foxostro/TurtleTTL/Schematics/Misc/Generated/Renders/ExternalClock_Render.png

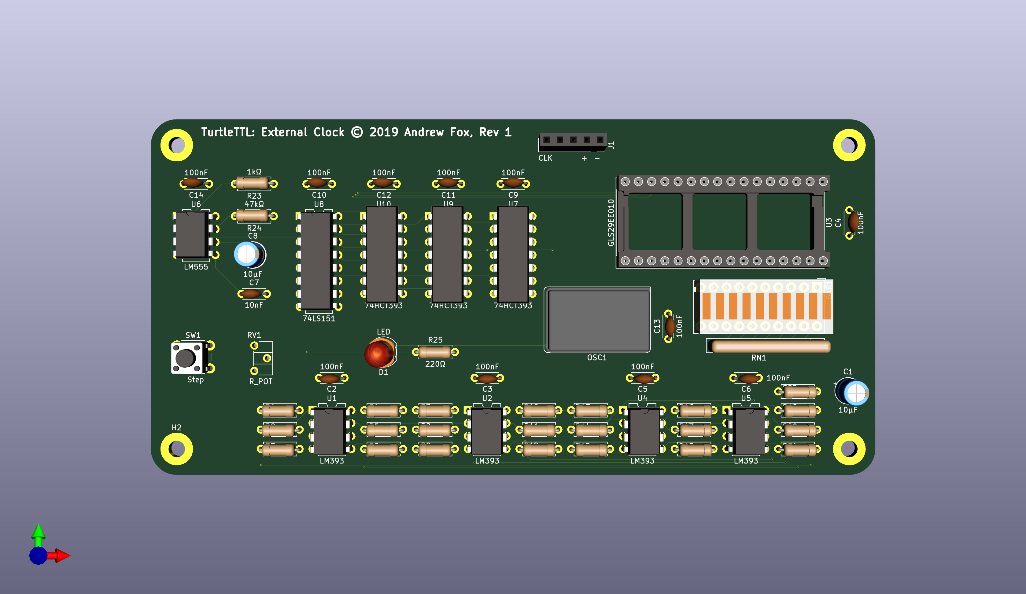
Schematics/Misc/Generated/Renders/ExternalClock_Render.png
