foxostro/TurtleTTL/Schematics/Version2/Generated/Renders/SoundCard_Render.png

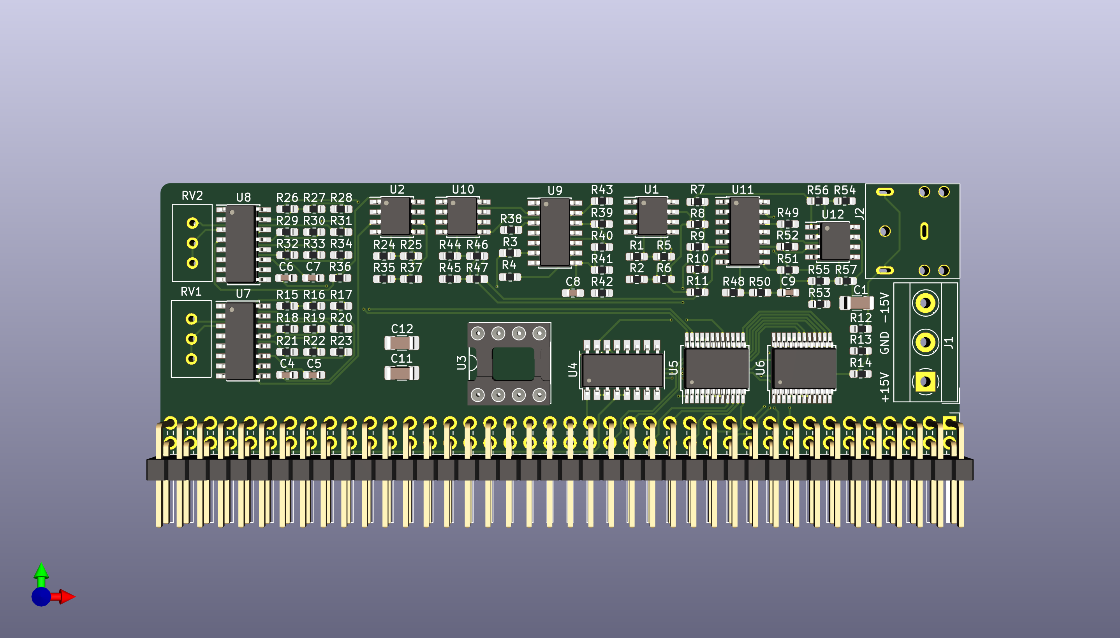
Schematics/Version2/Generated/Renders/SoundCard_Render.png
