foxostro/TurtleTTL/Schematics/Misc/Generated/Renders/LEDRiser8_Render.png

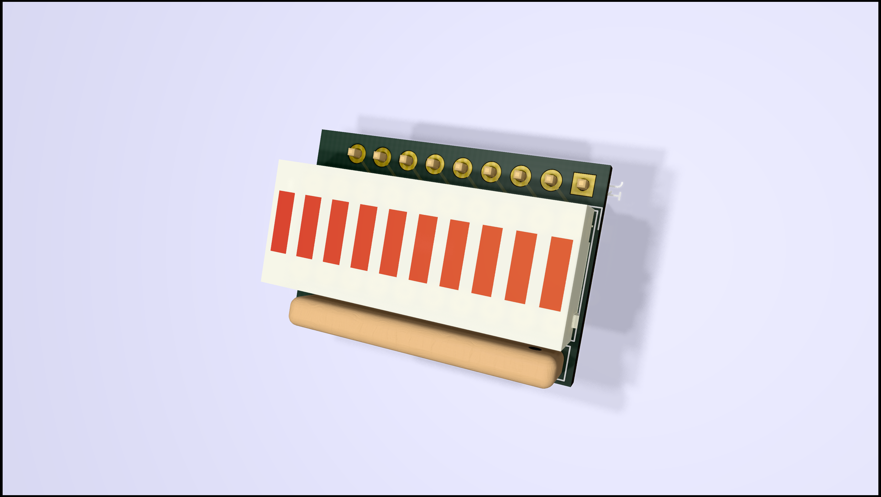
Schematics/Misc/Generated/Renders/LEDRiser8_Render.png
