foxostro/TurtleTTL/Schematics/Misc/Generated/Renders/LEDRiser16_Render.png

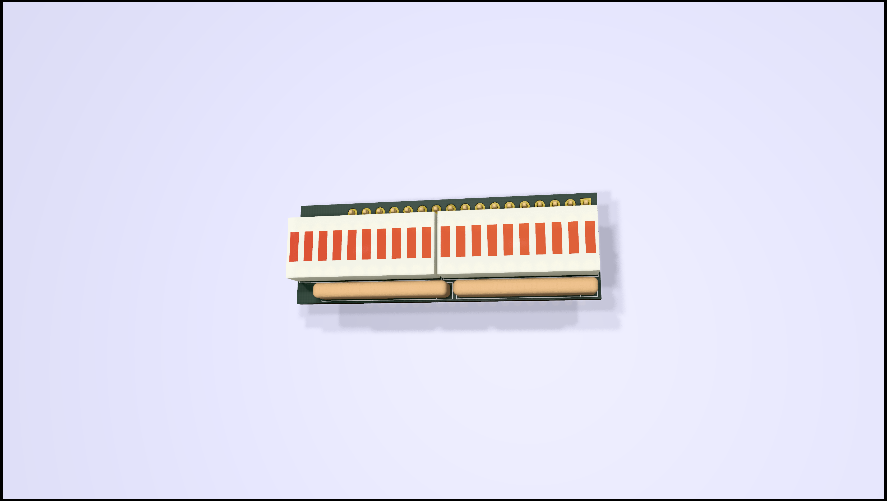
Schematics/Misc/Generated/Renders/LEDRiser16_Render.png
