foxostro/TurtleTTL/Schematics/Misc/KiCAD Design Rules/KiCAD Main Board PCB Design Rules 1.png

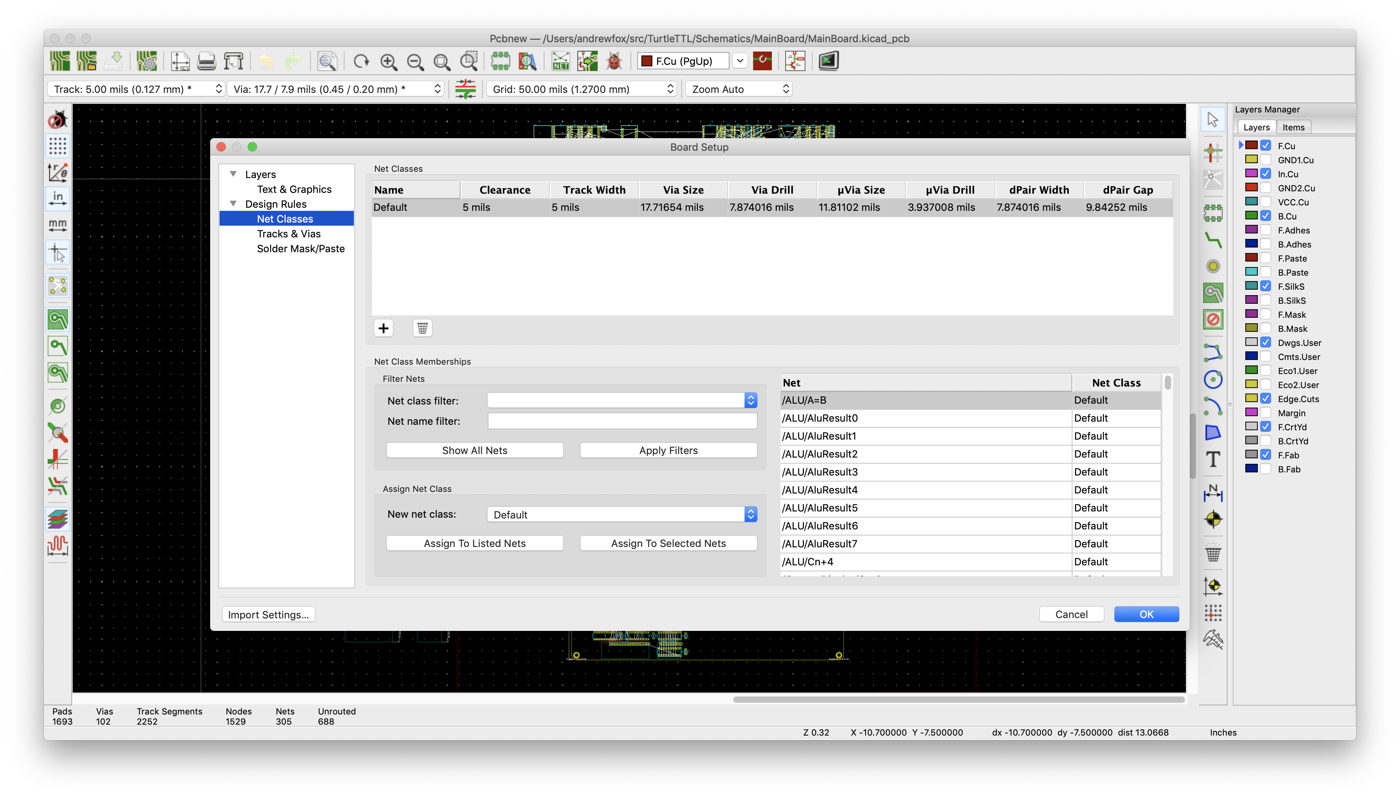
Schematics/Misc/KiCAD Design Rules/KiCAD Main Board PCB Design Rules 1.png
