foxostro/TurtleTTL/Schematics/Version2/Generated/Renders/MainBoard_Render.png

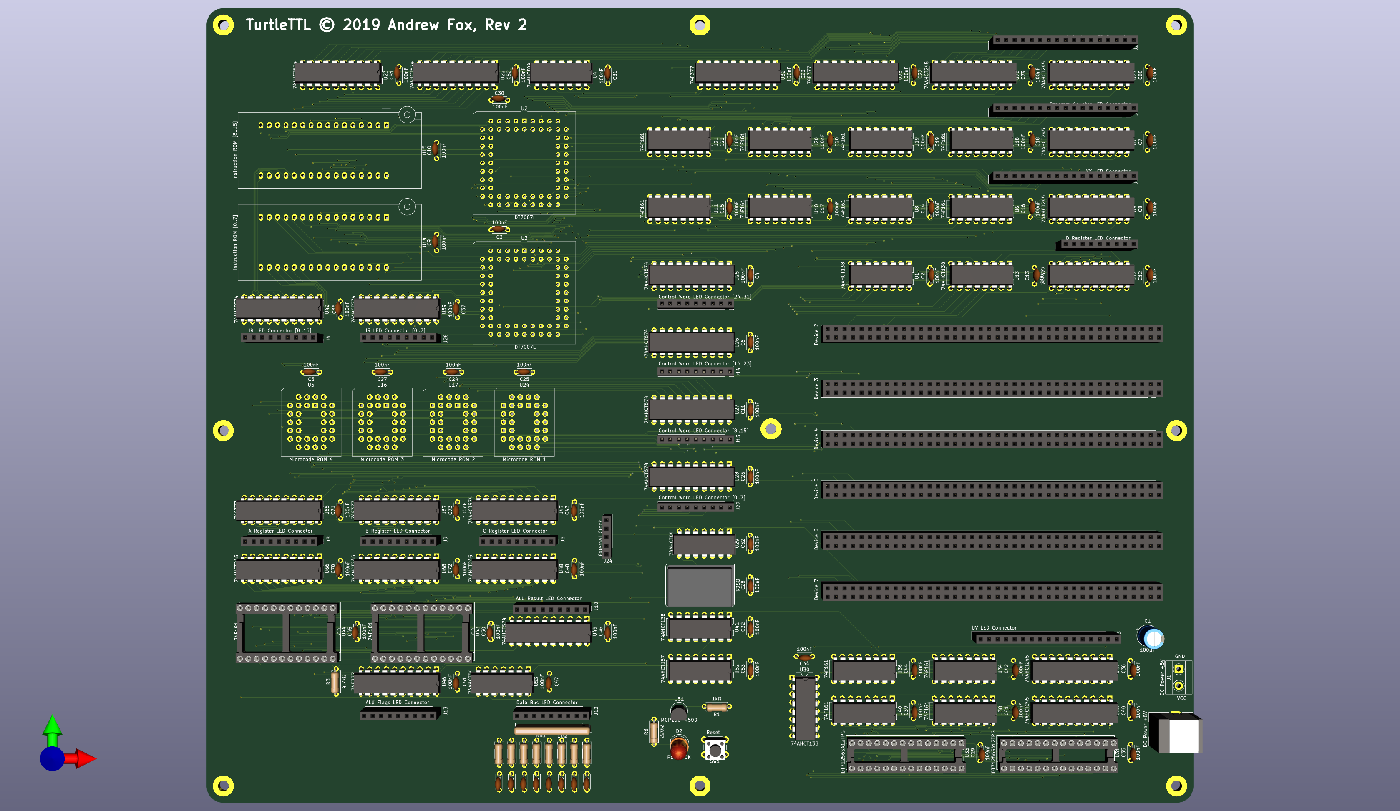
Schematics/Version2/Generated/Renders/MainBoard_Render.png
