foxostro/TurtleTTL/Schematics/Version2/Generated/Renders/SerialCard_Render.png

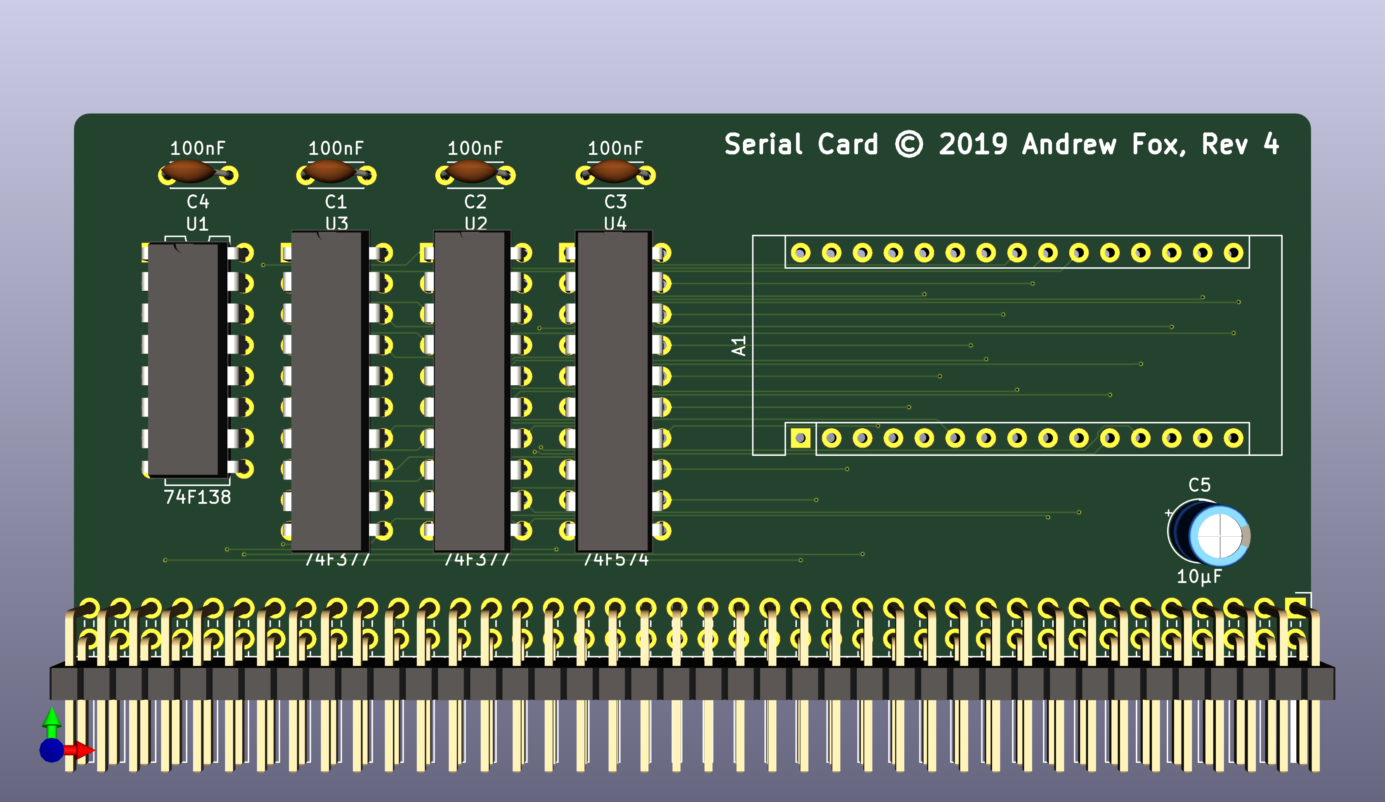
Schematics/Version2/Generated/Renders/SerialCard_Render.png
