foxostro/TurtleTTL/Schematics/Version2/Generated/BOM/ArduinoSerialCard.csv

Reference | Value | Footprint | Datasheet
A1 | Arduino_Nano_v3.x | Module:Arduino_Nano | http://www.mouser.com/pdfdocs/Gravitech_Arduino_Nano3_0.pdf
J1 | Device 2 | Connector_PinHeader_2.54mm:PinHeader_2x20_P2.54mm_Horizontal | ~
