foxostro/TurtleTTL/Schematics/Version2/Generated/PCB PDFs/SoundCard_PCB.pdf

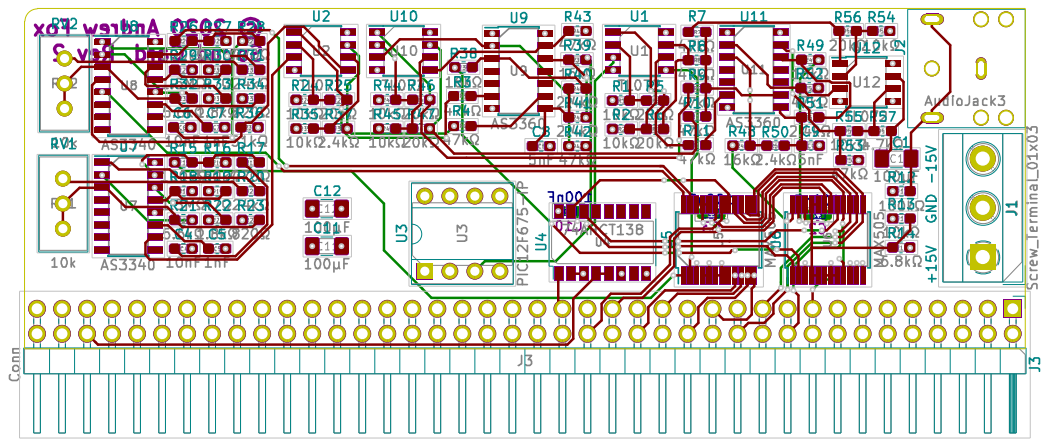
[picture p9: page 1]
