foxostro/TurtleTTL/Schematics/Version2/Generated/PCB PDFs/MainBoard_PCB.pdf

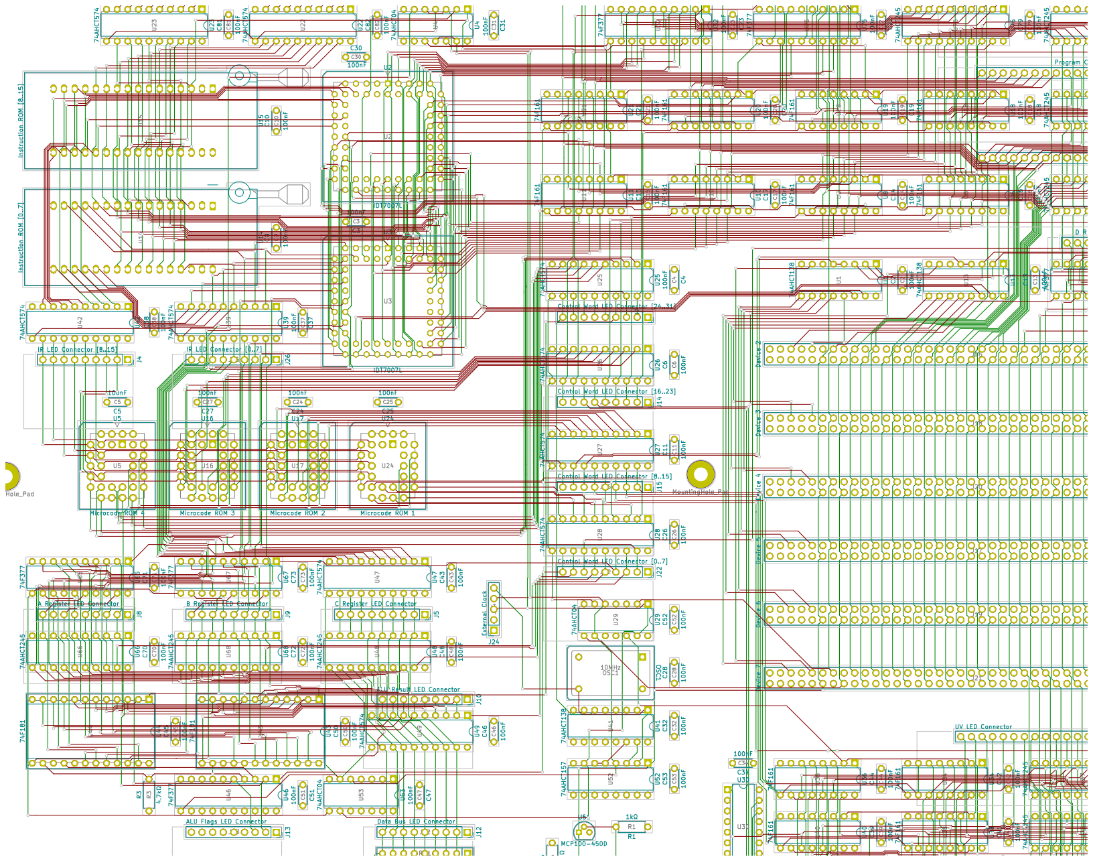
[picture p17: page 1]
