foxostro/TurtleTTL/Schematics/Version2/Generated/PCB PDFs/SerialCard_PCB.pdf

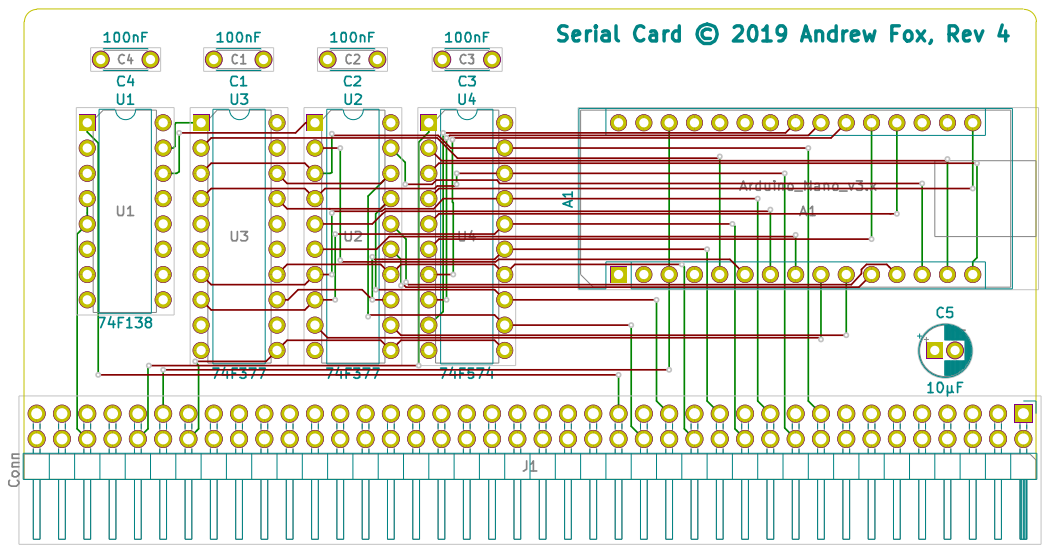
[picture p18: page 1]
