foxostro/TurtleTTL/Schematics/Version2/Generated/Schematic PDFs/MainBoard_Schematics.pdf

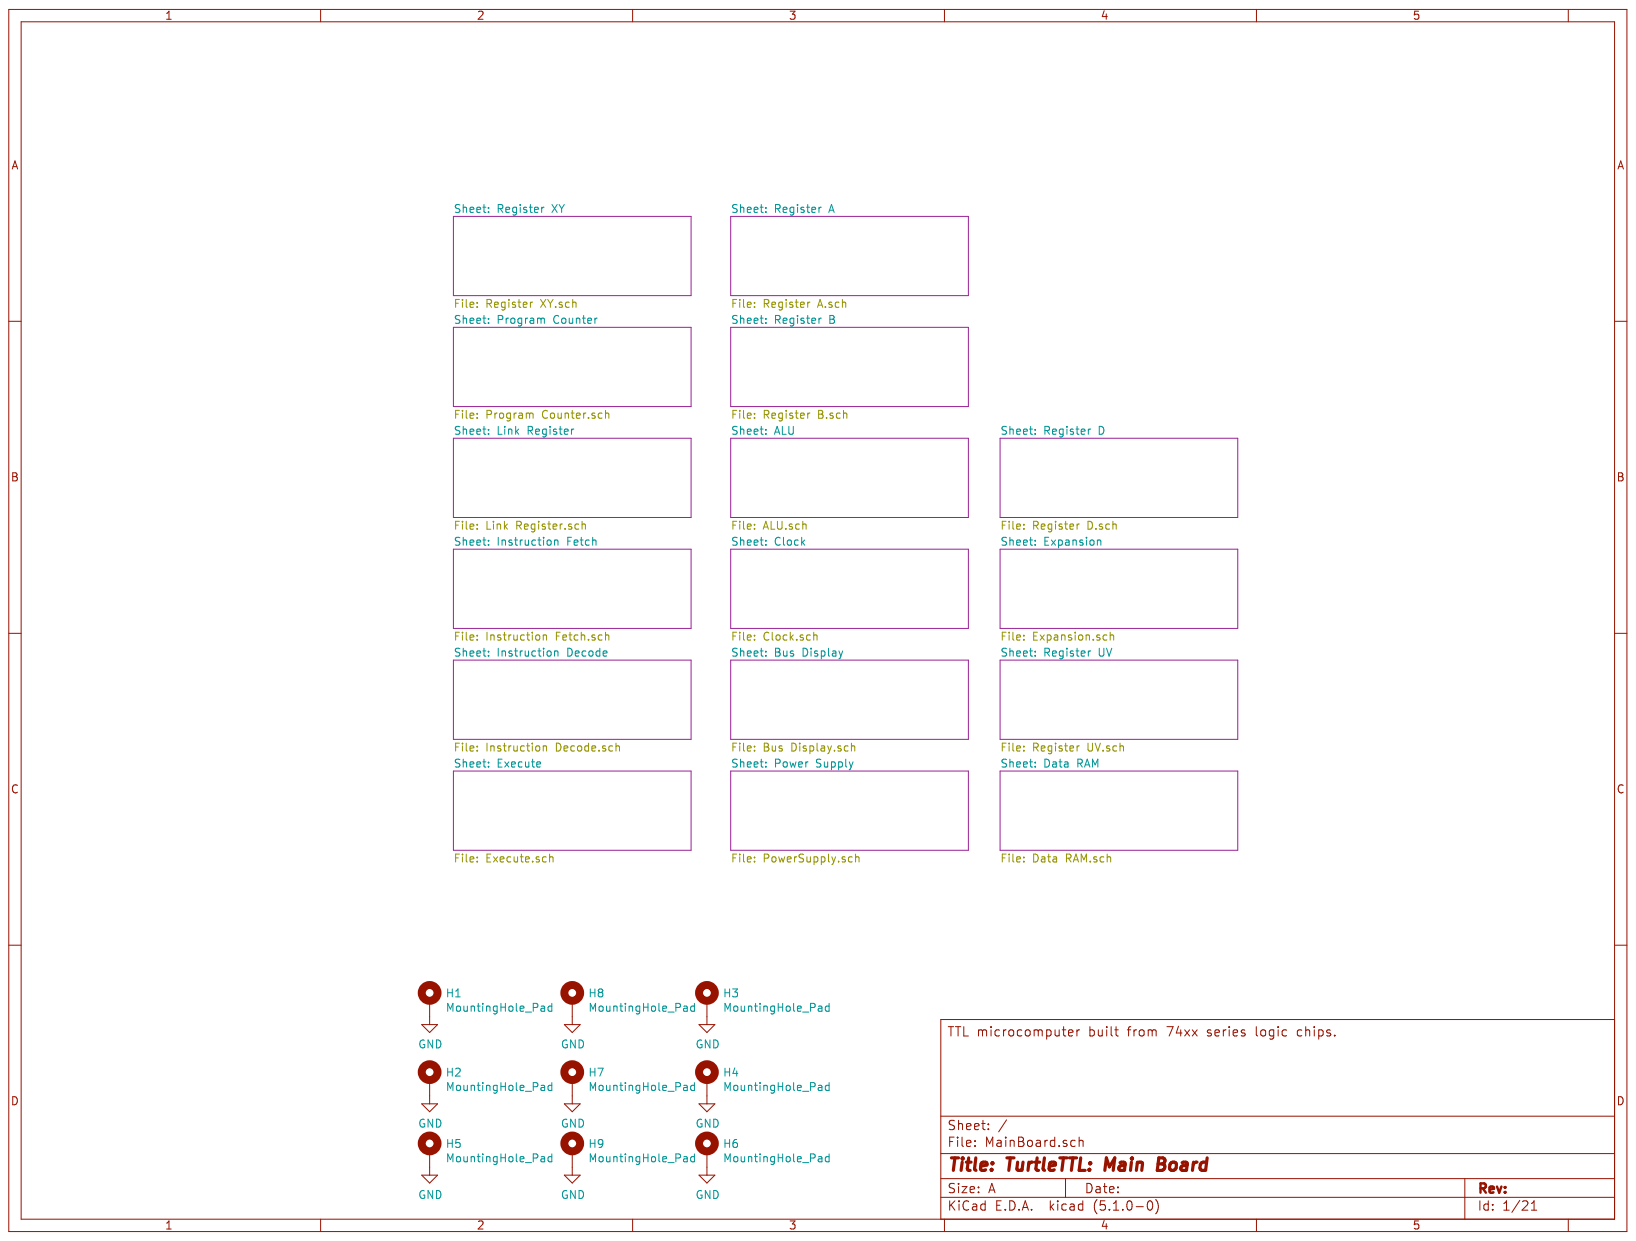
[picture p19: page 1]

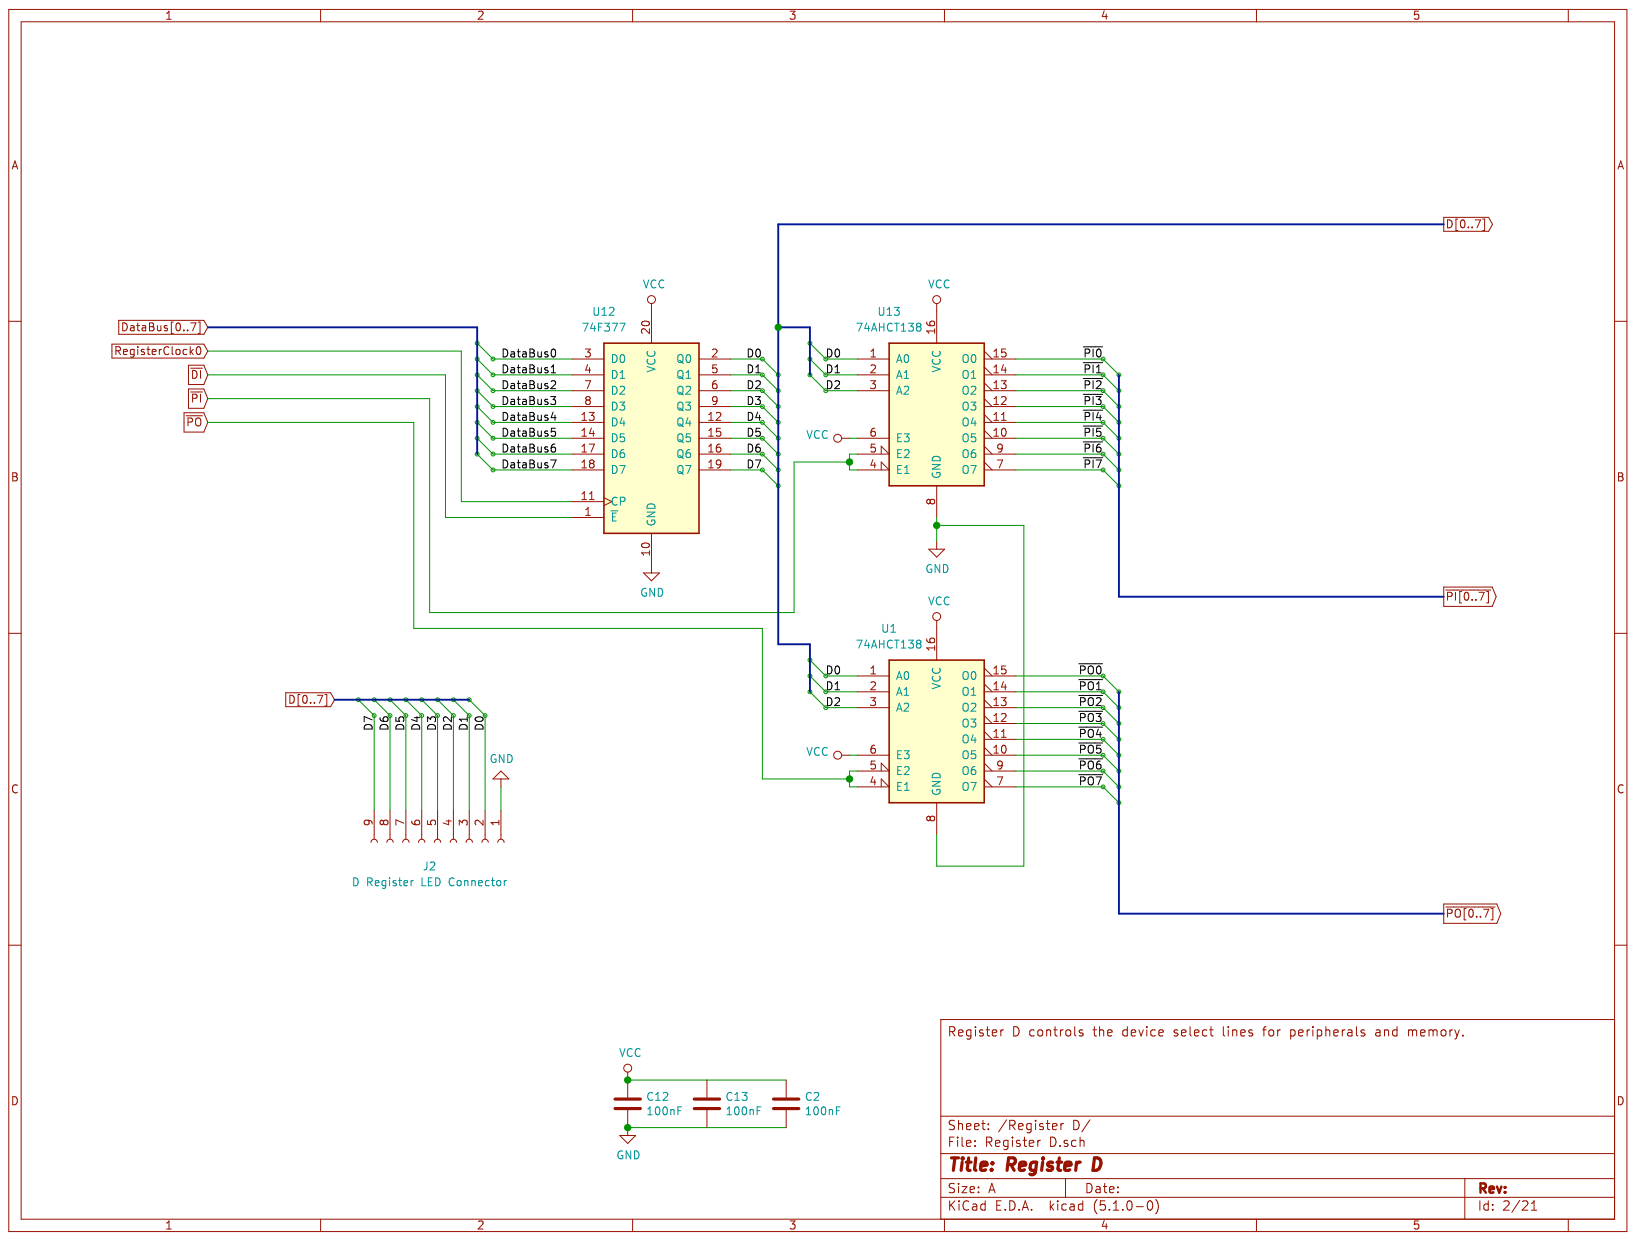
[picture p20: page 2]

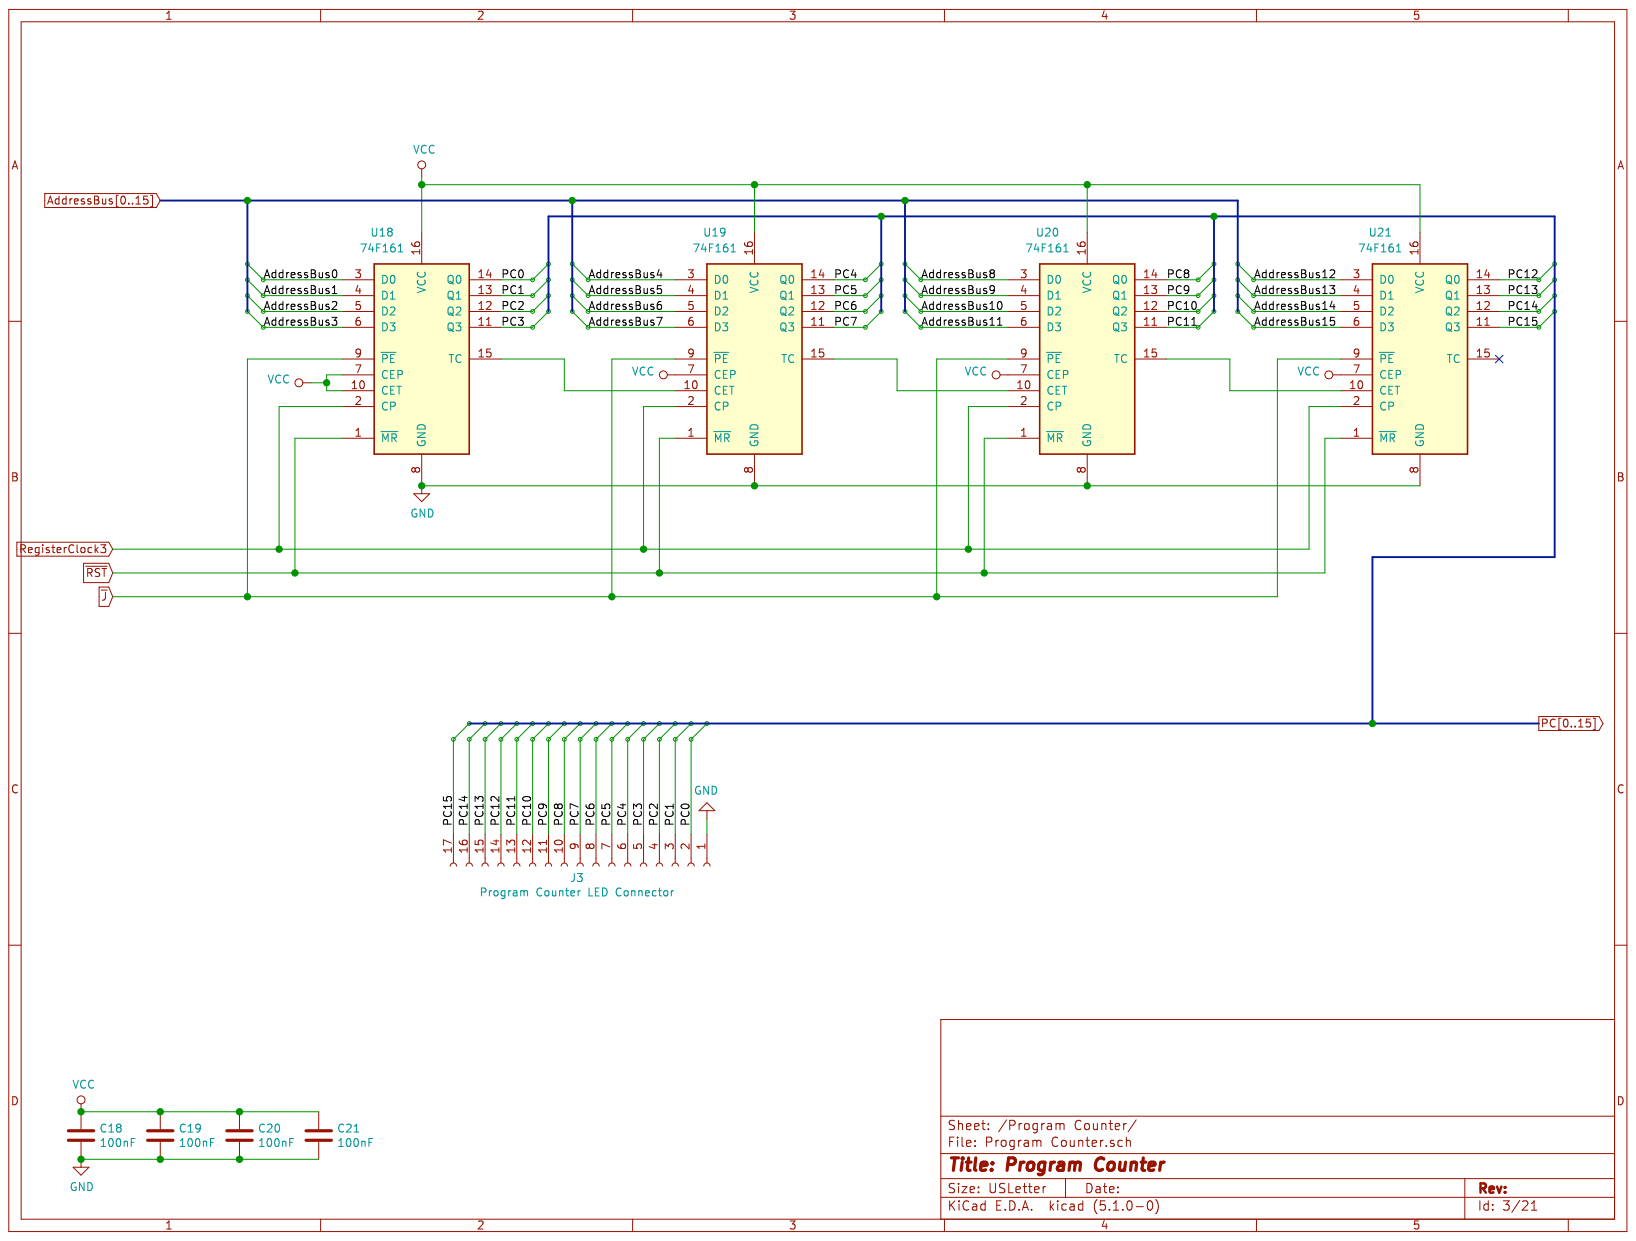
[picture p21: page 3]

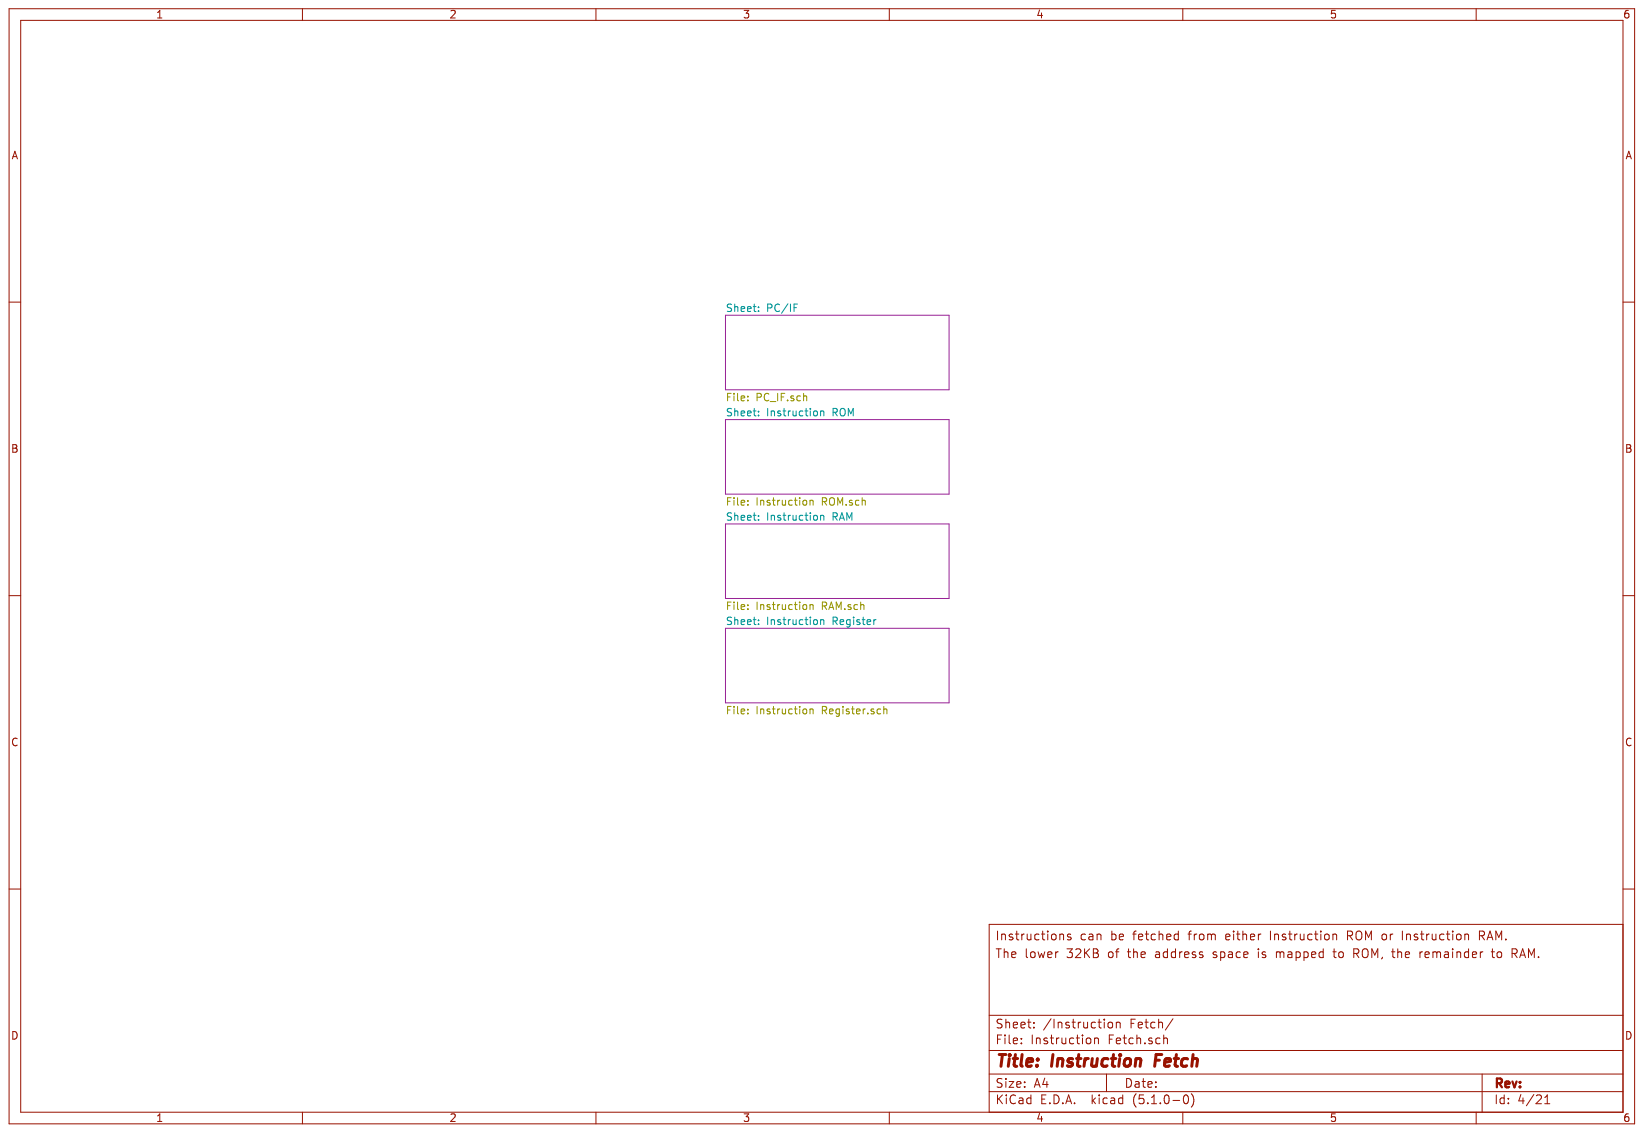
[picture p22: page 4]

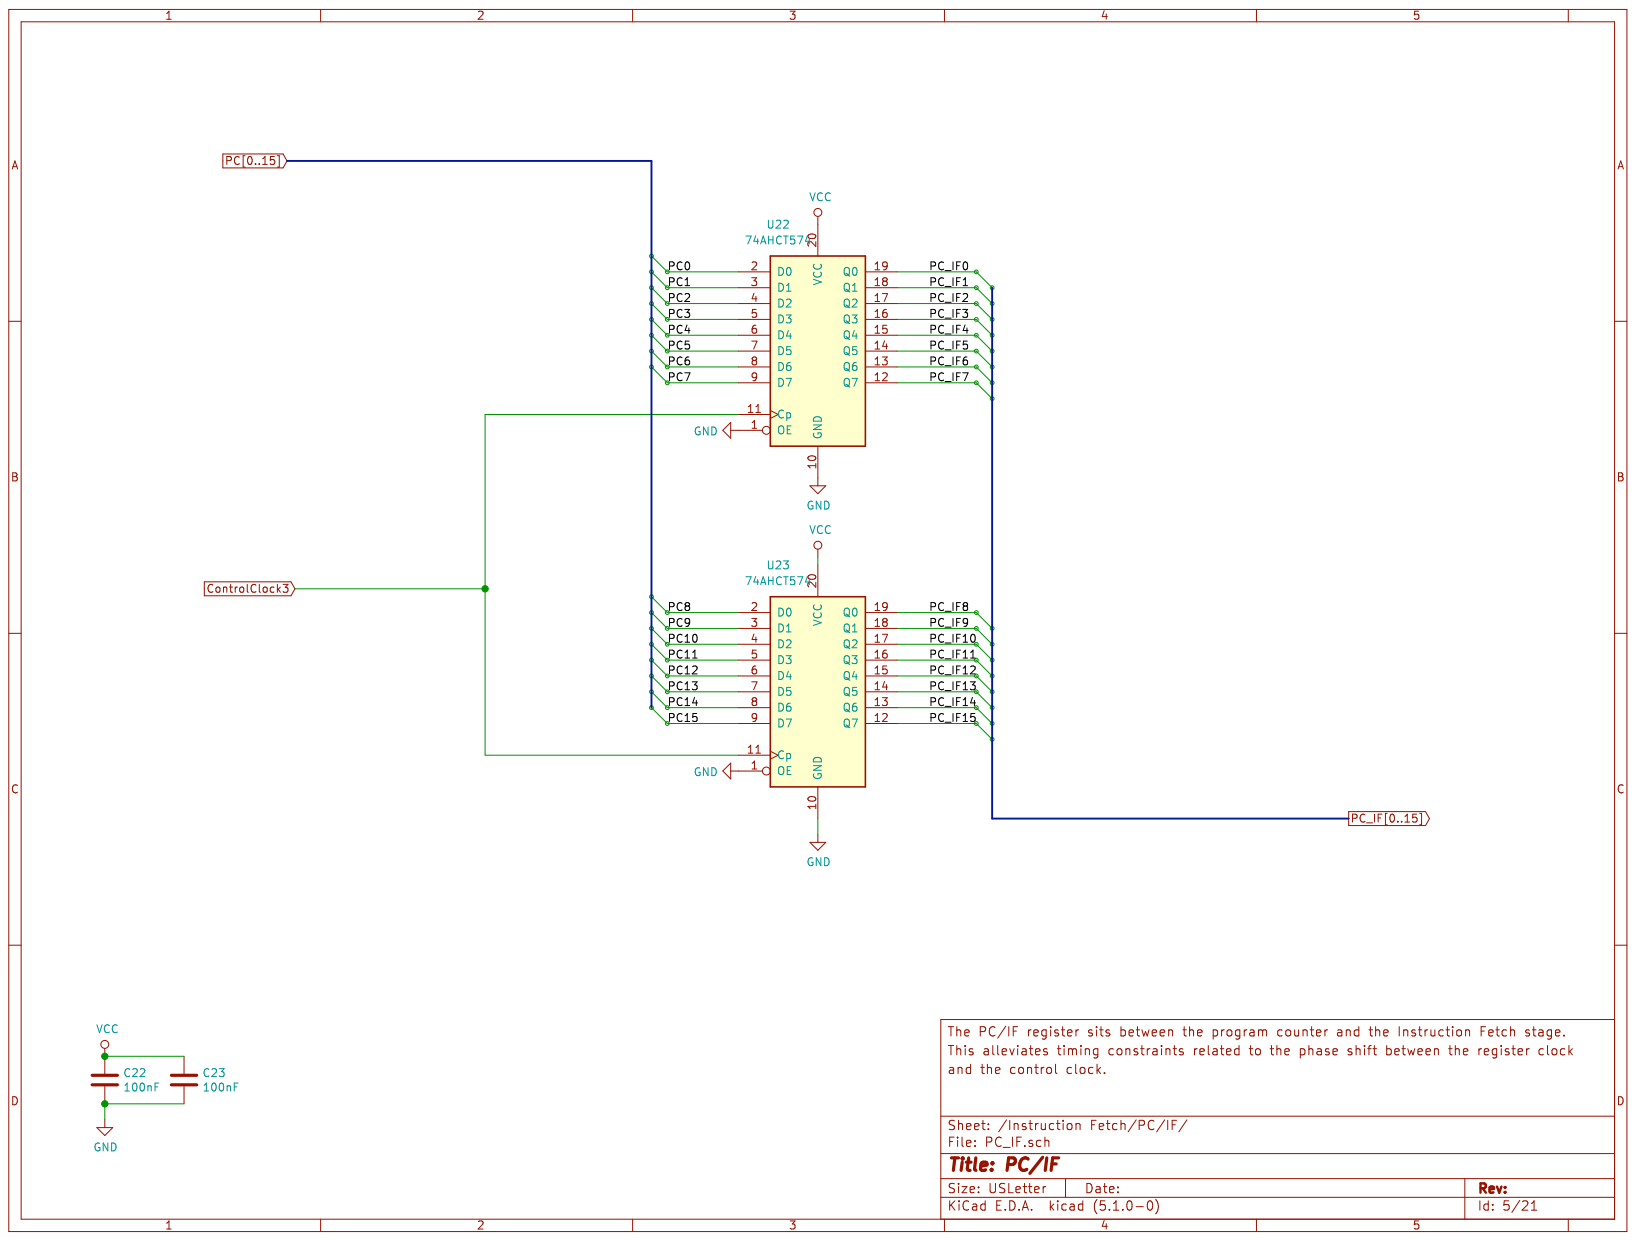
[picture p23: page 5]

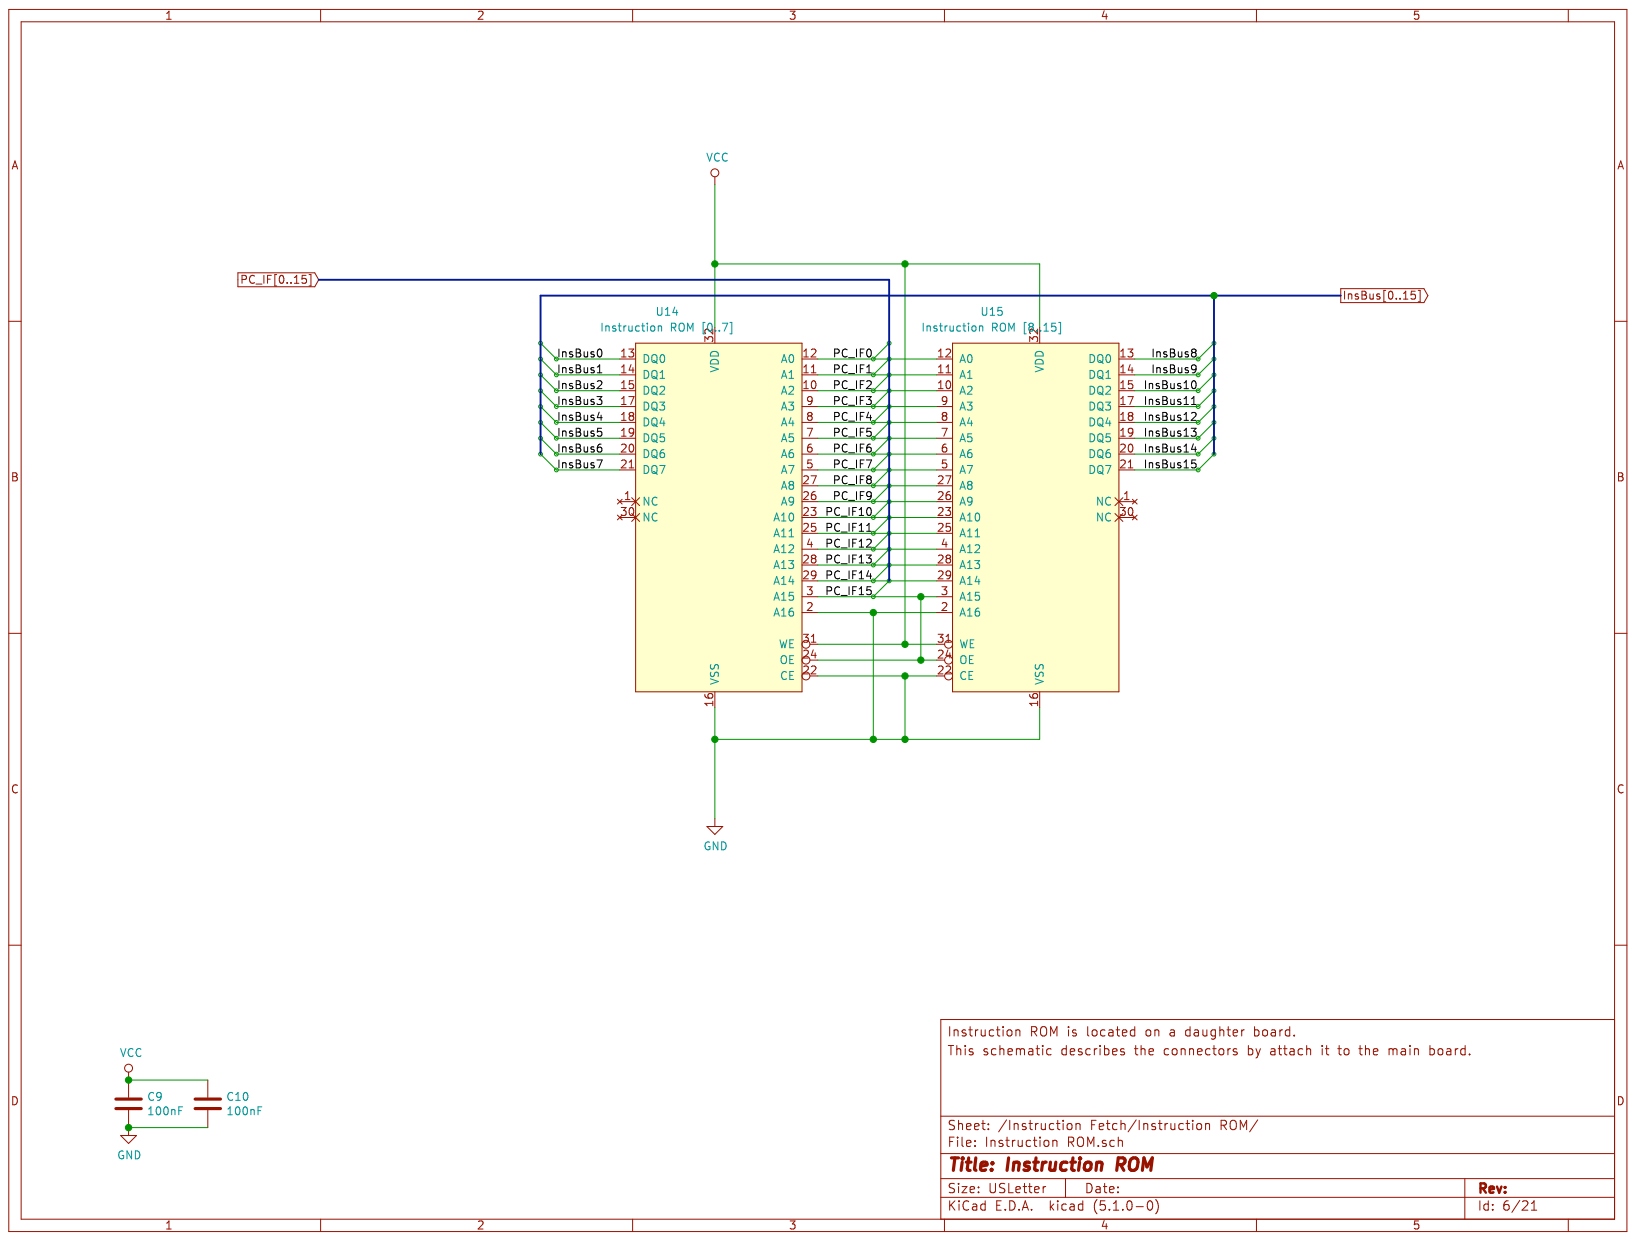
[picture p24: page 6]

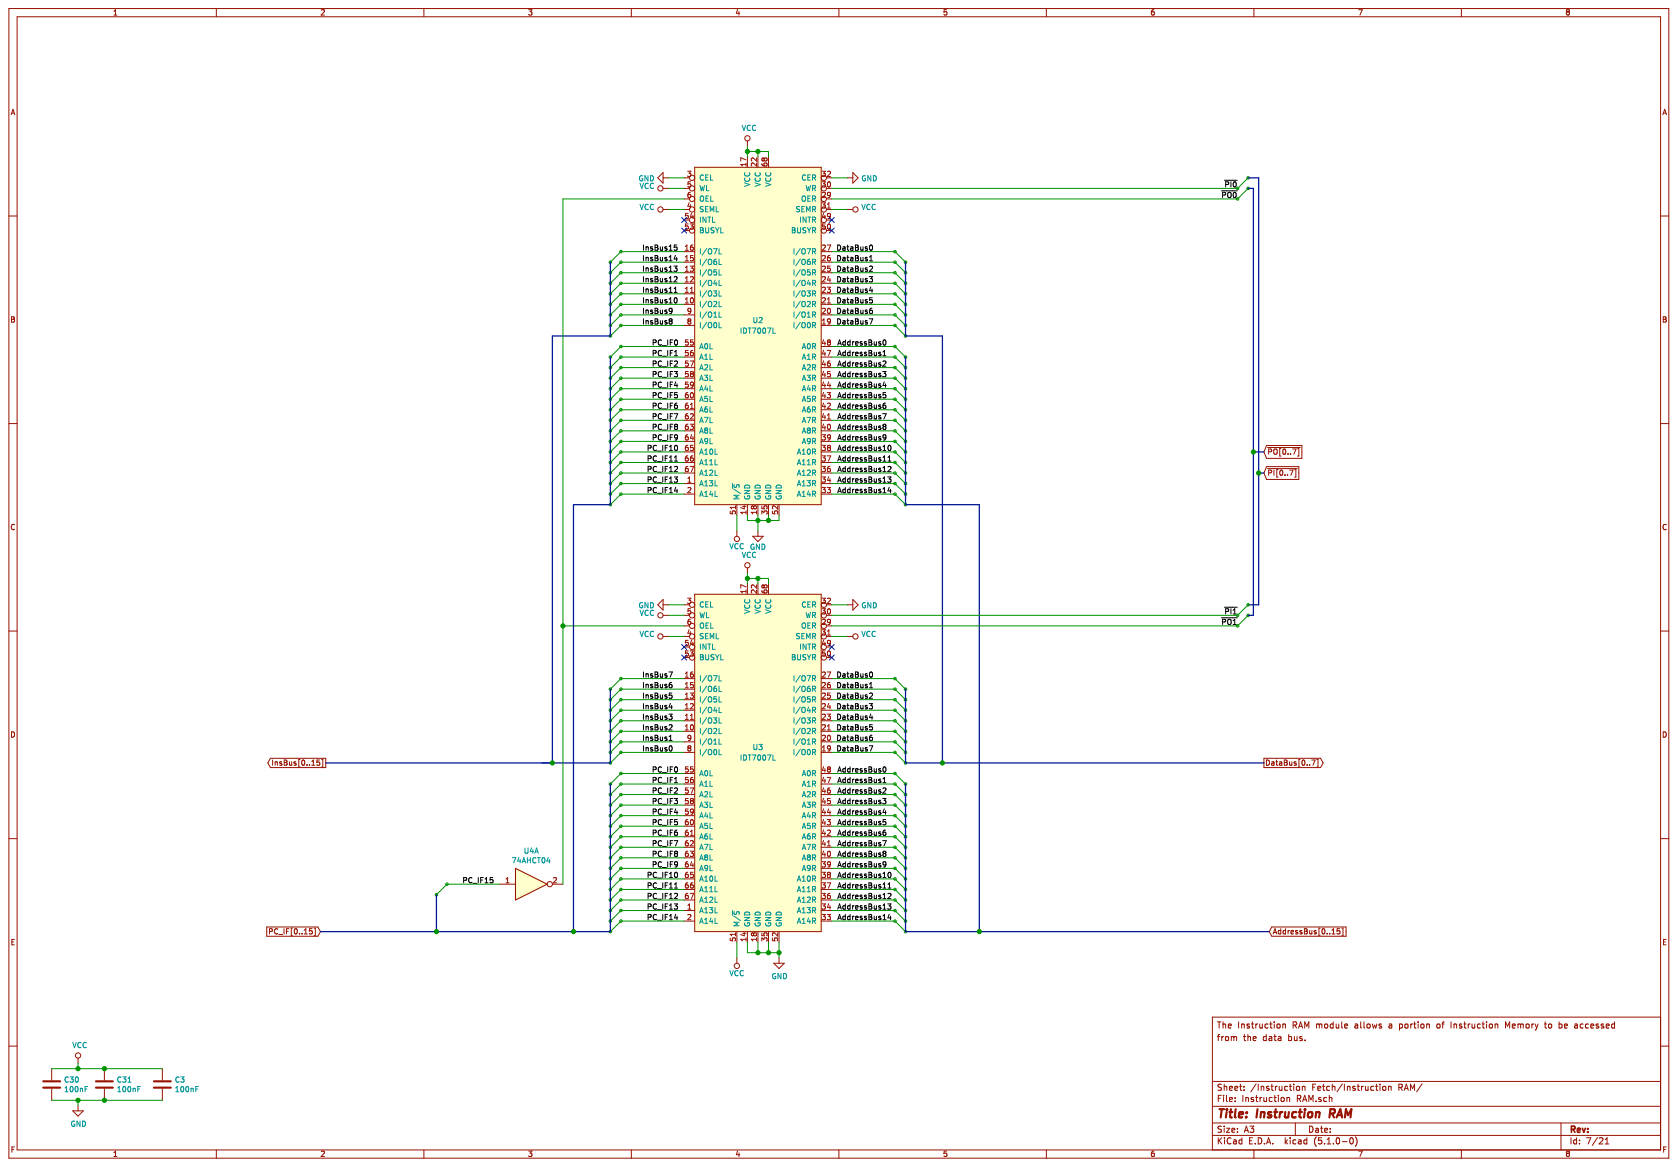
[picture p25: page 7]

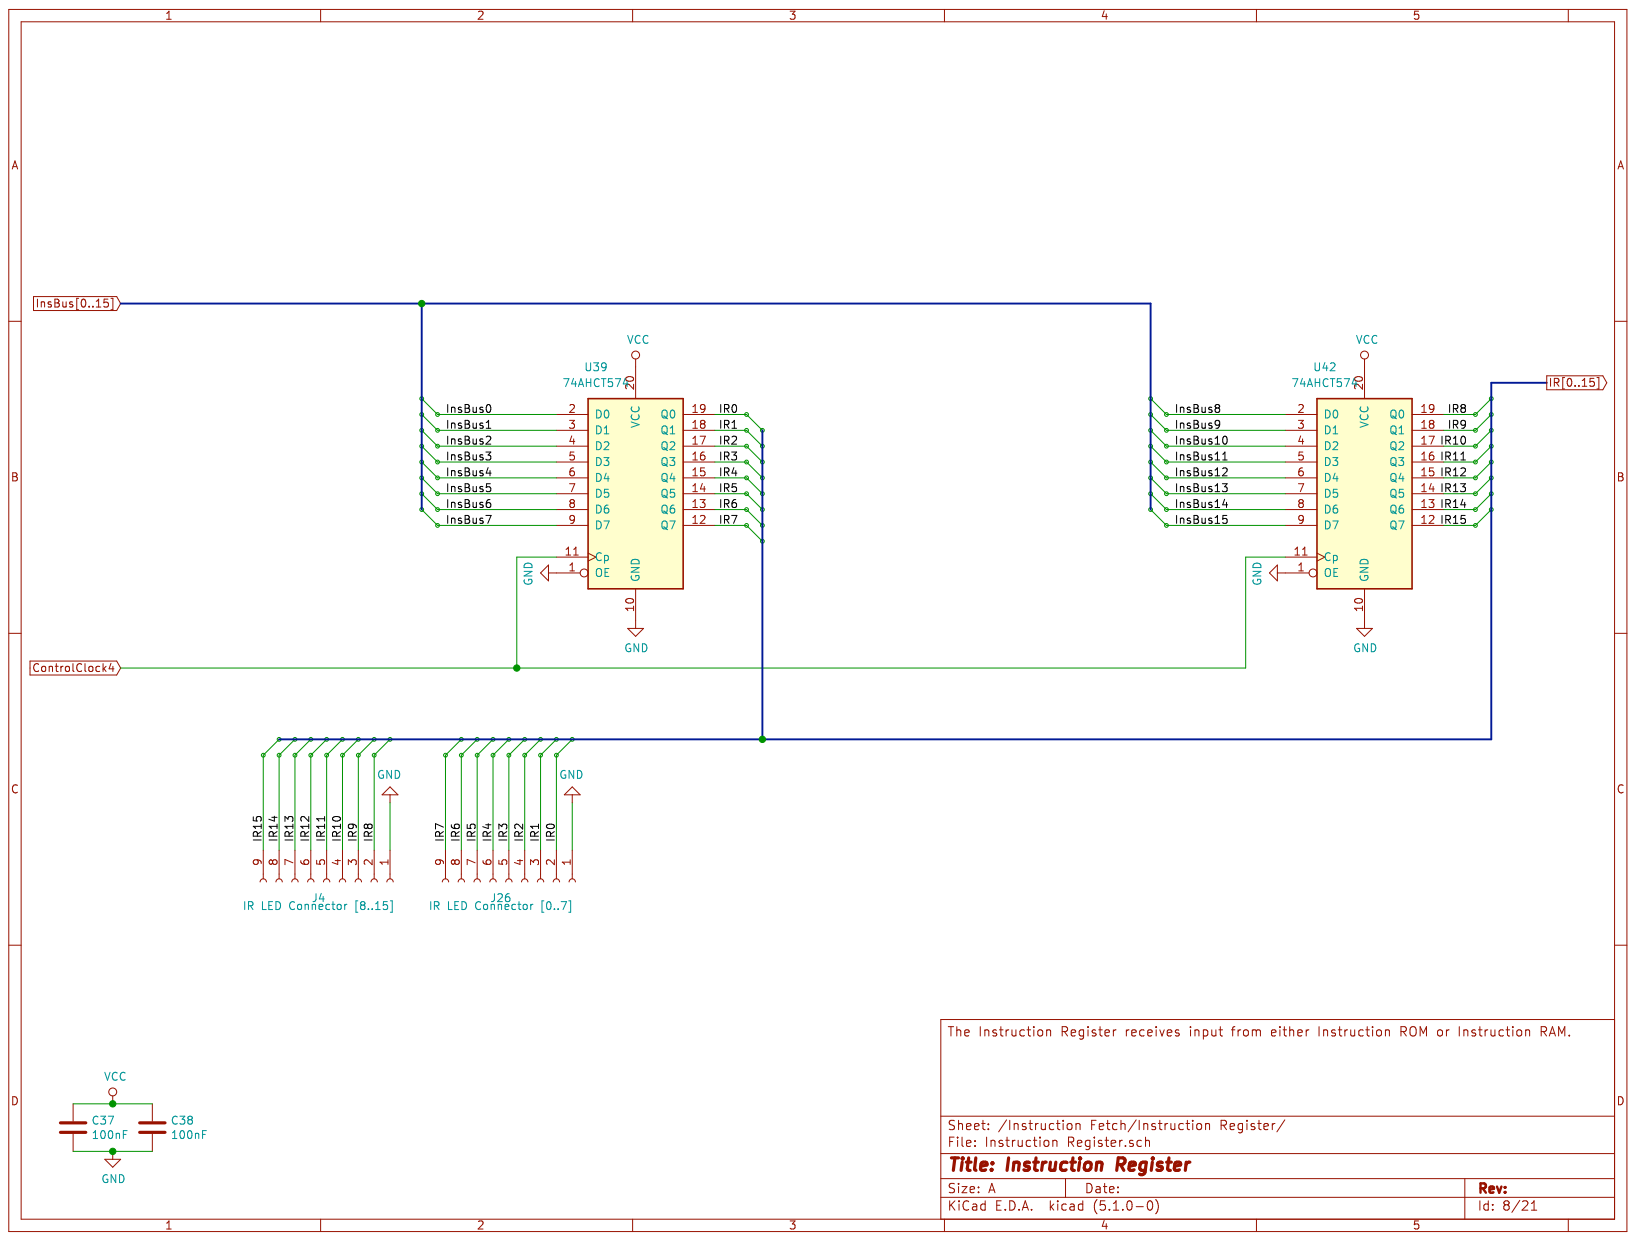
[picture p26: page 8]

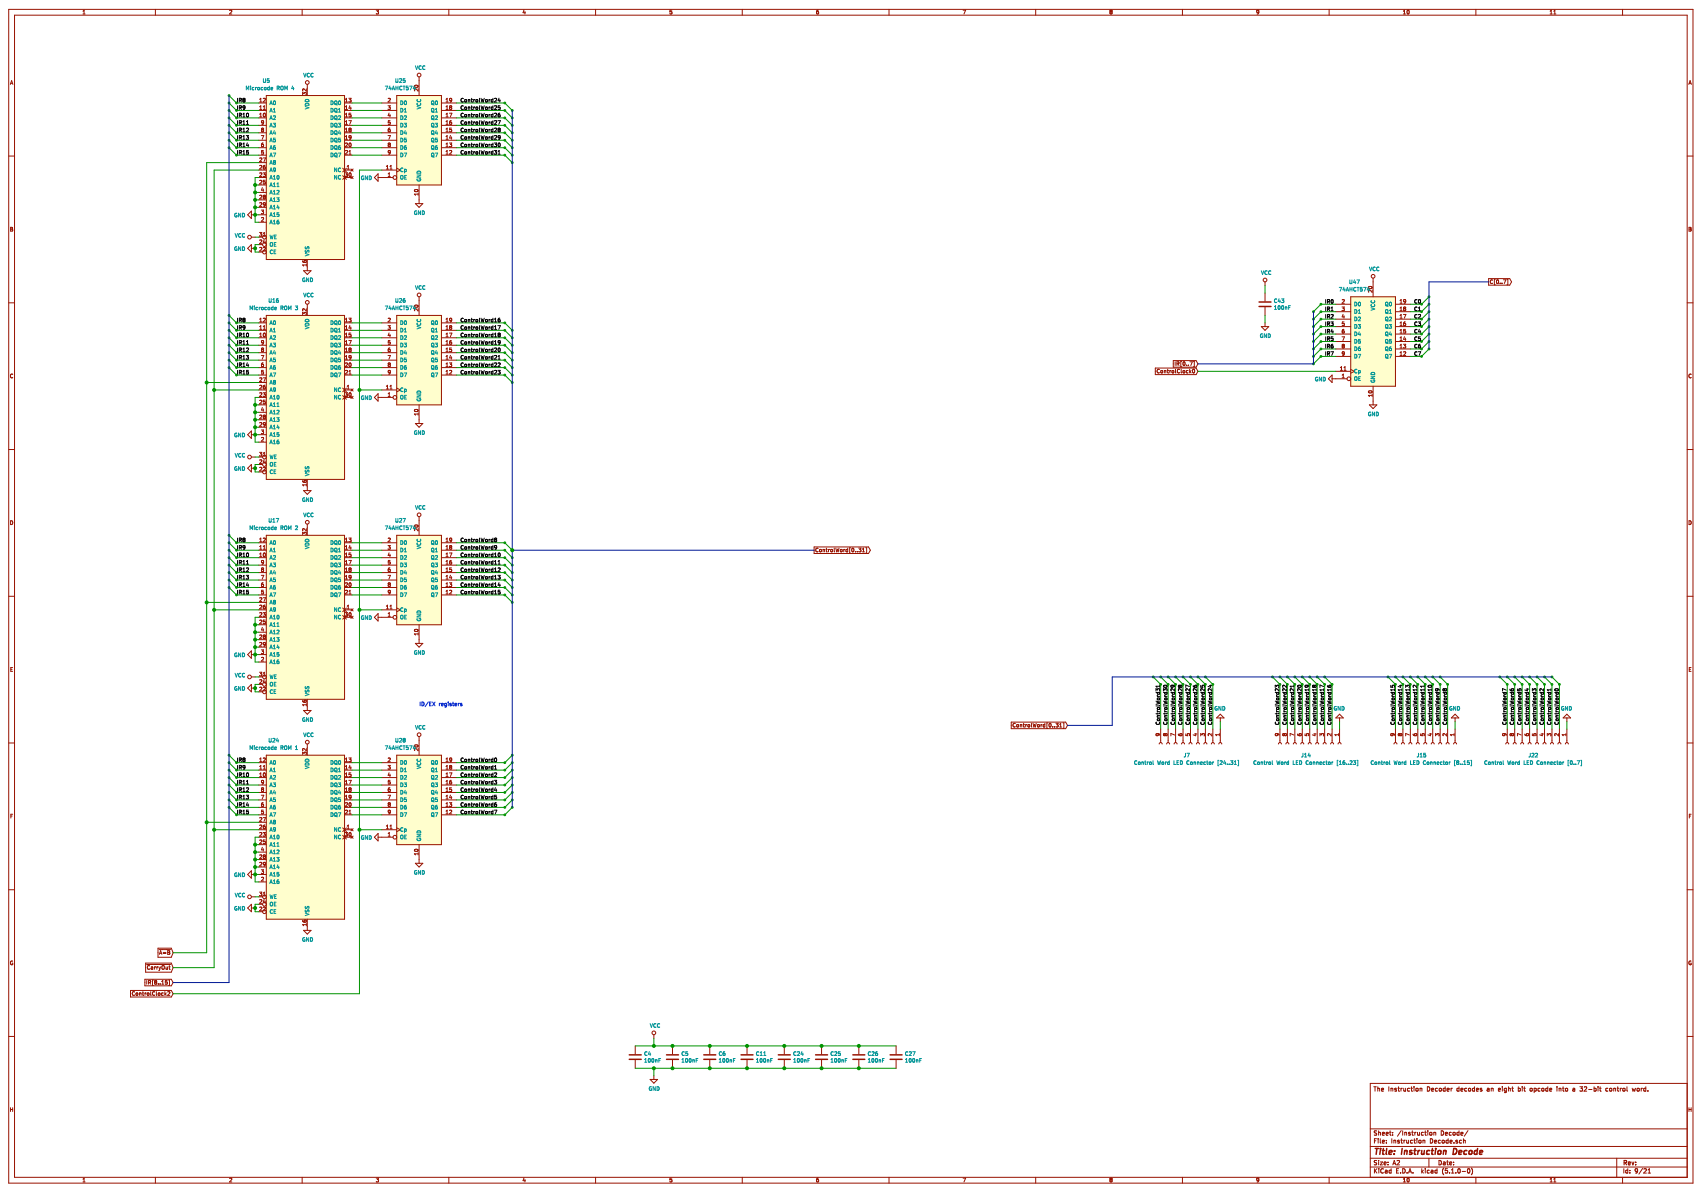
[picture p27: page 9]

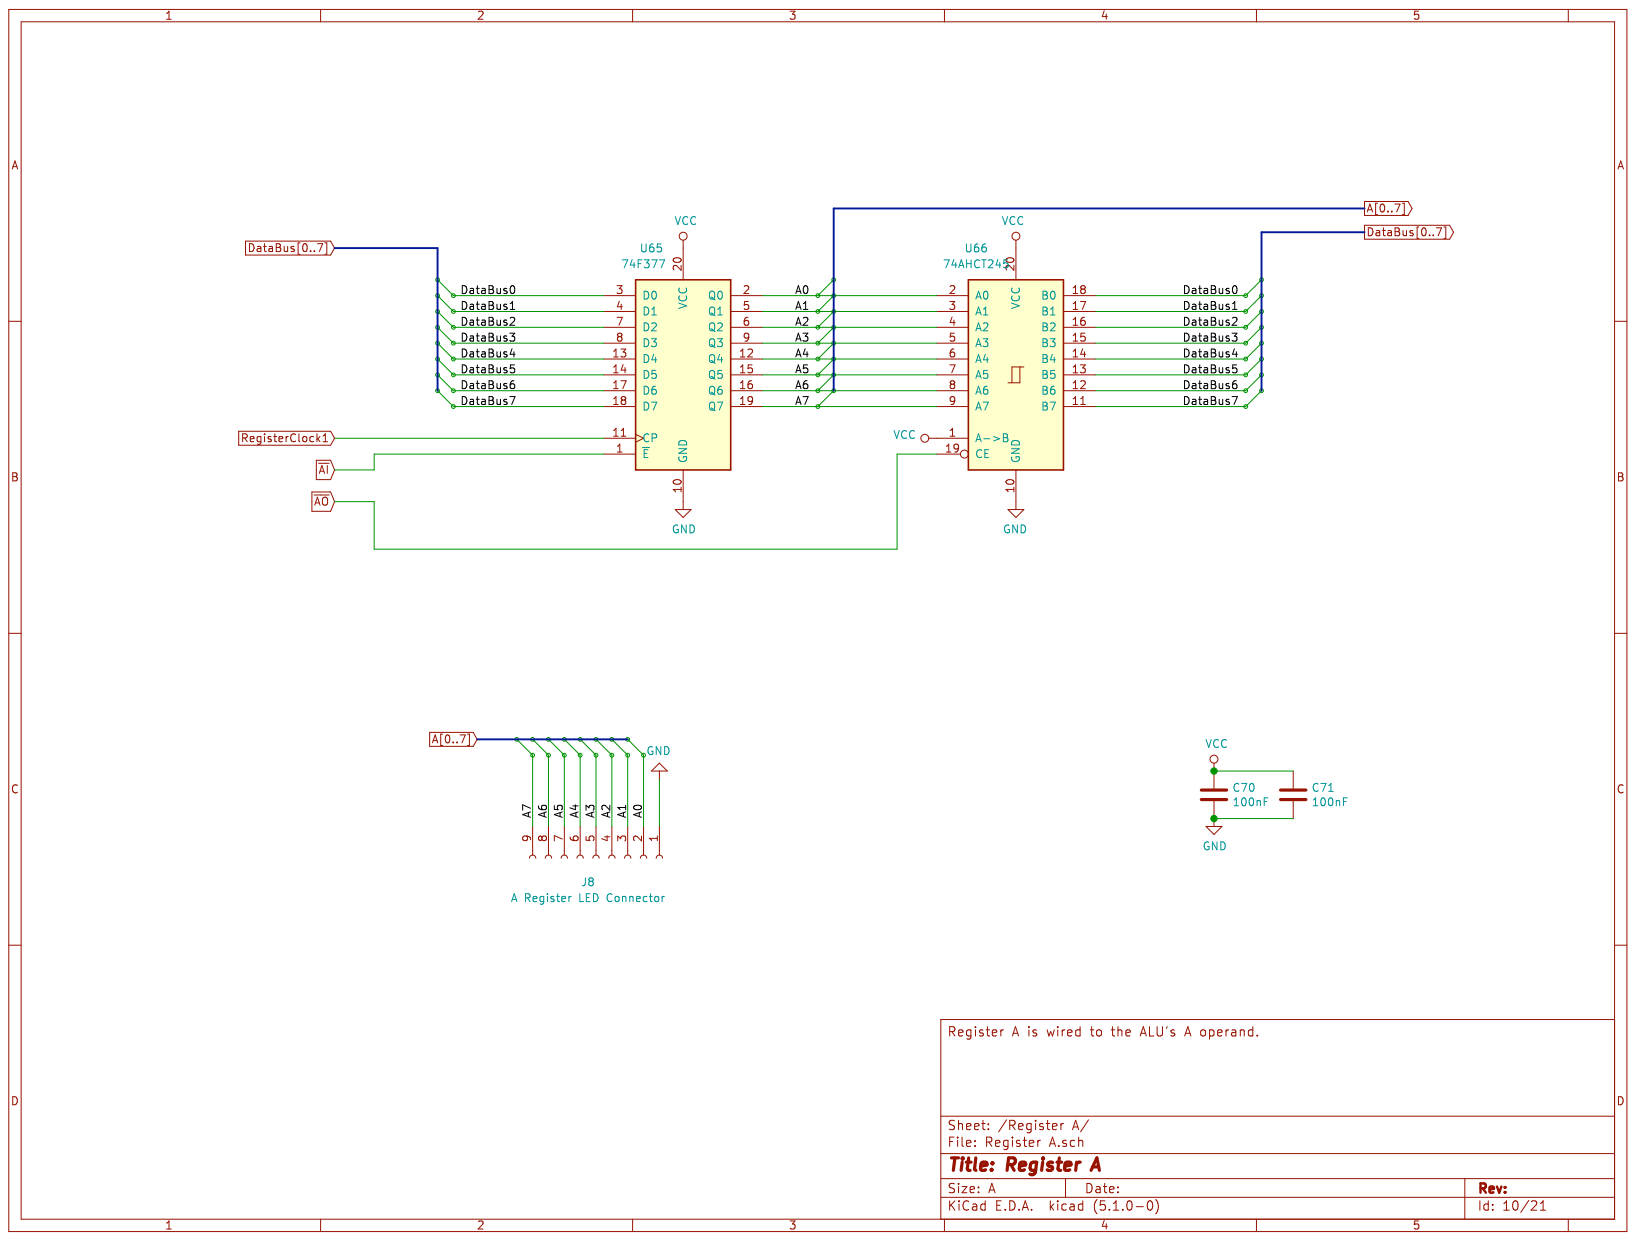
[picture p28: page 10]

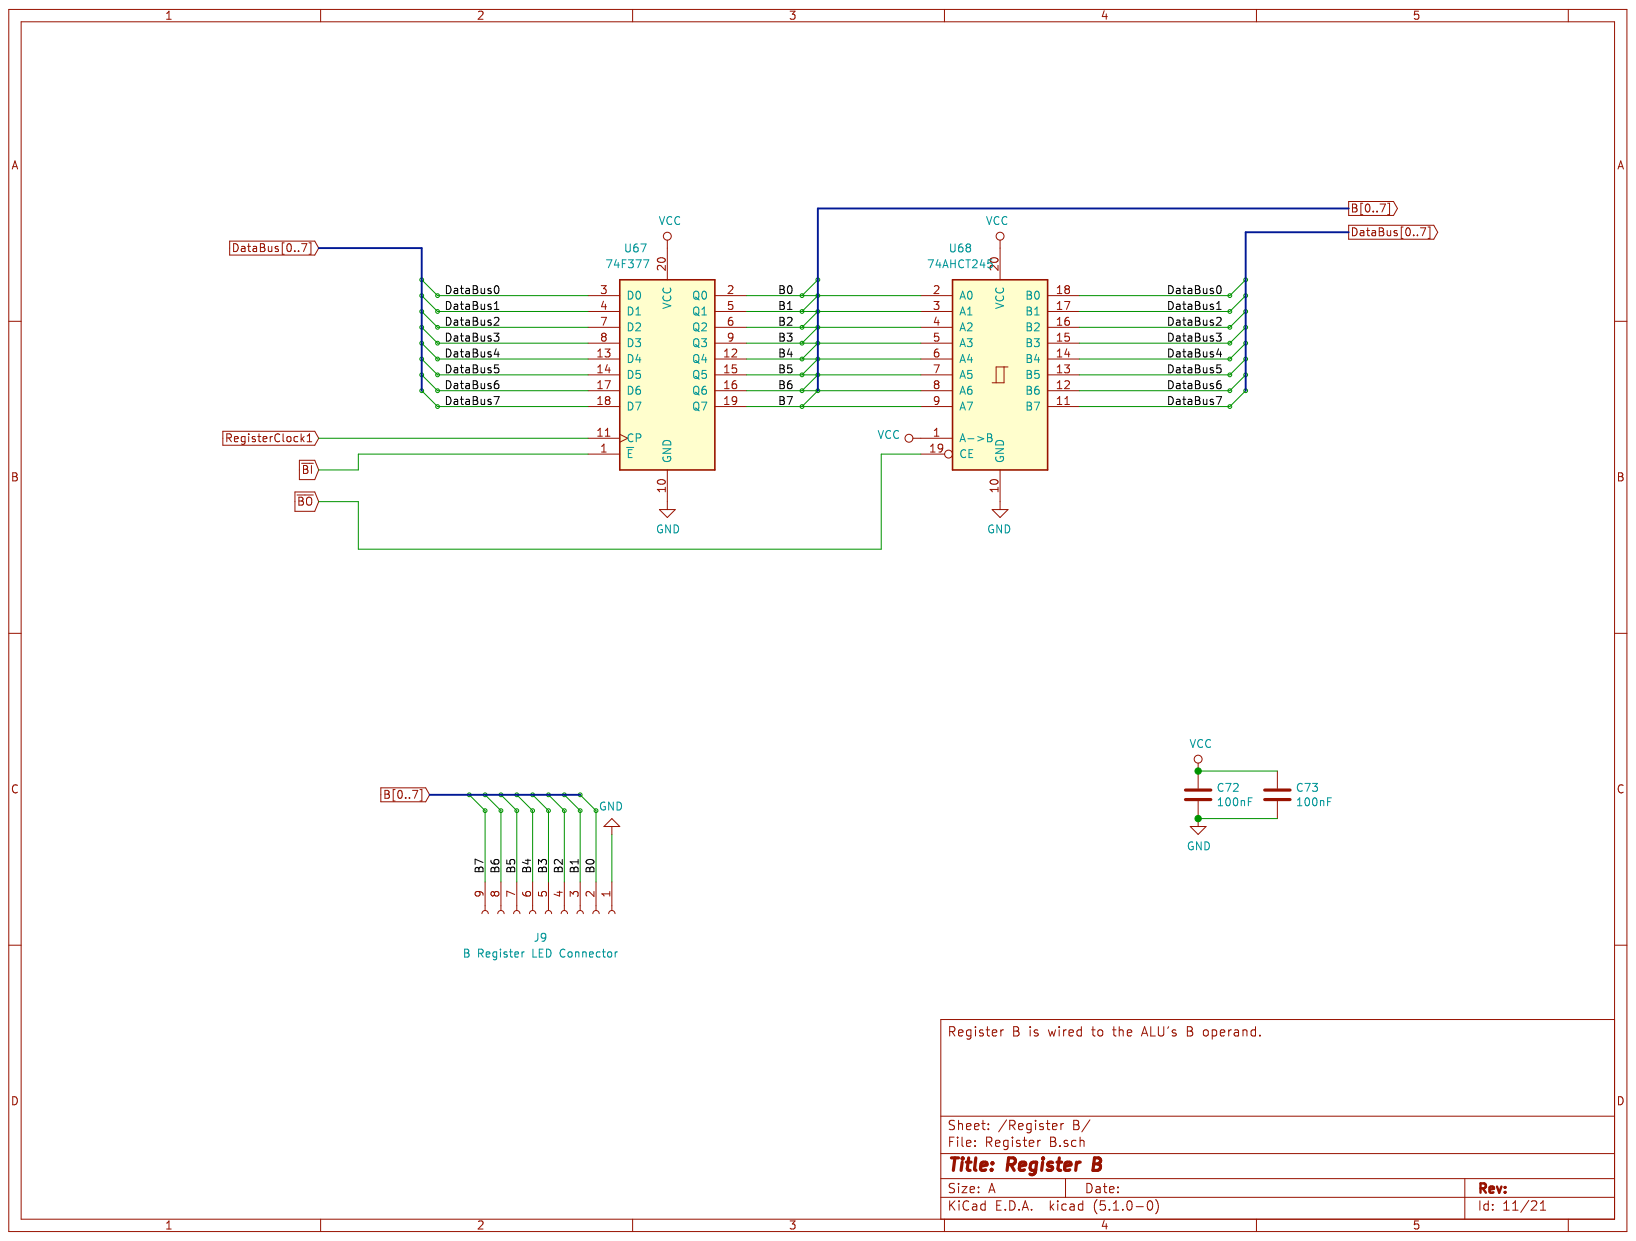
[picture p29: page 11]

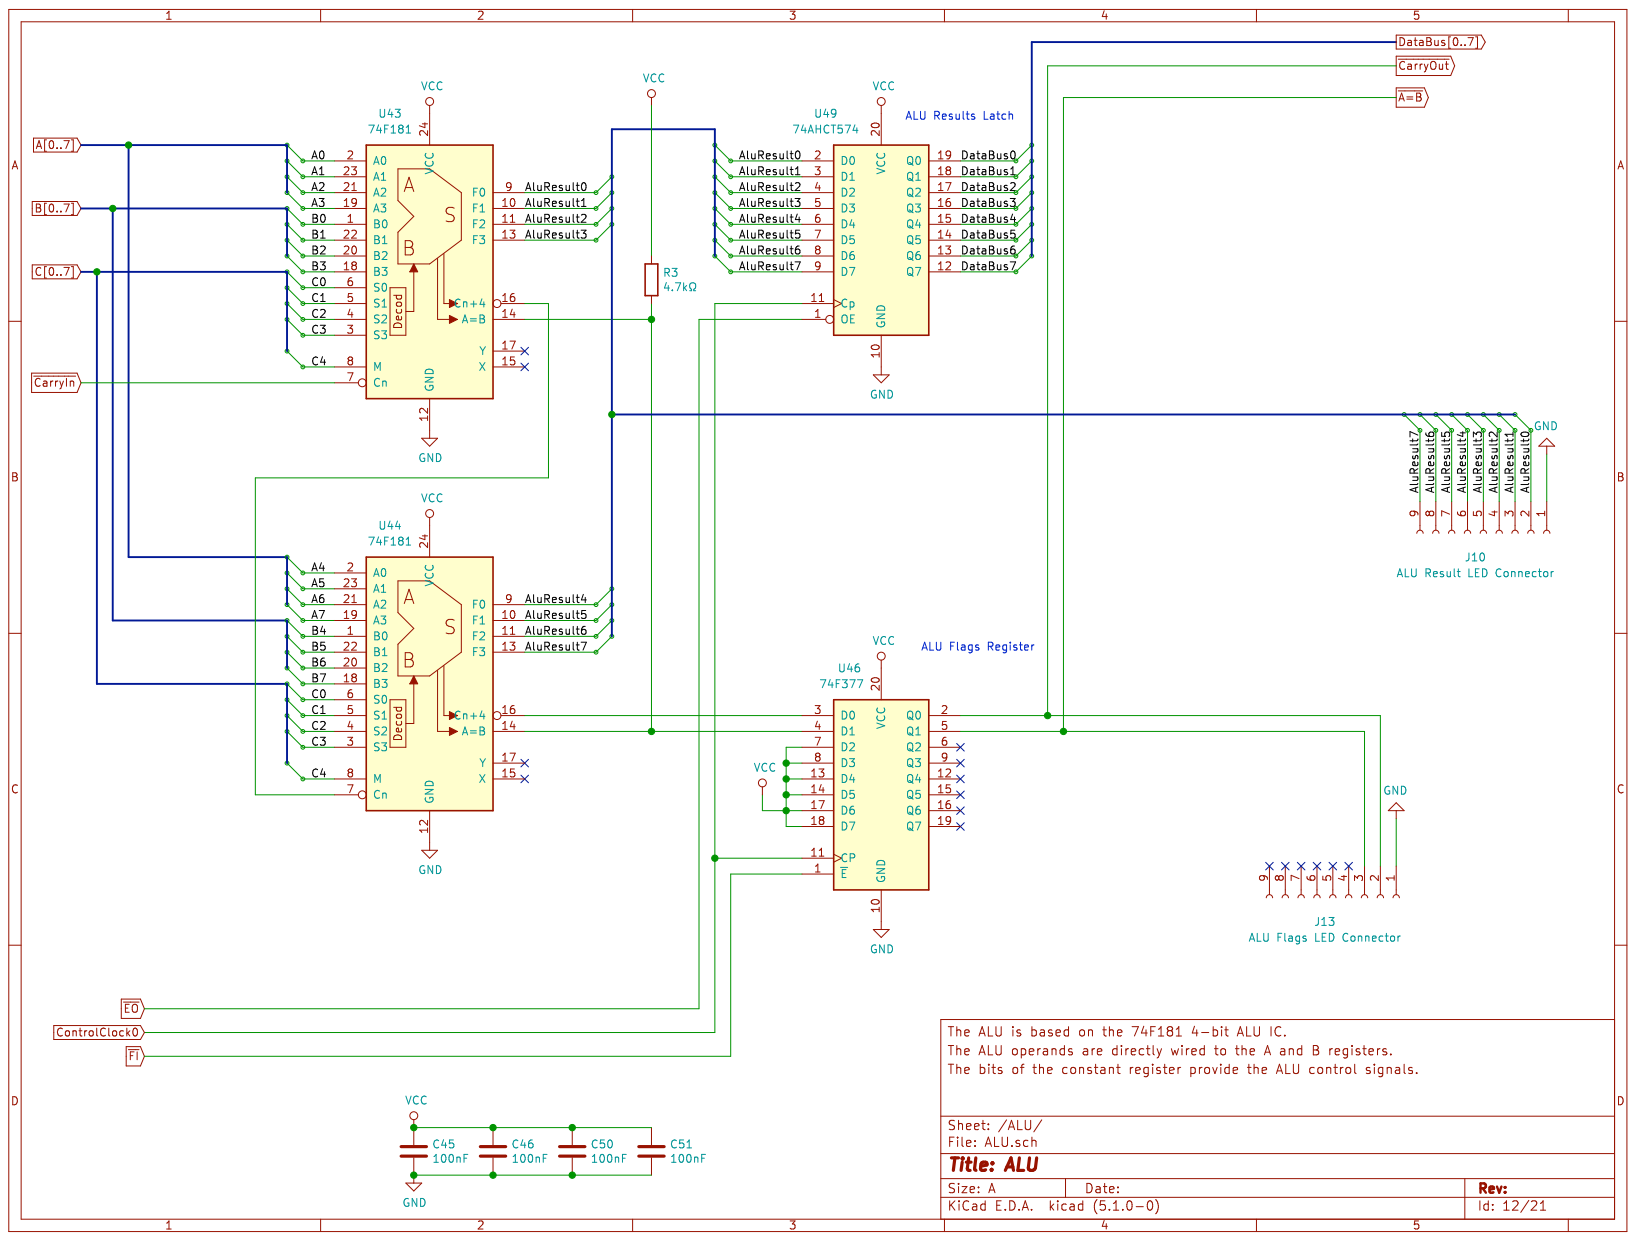
[picture p30: page 12]

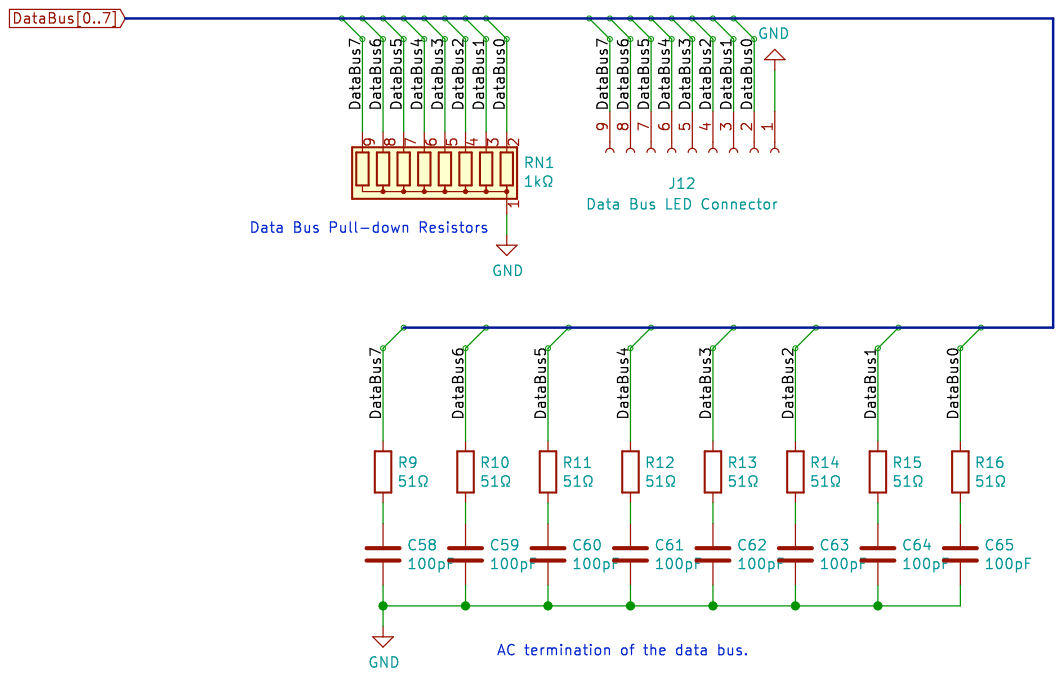
[picture p31: page 13]

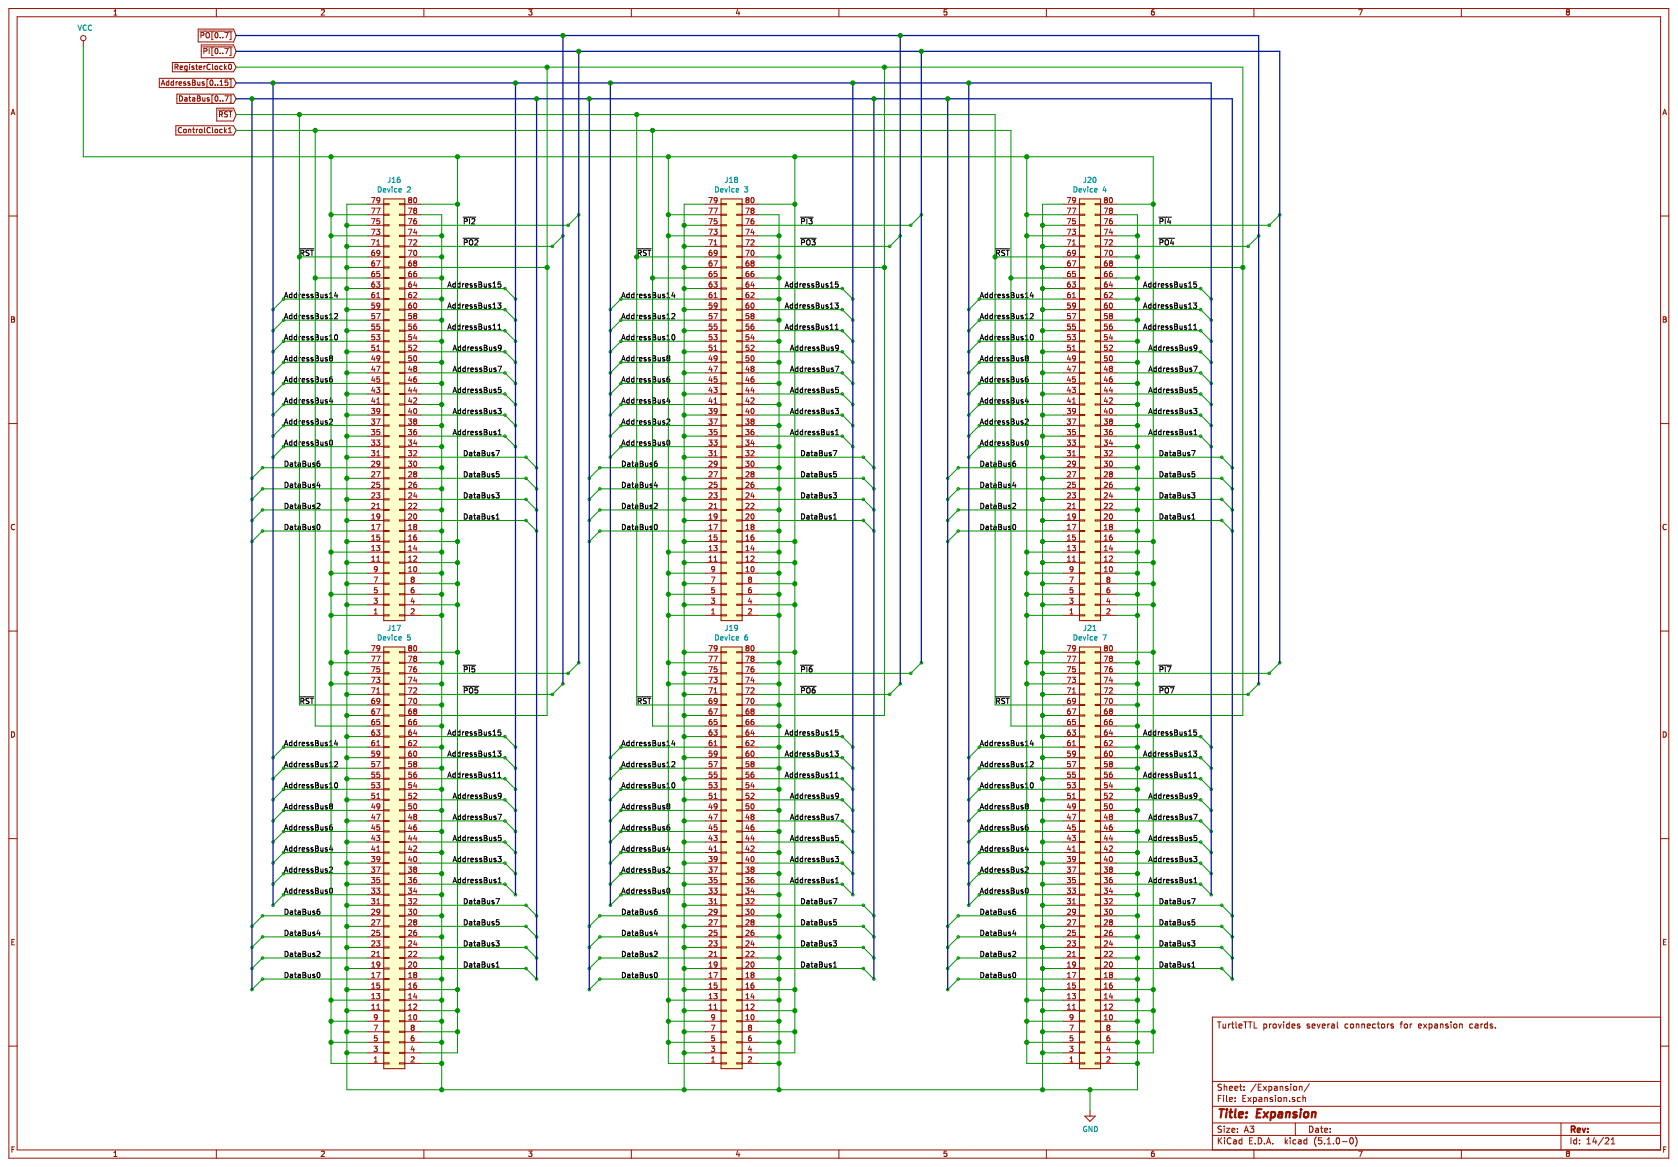
[picture p32: page 14]

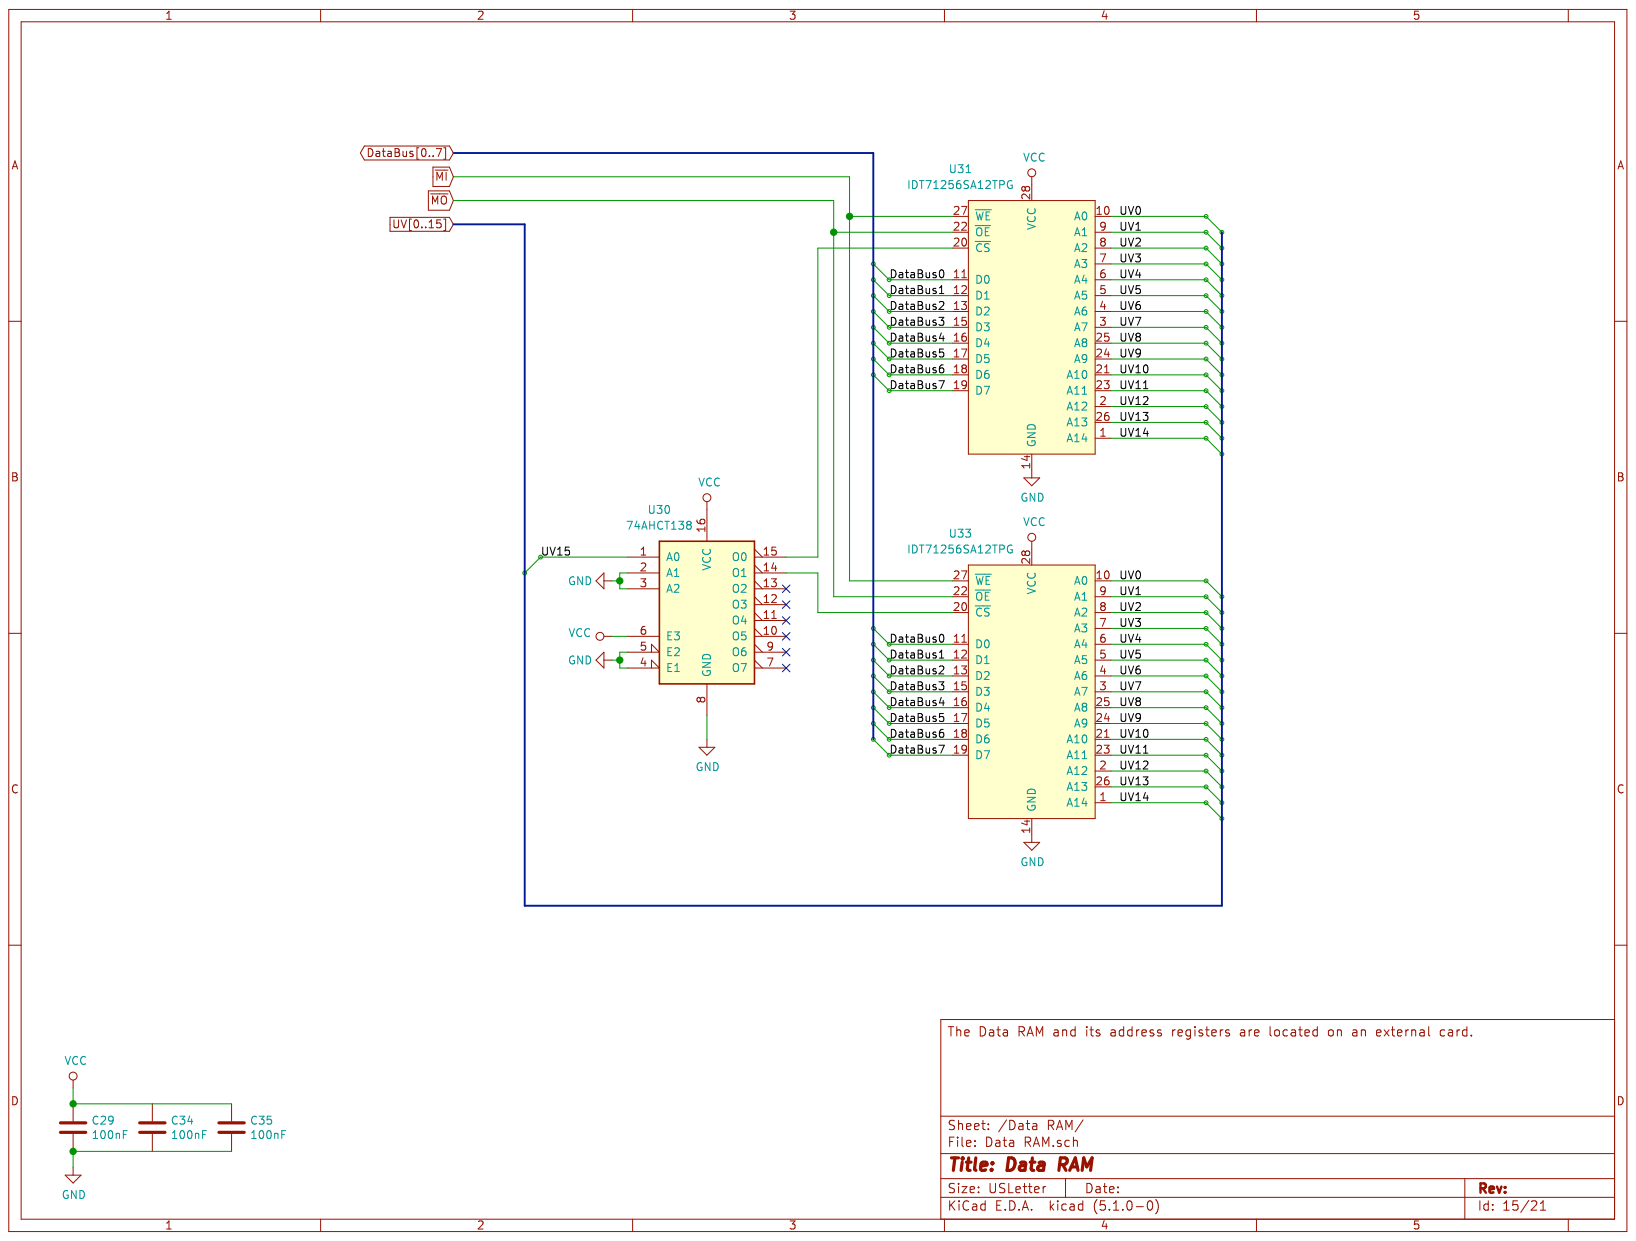
[picture p33: page 15]

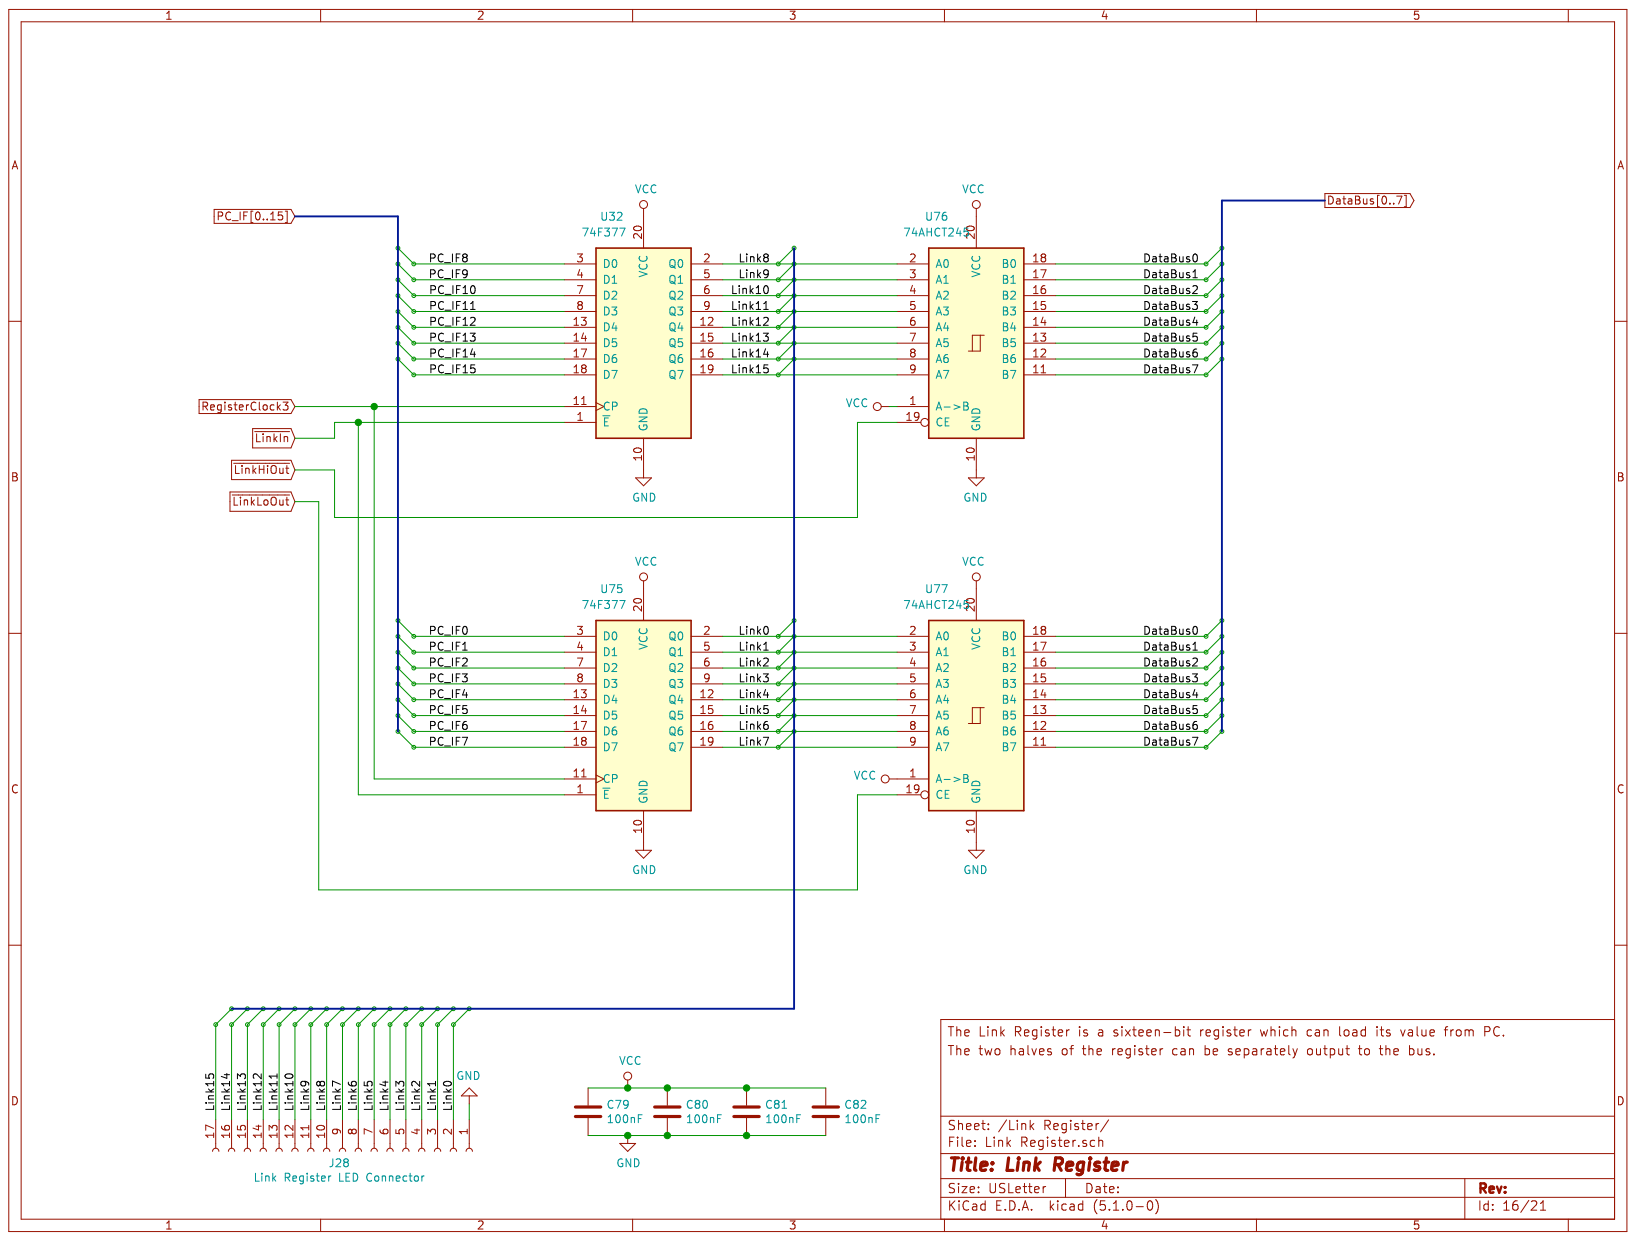
[picture p34: page 16]

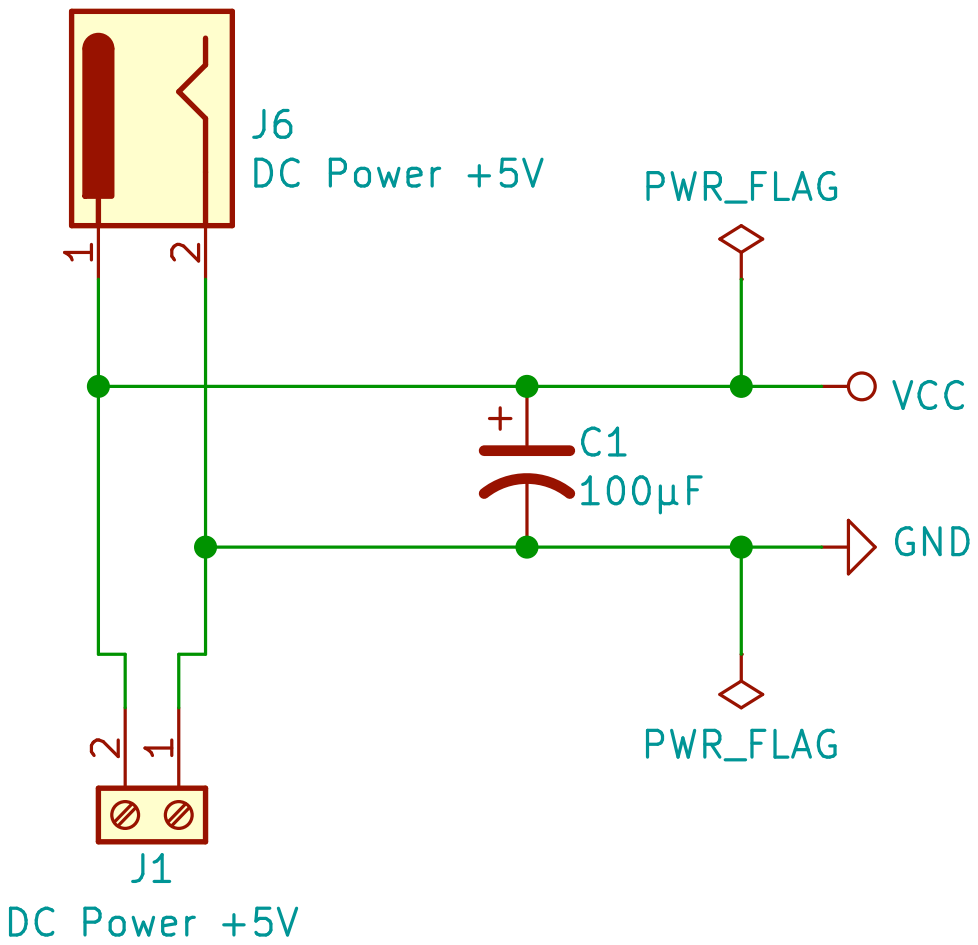
[picture p35: page 17]

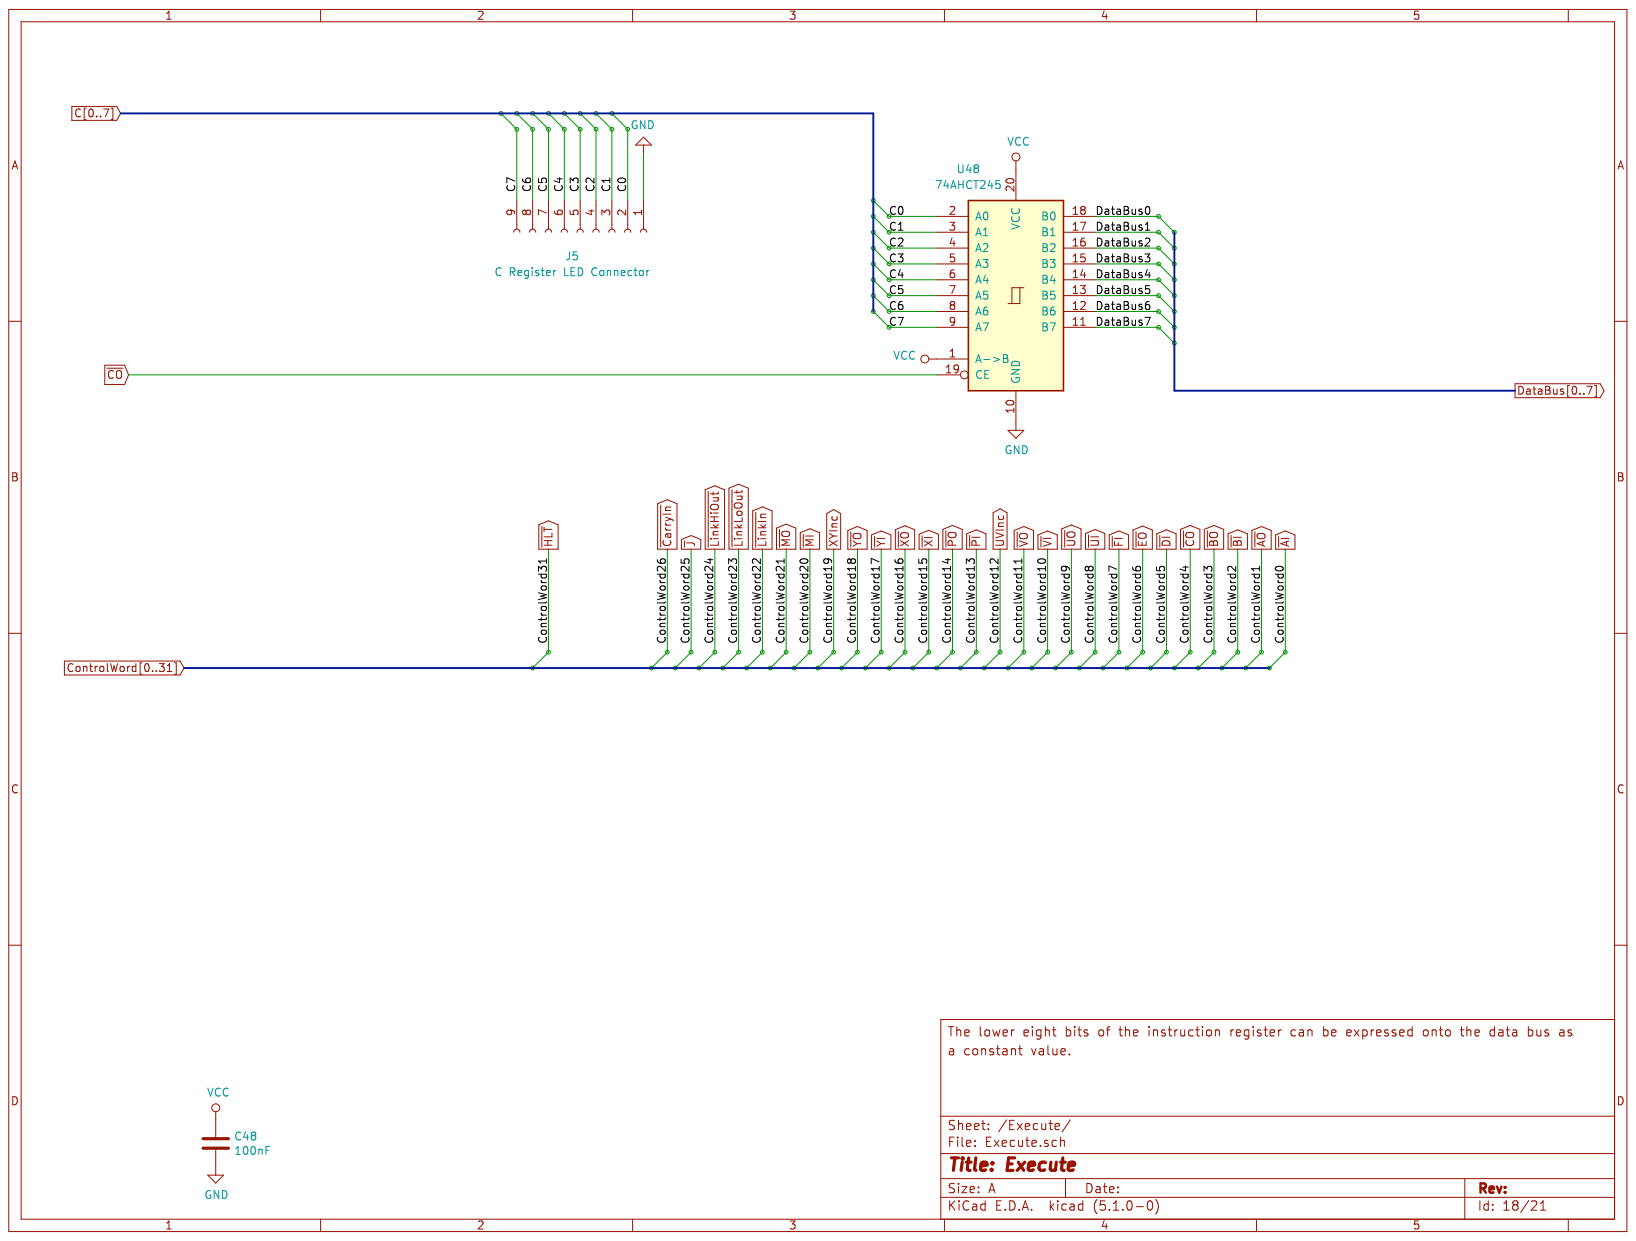
[picture p36: page 18]

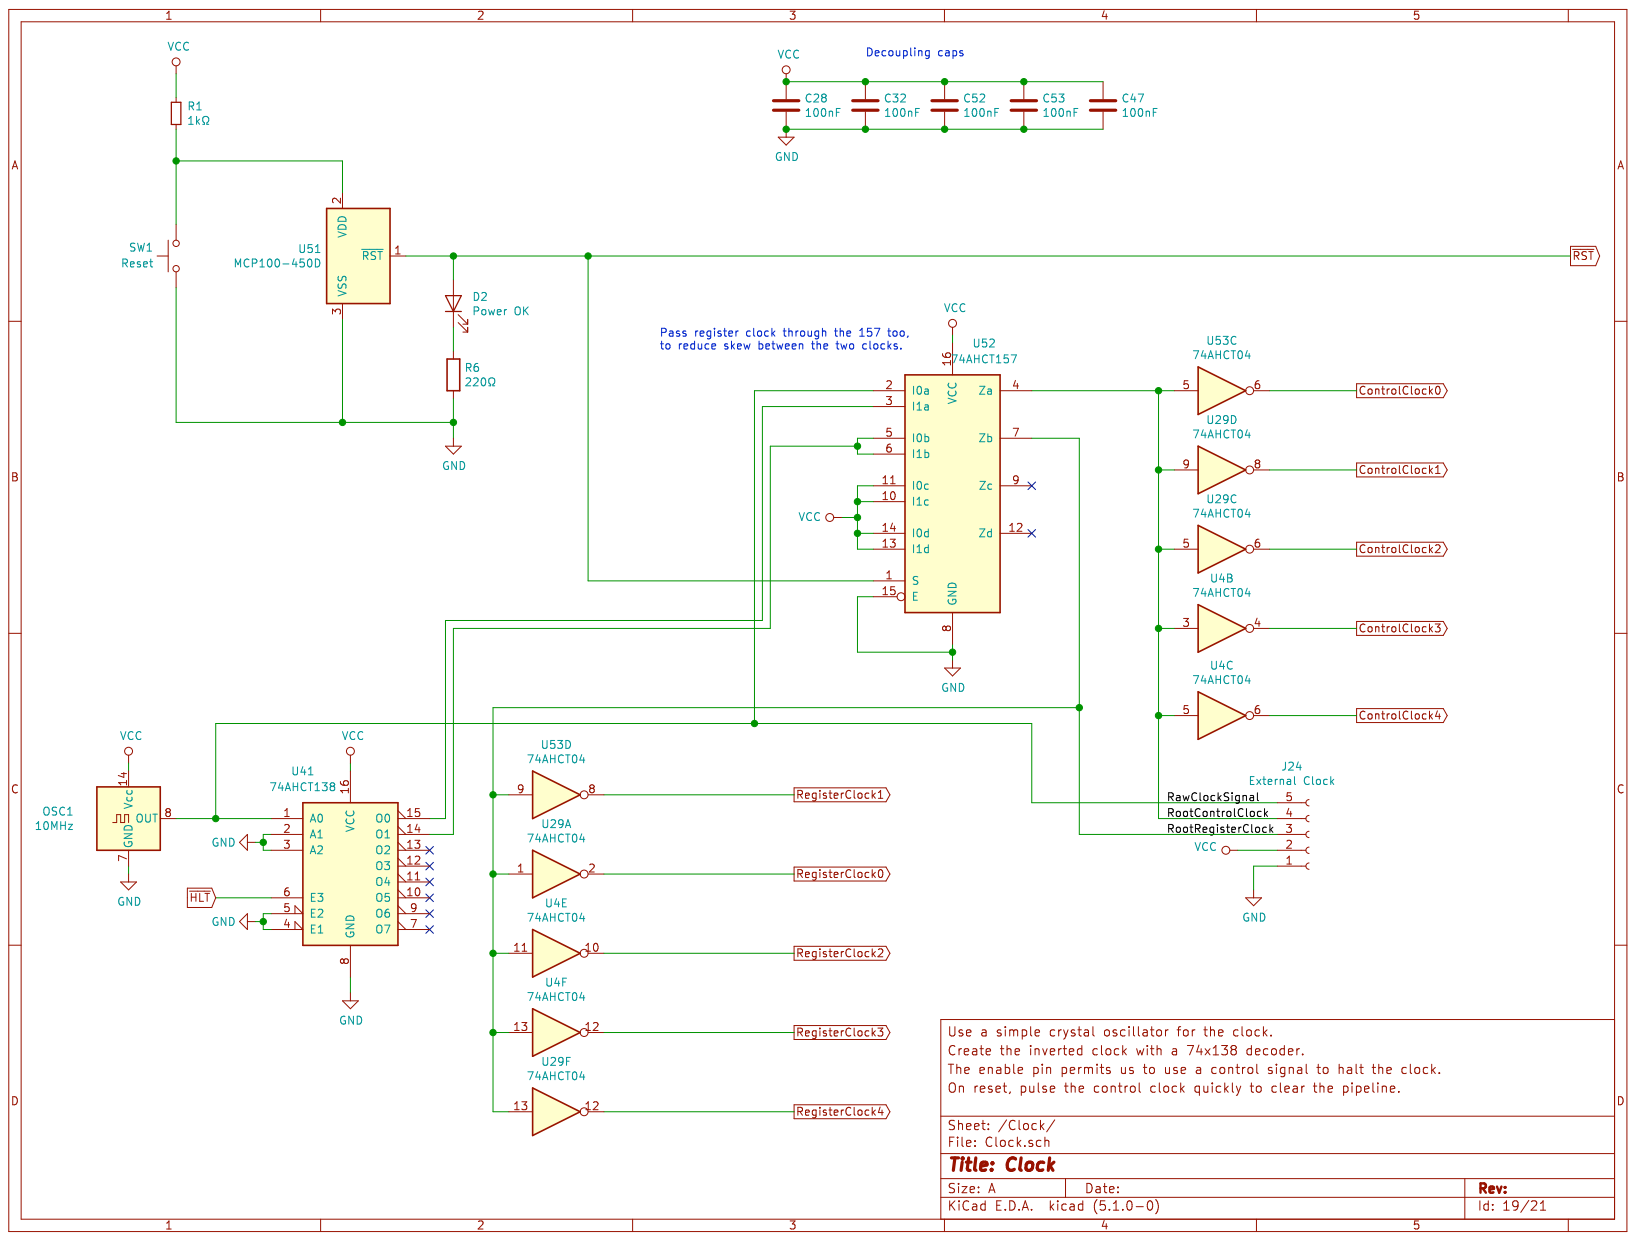
[picture p37: page 19]

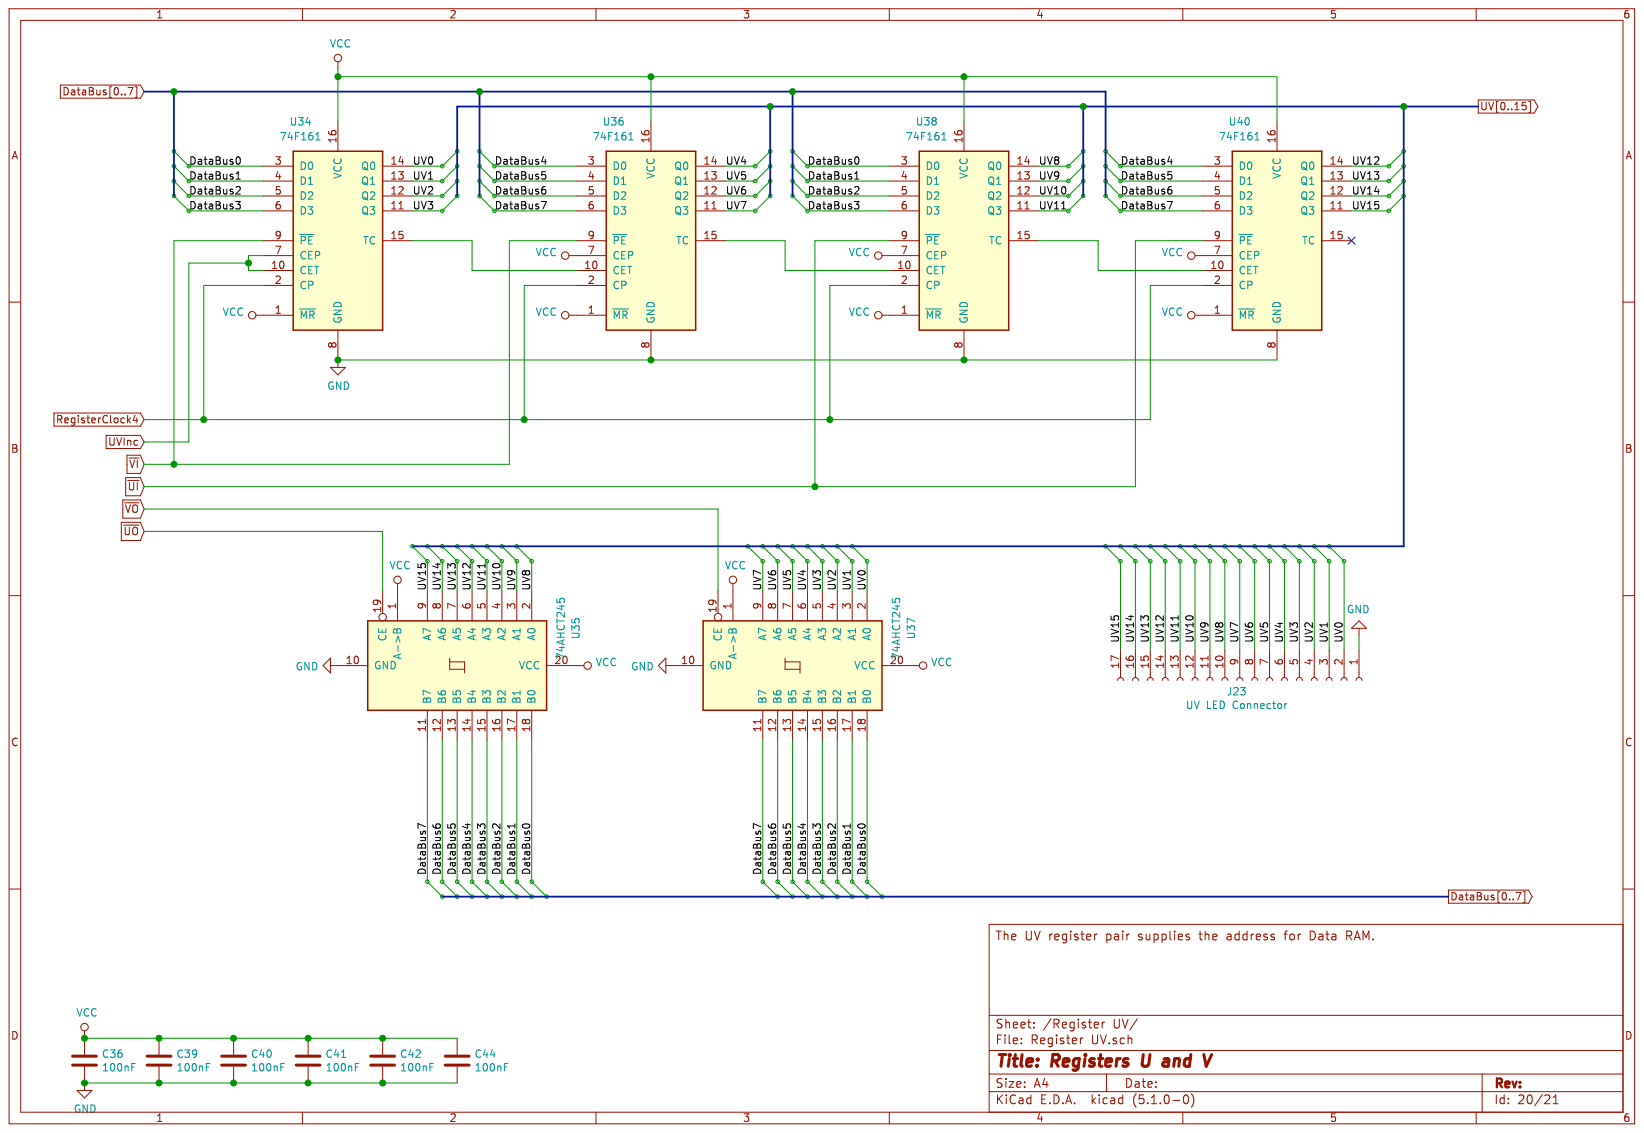
[picture p38: page 20]

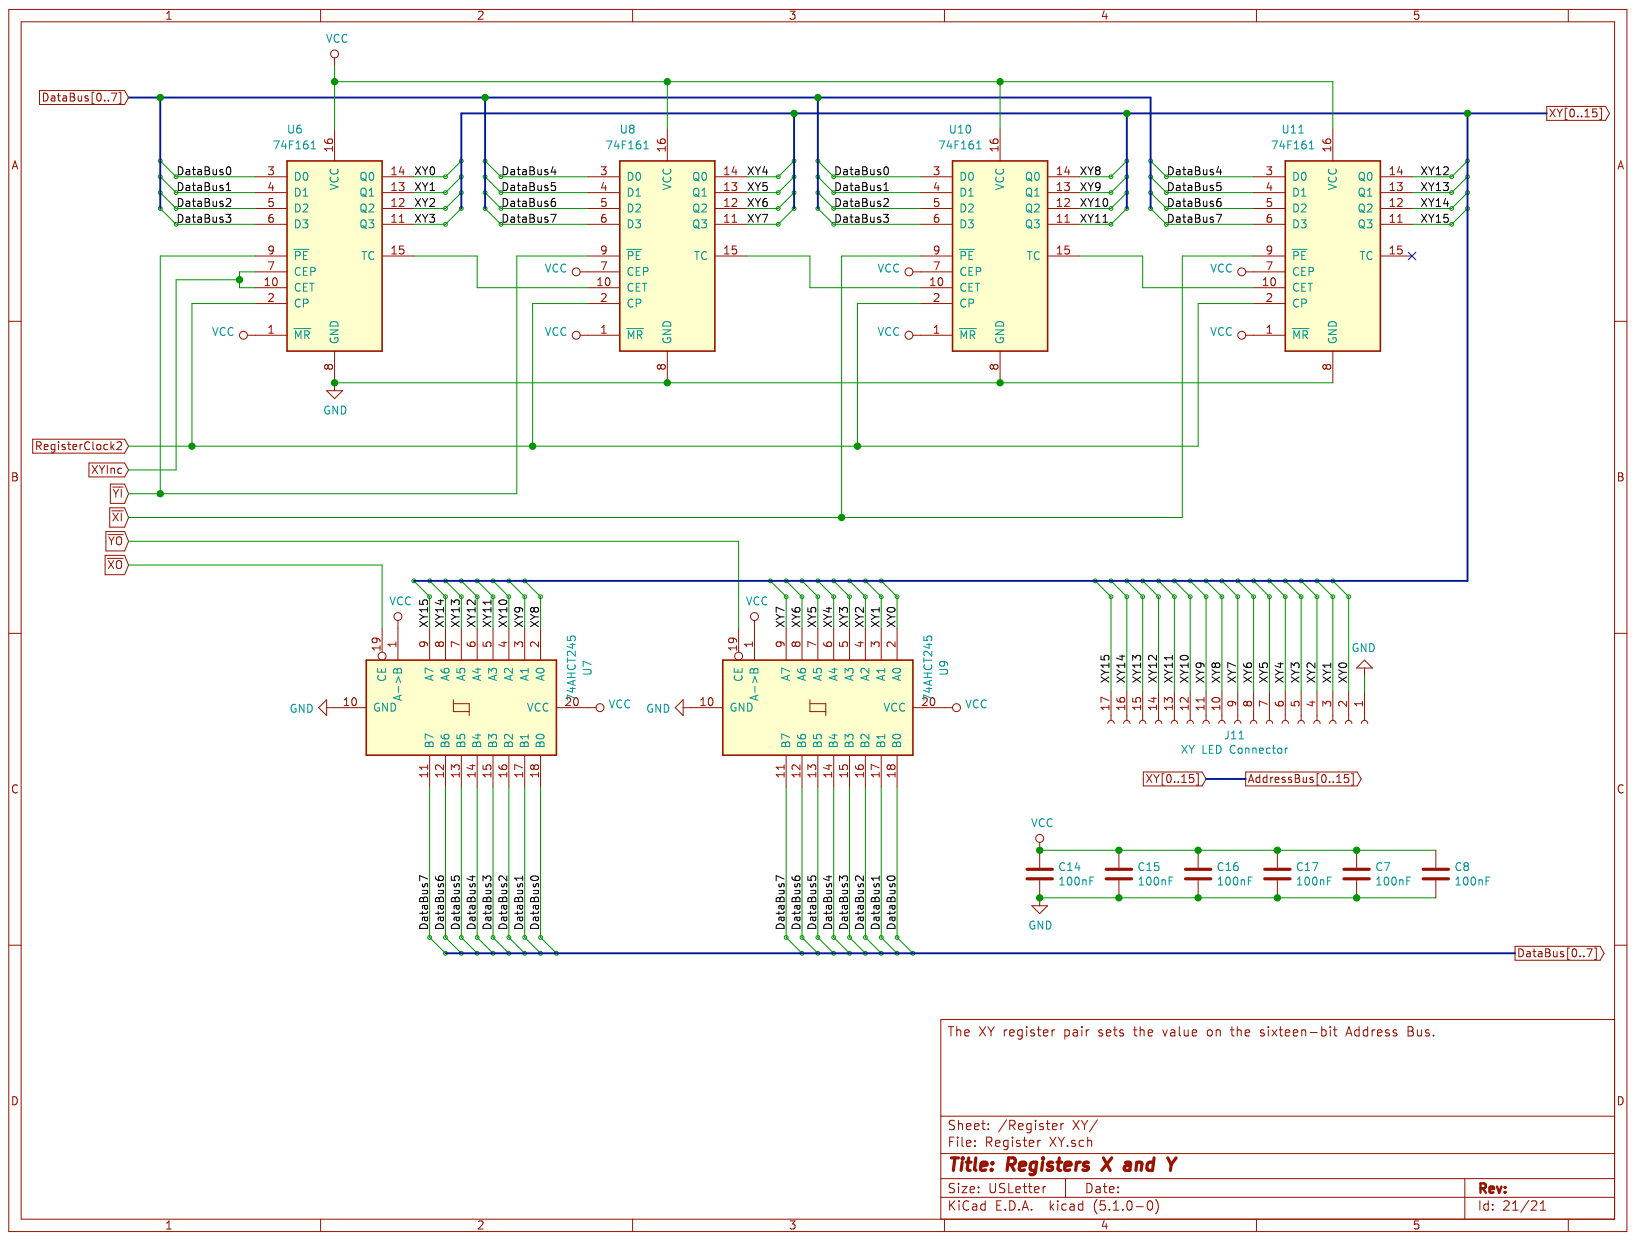
[picture p39: page 21]
