foxostro/TurtleTTL/Schematics/Version2/Generated/Schematic PDFs/SerialCard_Schematics.pdf

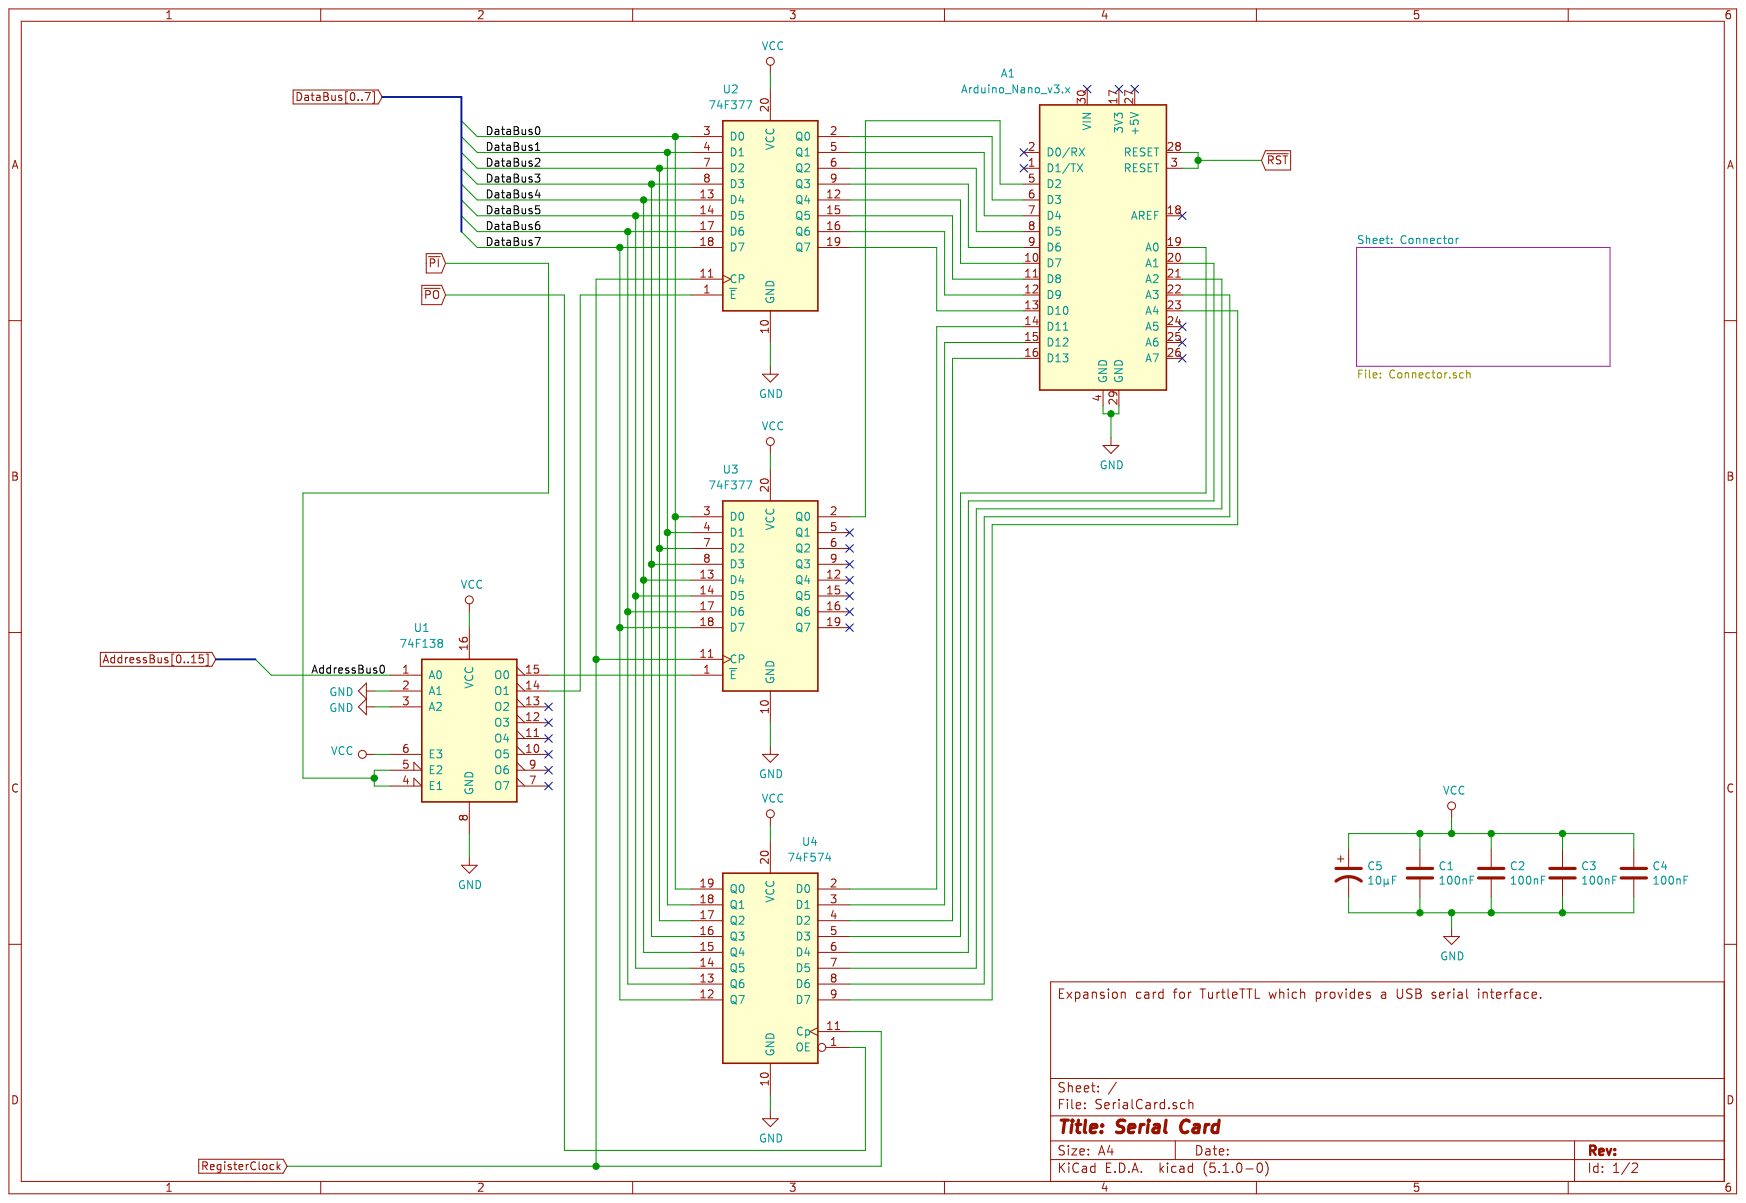
[picture p40: page 1]

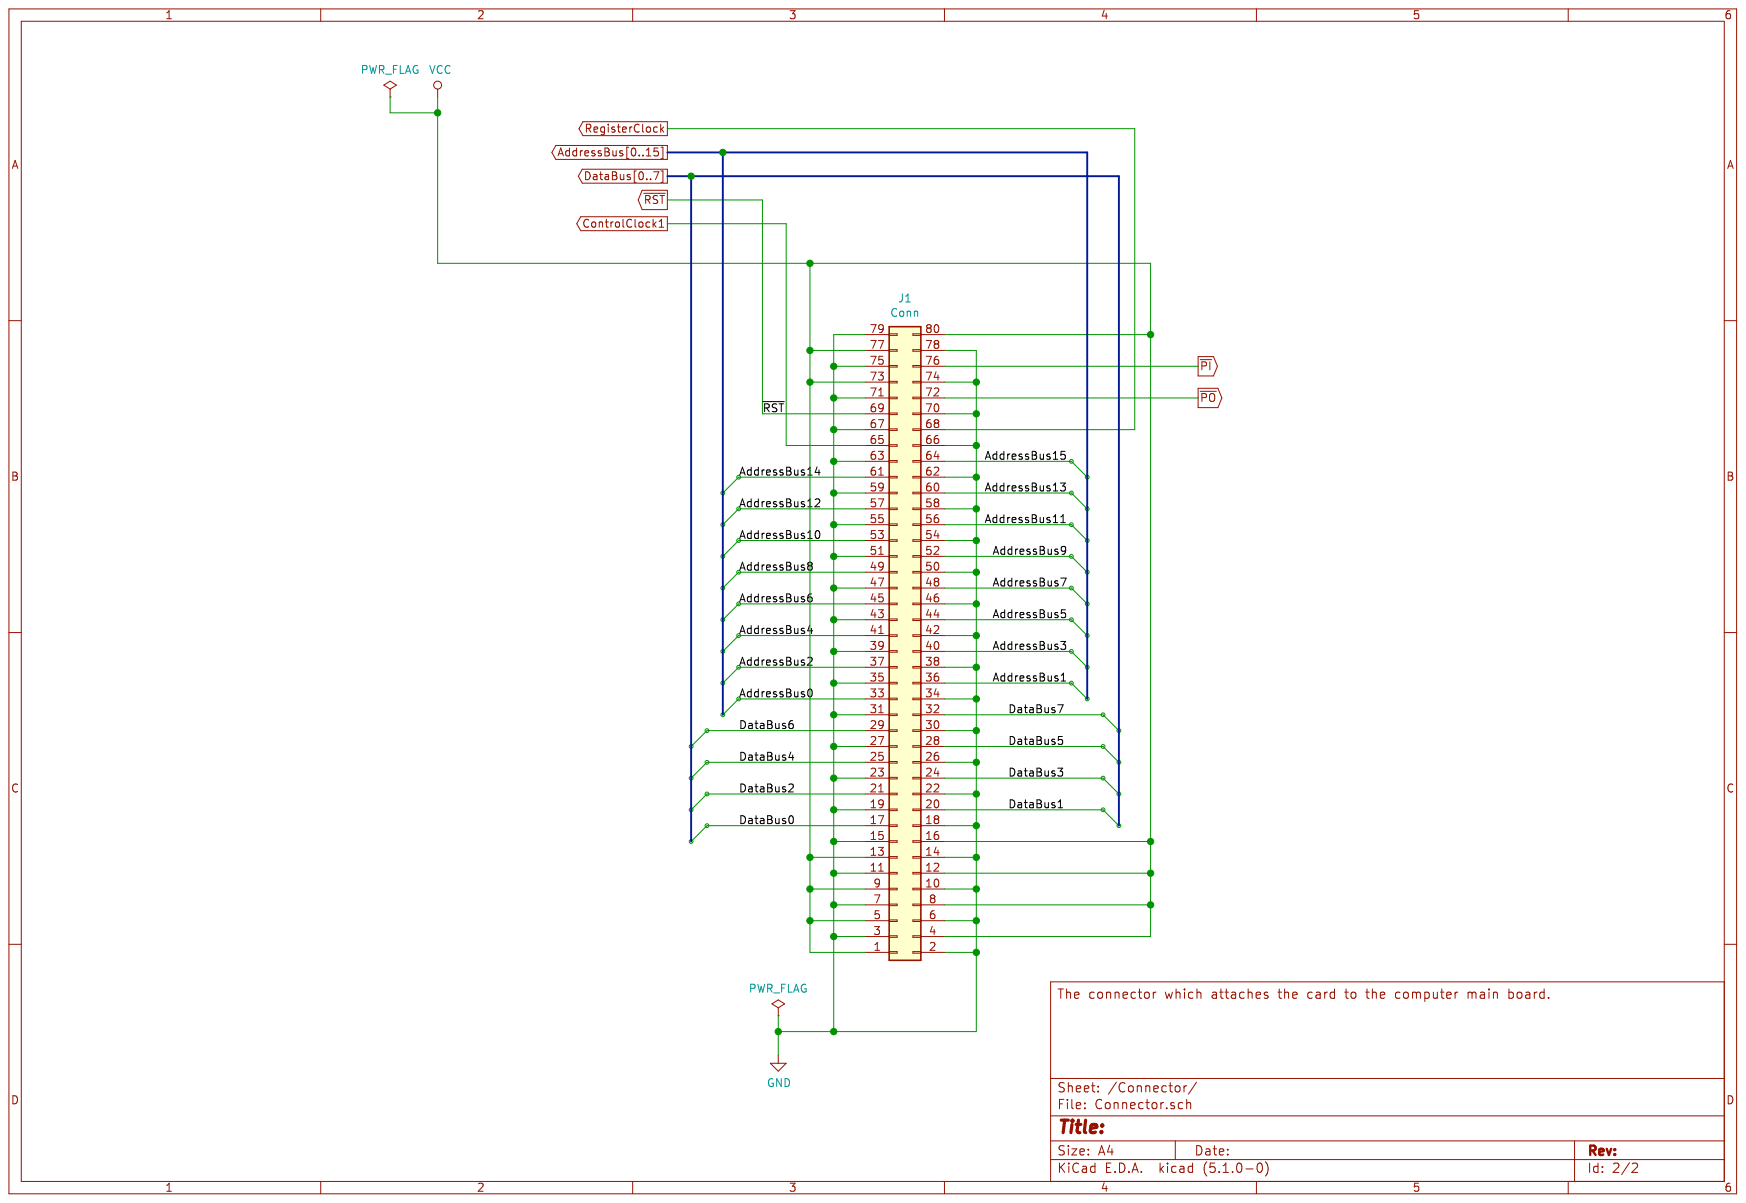
[picture p41: page 2]
