foxostro/TurtleTTL/Schematics/Misc/Generated/PCB PDFs/ExternalClock_PCB.pdf

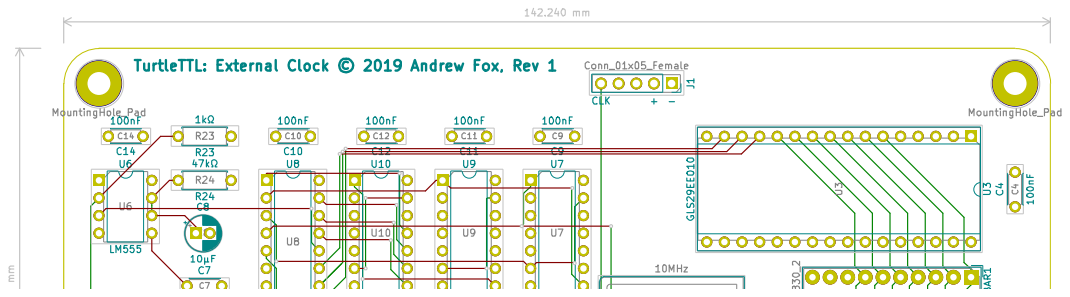
[picture p42: page 1]
