foxostro/TurtleTTL/Schematics/Misc/Generated/Schematic PDFs/ExternalClock_Schematics.pdf

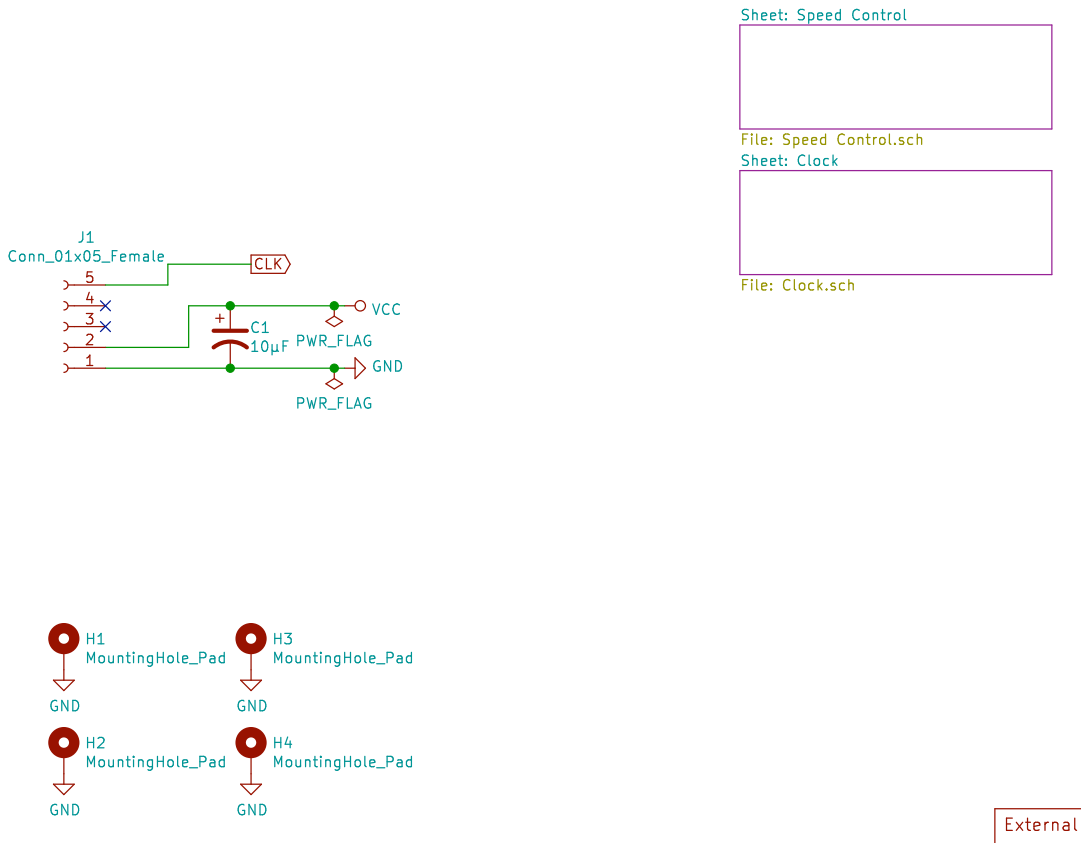
[picture p43: page 1]

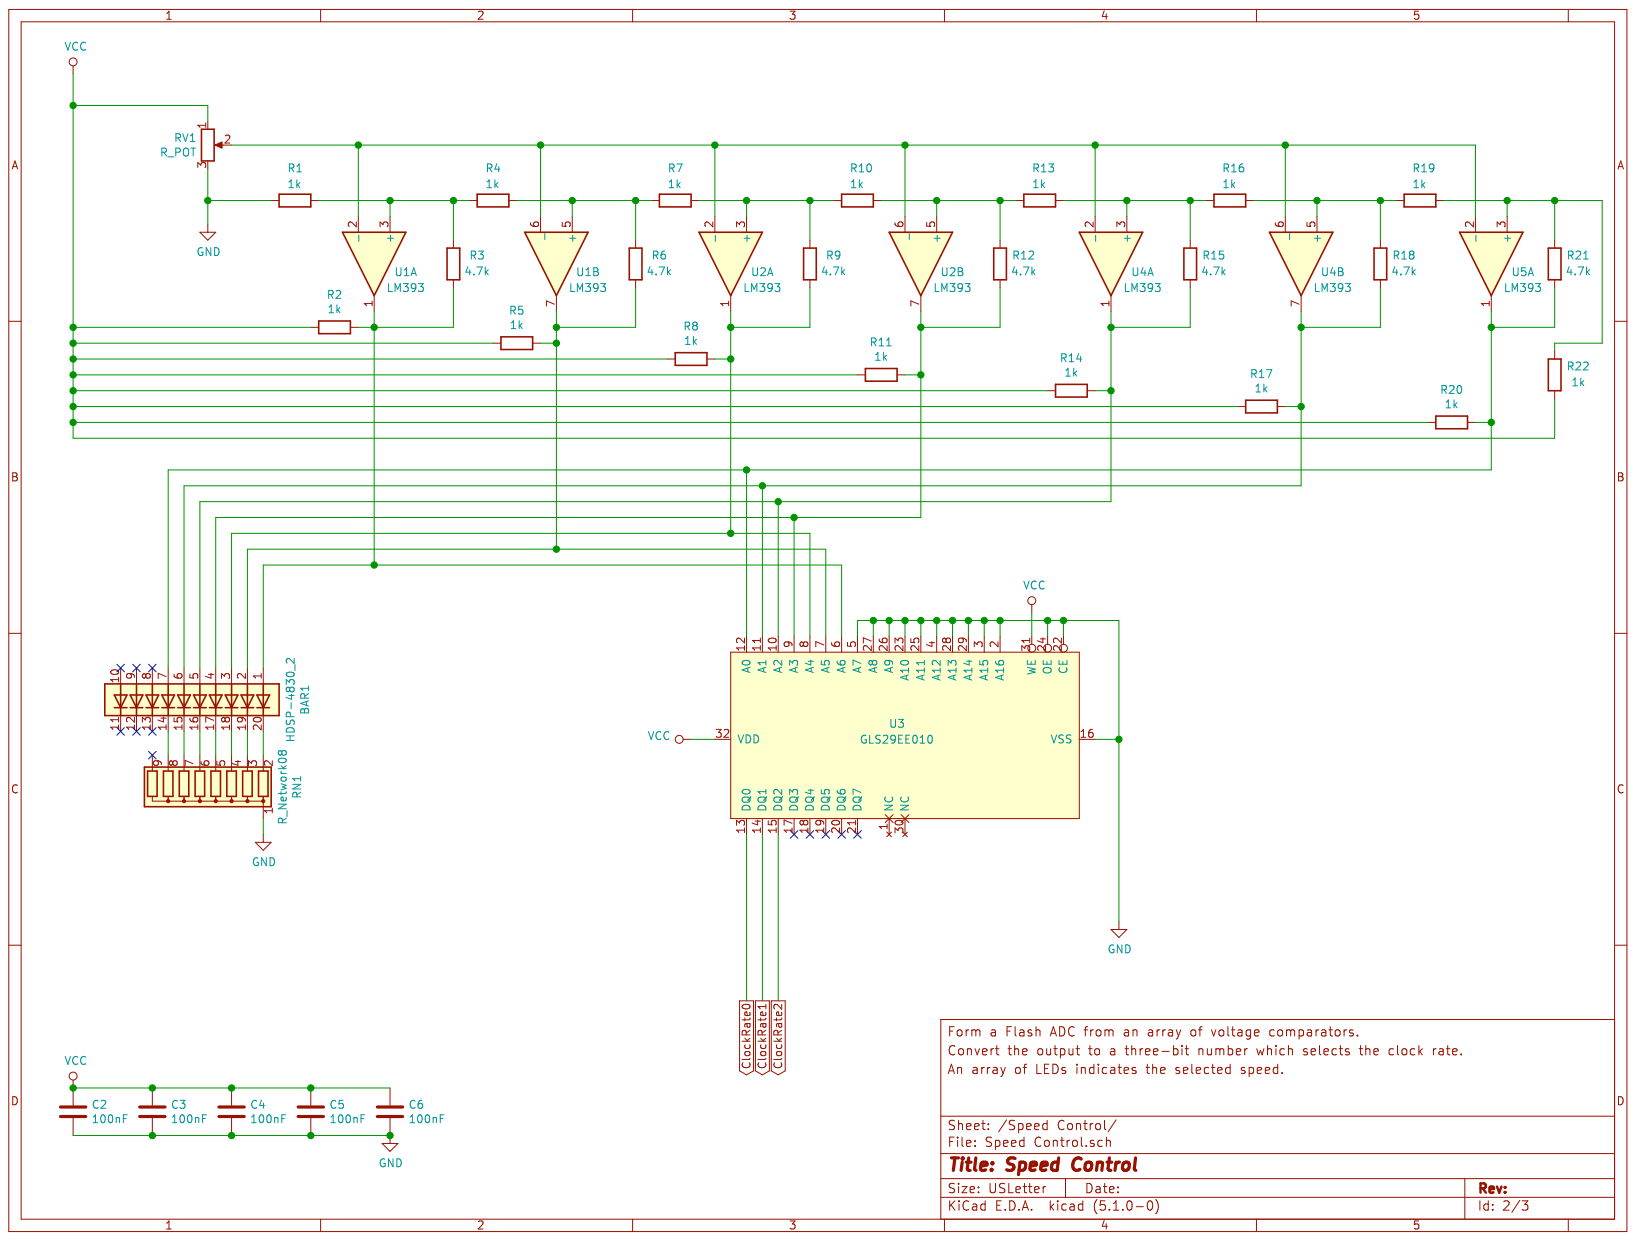
[picture p44: page 2]

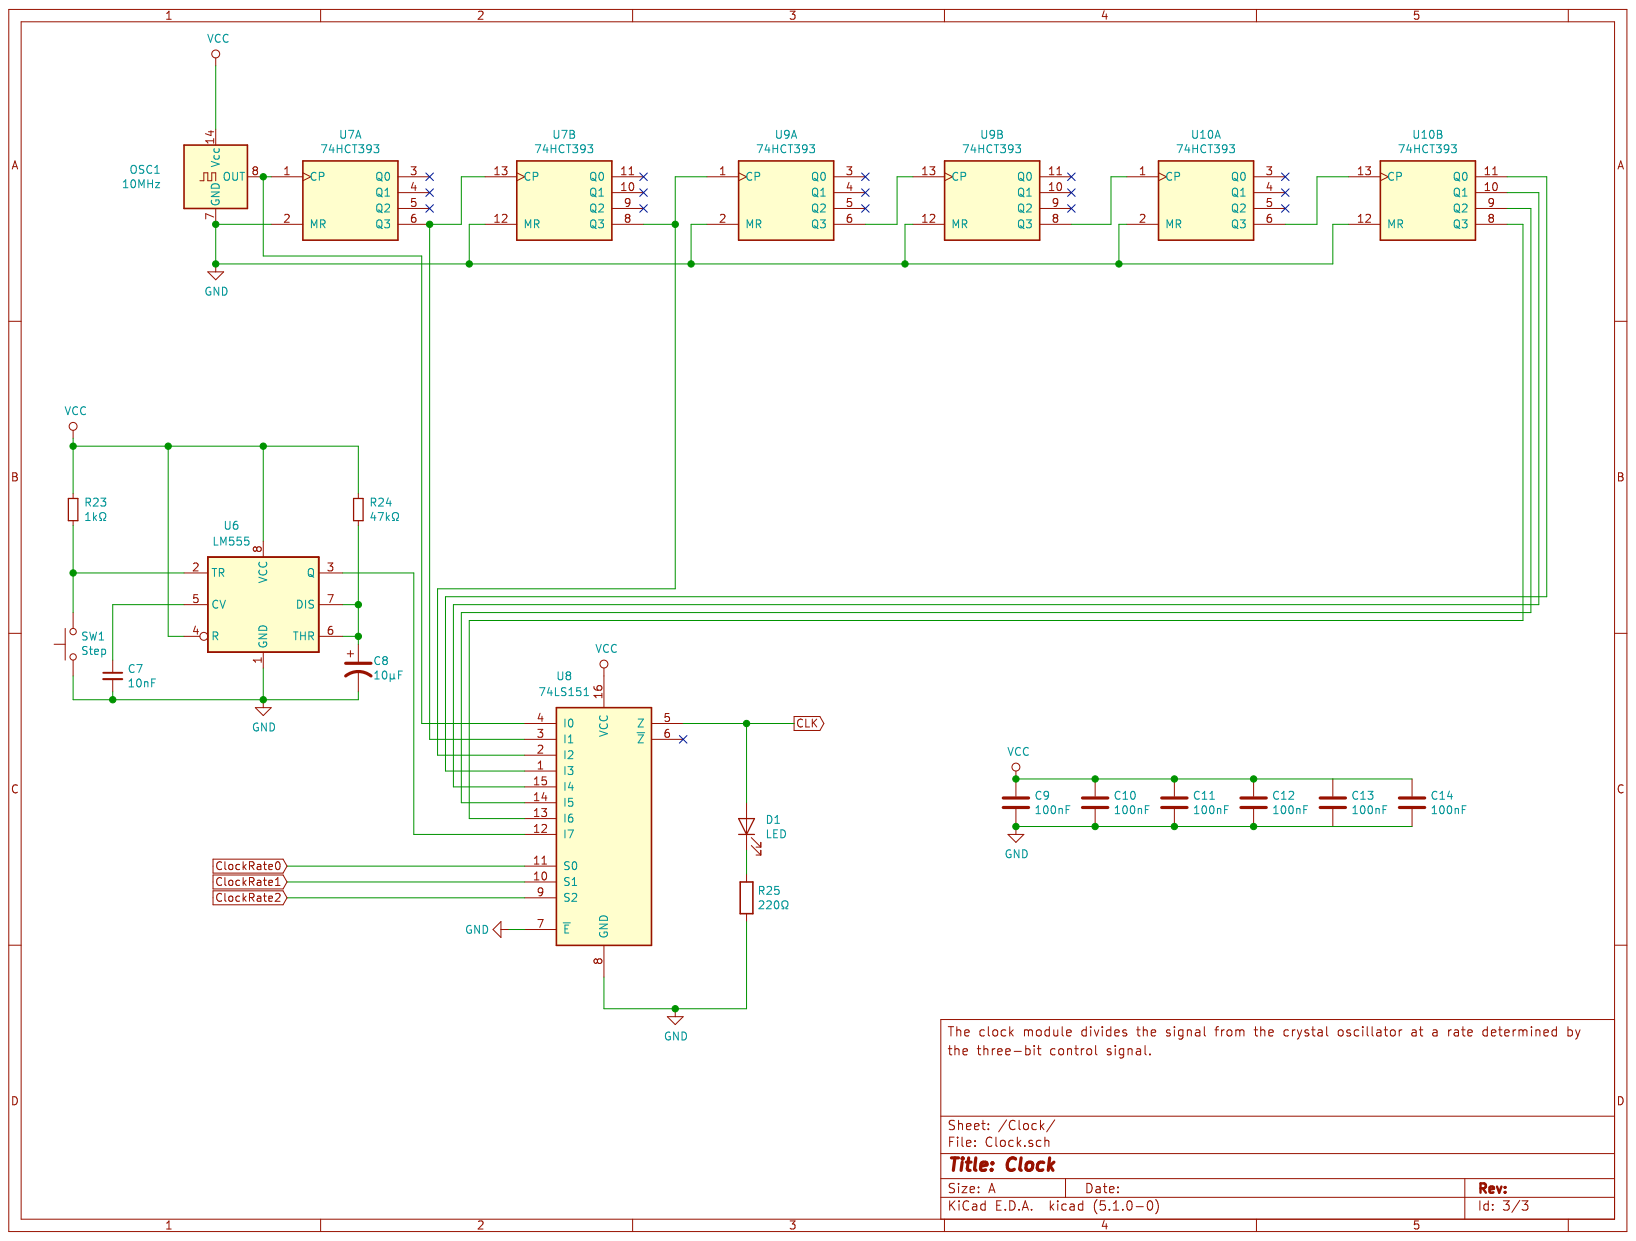
[picture p45: page 3]
