foxostro/TurtleTTL/Schematics/Misc/Generated/PCB PDFs/LEDRiser16_PCB.pdf

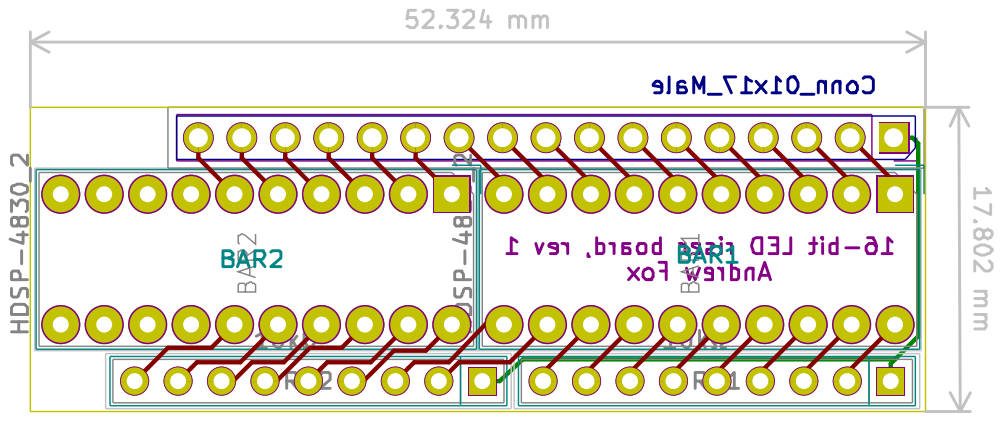
[picture p46: page 1]
