foxostro/TurtleTTL/Schematics/Misc/Generated/PCB PDFs/LEDRiser8_PCB.pdf

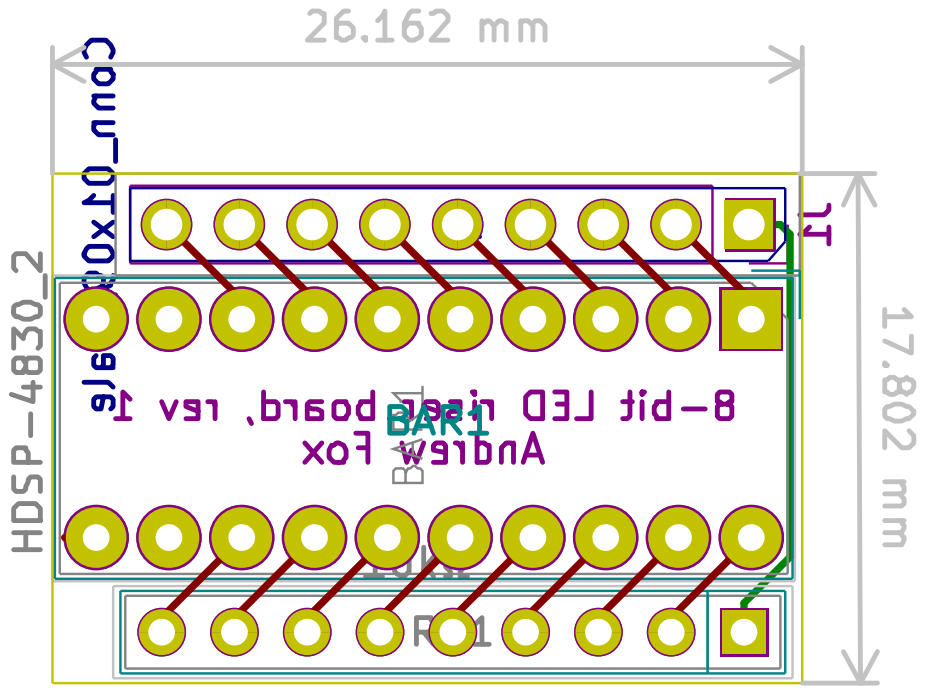
[picture p47: page 1]
