foxostro/TurtleTTL/Schematics/Misc/Generated/Schematic PDFs/LEDRiser16_Schematics.pdf

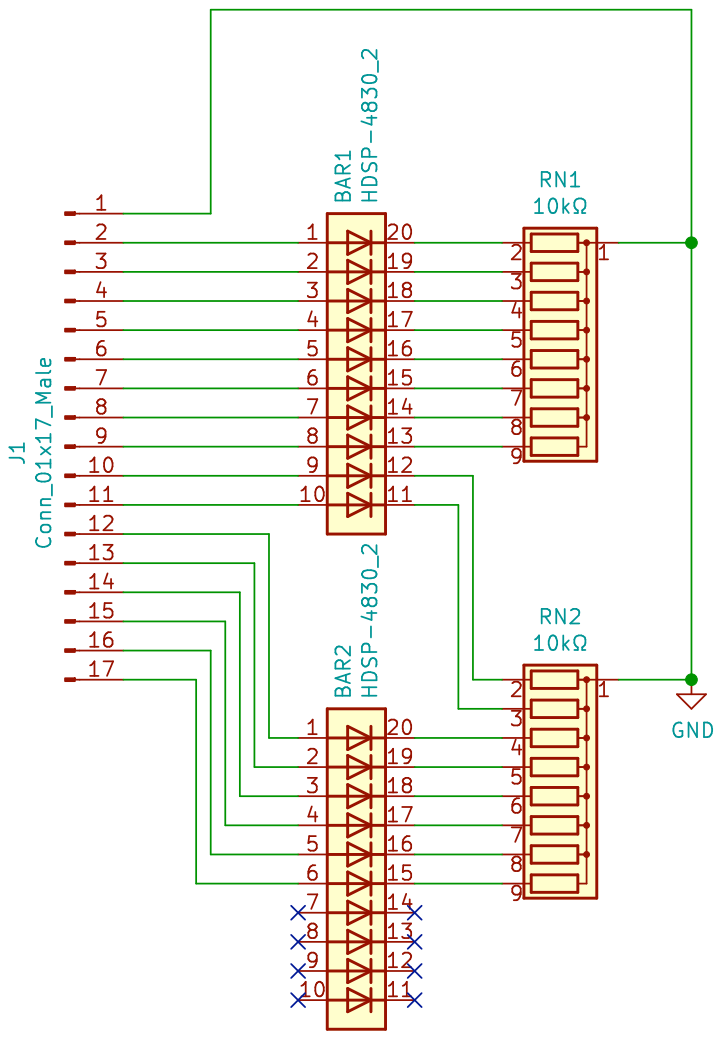
[picture p48: page 1]
