foxostro/TurtleTTL/Schematics/Misc/Generated/Schematic PDFs/LEDRiser8_Schematics.pdf

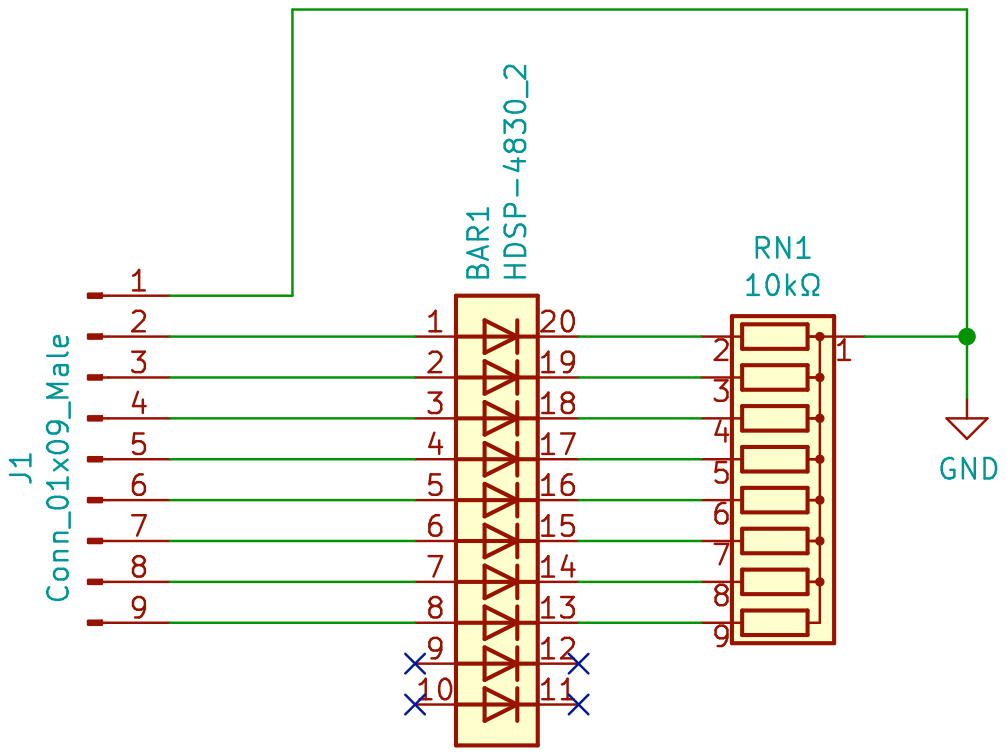
[picture p49: page 1]
