foxostro/TurtleTTL/Schematics/Version1/Generated/PCB PDFs/ArduinoSerialCard_PCB.pdf

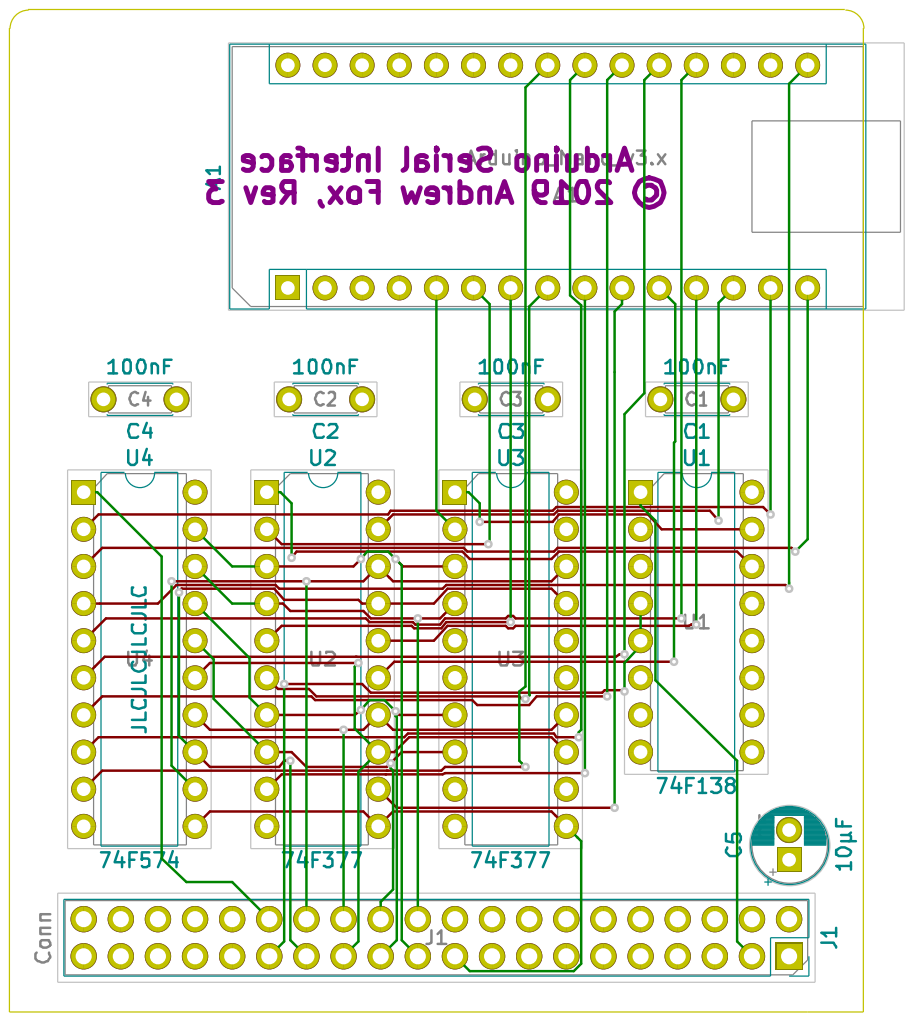
[picture p50: page 1]
