foxostro/TurtleTTL/Schematics/Version1/Generated/Schematic PDFs/ArduinoSerialCard_Schematics.pdf

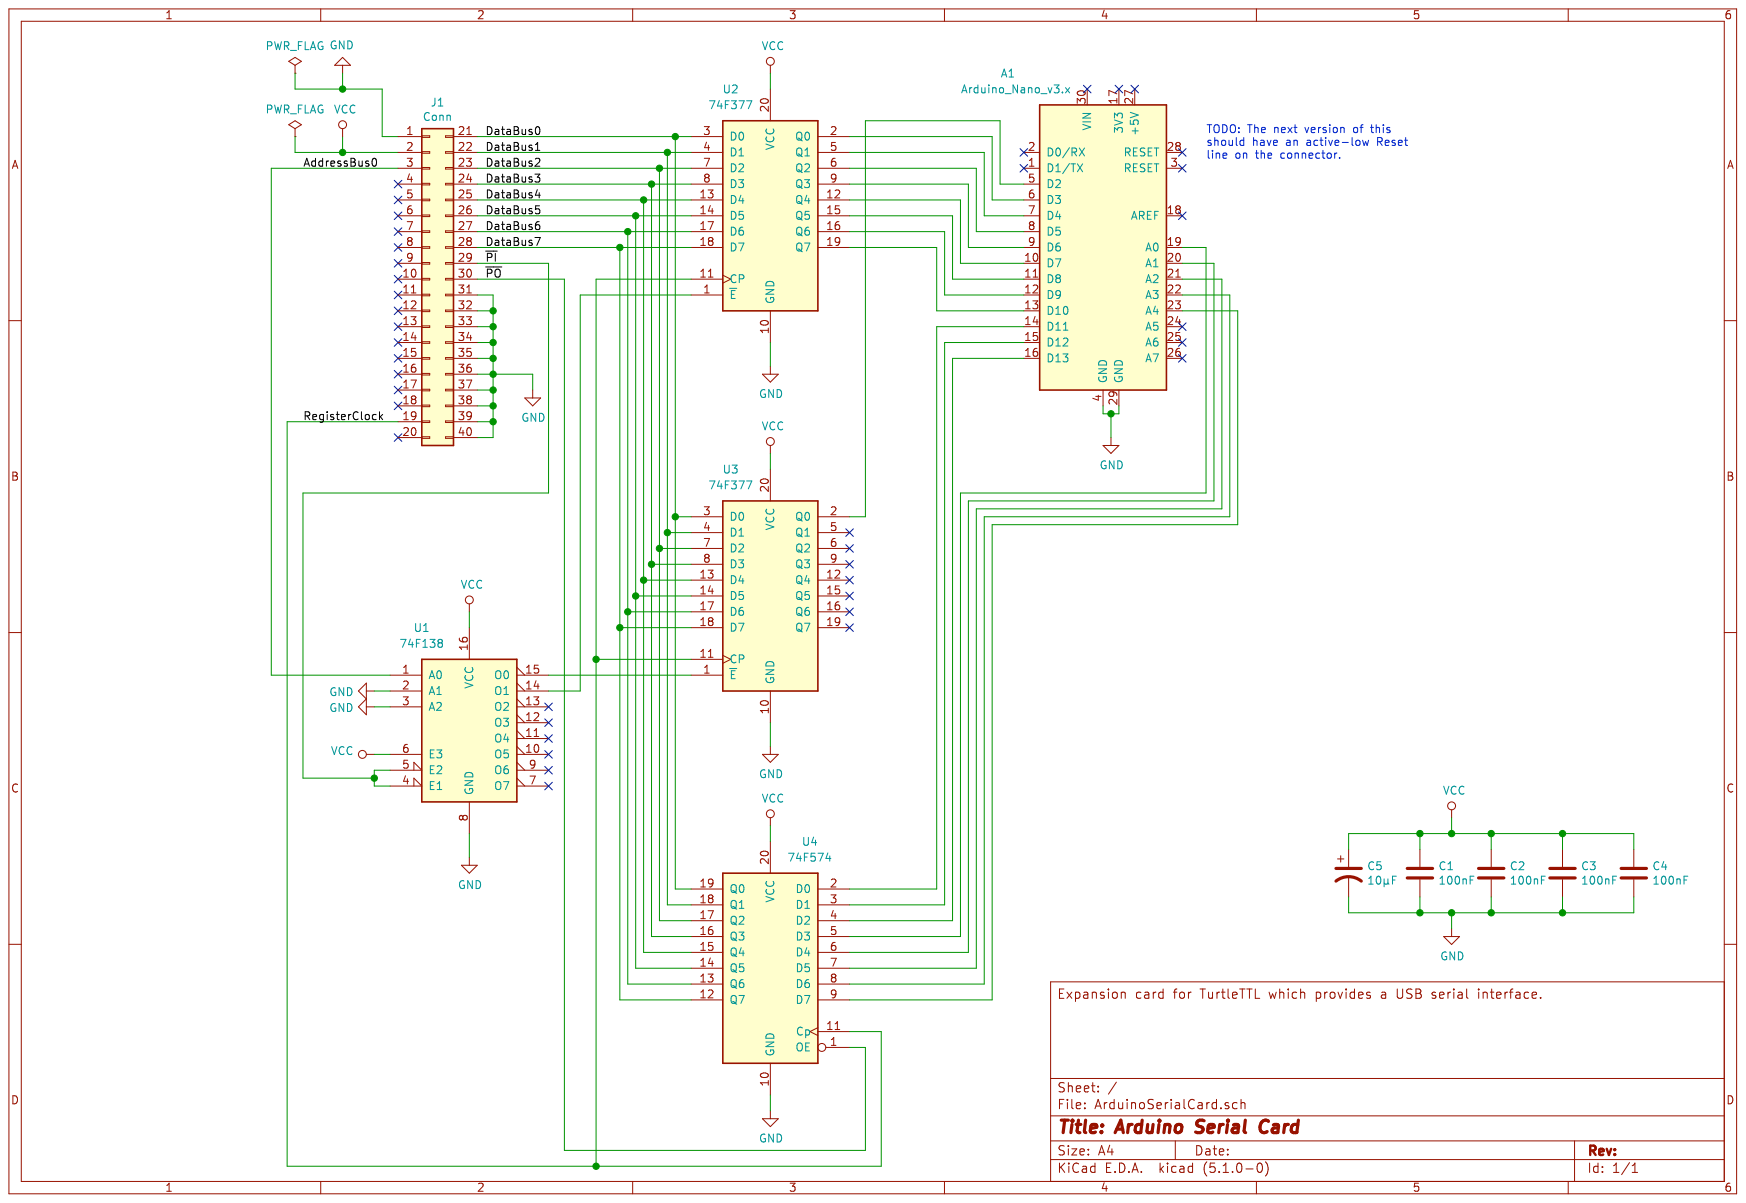
[picture p51: page 1]
