foxostro/TurtleTTL/Schematics/Version1/Generated/PCB PDFs/MainBoard_PCB.pdf

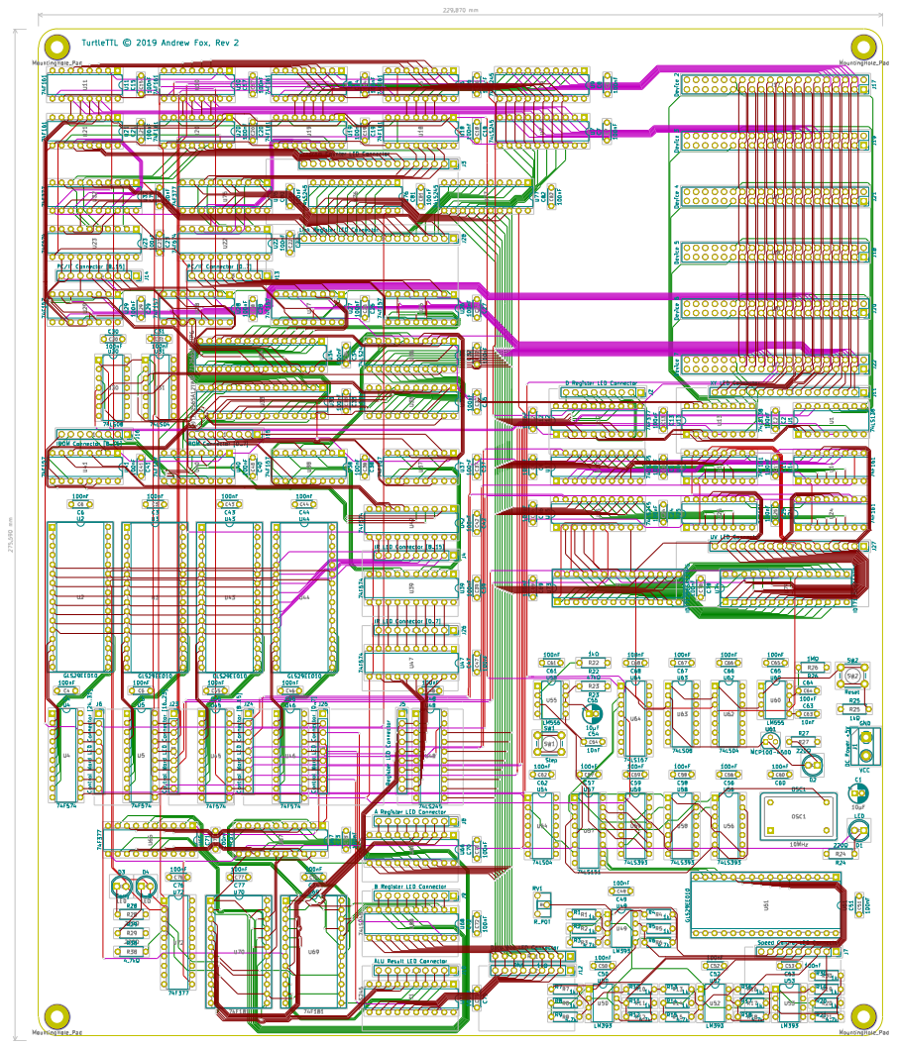
[picture p52: page 1]
