foxostro/TurtleTTL/Schematics/Version1/Generated/Schematic PDFs/MainBoard_Schematics.pdf

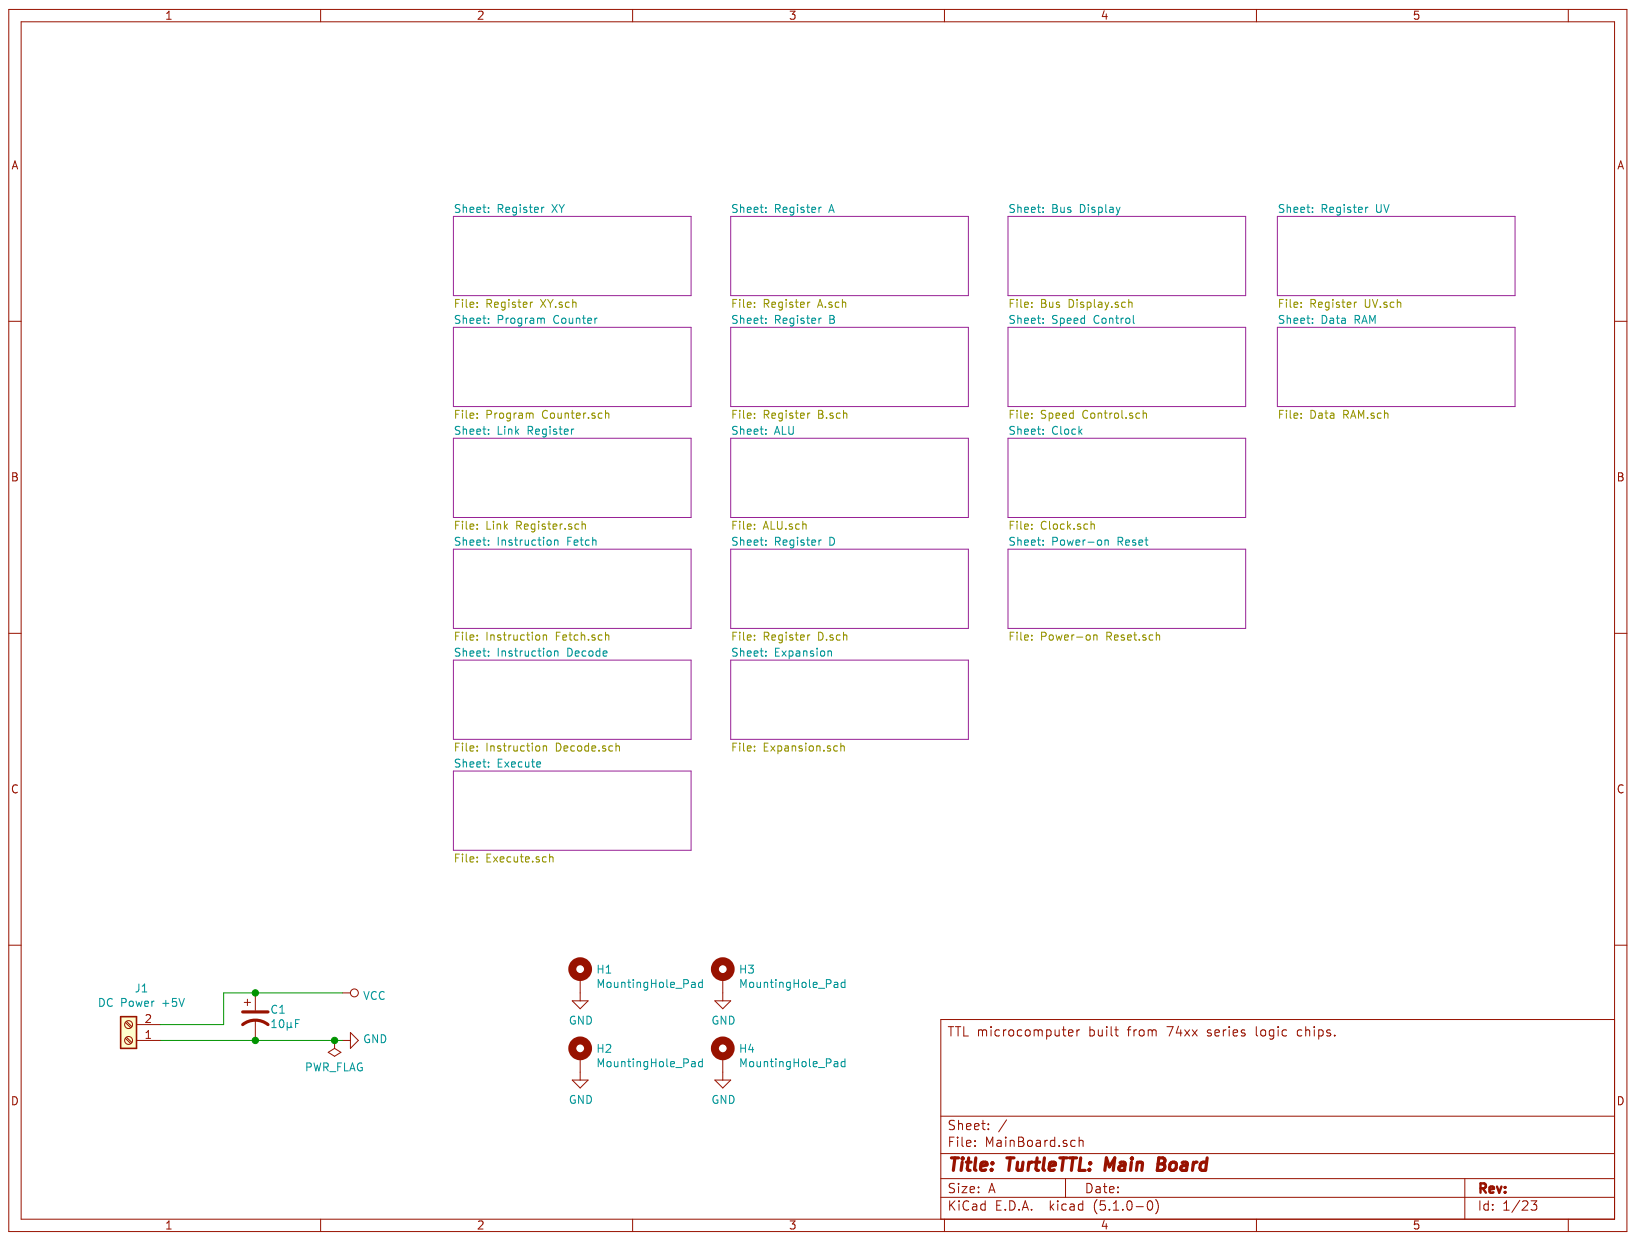
[picture p53: page 1]

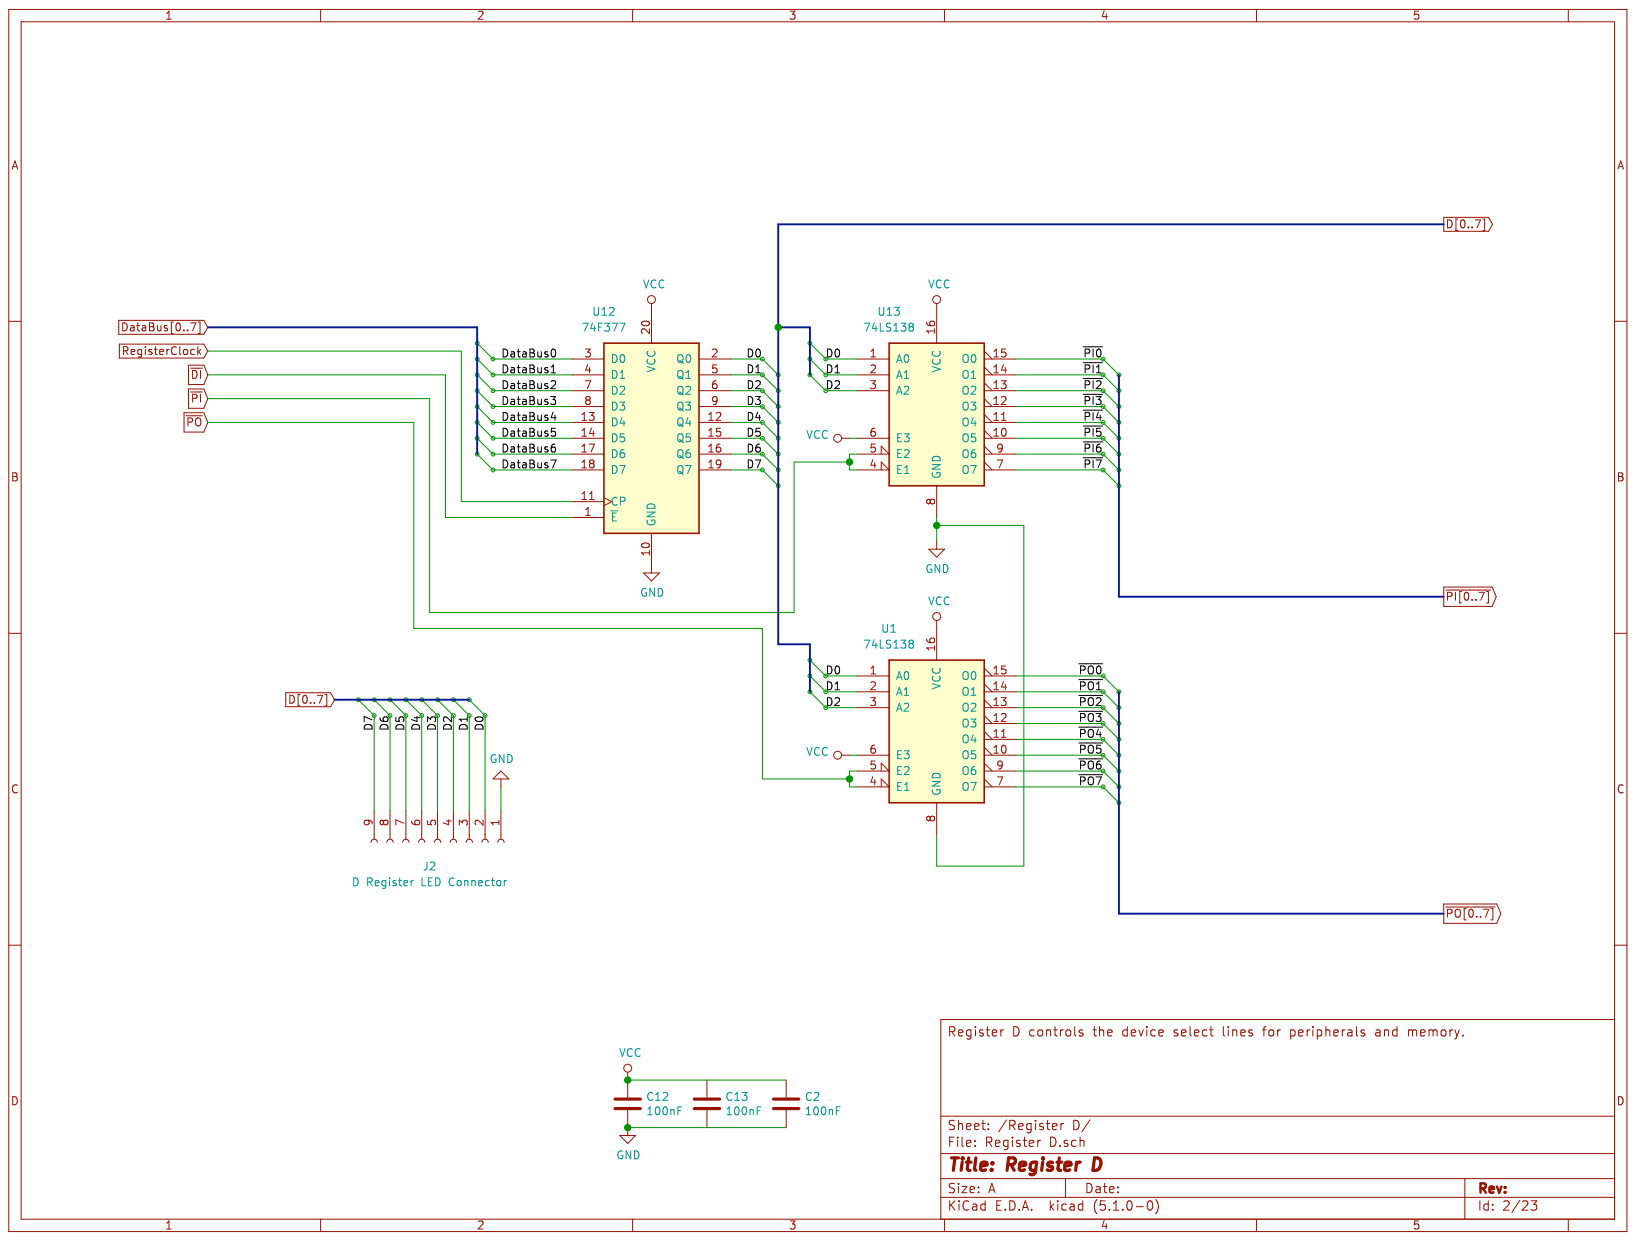
[picture p54: page 2]

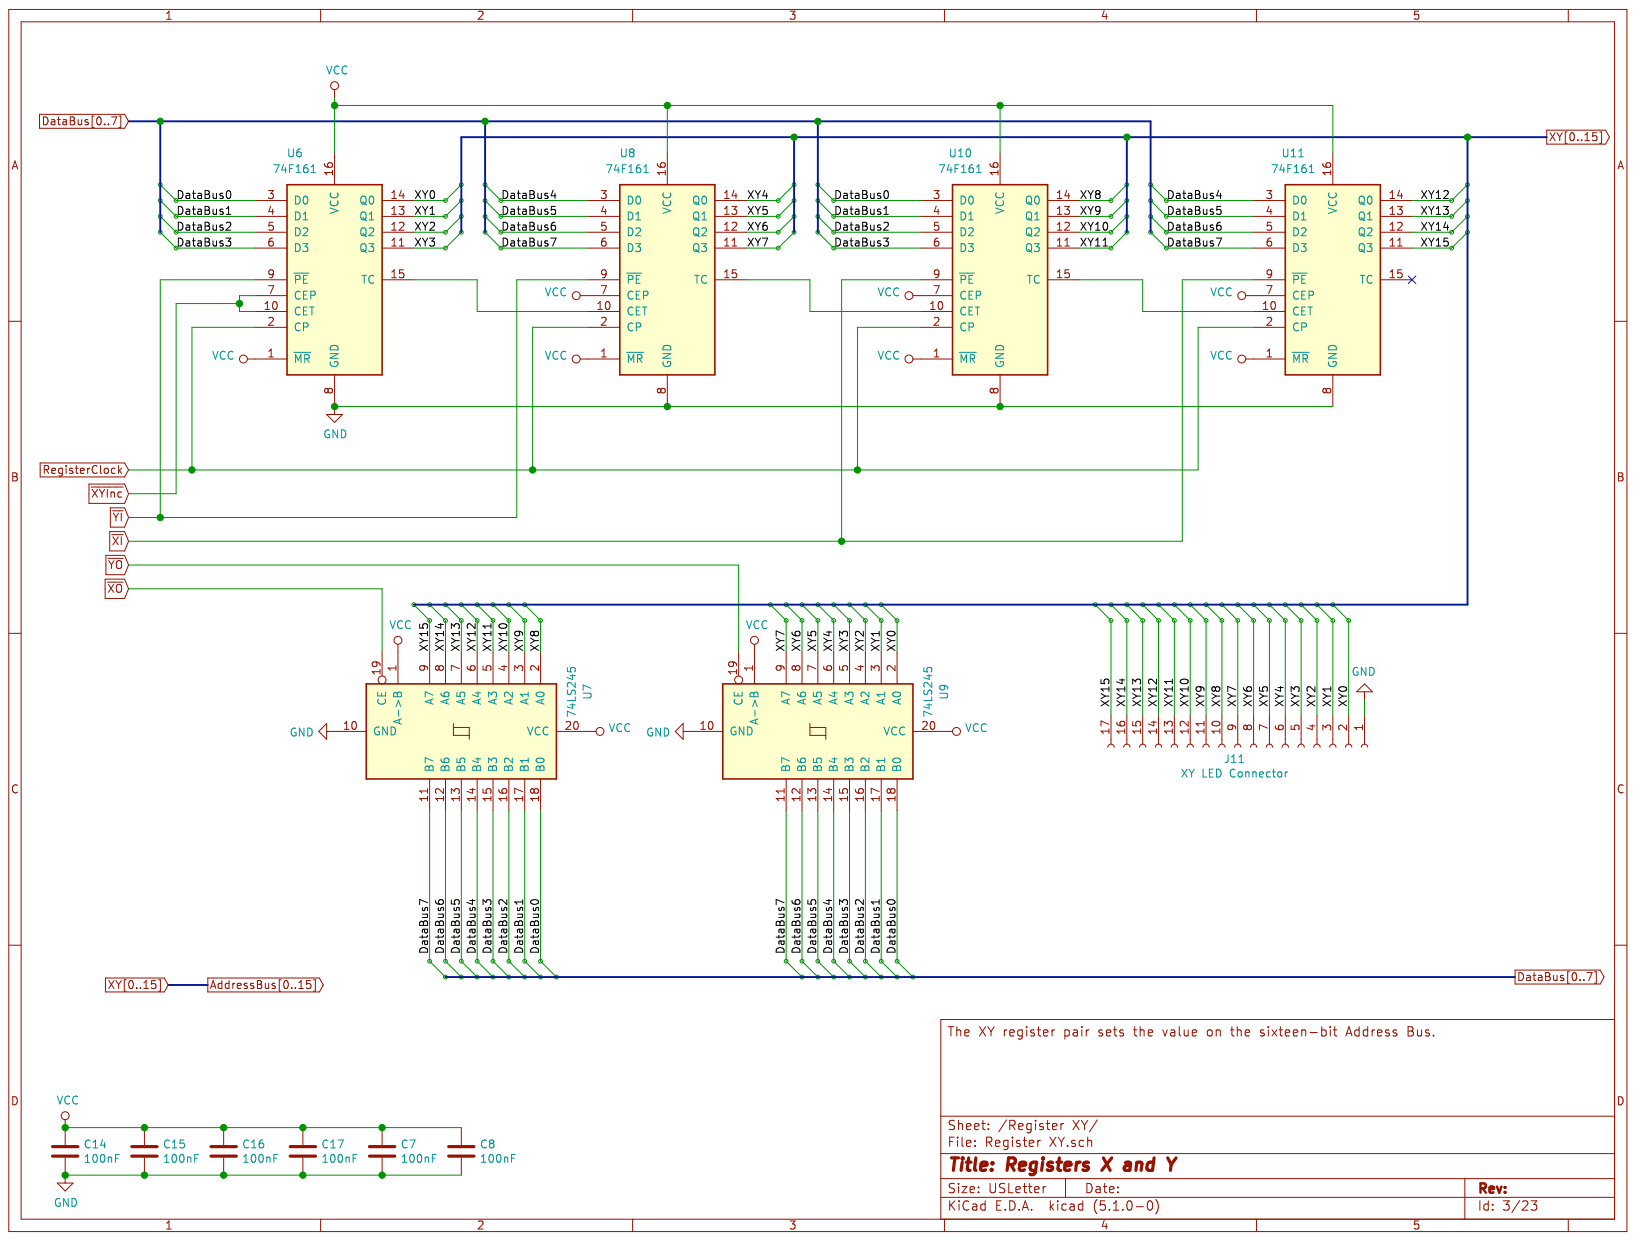
[picture p55: page 3]

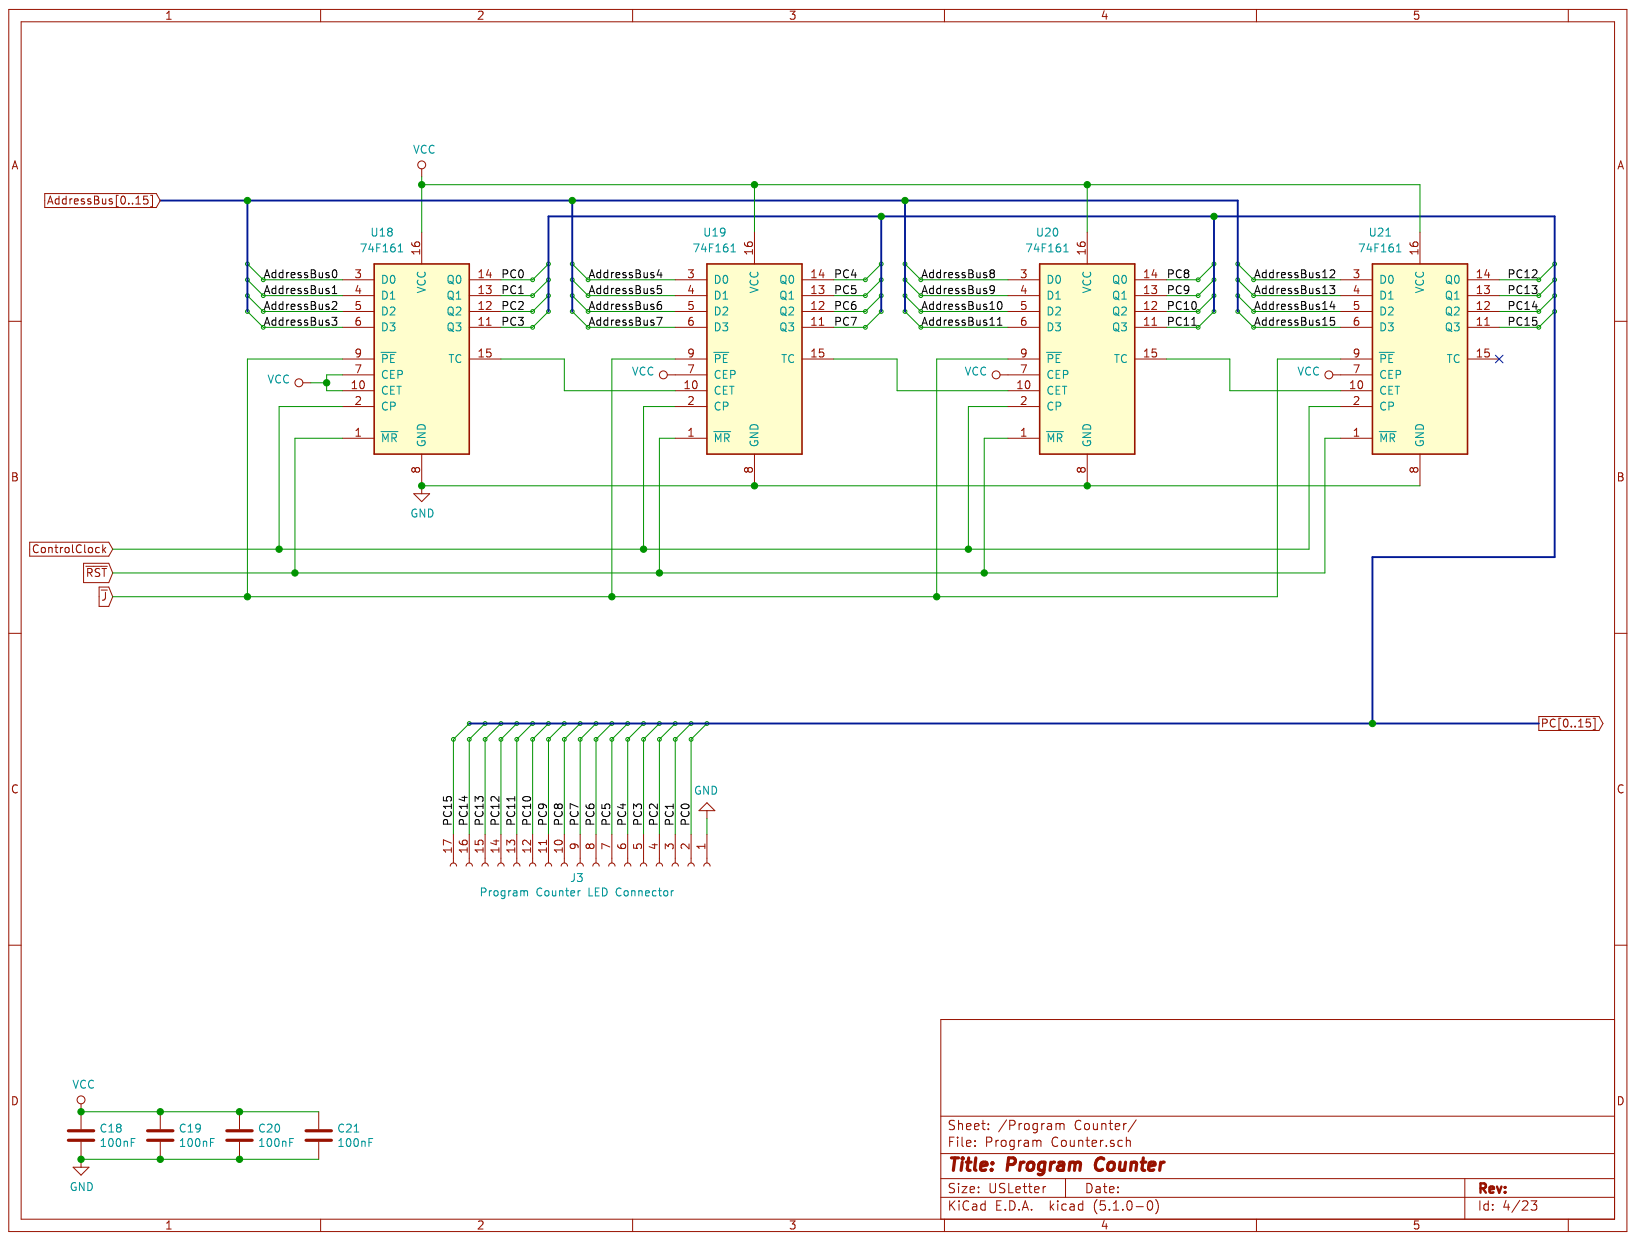
[picture p56: page 4]

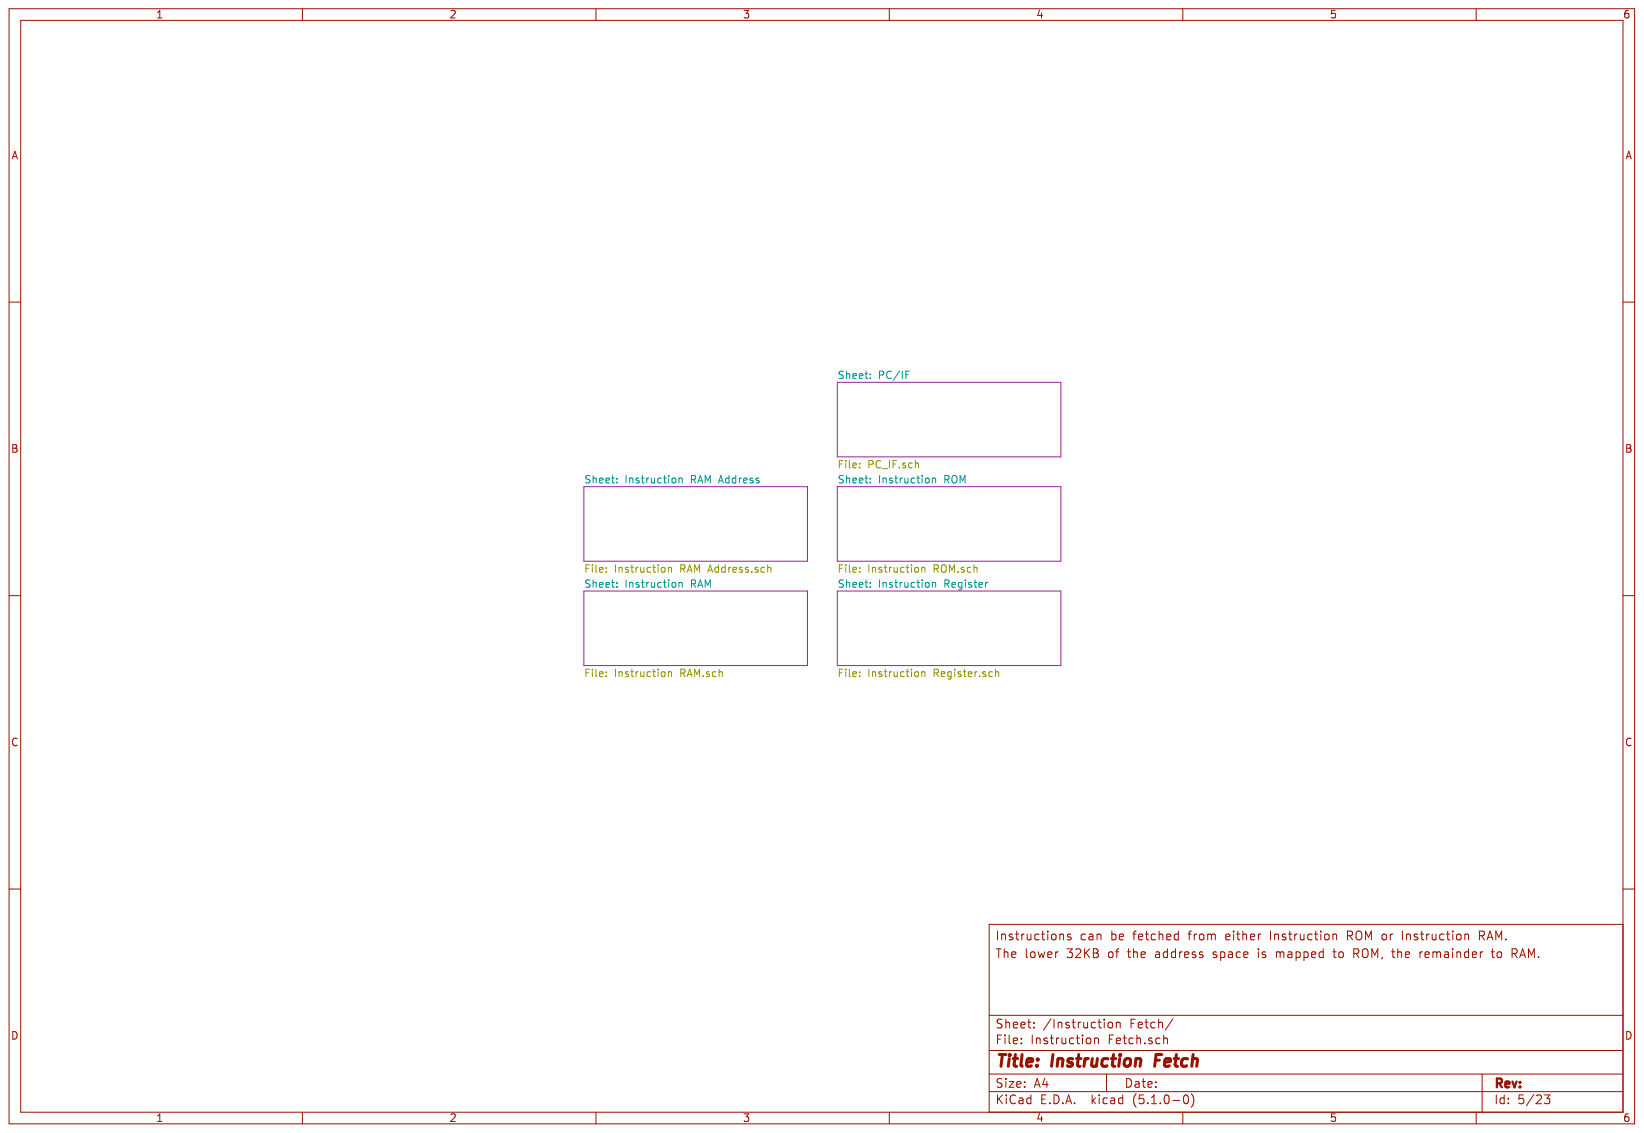
[picture p57: page 5]

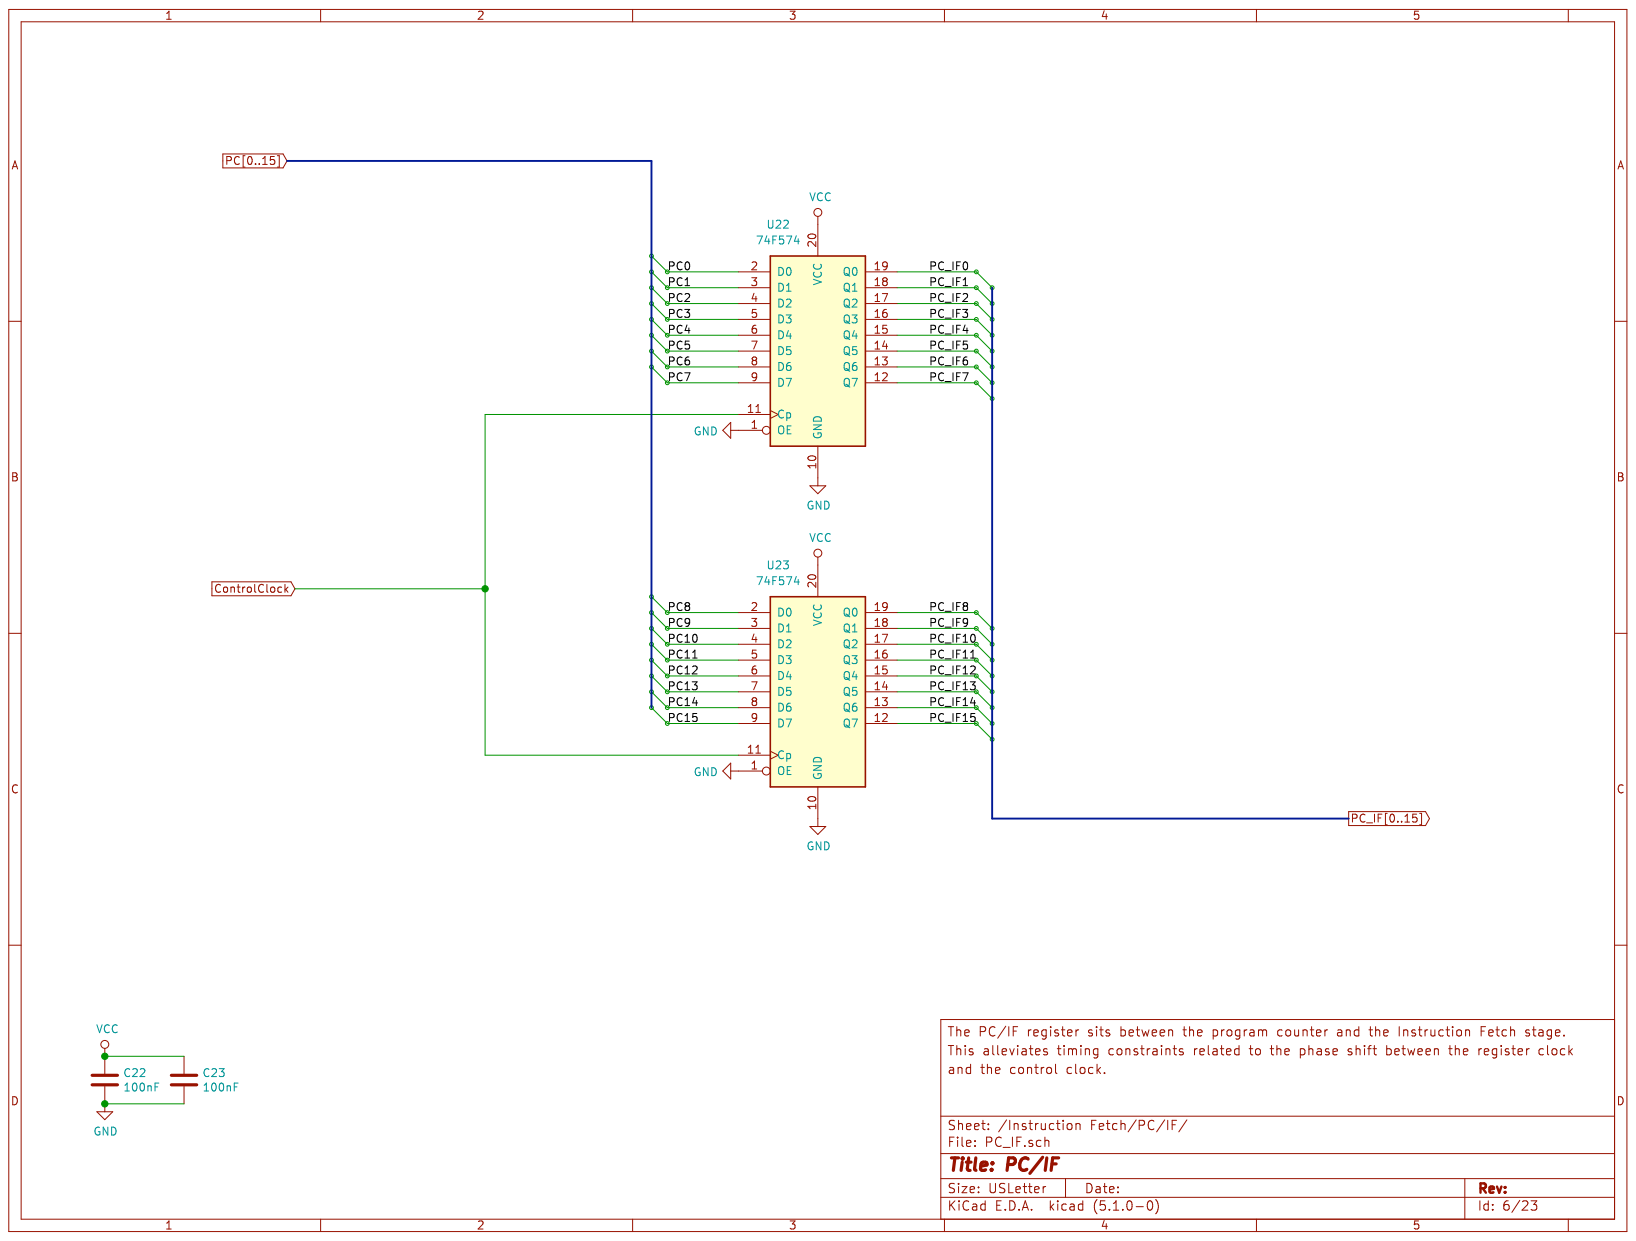
[picture p58: page 6]

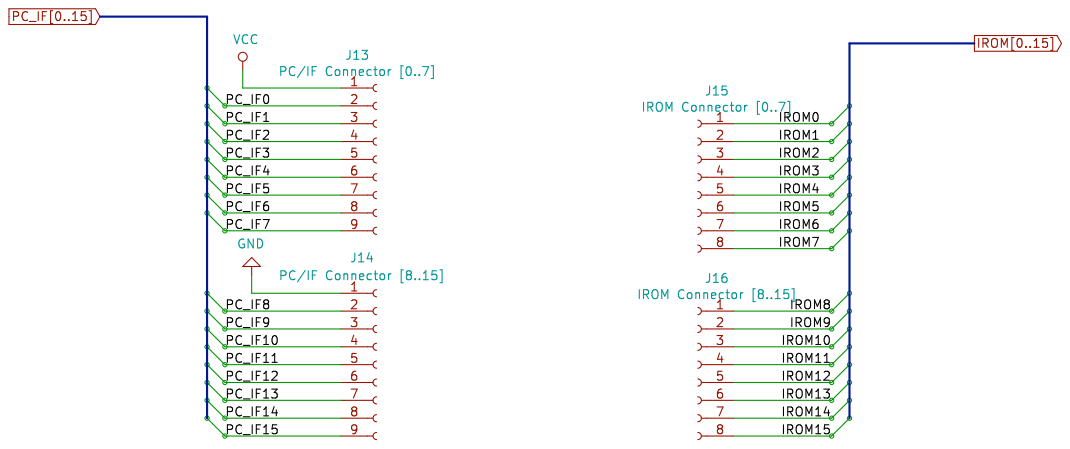
[picture p59: page 7]

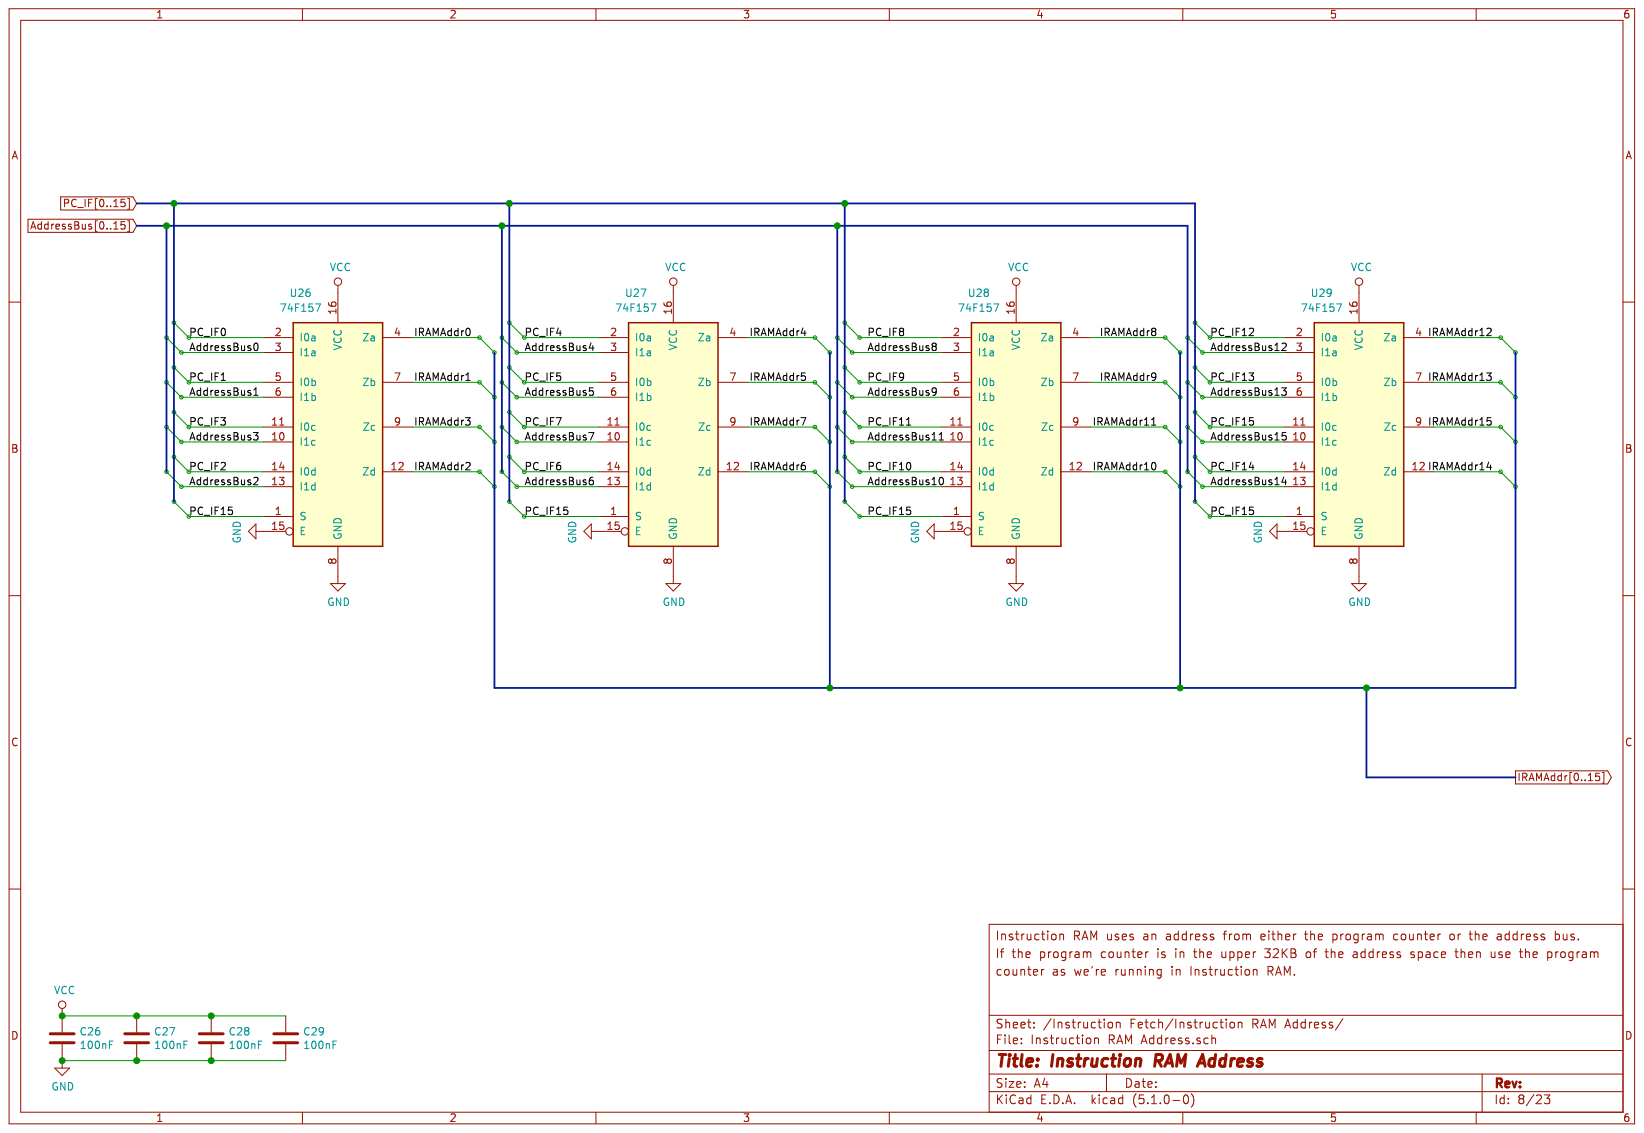
[picture p60: page 8]

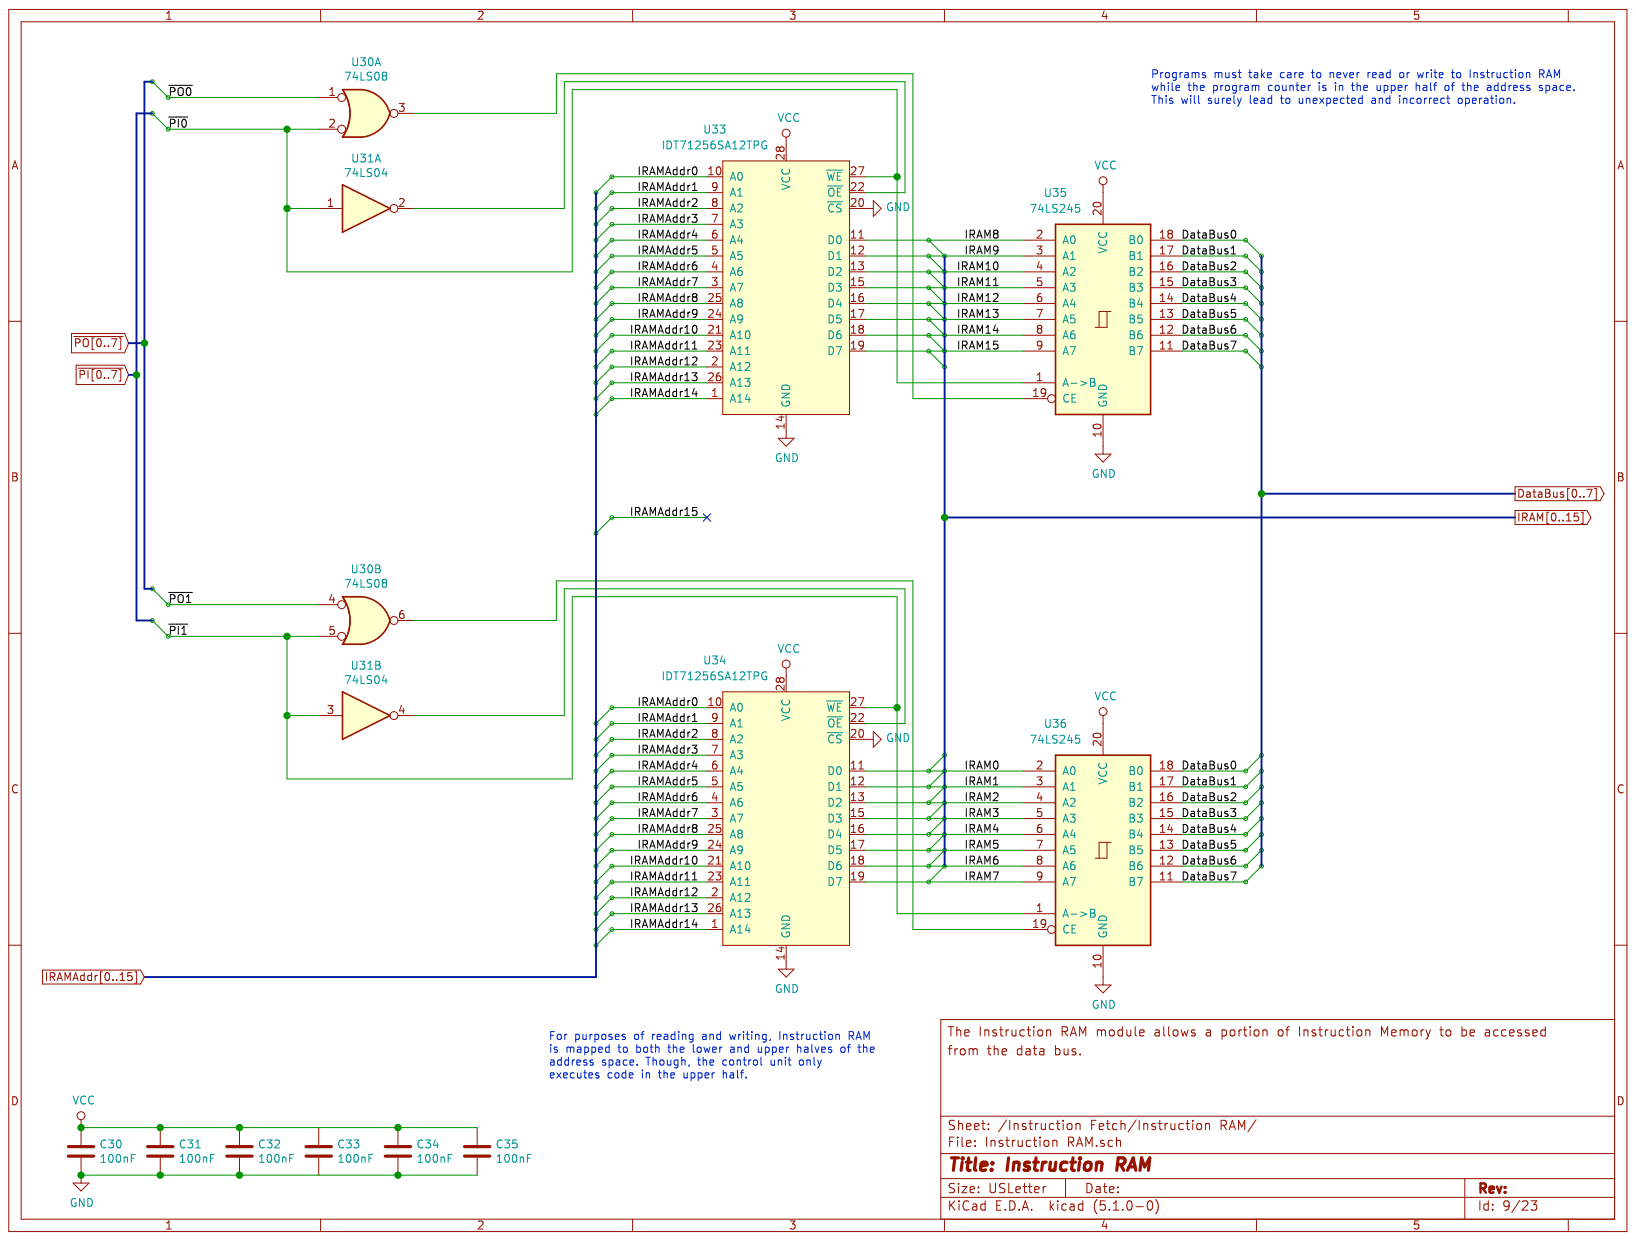
[picture p61: page 9]

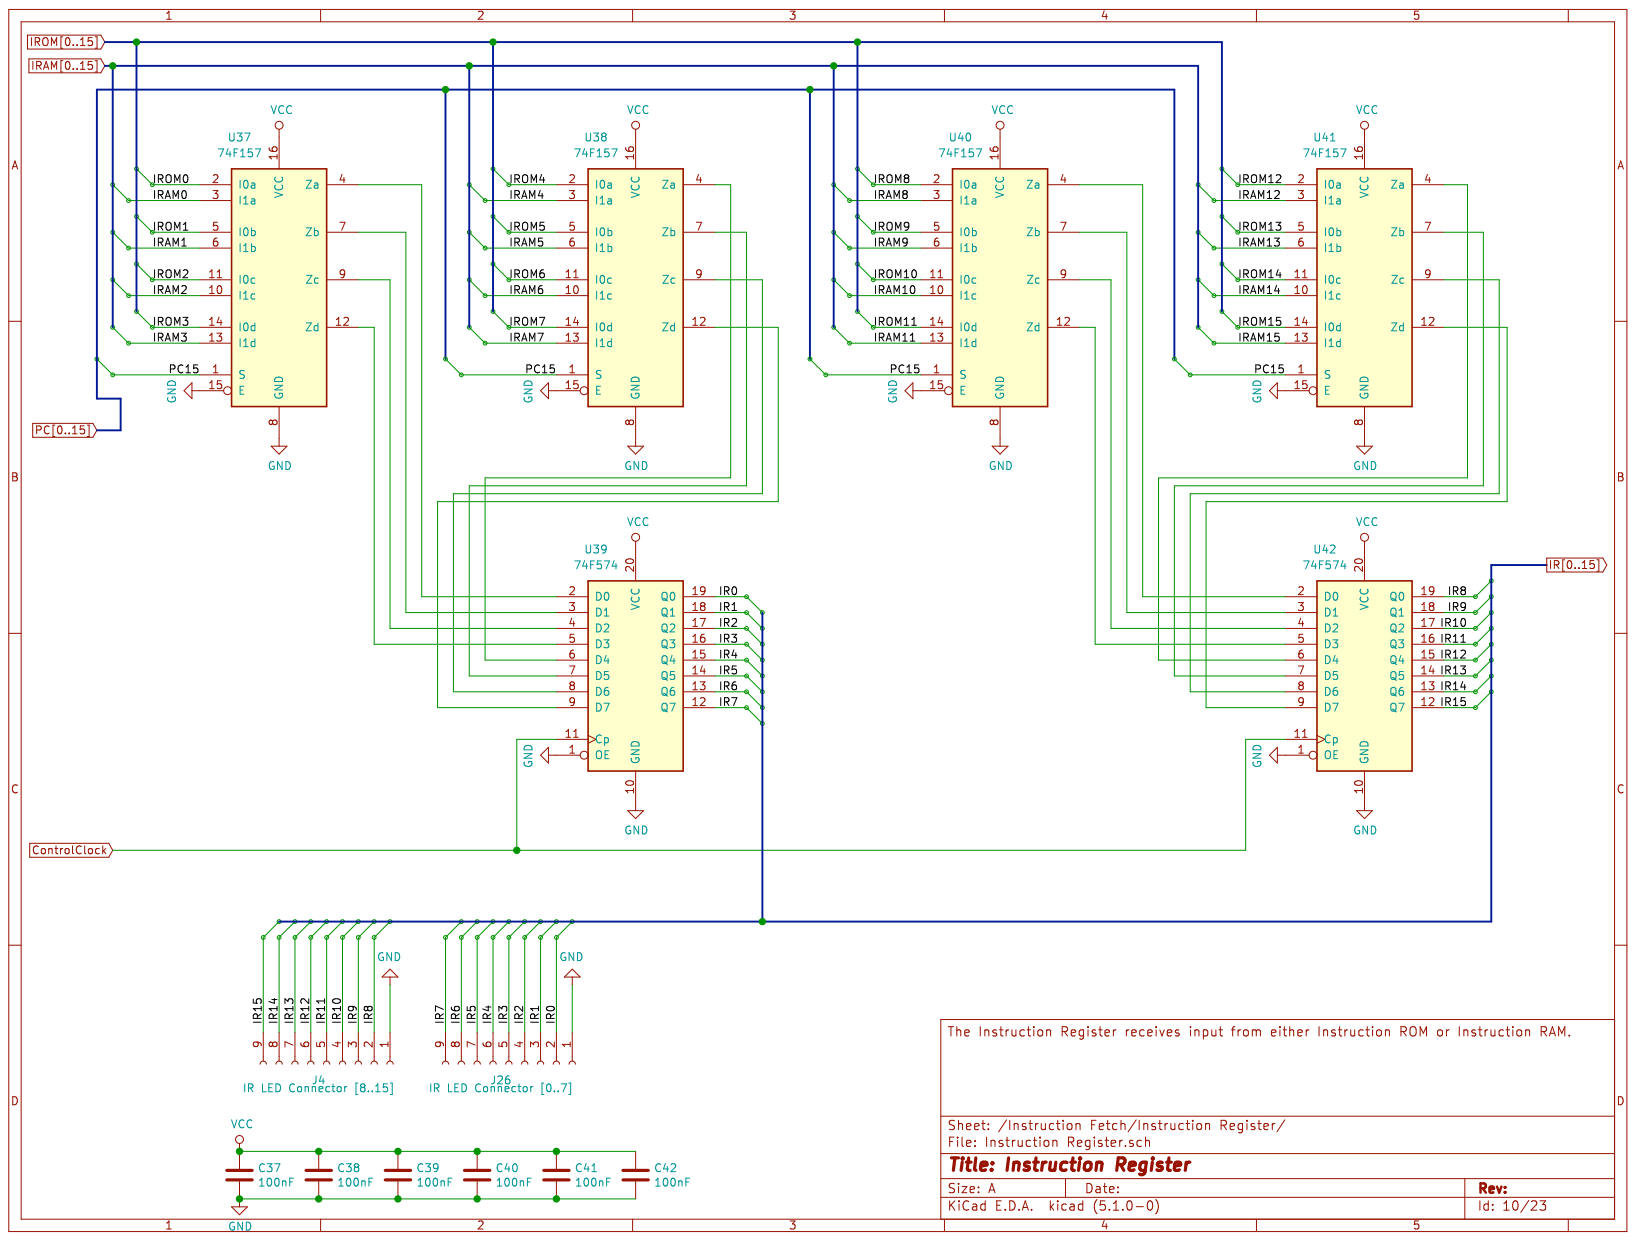
[picture p62: page 10]

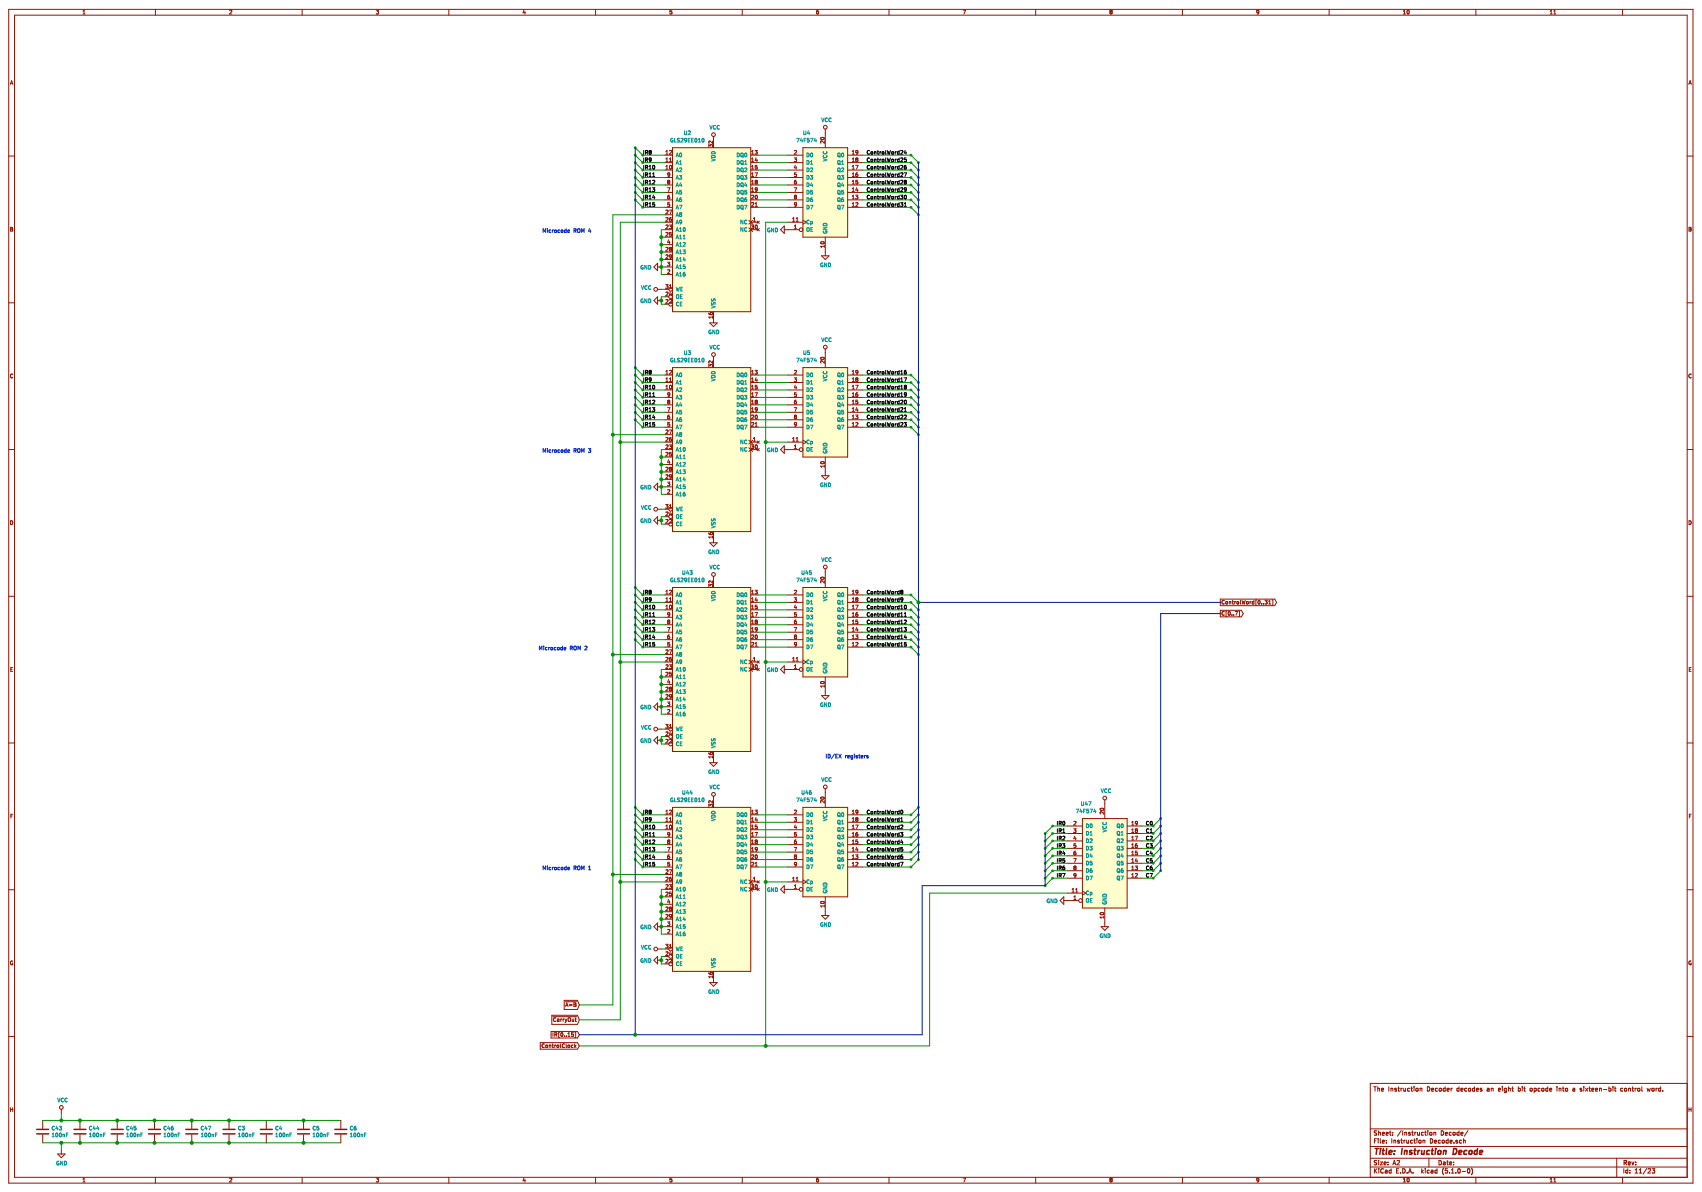
[picture p63: page 11]

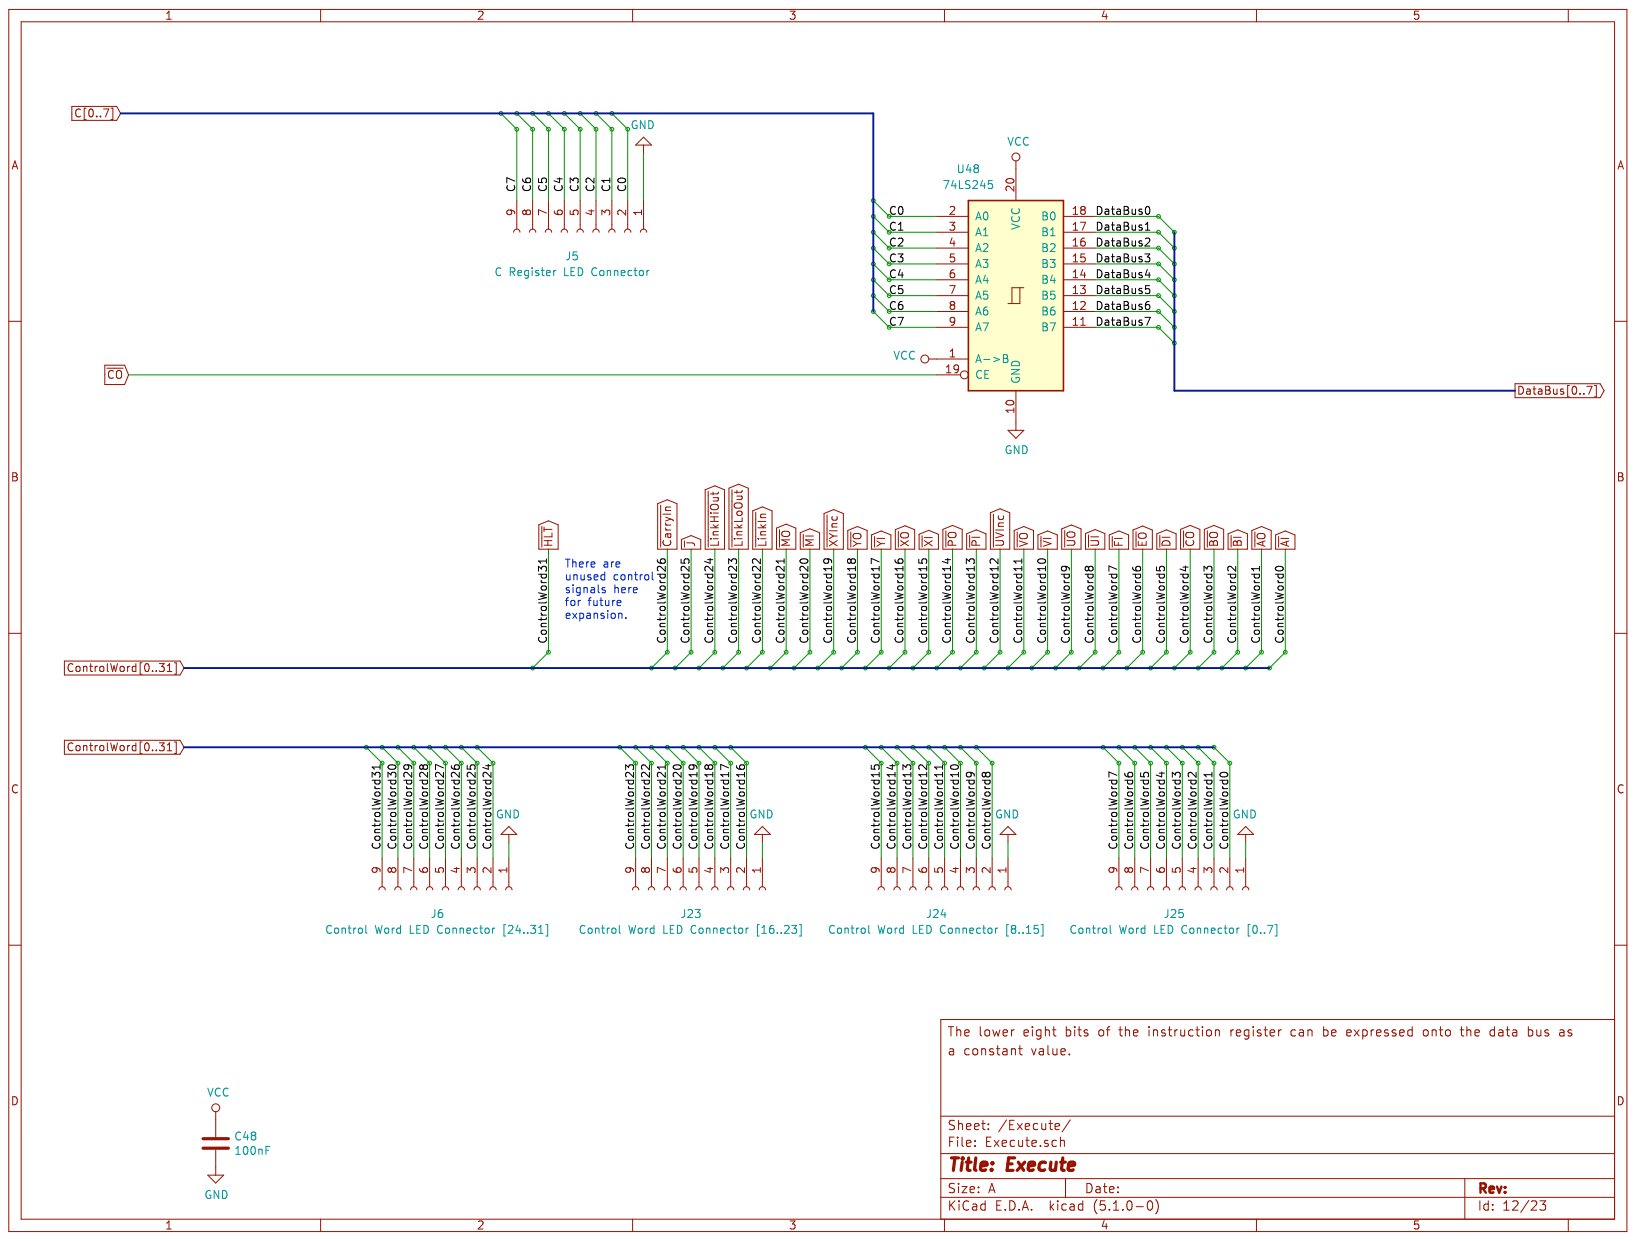
[picture p64: page 12]

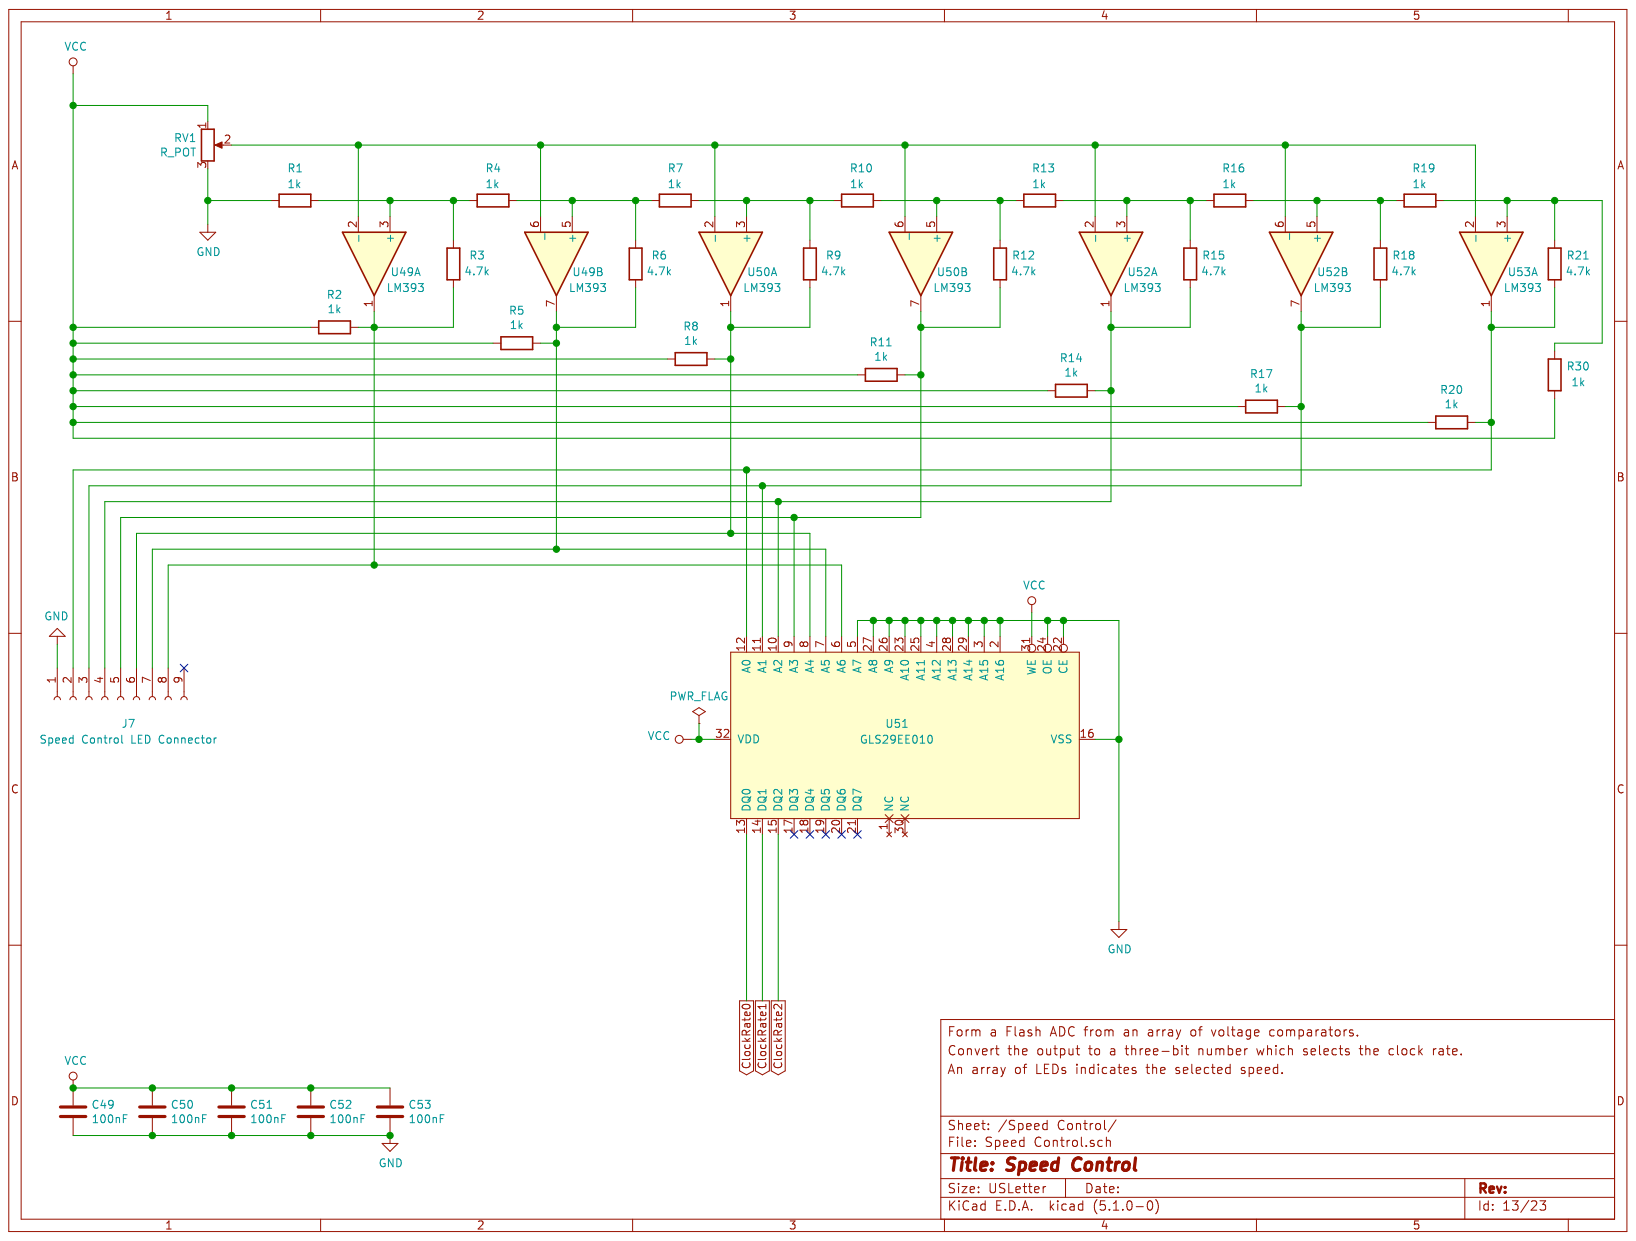
[picture p65: page 13]

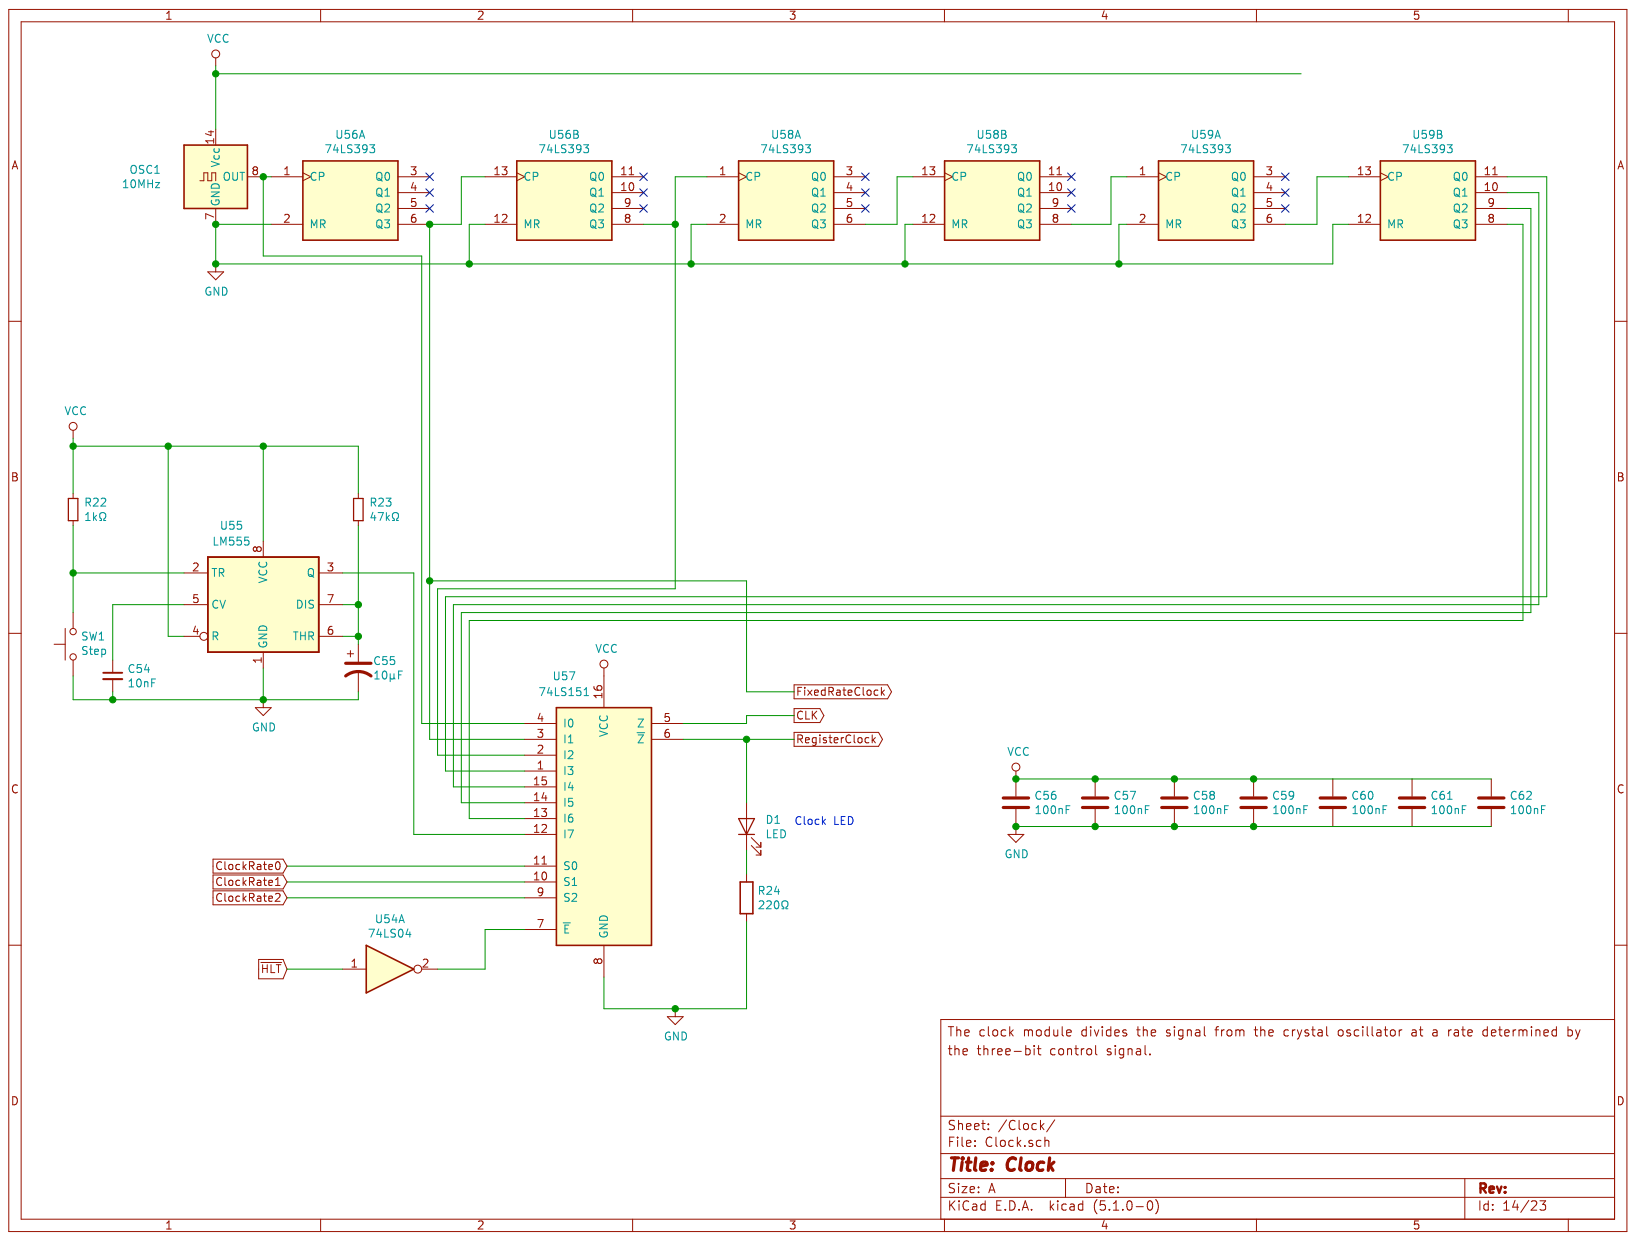
[picture p66: page 14]

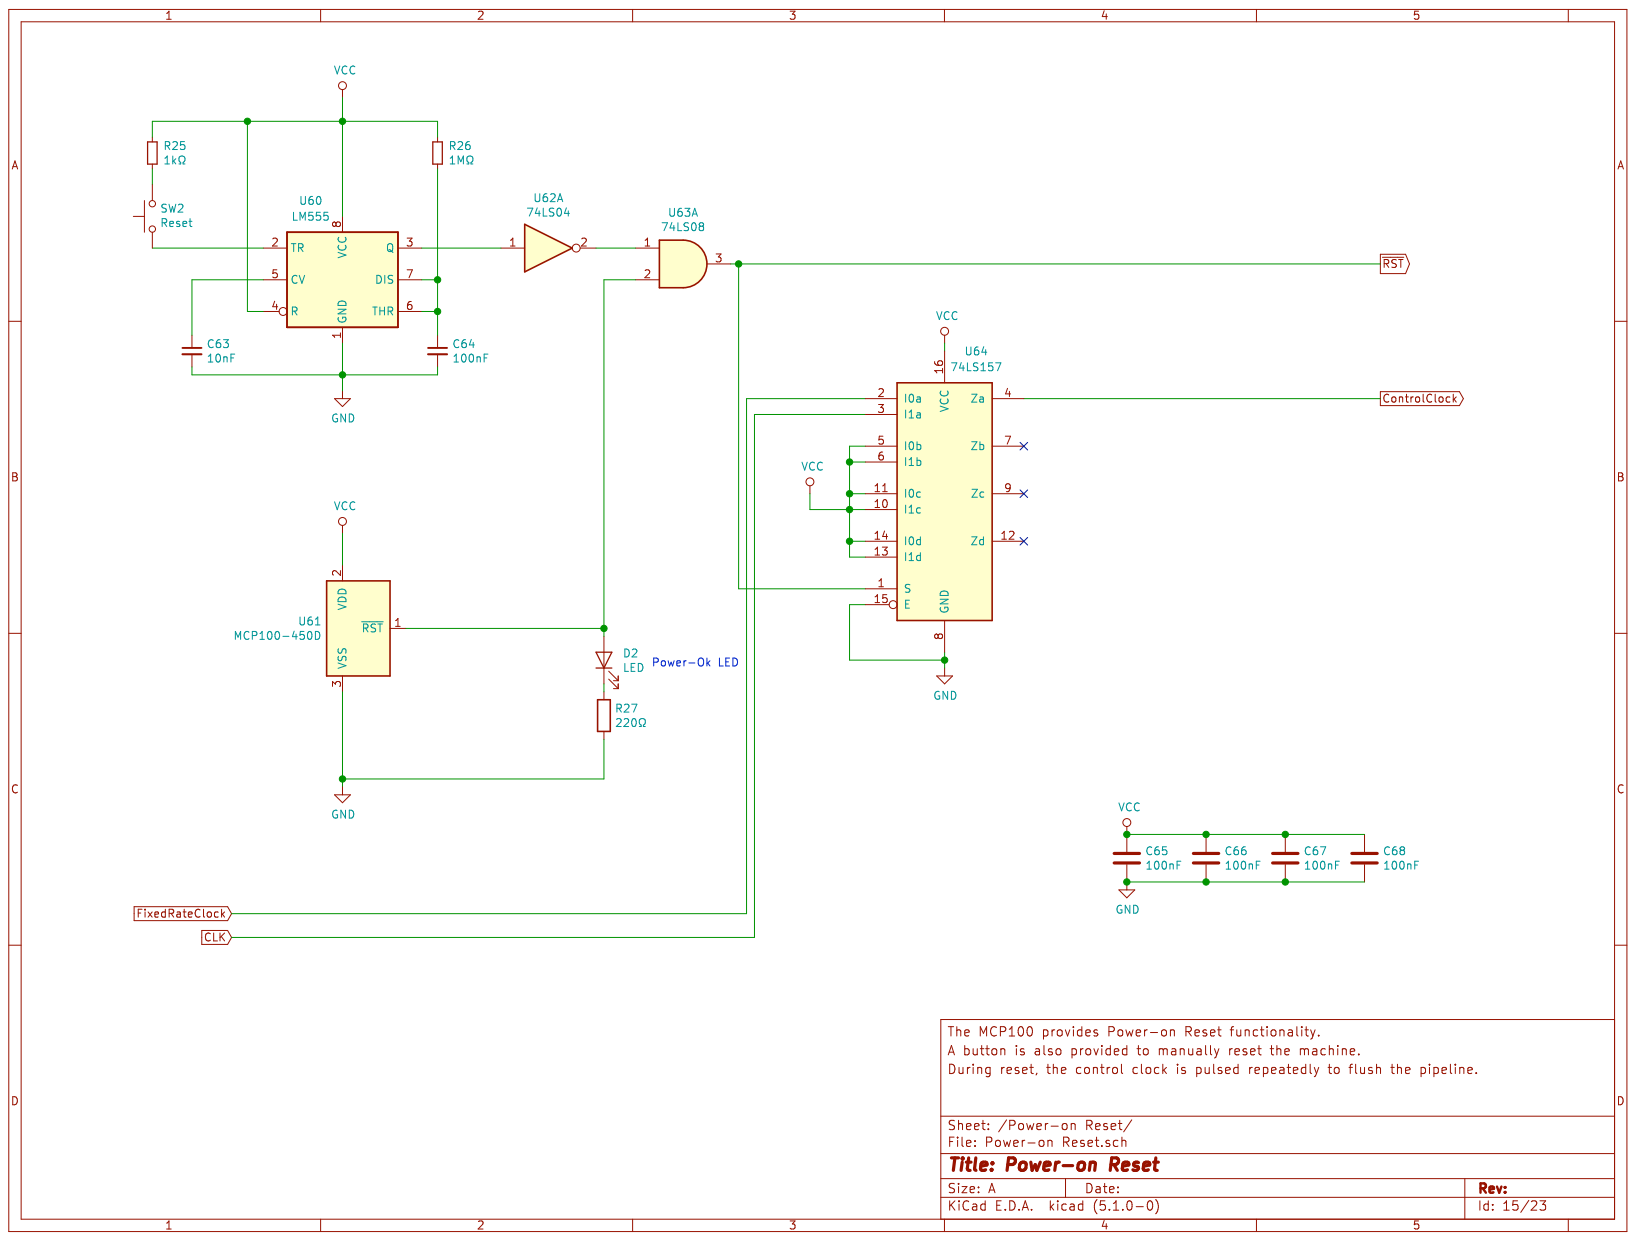
[picture p67: page 15]

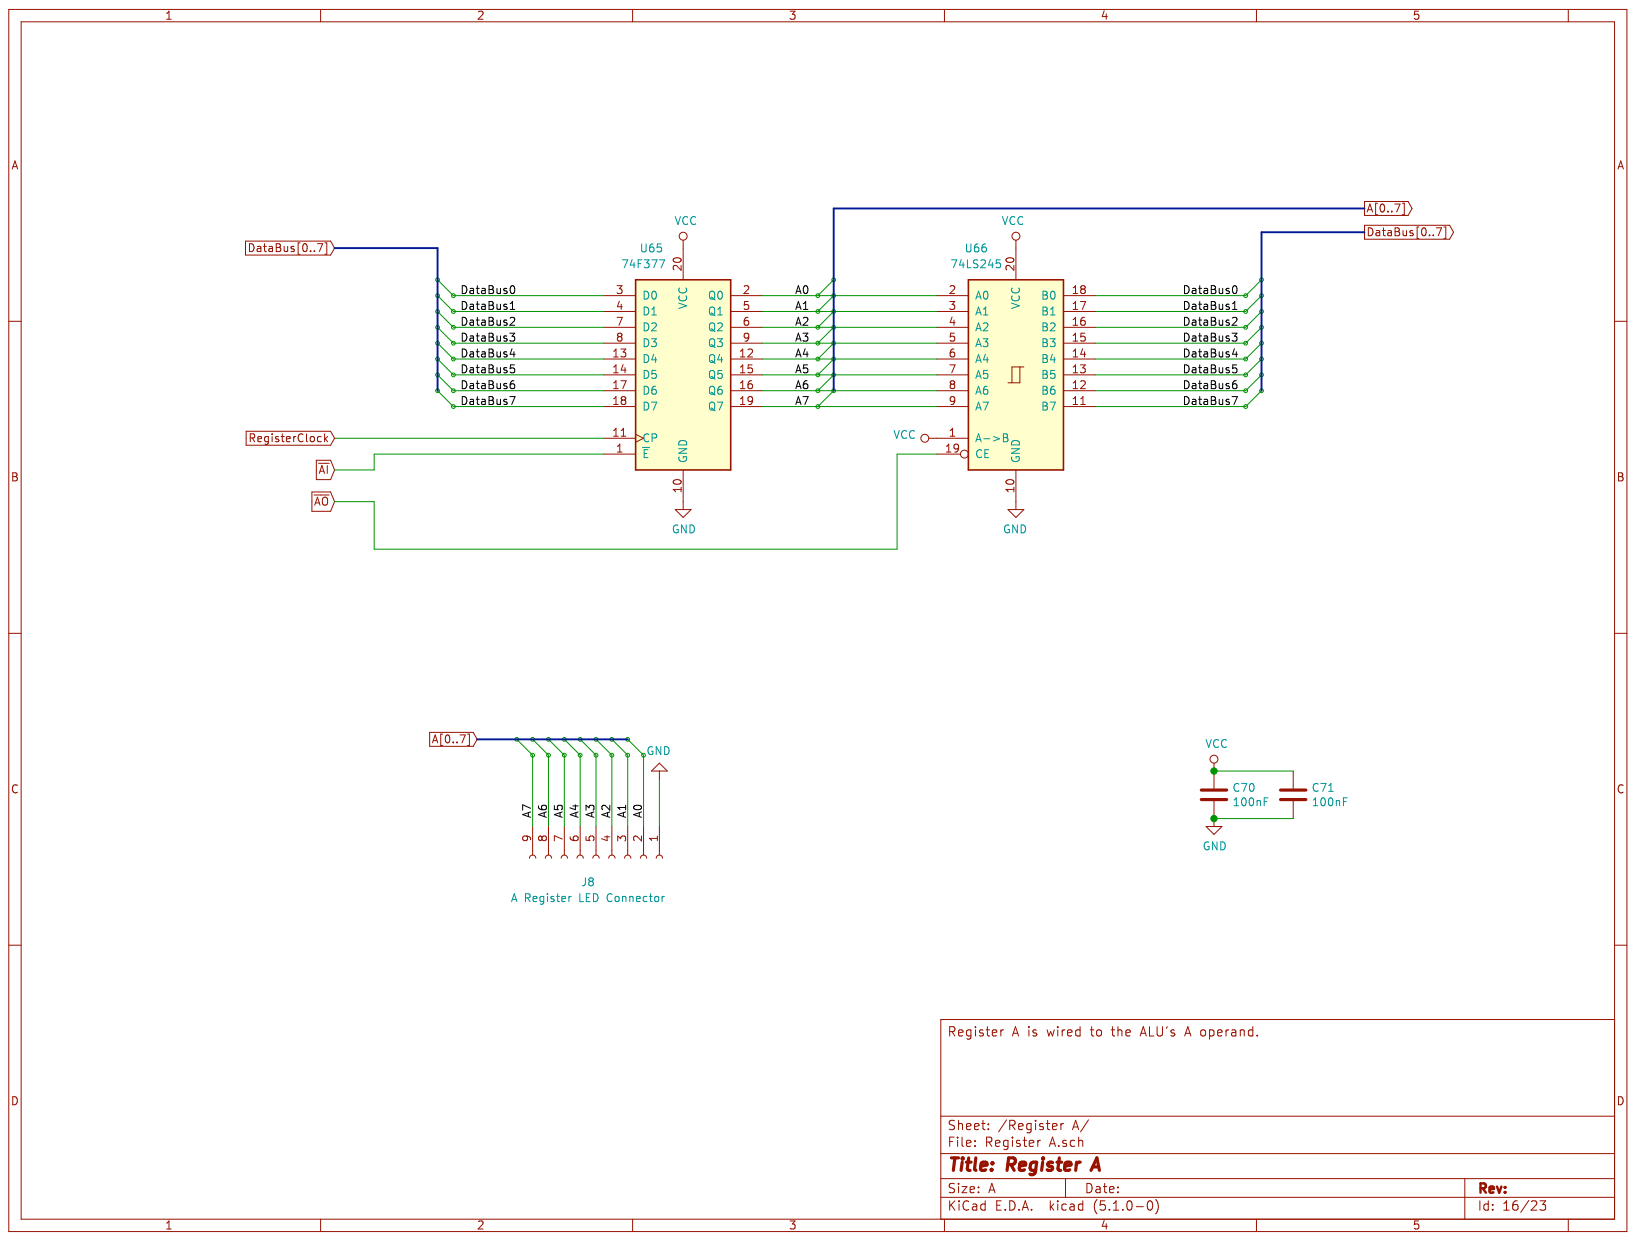
[picture p68: page 16]

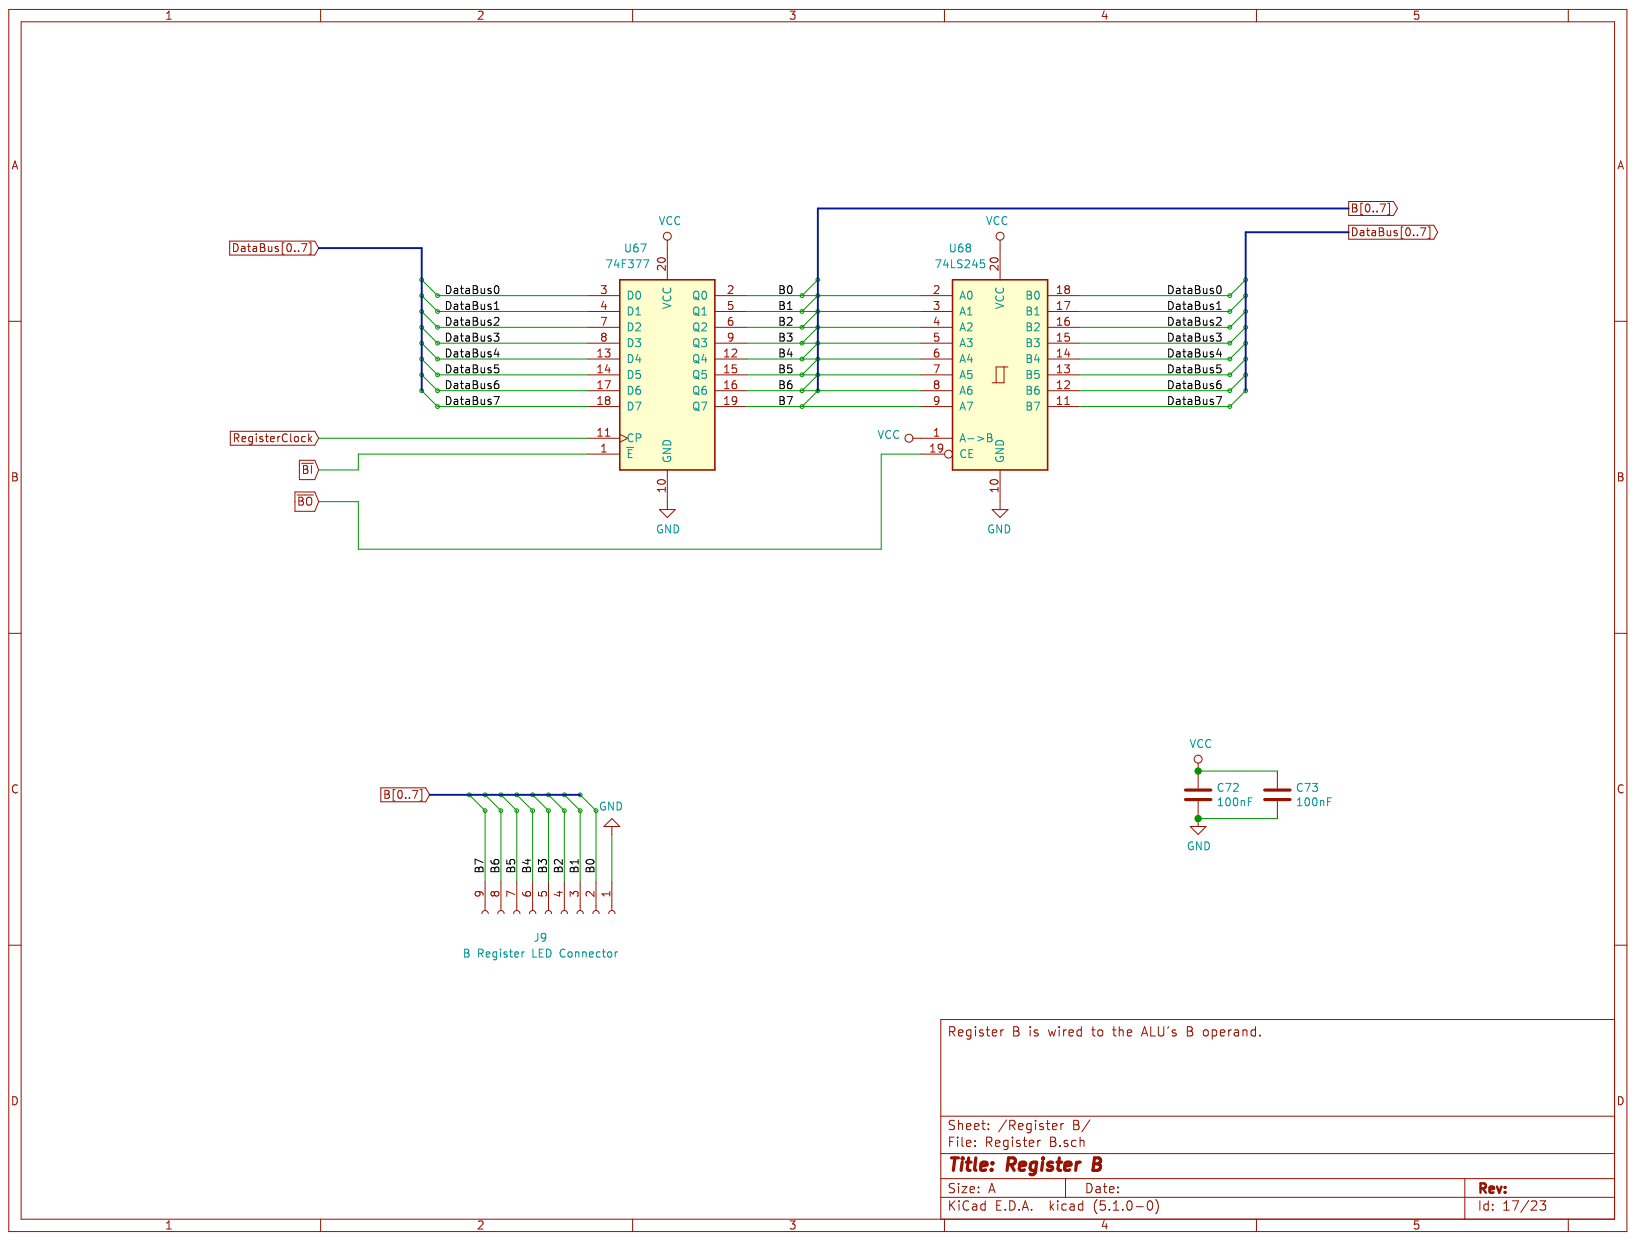
[picture p69: page 17]

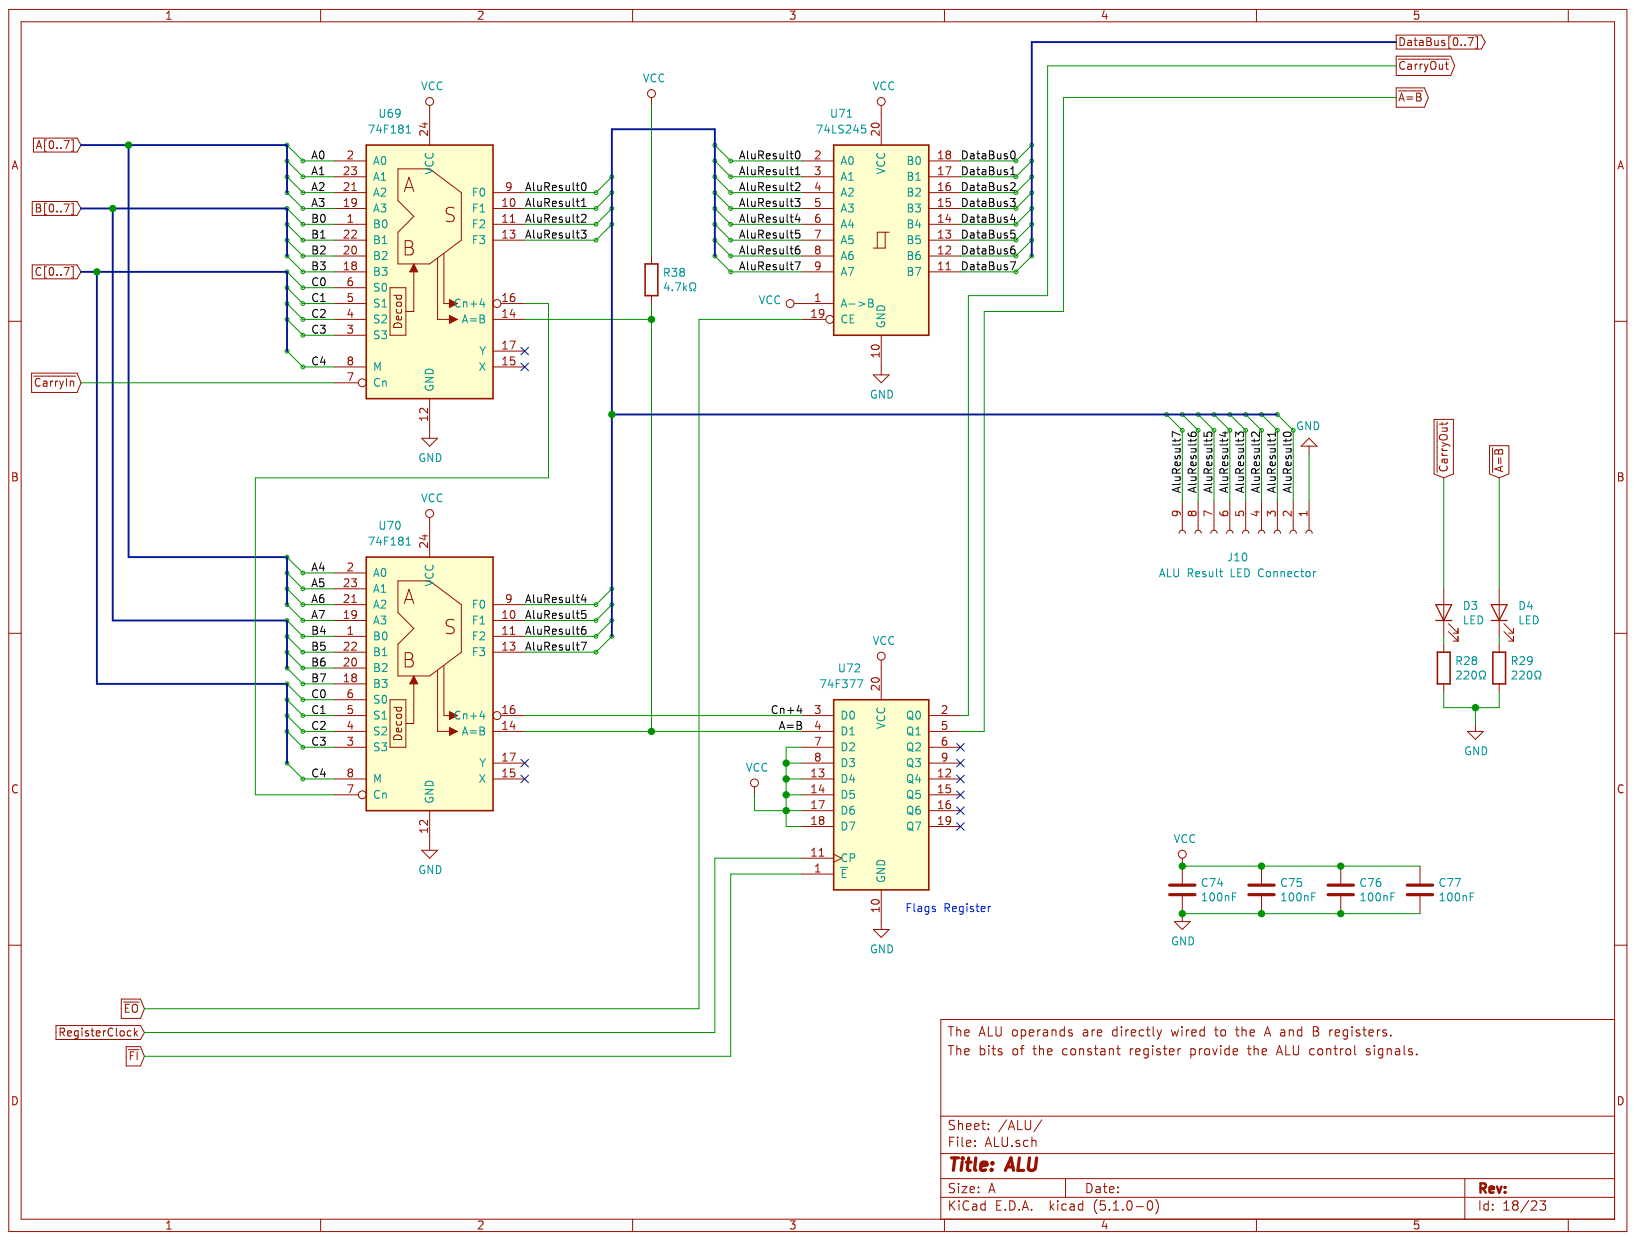
[picture p70: page 18]

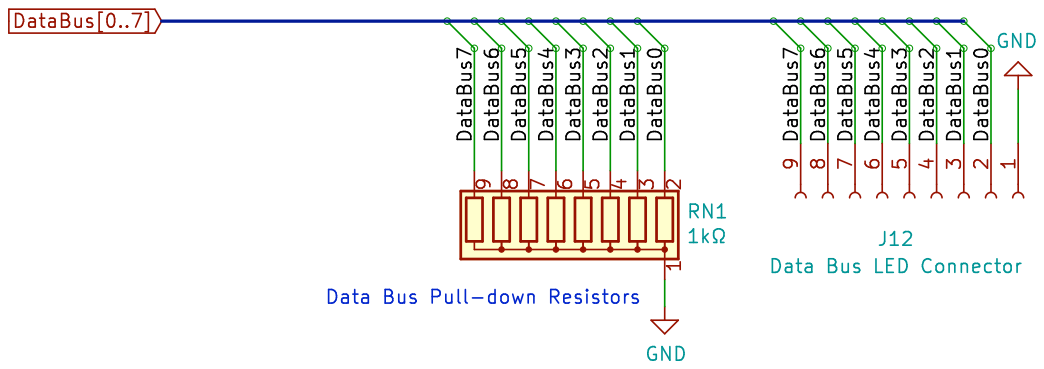
[picture p71: page 19]

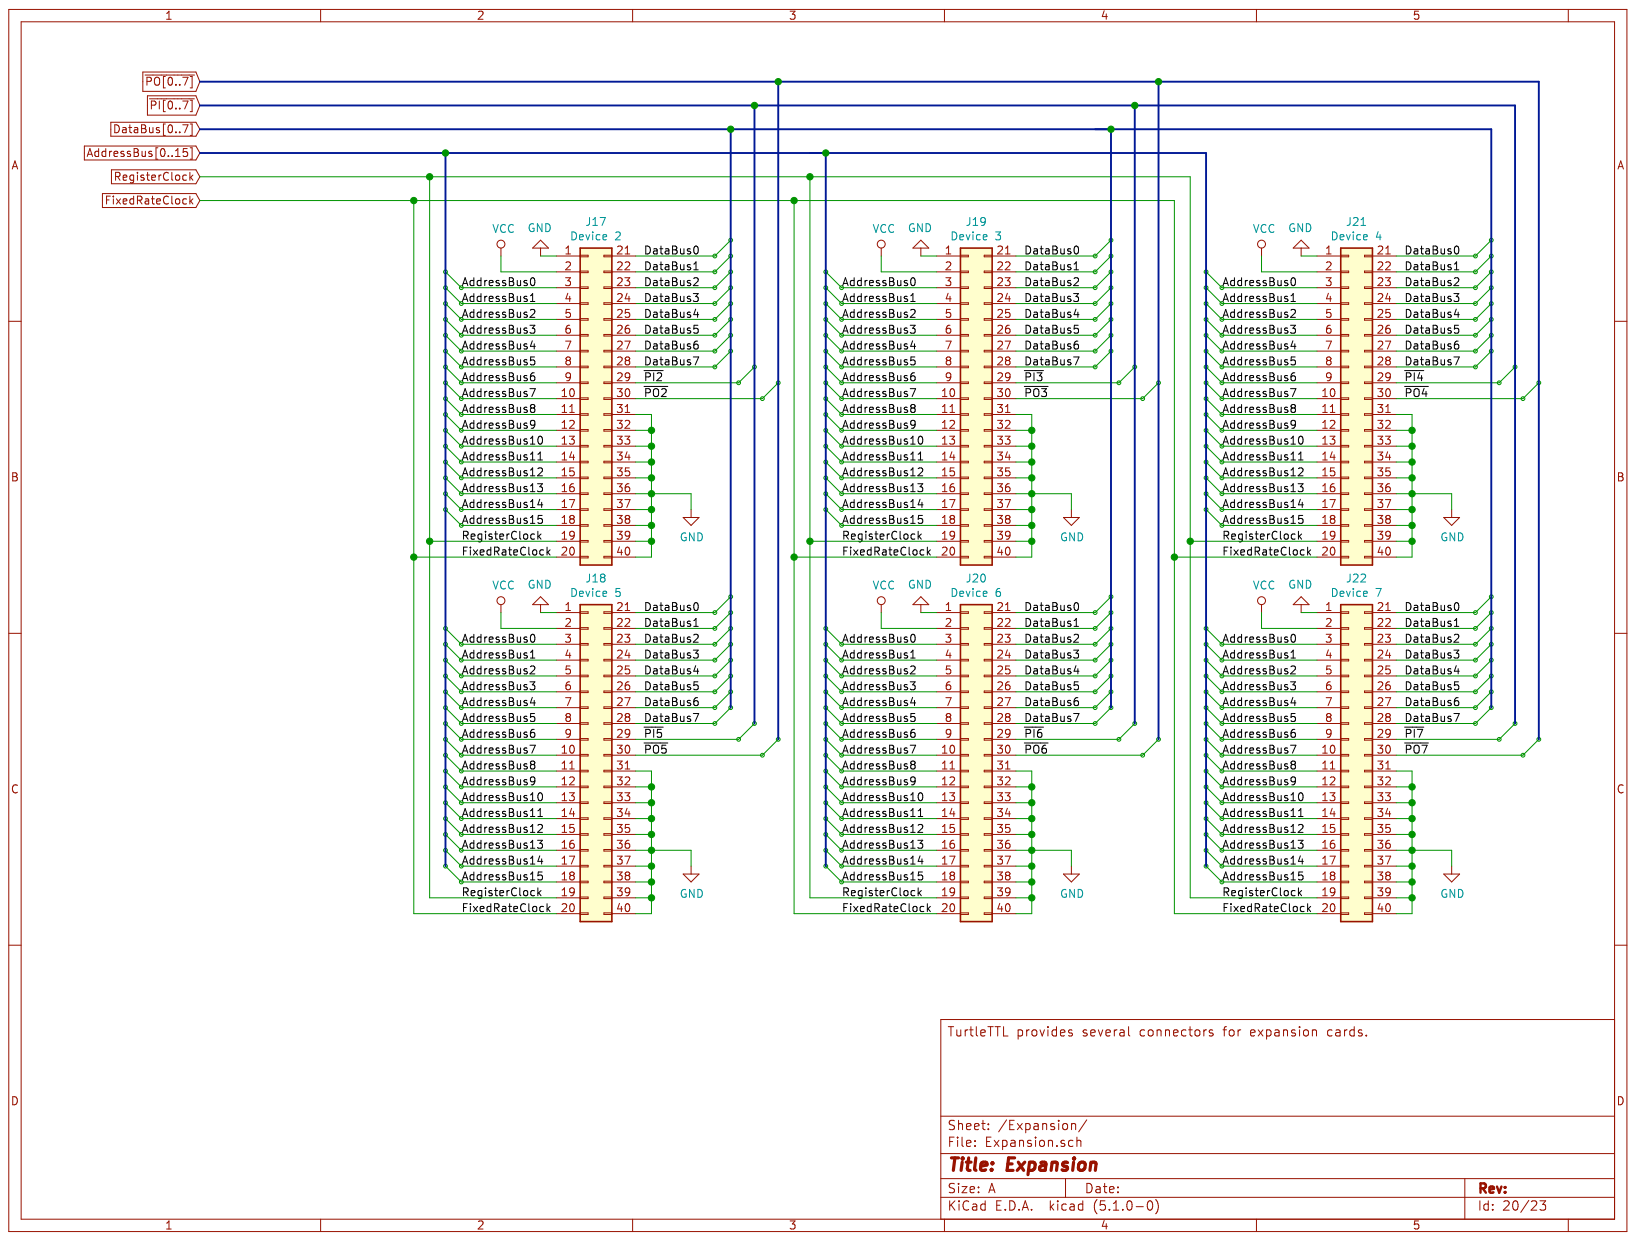
[picture p72: page 20]

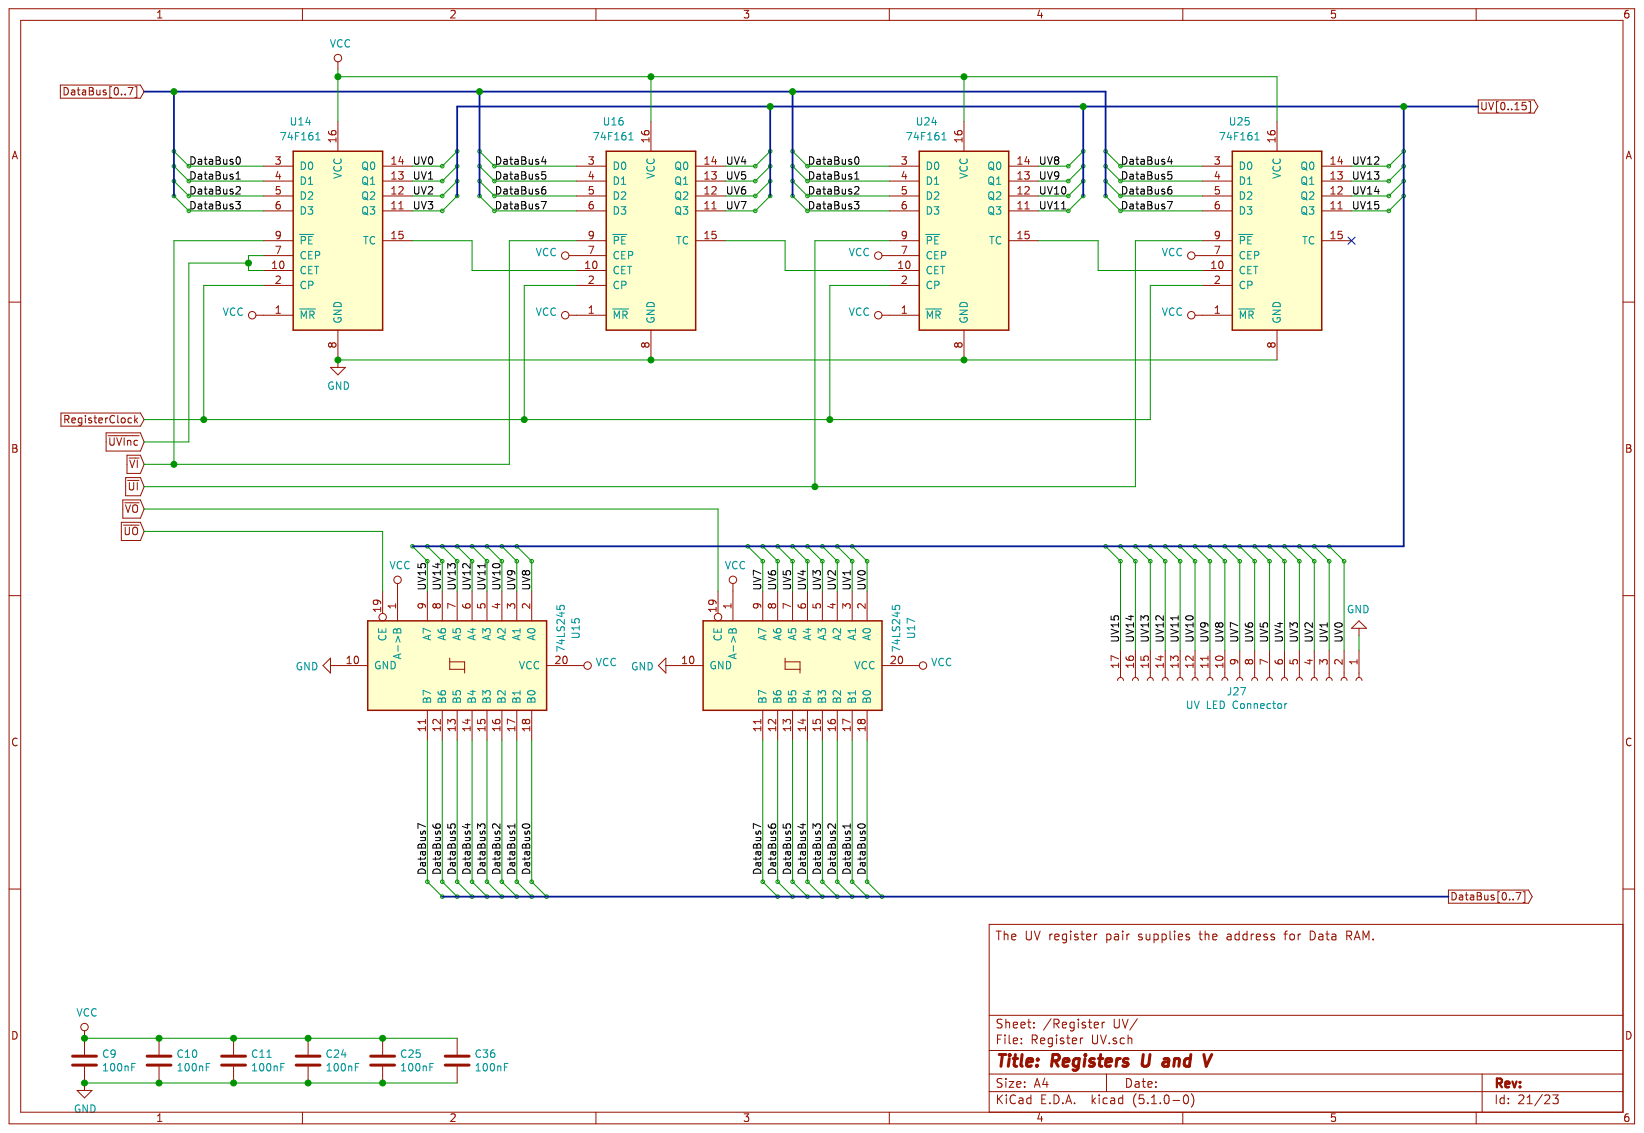
[picture p73: page 21]

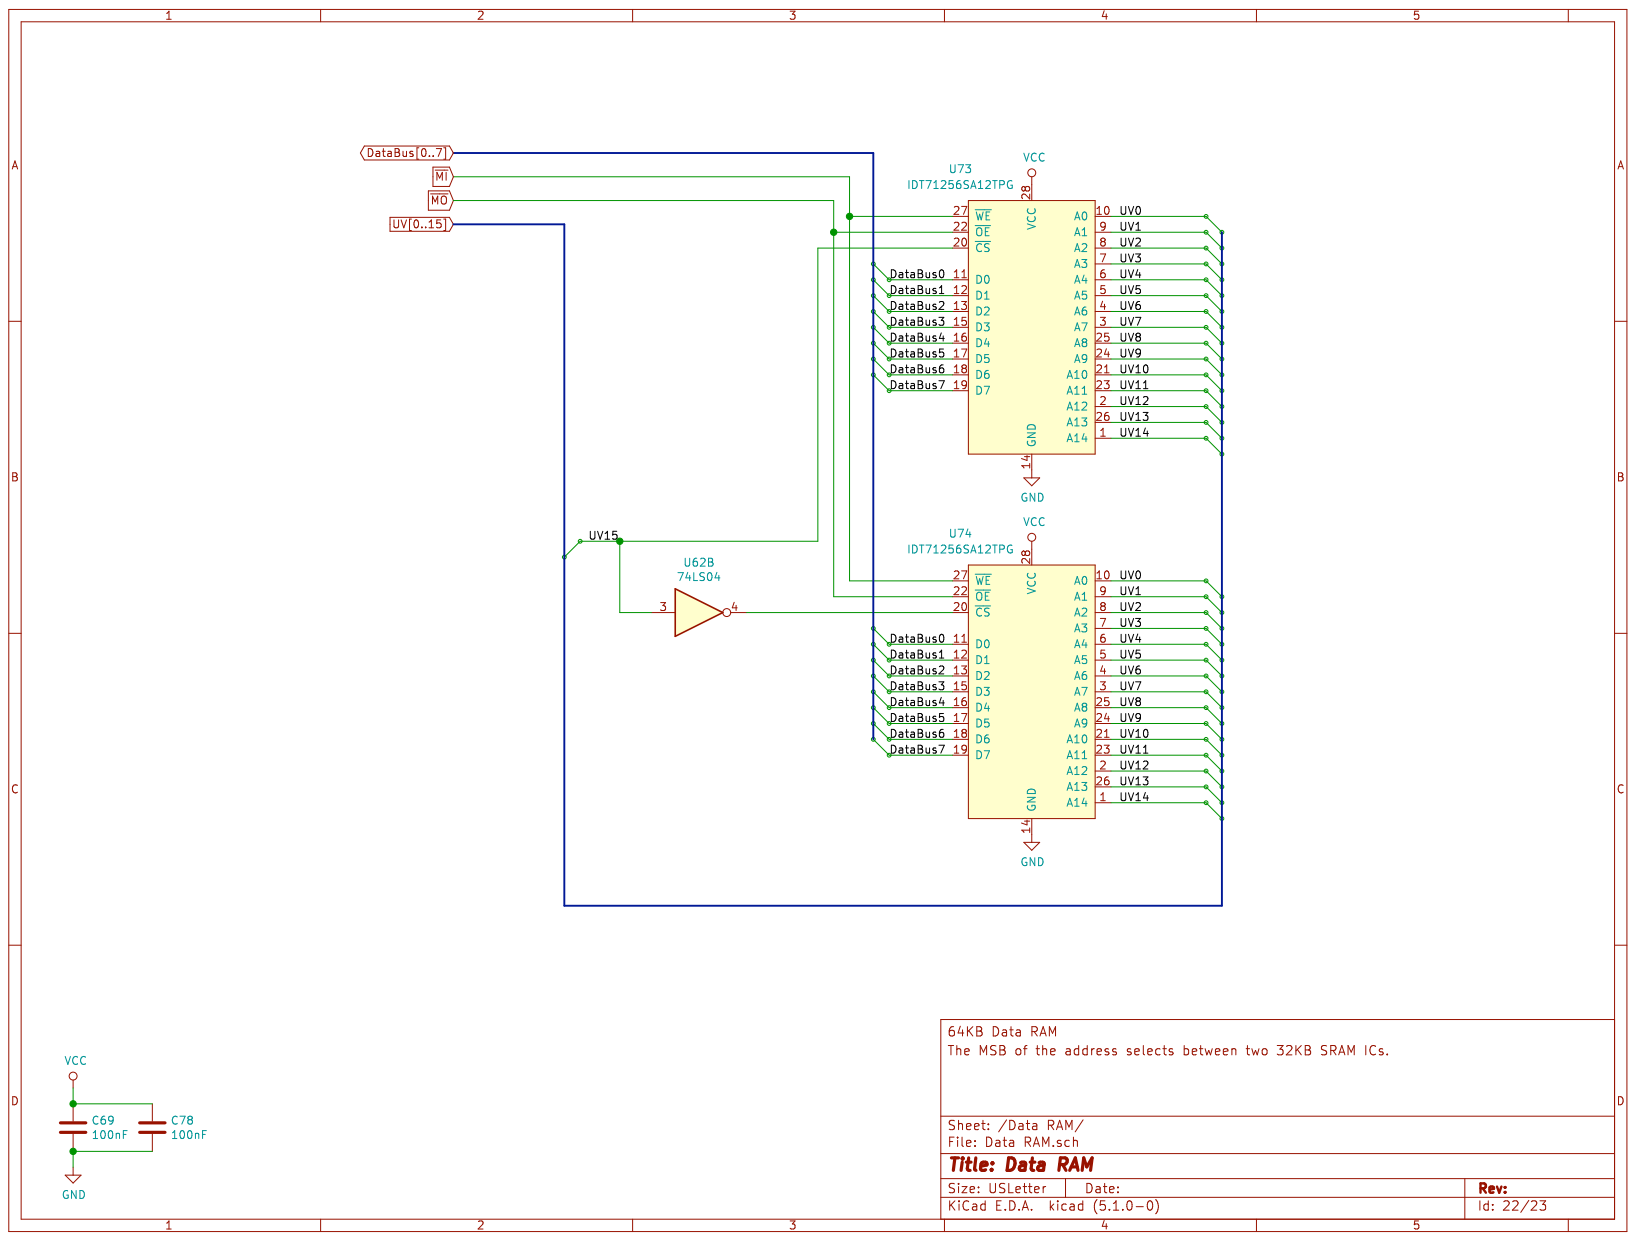
[picture p74: page 22]

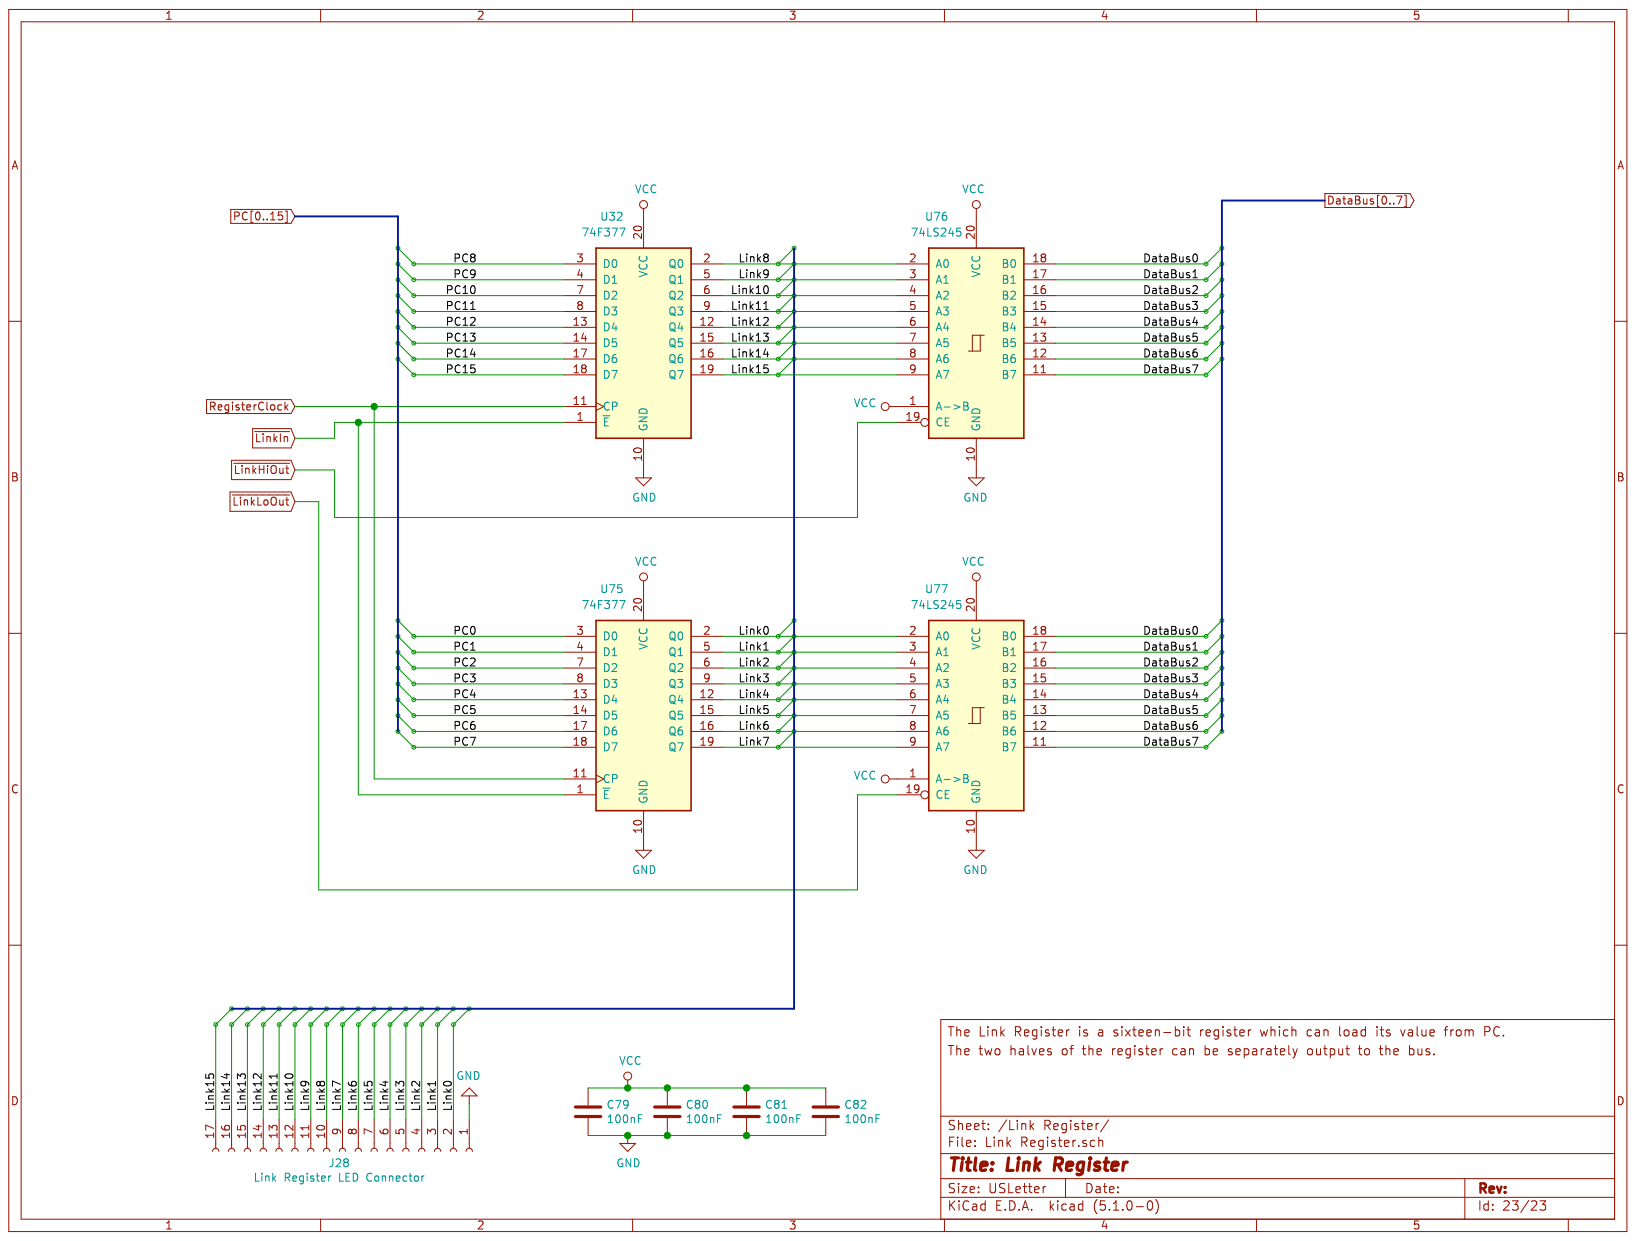
[picture p75: page 23]
