foxostro/TurtleTTL/Schematics/Version1/Generated/PCB PDFs/InstructionROMDaughterBoard_PCB.pdf

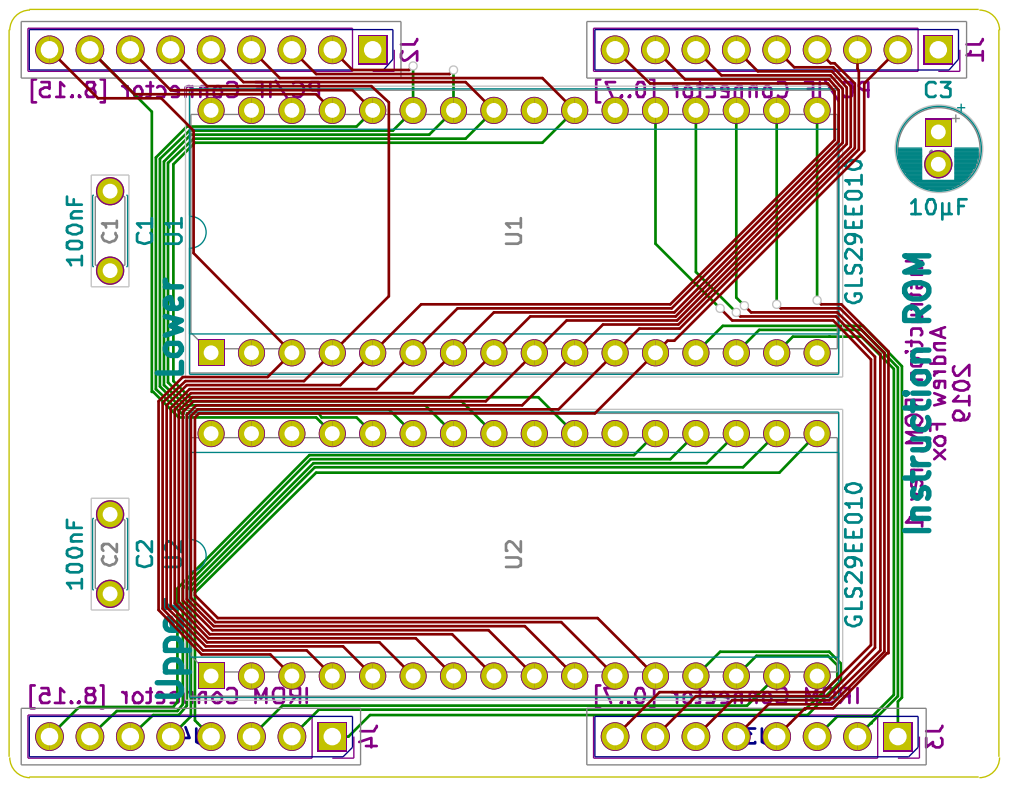
[picture p76: page 1]
