foxostro/TurtleTTL/Schematics/Version1/obsolete/RAMCard/RAMCard.pdf

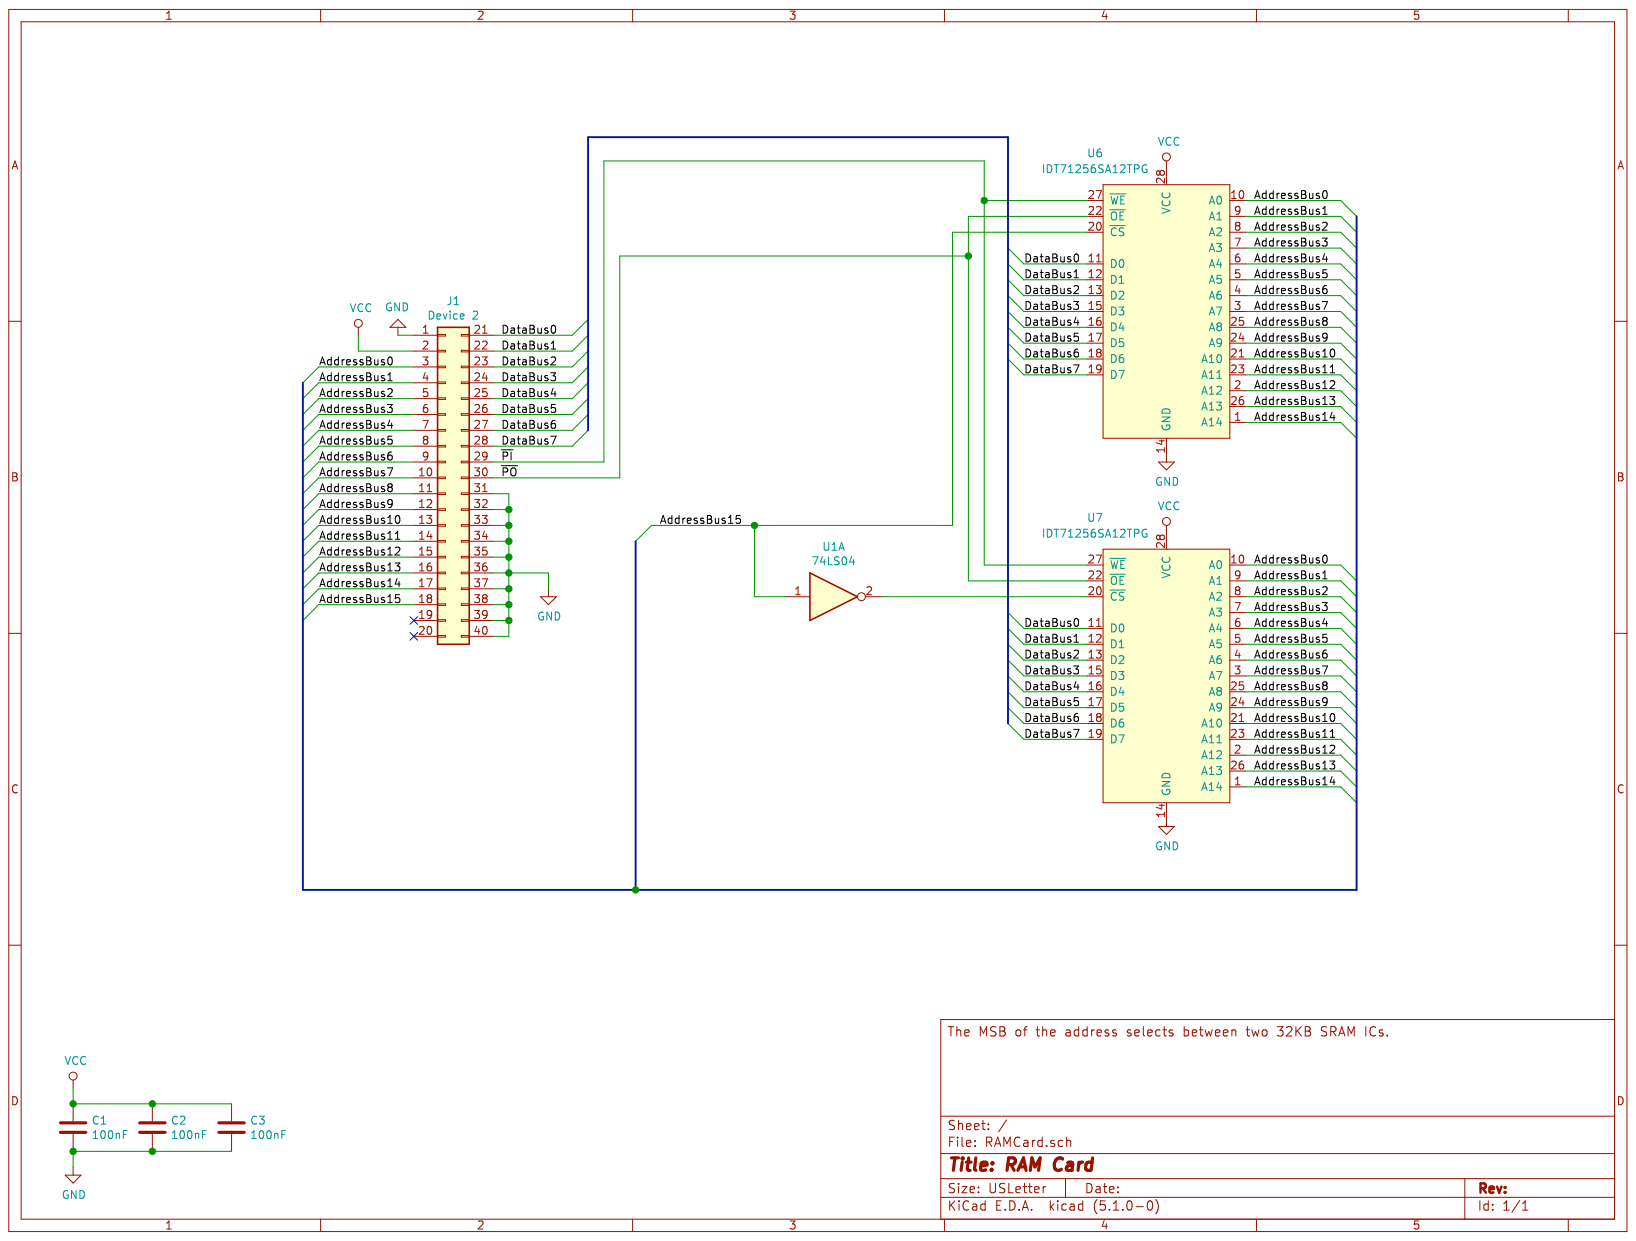
[picture p77: page 1]
