foxostro/TurtleTTL/Schematics/Version1/obsolete/RAMCard/RAMCard_PCB.pdf

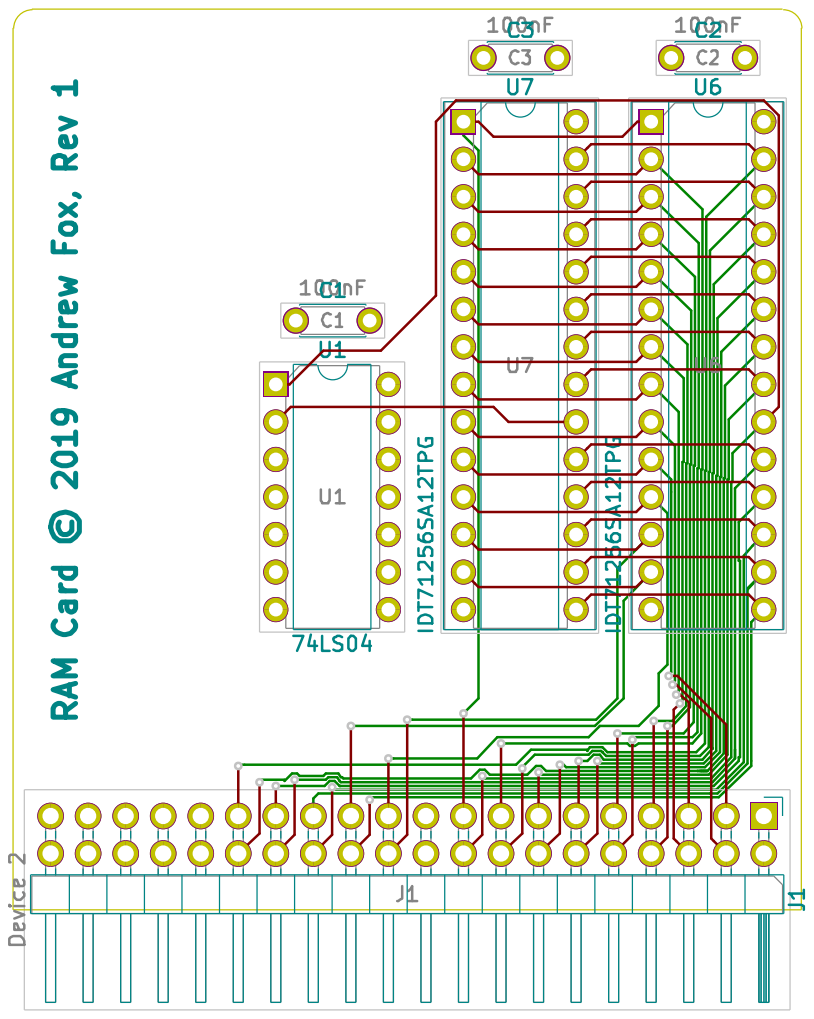
[picture p78: page 1]
