foxostro/TurtleTTL/Schematics/Version1/obsolete/OutputDisplayCard/OutputDisplayCard.pdf

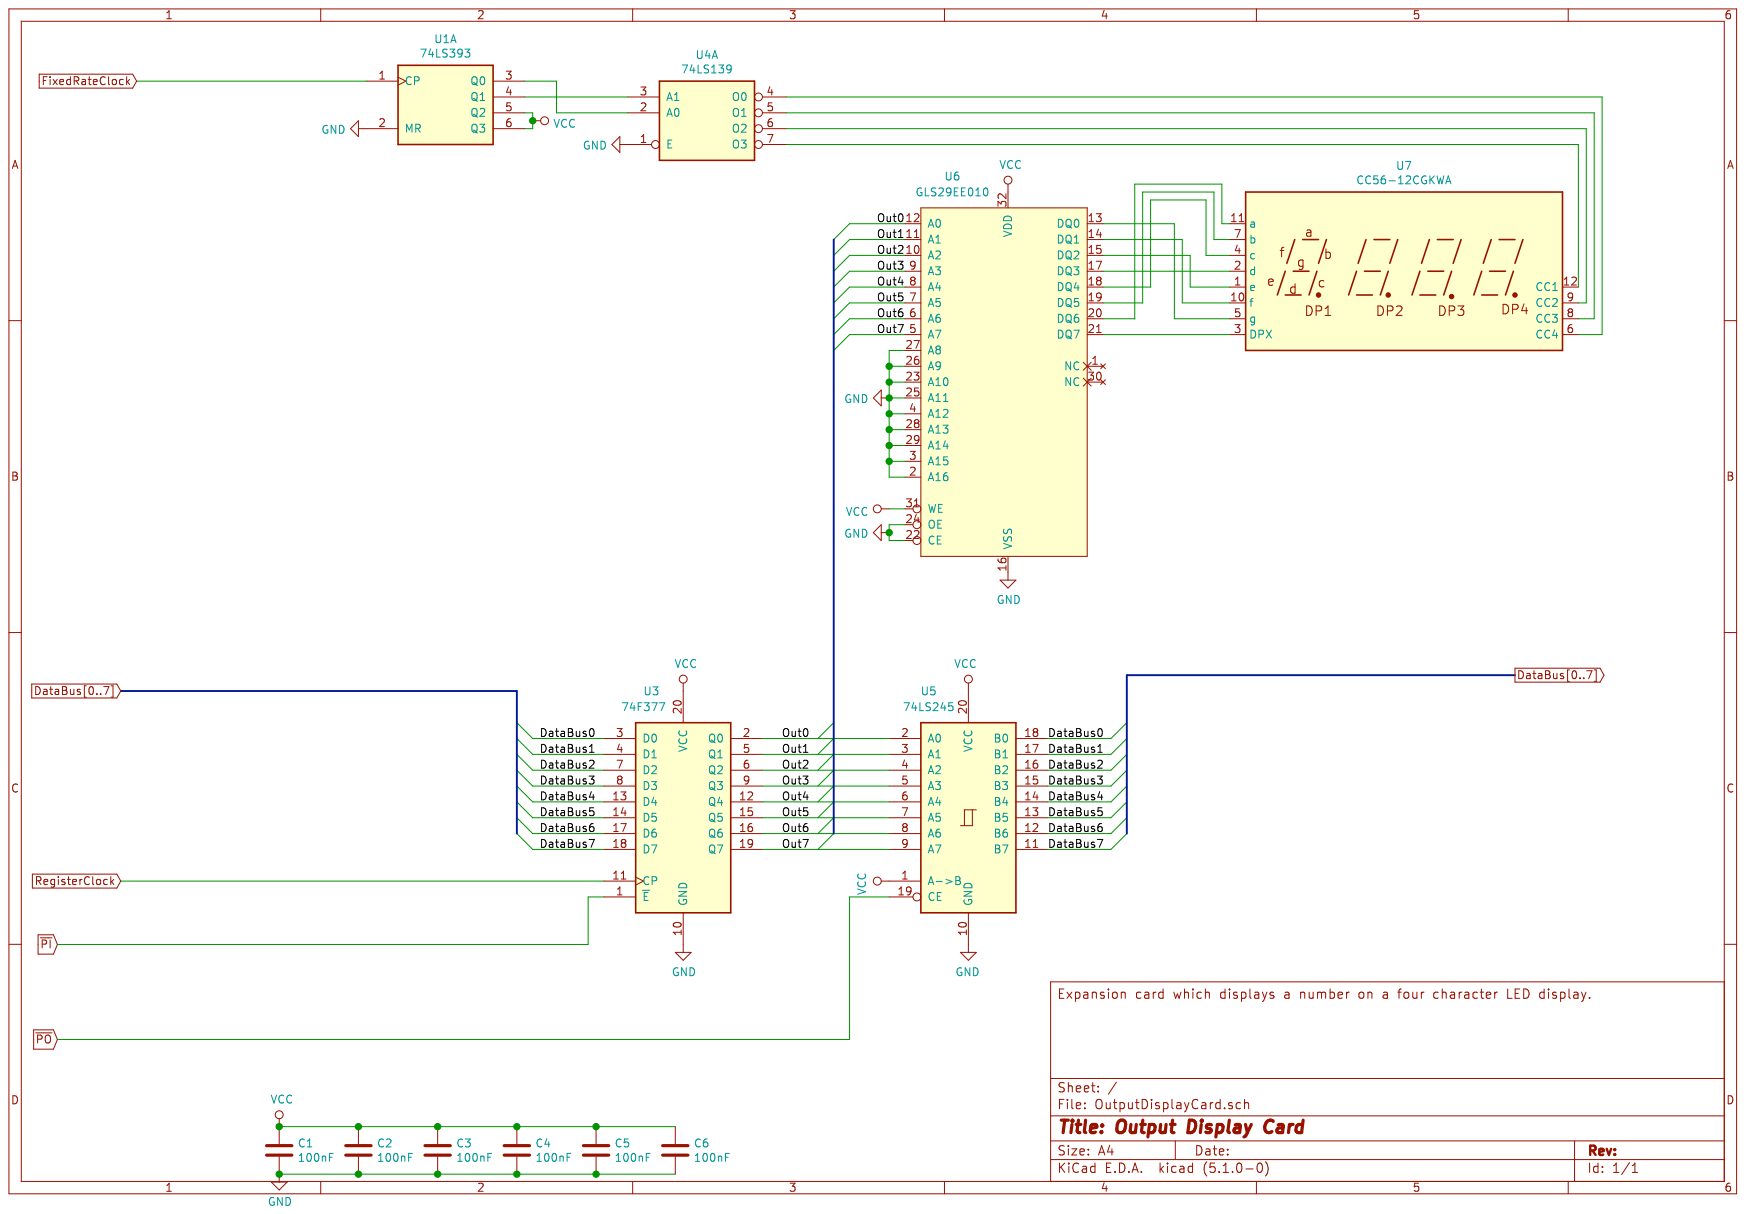
[picture p79: page 1]
