foxostro/TurtleTTL/Schematics/Version1/Generated/Schematic PDFs/InstructionROMDaughterBoard_Schematics.pdf

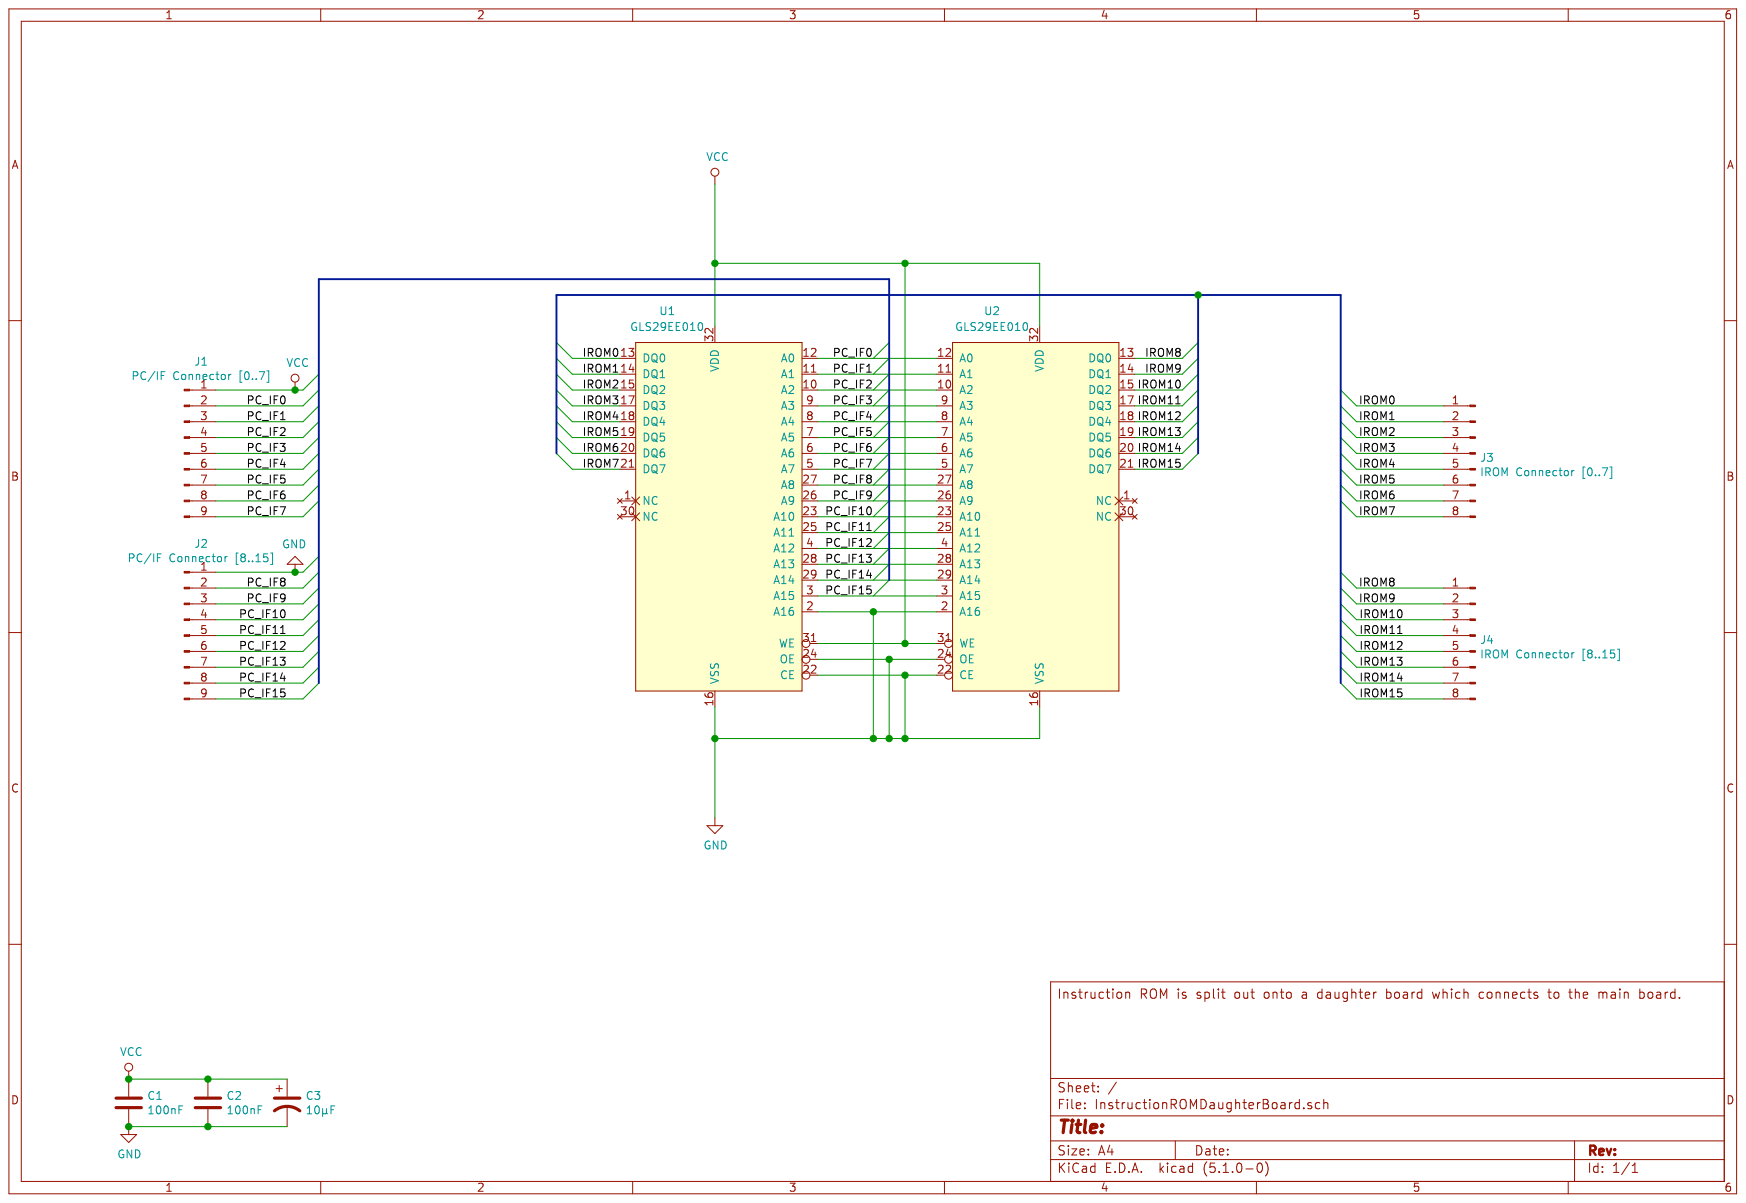
[picture p80: page 1]
