foxostro/TurtleTTL/Schematics/Version2/SoundCard/SoundCard.kicad_pcb

## KiCad design Schematics/Version2/SoundCard/SoundCard.kicad_pcb (2020-09-04)

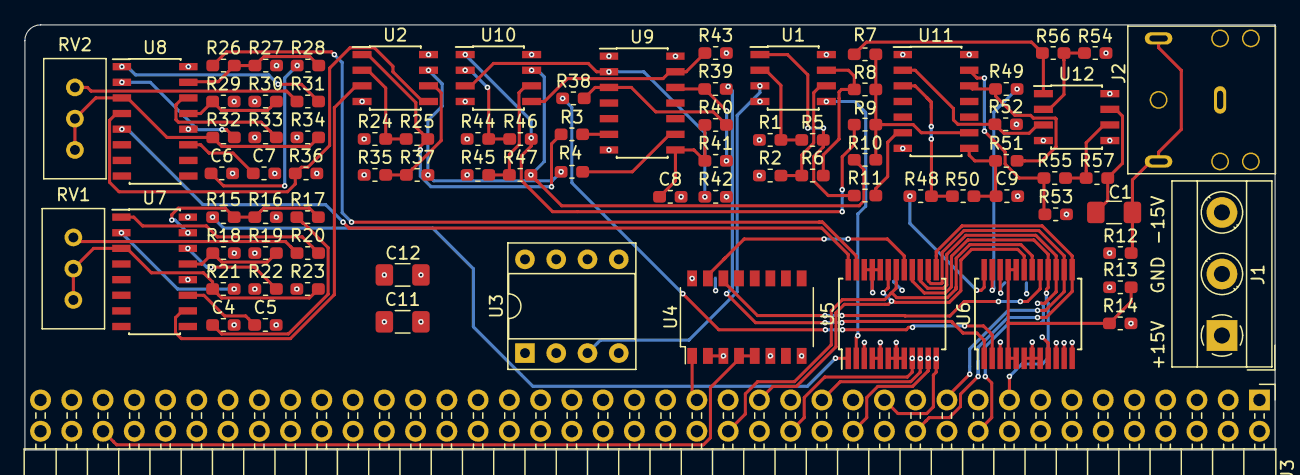
[picture p81: board SoundCard.kicad_pcb from above]

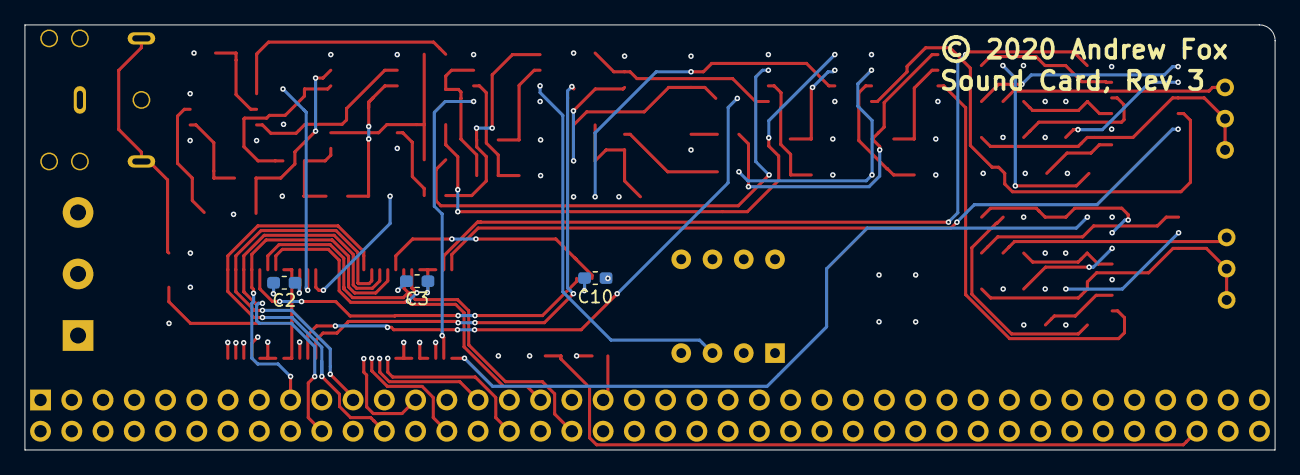
[picture p82: board SoundCard.kicad_pcb from below]

Board: 4 copper layers, 101.6 x 34.5 mm, 86 parts (3 on the bottom side), 79 nets.

Parts:
C1, C11, C12: 100µF; C_1206_3216Metric_Pad1.42x1.75mm_HandSolder
C2, C3, C10: 100nF; C_0603_1608Metric_Pad1.05x0.95mm_HandSolder
C4, C6: 10nF; C_0603_1608Metric_Pad1.05x0.95mm_HandSolder
C5, C7: 1nF; C_0603_1608Metric_Pad1.05x0.95mm_HandSolder
C8, C9: 5nF; C_0603_1608Metric_Pad1.05x0.95mm_HandSolder
J1: Screw_Terminal_01x03; TerminalBlock_MetzConnect_Type055_RT01503HDWU_1x03_P5.00mm_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
J2: AudioJack3; Jack_3.5mm_CUI_SJ1-3523N
J3: Conn; PinHeader_2x40_P2.54mm_Horizontal
R1, R2, R13, R24, R35, R44, R45, R54, R55: 10kΩ; R_0603_1608Metric_Pad1.05x0.95mm_HandSolder
R3, R4, R7, R8, R9, R10, R11, R42, R43, R52, R53: 47kΩ; R_0603_1608Metric_Pad1.05x0.95mm_HandSolder
R5, R6, R25, R46, R47, R56: 20kΩ; R_0603_1608Metric_Pad1.05x0.95mm_HandSolder
R12, R15, R26: 100kΩ; R_0603_1608Metric_Pad1.05x0.95mm_HandSolder
R14: 6.8kΩ; R_0603_1608Metric_Pad1.05x0.95mm_HandSolder
R16, R27: 360kΩ; R_0603_1608Metric_Pad1.05x0.95mm_HandSolder
R17, R28: 470Ω; R_0603_1608Metric_Pad1.05x0.95mm_HandSolder
R18, R29: 1.5MΩ; R_0603_1608Metric_Pad1.05x0.95mm_HandSolder
R19, R30: 47Ω; R_0603_1608Metric_Pad1.05x0.95mm_HandSolder
R20, R31: 24kΩ; R_0603_1608Metric_Pad1.05x0.95mm_HandSolder
R21, R32: 5.6kΩ; R_0603_1608Metric_Pad1.05x0.95mm_HandSolder
R22, R33: 1.8kΩ; R_0603_1608Metric_Pad1.05x0.95mm_HandSolder
R23, R34: 820Ω; R_0603_1608Metric_Pad1.05x0.95mm_HandSolder
R36: 51kΩ; R_0603_1608Metric_Pad1.05x0.95mm_HandSolder
R37, R40, R41, R50, R51: 2.4kΩ; R_0603_1608Metric_Pad1.05x0.95mm_HandSolder
R38, R39, R48, R49: 16kΩ; R_0603_1608Metric_Pad1.05x0.95mm_HandSolder
R57: 4.7kΩ; R_0603_1608Metric_Pad1.05x0.95mm_HandSolder
RV1, RV2: 10k; Potentiometer_Bourns_3386C_Horizontal
U1, U2, U10, U12: TL072; SOIC-8_3.9x4.9mm_P1.27mm
U3: PIC12F675-IP; DIP-8_W7.62mm_Socket
U4: 74AHCT138; SOP-16_4.4x10.4mm_P1.27mm
U5, U6: MAX505; SSOP-24_5.3x8.2mm_P0.65mm
U7, U8: AS3340; SOIC-16_3.9x9.9mm_P1.27mm
U9, U11: AS3360; SOIC-14_3.9x8.7mm_P1.27mm

Connections:
+15V: C11.1, J1.1, R16.2, R18.2, R27.2, R29.2, U1.8, U2.8, U7.16, U8.16, U9.14, U10.8, U11.14, U12.8
-15V: C12.2, J1.3, R23.1, R34.1, U1.4, U2.4, U9.7, U10.4, U11.7, U12.4
/Connector/AddressBus0: J3.33, U5.19, U6.19
/Connector/AddressBus1: J3.36, U5.18, U6.18
/Connector/AddressBus2: J3.37, U4.1
/Connector/DataBus0: J3.17, U5.16, U6.16
/Connector/DataBus1: J3.20, U5.15, U6.15
/Connector/DataBus2: J3.21, U5.14, U6.14
/Connector/DataBus3: J3.24, U5.13, U6.13
/Connector/DataBus4: J3.25, U5.12, U6.12
/Connector/DataBus5: J3.28, U5.11, U6.11
/Connector/DataBus6: J3.29, U5.10, U6.10
/Connector/DataBus7: J3.32, U5.9, U6.9
/Connector/~PI: J3.76, U4.4, U4.5
/DAC/VOUT0: U1.5, U5.2
/VCA2/CV1: R48.2, U6.24
/VCA2/CV2: R49.2, U6.23
/VCA2/VIN1: R11.2, U11.6
/VCA2/VIN2: R7.1, R8.1, R9.1, R10.1, U11.9
/VCA2/VOUT1: R7.2, R56.2, U12.1
/VCA2/VOUT2: C1.1, R57.2, U12.7
/VCA/CV1: R38.2, U6.2
/VCA/CV2: R39.2, U6.1
/VCA/VIN1: R3.1, U9.6
/VCA/VIN2: R4.1, U9.9
/VCA/VOUT1: R9.2, R46.2, U10.1
/VCA/VOUT2: R10.2, R47.2, U10.7
/VCO-Pulse/FrequencyCV: R26.1, U5.23
/VCO-Pulse/PWMCV: U5.24, U8.5
/VCO-Pulse/PulseOut: R4.2, R37.2, U2.7
/VCO-Triangle/CV: R15.1, U5.1
/VCO-Triangle/TriangleOut: R3.2, R25.2, U2.1
GND: C2.2, C3.2, C4.2, C5.2, C6.2, C7.2, C8.2, C9.2, C10.2, C11.2, C12.1, J1.2, J2.S, J3.2, J3.3, J3.6, J3.7, J3.10, J3.11, J3.14, J3.15, J3.18, J3.19, J3.22, J3.23, J3.26, J3.27, J3.30, J3.31, J3.34, J3.35, J3.38, J3.39, J3.42, J3.43, J3.46, J3.47, J3.50, J3.51, J3.54, J3.55, J3.58, J3.59, J3.62, J3.63, J3.66, J3.67, J3.70, J3.71, J3.74, J3.75, J3.78, J3.79, R1.1, R2.1, R12.2, R14.2, R19.1, R22.1, R24.1, R30.1, R33.1, R35.1, R36.2, R42.2, R43.2, R44.1, R45.1, R52.2, R53.2, R54.1, U3.8, U4.2, U4.3, U4.8, U5.3, U5.6, U5.7, U5.8, U6.3, U6.6, U6.7, U6.8, U7.12, U8.12, U9.1, U11.1, U12.5
unnamed: C1.2, J2.R, J2.T, R12.1
unnamed: C4.1, R17.1
unnamed: C5.1, U7.11
unnamed: C6.1, R28.1
unnamed: C7.1, U8.11
unnamed: C8.1, R40.1, R41.1, U9.8
unnamed: C9.1, R50.1, R51.1, U11.8
unnamed: R1.2, R5.1, U1.2
unnamed: R2.2, R6.1, U1.6
unnamed: R6.2, R8.2, U1.7
unnamed: R5.2, R11.1, U1.1
unnamed: R13.2, R14.1, U6.4, U6.5, U6.20, U6.21
unnamed: R15.2, R16.1, R17.2, U7.15
unnamed: R18.1, R19.2, U7.13
unnamed: R20.1, RV1.1
unnamed: R20.2, U7.1
unnamed: R21.1, R23.2, RV1.2, RV1.3, U7.3
unnamed: R21.2, U7.2
unnamed: R22.2, U7.14
unnamed: R24.2, R25.1, U2.2
unnamed: R26.2, R27.1, R28.2, U8.15
unnamed: R29.1, R30.2, U8.13
unnamed: R31.1, RV2.1
unnamed: R31.2, U8.1
unnamed: R32.1, R34.2, RV2.2, RV2.3, U8.3
unnamed: R32.2, U8.2
unnamed: R33.2, U8.14
unnamed: R35.2, R37.1, U2.6
unnamed: R36.1, U2.5, U8.4
unnamed: R38.1, R40.2, U9.3
unnamed: R39.1, R41.2, U9.12
unnamed: R42.1, U9.2, U10.3
unnamed: R43.1, U9.13, U10.5
unnamed: R44.2, R46.1, U10.2
unnamed: R45.2, R47.1, U10.6
unnamed: R48.1, R50.2, U11.3
unnamed: R49.1, R51.2, U11.12
unnamed: R52.1, U11.2, U12.3
unnamed: R53.1, R55.1, U11.13
unnamed: R54.2, R56.1, U12.2
unnamed: R55.2, R57.1, U12.6
unnamed: U1.3, U3.3
unnamed: U2.3, U7.10
unnamed: U4.14, U6.17
unnamed: U4.15, U5.17
VCC: C2.1, C3.1, C10.1, J3.1, J3.4, J3.5, J3.8, J3.9, J3.12, J3.13, J3.16, J3.73, J3.77, J3.80, R13.1, U3.1, U4.6, U4.16, U5.4, U5.5, U5.20, U5.21, U5.22, U6.22
