foxostro/TurtleTTL/Schematics/Version2/SerialCard/SerialCard.kicad_pcb

## KiCad design Schematics/Version2/SerialCard/SerialCard.kicad_pcb (2019-12-31)

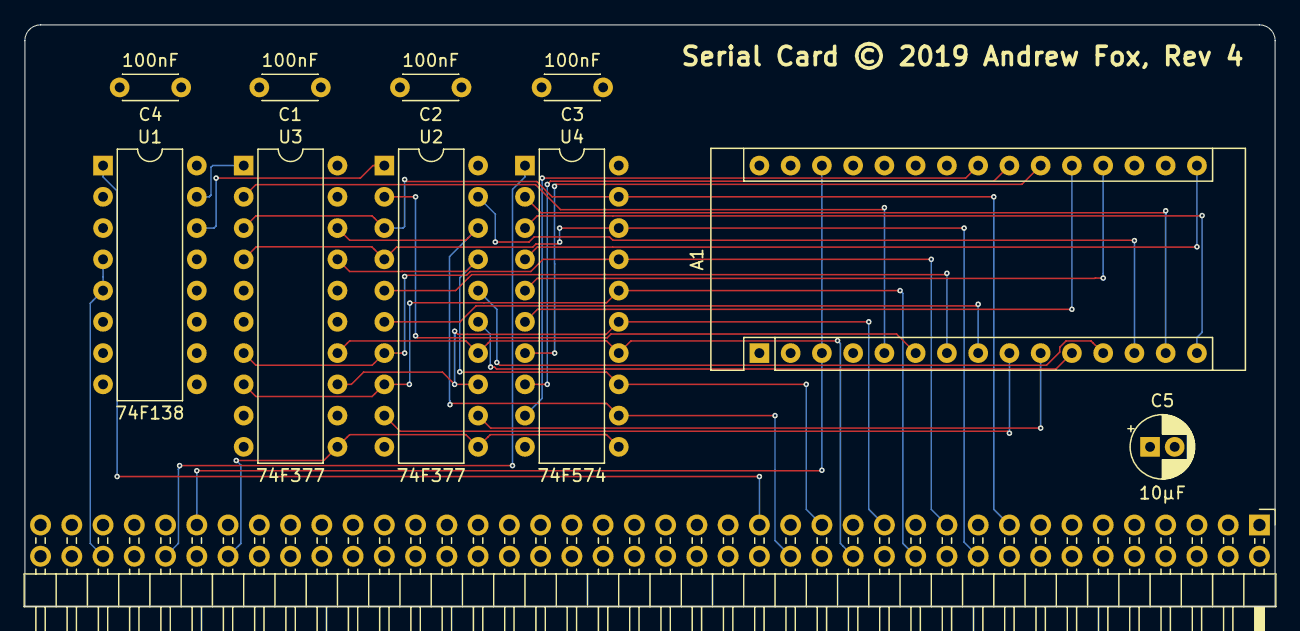
[picture p83: board SerialCard.kicad_pcb from above]

Board: 4 copper layers, 101.6 x 47.2 mm, 11 parts (0 on the bottom side), 34 nets.

Parts:
A1: Arduino_Nano_v3.x; Arduino_Nano
C1, C2, C3, C4: 100nF; C_Disc_D4.3mm_W1.9mm_P5.00mm
C5: 10µF; CP_Radial_D5.0mm_P2.00mm
J1: Conn; PinHeader_2x40_P2.54mm_Horizontal
U1: 74F138; DIP-16_W7.62mm
U2, U3: 74F377; DIP-20_W7.62mm
U4: 74F574; DIP-20_W7.62mm

Connections:
AddressBus0: J1.33, U1.1
DataBus0: J1.17, U2.3, U3.3, U4.19
DataBus1: J1.20, U2.4, U3.4, U4.18
DataBus2: J1.21, U2.7, U3.7, U4.17
DataBus3: J1.24, U2.8, U3.8, U4.16
DataBus4: J1.25, U2.13, U3.13, U4.15
DataBus5: J1.28, U2.14, U3.14, U4.14
DataBus6: J1.29, U2.17, U3.17, U4.13
DataBus7: J1.32, U2.18, U3.18, U4.12
GND: A1.4, A1.29, C1.2, C2.2, C3.2, C4.2, C5.2, J1.2, J1.3, J1.6, J1.7, J1.10, J1.11, J1.14, J1.15, J1.18, J1.19, J1.22, J1.23, J1.26, J1.27, J1.30, J1.31, J1.34, J1.35, J1.38, J1.39, J1.42, J1.43, J1.46, J1.47, J1.50, J1.51, J1.54, J1.55, J1.58, J1.59, J1.62, J1.63, J1.66, J1.67, J1.70, J1.71, J1.74, J1.75, J1.78, J1.79, U1.2, U1.3, U1.8, U2.10, U3.10, U4.10
unnamed: A1.5, U3.2
unnamed: A1.6, U2.2
unnamed: A1.7, U2.5
unnamed: A1.8, U2.6
unnamed: A1.9, U2.9
unnamed: A1.10, U2.12
unnamed: A1.11, U2.15
unnamed: A1.12, U2.16
unnamed: A1.13, U2.19
unnamed: A1.14, U4.2
unnamed: A1.15, U4.3
unnamed: A1.16, U4.4
unnamed: A1.19, U4.5
unnamed: A1.20, U4.6
unnamed: A1.21, U4.7
unnamed: A1.22, U4.8
unnamed: A1.23, U4.9
unnamed: U1.14, U2.1
unnamed: U1.15, U3.1
RegisterClock: J1.68, U2.11, U3.11, U4.11
VCC: C1.1, C2.1, C3.1, C4.1, C5.1, J1.1, J1.4, J1.5, J1.8, J1.9, J1.12, J1.13, J1.16, J1.73, J1.77, J1.80, U1.6, U1.16, U2.20, U3.20, U4.20
~PI: J1.76, U1.4, U1.5
~PO: J1.72, U4.1
~RST: A1.3, A1.28, J1.69
