foxostro/TurtleTTL/Schematics/Misc/ExternalClock/ExternalClock.kicad_pcb

## KiCad design Schematics/Misc/ExternalClock/ExternalClock.kicad_pcb (2019-12-24)

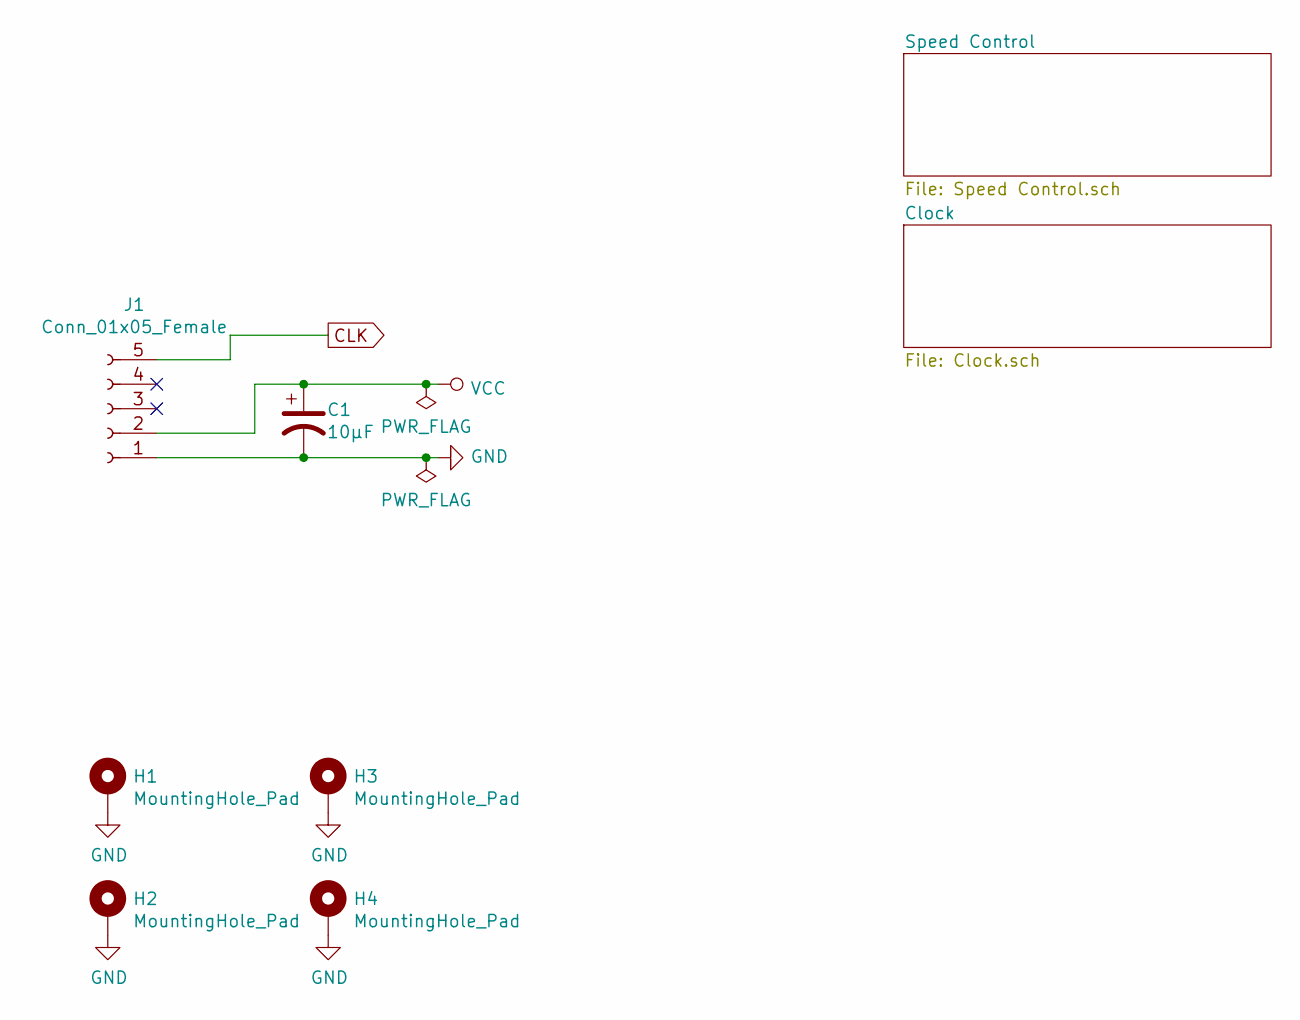
[picture p84: schematic ExternalClock.sch, TurtleTTL: External Clock]

Parts:
C1: 10µF; CP_Radial_D5.0mm_P2.00mm
H1, H2, H3, H4: MountingHole_Pad; MountingHole_3.2mm_M3_Pad
J1: Conn_01x05_Female; PinSocket_1x05_P2.54mm_Vertical

Connections:
CLK: J1.5; also elsewhere on the board
GND: C1.2, H1.1, H2.1, H3.1, H4.1, J1.1; also elsewhere on the board
VCC: C1.1, J1.2; also elsewhere on the board

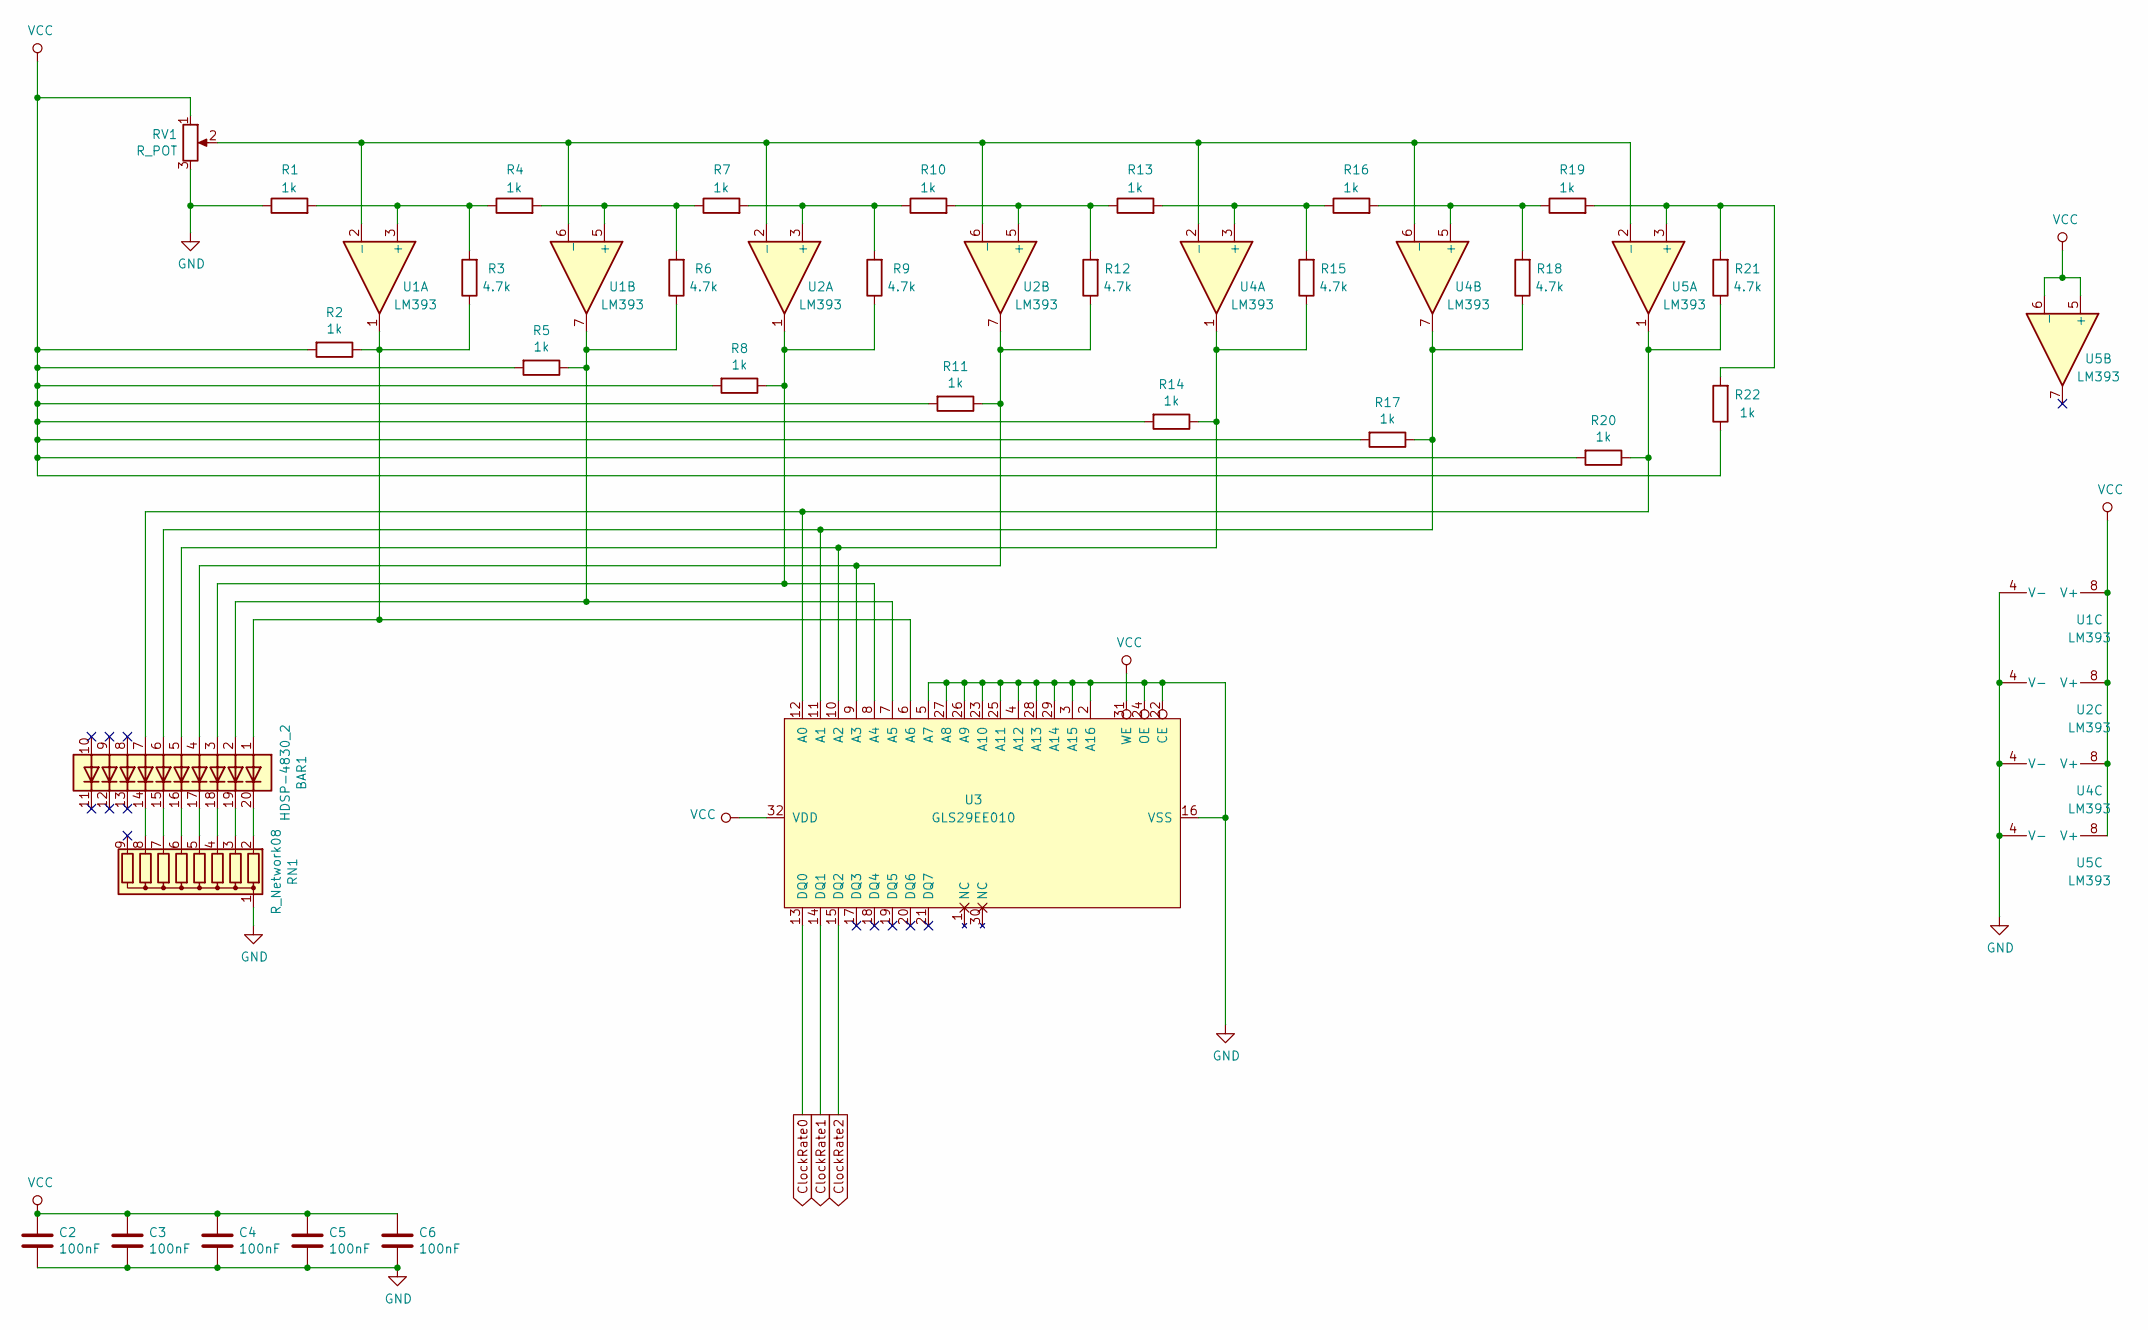
[picture p85: schematic Speed Control.sch]

Parts:
BAR1: HDSP-4830_2; HDSP-4830
C2, C3, C4, C5, C6: 100nF; C_Disc_D4.3mm_W1.9mm_P5.00mm
R1, R2, R4, R5, R7, R8, R10, R11, R13, R14, R16, R17, R19, R20, R22: 1k; R_Axial_DIN0207_L6.3mm_D2.5mm_P7.62mm_Horizontal
R3, R6, R9, R12, R15, R18, R21: 4.7k; R_Axial_DIN0207_L6.3mm_D2.5mm_P7.62mm_Horizontal
RN1: R_Network08; R_Array_SIP9
RV1: R_POT; Potentiometer_ACP_CA6-H2,5_Horizontal
U1, U2, U4, U5: LM393; DIP-8_W7.62mm
U3: GLS29EE010; DIP-32_W15.24mm_Socket

Connections:
ClockRate0: U3.13 (DQ0); also elsewhere on the board
ClockRate1: U3.14 (DQ1); also elsewhere on the board
ClockRate2: U3.15 (DQ2); also elsewhere on the board
GND: C2.2, C3.2, C4.2, C5.2, C6.2, R1.1, RN1.1 (common), RV1.3, U1.4 (V-), U2.4 (V-), U3.2 (A16), U3.3 (A15), U3.4 (A12), U3.5 (A7), U3.16 (VSS), U3.22 (CE), U3.23 (A10), U3.24 (OE), U3.25 (A11), U3.26 (A9), U3.27 (A8), U3.28 (A13), U3.29 (A14), U4.4 (V-), U5.4 (V-); also elsewhere on the board
unnamed: BAR1.1 (A), R2.1, R3.1, U1.1, U3.6 (A6)
unnamed: BAR1.2 (A), R5.1, R6.1, U1.7, U3.7 (A5)
unnamed: BAR1.3 (A), R8.1, R9.1, U2.1, U3.8 (A4)
unnamed: BAR1.4 (A), R11.1, R12.1, U2.7, U3.9 (A3)
unnamed: BAR1.5 (A), R14.1, R15.1, U3.10 (A2), U4.1
unnamed: BAR1.6 (A), R17.1, R18.1, U3.11 (A1), U4.7
unnamed: BAR1.7 (A), R20.1, R21.1, U3.12 (A0), U5.1
unnamed: BAR1.14 (K), RN1.8 (R7)
unnamed: BAR1.15 (K), RN1.7 (R6)
unnamed: BAR1.16 (K), RN1.6 (R5)
unnamed: BAR1.17 (K), RN1.5 (R4)
unnamed: BAR1.18 (K), RN1.4 (R3)
unnamed: BAR1.19 (K), RN1.3 (R2)
unnamed: BAR1.20 (K), RN1.2 (R1)
unnamed: R1.2, R3.2, R4.1, U1.3 (+)
unnamed: R4.2, R6.2, R7.1, U1.5 (+)
unnamed: R7.2, R9.2, R10.1, U2.3 (+)
unnamed: R10.2, R12.2, R13.1, U2.5 (+)
unnamed: R13.2, R15.2, R16.1, U4.3 (+)
unnamed: R16.2, R18.2, R19.1, U4.5 (+)
unnamed: R19.2, R21.2, R22.2, U5.3 (+)
unnamed: RV1.2, U1.2 (-), U1.6 (_), U2.2 (-), U2.6 (_), U4.2 (-), U4.6 (_), U5.2 (-)
VCC: C2.1, C3.1, C4.1, C5.1, C6.1, R2.2, R5.2, R8.2, R11.2, R14.2, R17.2, R20.2, R22.1, RV1.1, U1.8 (V+), U2.8 (V+), U3.31 (WE), U3.32 (VDD), U4.8 (V+), U5.5 (+), U5.6 (_), U5.8 (V+); also elsewhere on the board

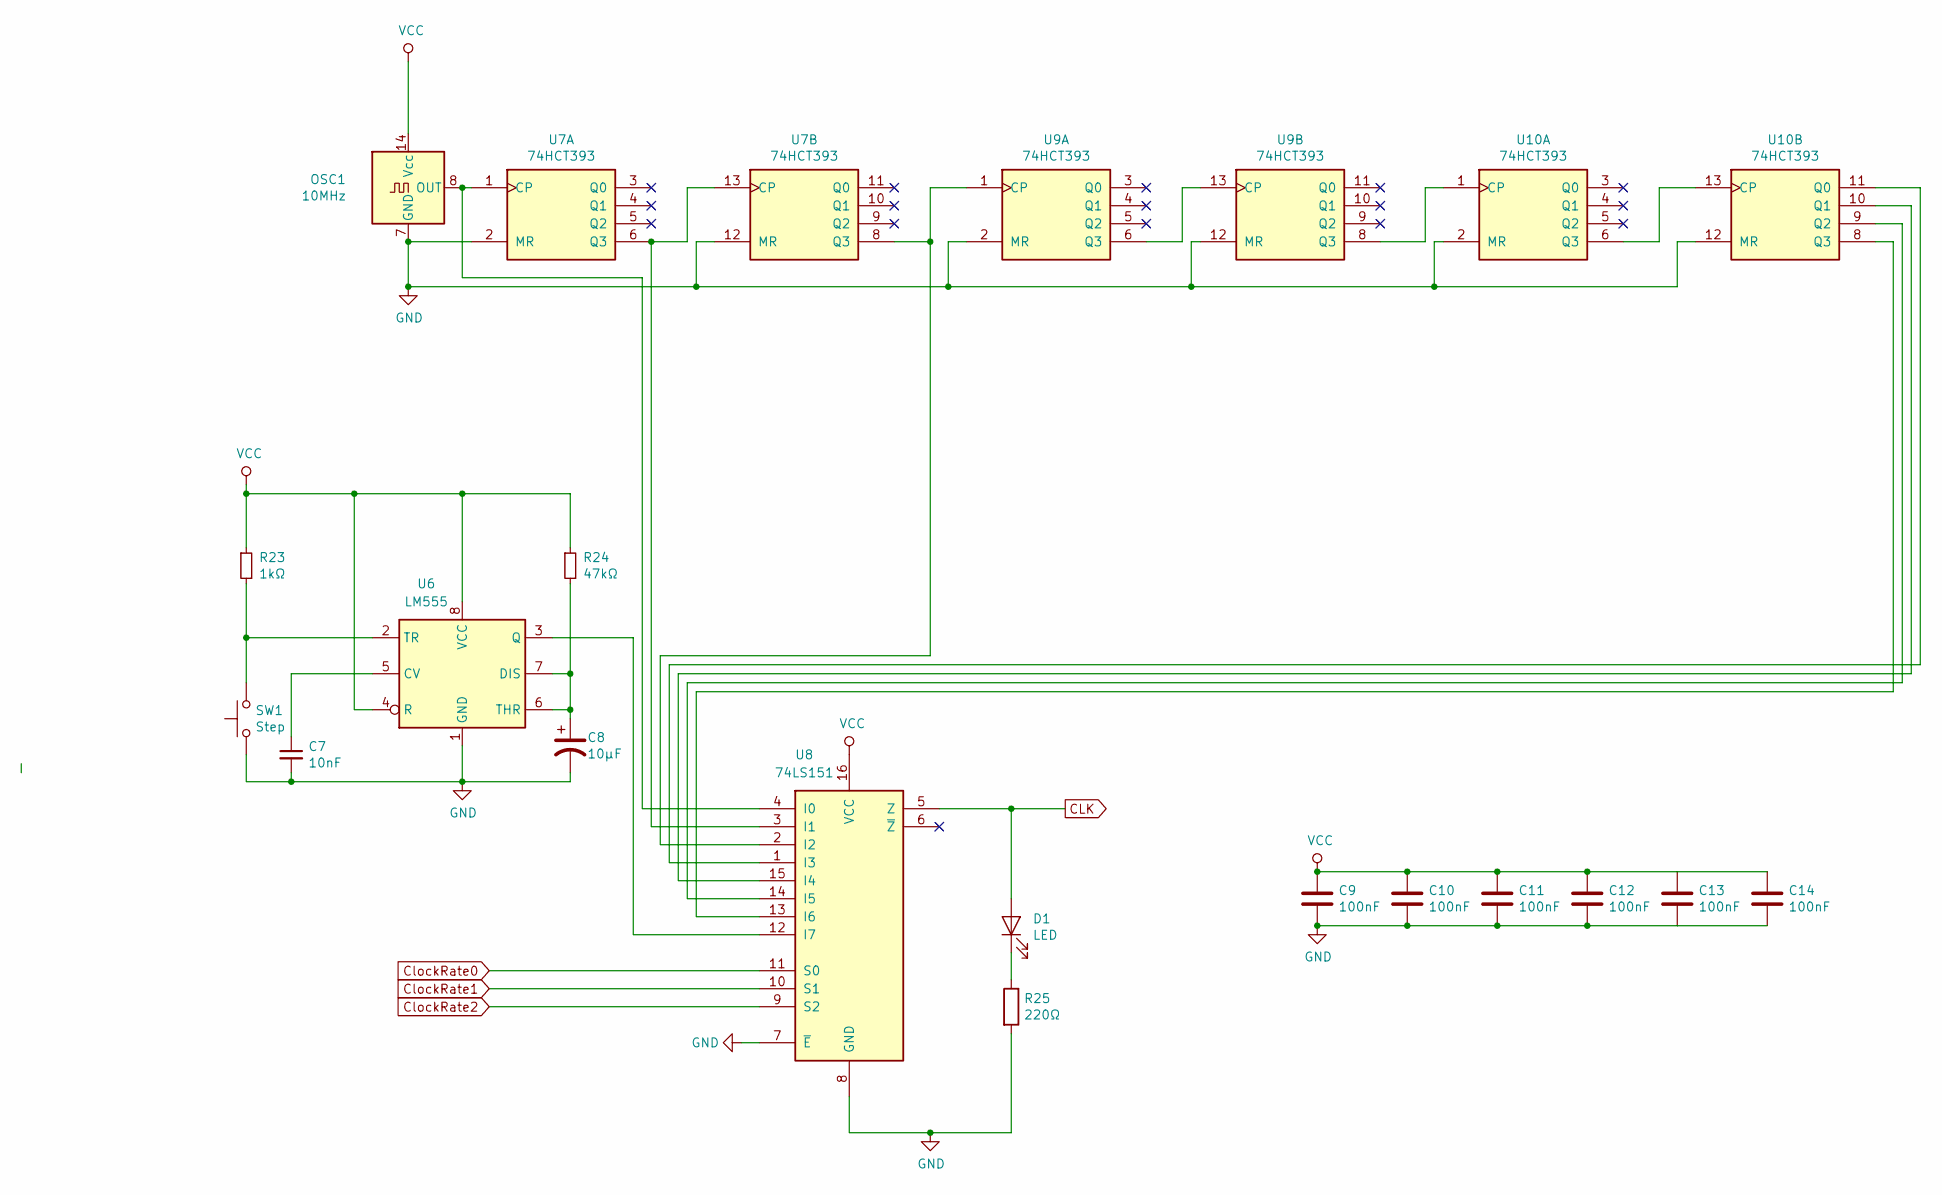
[picture p86: schematic Clock.sch]

Parts:
C7: 10nF; C_Disc_D4.3mm_W1.9mm_P5.00mm
C8: 10µF; CP_Radial_D5.0mm_P2.00mm
C9, C10, C11, C12, C13, C14: 100nF; C_Disc_D4.3mm_W1.9mm_P5.00mm
D1: LED; LED_D5.0mm
OSC1: 10MHz; Oscillator_DIP-14
R23: 1kΩ; R_Axial_DIN0207_L6.3mm_D2.5mm_P7.62mm_Horizontal
R24: 47kΩ; R_Axial_DIN0207_L6.3mm_D2.5mm_P7.62mm_Horizontal
R25: 220Ω; R_Axial_DIN0207_L6.3mm_D2.5mm_P7.62mm_Horizontal
SW1: Step; SW_PUSH_6mm_H5mm
U6: LM555; DIP-8_W7.62mm
U7, U9, U10: 74HCT393; DIP-14_W7.62mm
U8: 74LS151; DIP-16_W7.62mm

Connections:
CLK: D1.2 (A), U8.5 (Z); also elsewhere on the board
ClockRate0: U8.11 (S0); also elsewhere on the board
ClockRate1: U8.10 (S1); also elsewhere on the board
ClockRate2: U8.9 (S2); also elsewhere on the board
GND: C7.2, C8.2, C9.2, C10.2, C11.2, C12.2, C13.2, C14.2, OSC1.7 (GND), R25.2, SW1.1, U6.1 (GND), U7.2 (MR), U7.12 (MR), U8.7 (~E), U8.8 (GND), U9.2 (MR), U9.12 (MR), U10.2 (MR), U10.12 (MR); also elsewhere on the board
unnamed: C7.1, U6.5 (CV)
unnamed: C8.1, R24.2, U6.6 (THR), U6.7 (DIS)
unnamed: D1.1 (K), R25.1
unnamed: OSC1.8 (OUT), U7.1 (CP), U8.4 (I0)
unnamed: R23.2, SW1.2, U6.2 (TR)
unnamed: U6.3 (Q), U8.12 (I7)
unnamed: U7.8 (Q3), U8.2 (I2), U9.1 (CP)
unnamed: U7.6 (Q3), U7.13 (CP), U8.3 (I1)
unnamed: U9.6 (Q3), U9.13 (CP)
unnamed: U9.8 (Q3), U10.1 (CP)
unnamed: U8.13 (I6), U10.8 (Q3)
unnamed: U8.14 (I5), U10.9 (Q2)
unnamed: U8.15 (I4), U10.10 (Q1)
unnamed: U8.1 (I3), U10.11 (Q0)
unnamed: U10.6 (Q3), U10.13 (CP)
VCC: C9.1, C10.1, C11.1, C12.1, C13.1, C14.1, OSC1.14 (Vcc), R23.1, R24.1, U6.4 (R), U6.8 (VCC), U8.16 (VCC); also elsewhere on the board

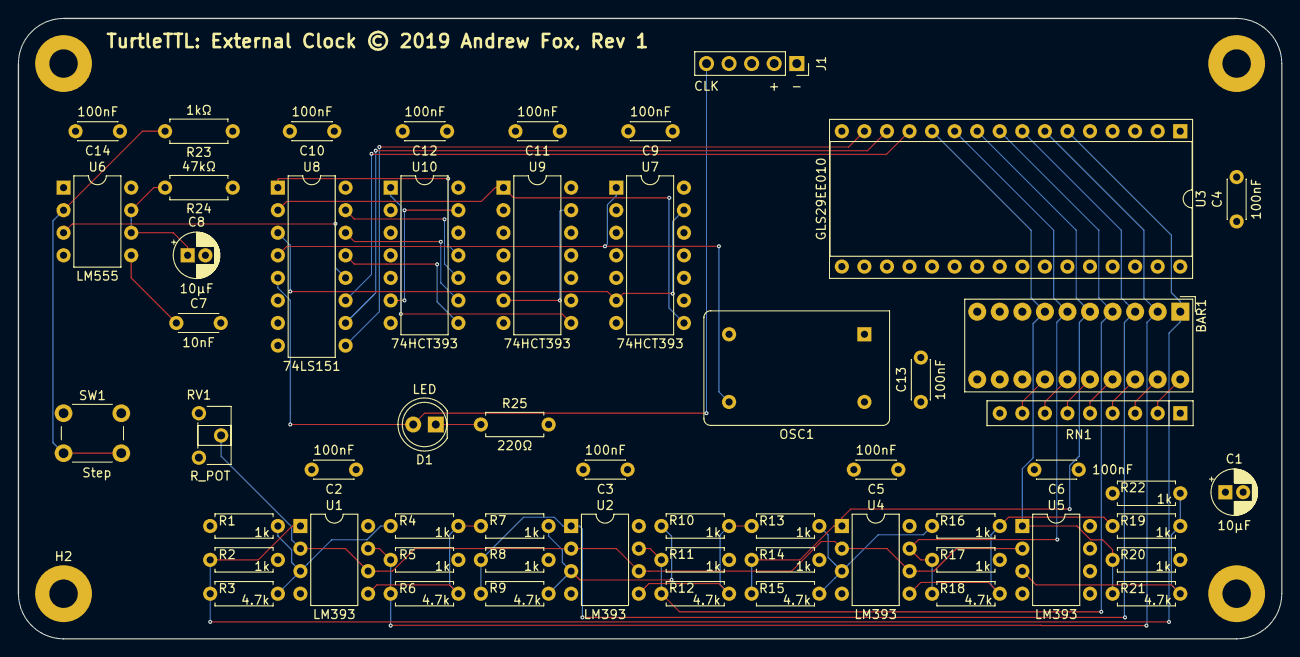
[picture p87: board ExternalClock.kicad_pcb from above]

Board: 4 copper layers, 142.2 x 69.9 mm, 60 parts (0 on the bottom side), 43 nets.
