foxostro/TurtleTTL/Schematics/Version1/InstructionROMDaughterBoard/InstructionROMDaughterBoard.kicad_pcb

## KiCad design Schematics/Version1/InstructionROMDaughterBoard/InstructionROMDaughterBoard.kicad_pcb (2019-10-13, an earlier design)

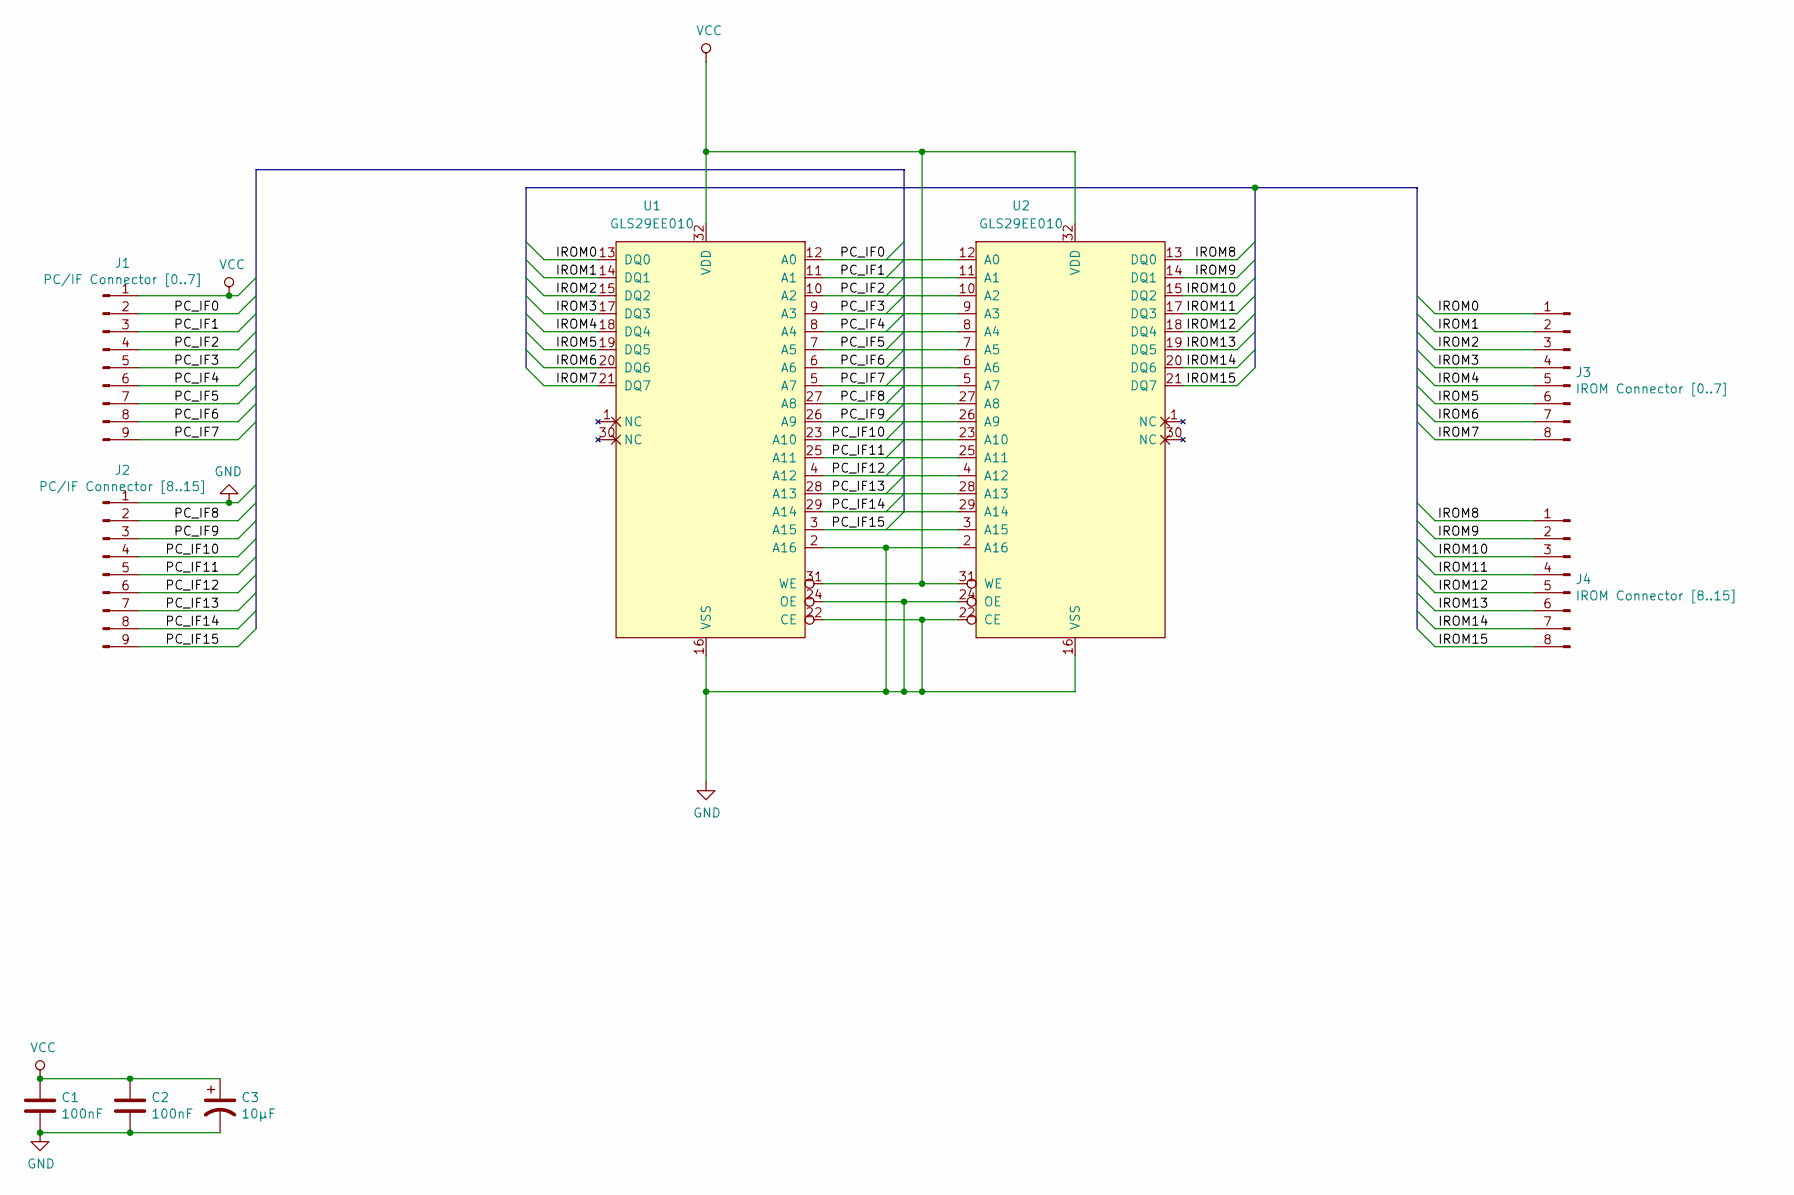
[picture p88: schematic InstructionROMDaughterBoard.sch]

Parts:
C1, C2: 100nF; C_Disc_D4.3mm_W1.9mm_P5.00mm
C3: 10µF; CP_Radial_D5.0mm_P2.00mm
J1: PC/IF Connector [0..7]; PinHeader_1x09_P2.54mm_Vertical
J2: PC/IF Connector [8..15]; PinHeader_1x09_P2.54mm_Vertical
J3: IROM Connector [0..7]; PinHeader_1x08_P2.54mm_Vertical
J4: IROM Connector [8..15]; PinHeader_1x08_P2.54mm_Vertical
U1, U2: GLS29EE010; DIP-32_W15.24mm_Socket

Connections:
/IROM0: J3.1, U1.13 (DQ0)
/IROM1: J3.2, U1.14 (DQ1)
/IROM2: J3.3, U1.15 (DQ2)
/IROM3: J3.4, U1.17 (DQ3)
/IROM4: J3.5, U1.18 (DQ4)
/IROM5: J3.6, U1.19 (DQ5)
/IROM6: J3.7, U1.20 (DQ6)
/IROM7: J3.8, U1.21 (DQ7)
/IROM8: J4.1, U2.13 (DQ0)
/IROM9: J4.2, U2.14 (DQ1)
/IROM10: J4.3, U2.15 (DQ2)
/IROM11: J4.4, U2.17 (DQ3)
/IROM12: J4.5, U2.18 (DQ4)
/IROM13: J4.6, U2.19 (DQ5)
/IROM14: J4.7, U2.20 (DQ6)
/IROM15: J4.8, U2.21 (DQ7)
/PC_IF0: J1.2, U1.12 (A0), U2.12 (A0)
/PC_IF1: J1.3, U1.11 (A1), U2.11 (A1)
/PC_IF2: J1.4, U1.10 (A2), U2.10 (A2)
/PC_IF3: J1.5, U1.9 (A3), U2.9 (A3)
/PC_IF4: J1.6, U1.8 (A4), U2.8 (A4)
/PC_IF5: J1.7, U1.7 (A5), U2.7 (A5)
/PC_IF6: J1.8, U1.6 (A6), U2.6 (A6)
/PC_IF7: J1.9, U1.5 (A7), U2.5 (A7)
/PC_IF8: J2.2, U1.27 (A8), U2.27 (A8)
/PC_IF9: J2.3, U1.26 (A9), U2.26 (A9)
/PC_IF10: J2.4, U1.23 (A10), U2.23 (A10)
/PC_IF11: J2.5, U1.25 (A11), U2.25 (A11)
/PC_IF12: J2.6, U1.4 (A12), U2.4 (A12)
/PC_IF13: J2.7, U1.28 (A13), U2.28 (A13)
/PC_IF14: J2.8, U1.29 (A14), U2.29 (A14)
/PC_IF15: J2.9, U1.3 (A15), U2.3 (A15)
GND: C1.2, C2.2, C3.2, J2.1, U1.2 (A16), U1.16 (VSS), U1.22 (CE), U1.24 (OE), U2.2 (A16), U2.16 (VSS), U2.22 (CE), U2.24 (OE)
VCC: C1.1, C2.1, C3.1, J1.1, U1.31 (WE), U1.32 (VDD), U2.31 (WE), U2.32 (VDD)

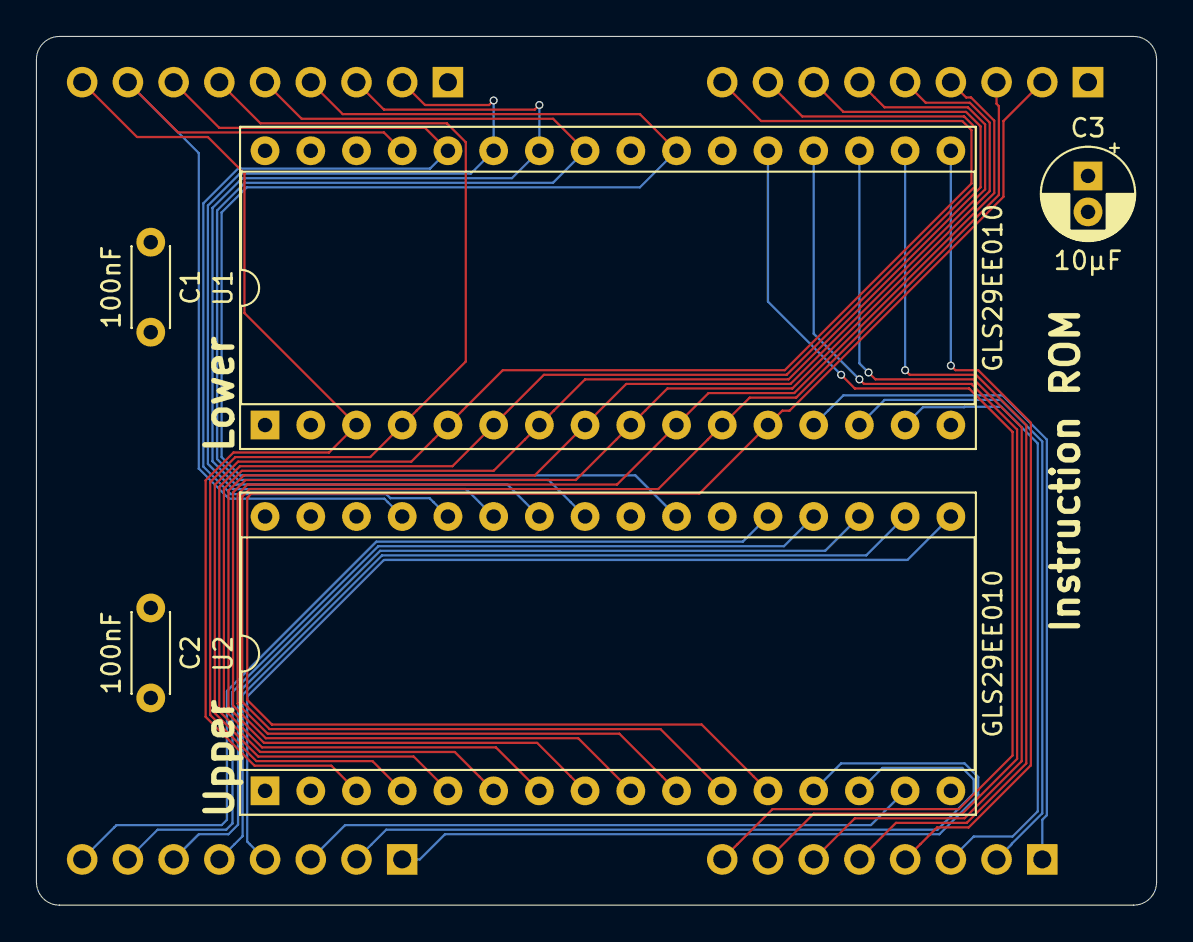
[picture p89: board InstructionROMDaughterBoard.kicad_pcb from above]

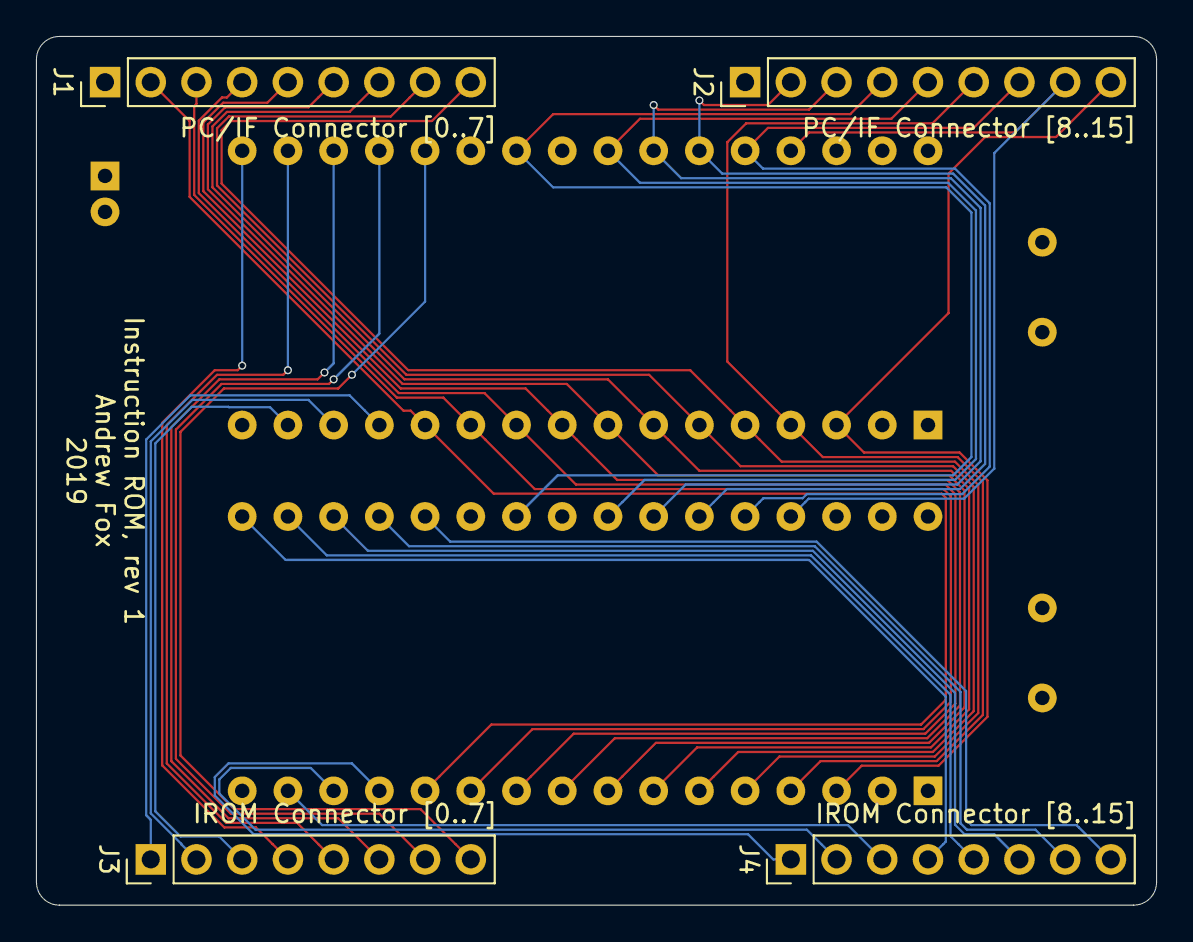
[picture p90: board InstructionROMDaughterBoard.kicad_pcb from below]

Board: 4 copper layers, 62.2 x 48.3 mm, 9 parts (4 on the bottom side), 34 nets.
