foxostro/TurtleTTL/Schematics/Version1/experimental/SharedMemoryArduinoSerialCard/ArduinoSerialCard.kicad_pcb

## KiCad design Schematics/Version1/experimental/SharedMemoryArduinoSerialCard/ArduinoSerialCard.kicad_pcb (2019-11-12, an earlier design)

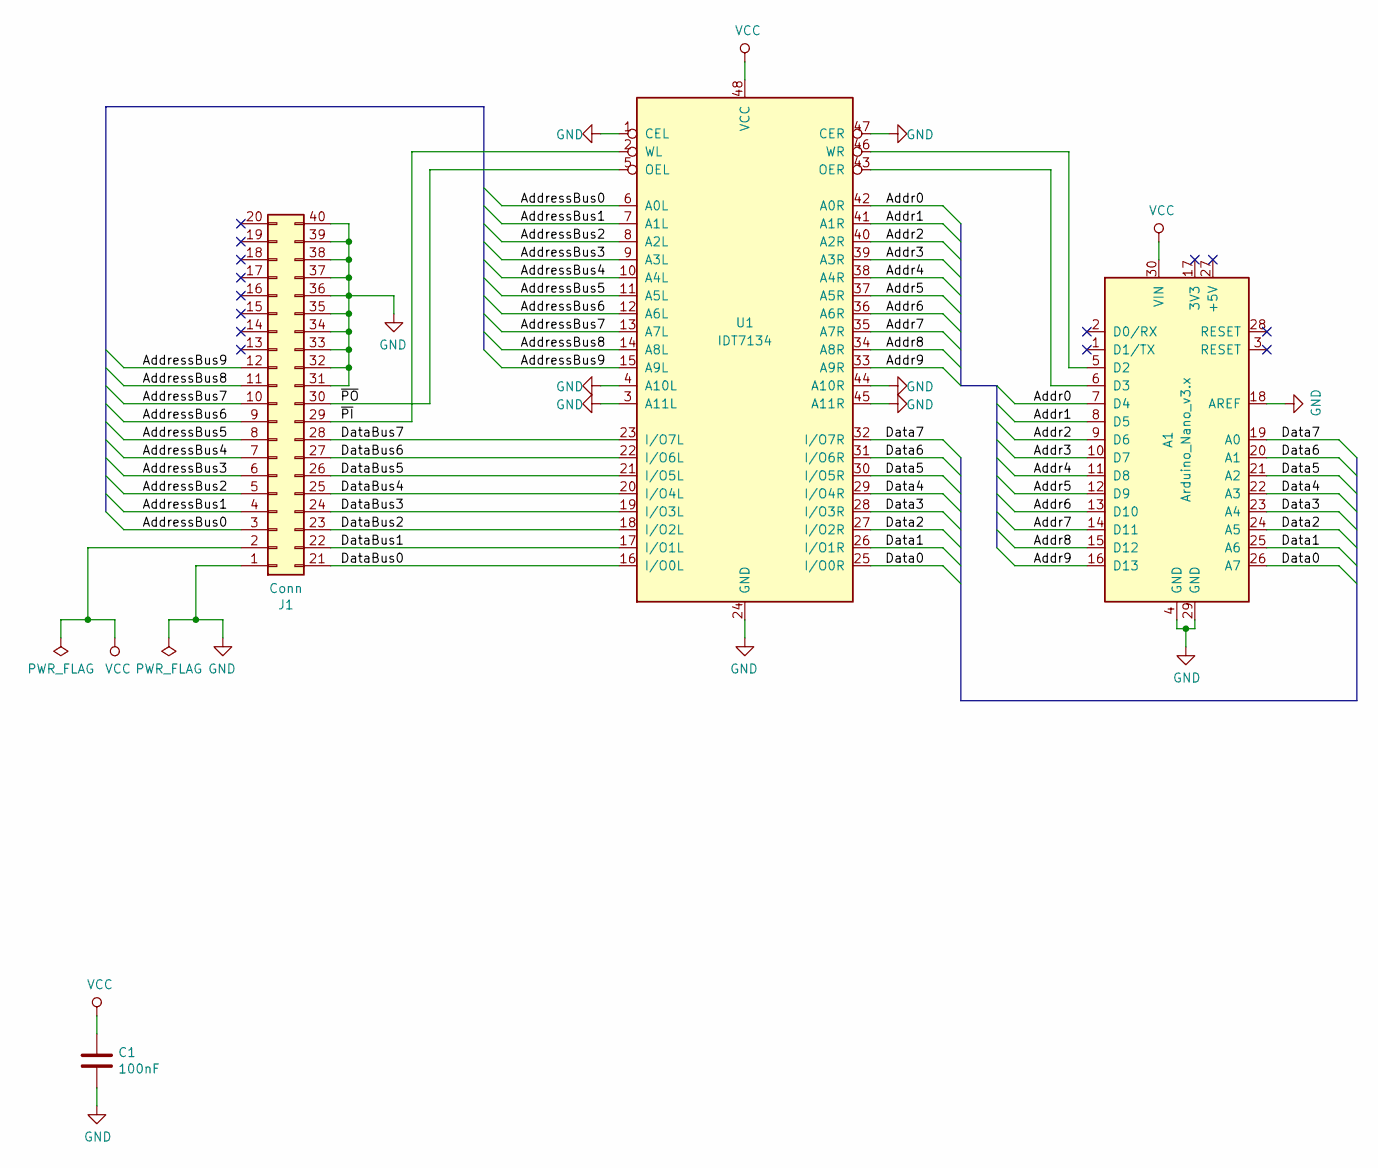
[picture p91: schematic ArduinoSerialCard.sch, Arduino Serial Card]

Parts:
A1: Arduino_Nano_v3.x; Arduino_Nano
C1: 100nF; C_Disc_D4.3mm_W1.9mm_P5.00mm
J1: Conn; PinSocket_2x20_P2.54mm_Vertical
U1: IDT7134; DIP-48_W15.24mm

Connections:
/Addr0: A1.7 (D4), U1.42 (A0R)
/Addr1: A1.8 (D5), U1.41 (A1R)
/Addr2: A1.9 (D6), U1.40 (A2R)
/Addr3: A1.10 (D7), U1.39 (A3R)
/Addr4: A1.11 (D8), U1.38 (A4R)
/Addr5: A1.12 (D9), U1.37 (A5R)
/Addr6: A1.13 (D10), U1.36 (A6R)
/Addr7: A1.14 (D11), U1.35 (A7R)
/Addr8: A1.15 (D12), U1.34 (A8R)
/Addr9: A1.16 (D13), U1.33 (A9R)
/AddressBus0: J1.3, U1.6 (A0L)
/AddressBus1: J1.4, U1.7 (A1L)
/AddressBus2: J1.5, U1.8 (A2L)
/AddressBus3: J1.6, U1.9 (A3L)
/AddressBus4: J1.7, U1.10 (A4L)
/AddressBus5: J1.8, U1.11 (A5L)
/AddressBus6: J1.9, U1.12 (A6L)
/AddressBus7: J1.10, U1.13 (A7L)
/AddressBus8: J1.11, U1.14 (A8L)
/AddressBus9: J1.12, U1.15 (A9L)
/Data0: A1.26 (A7), U1.25 (I/O0R)
/Data1: A1.25 (A6), U1.26 (I/O1R)
/Data2: A1.24 (A5), U1.27 (I/O2R)
/Data3: A1.23 (A4), U1.28 (I/O3R)
/Data4: A1.22 (A3), U1.29 (I/O4R)
/Data5: A1.21 (A2), U1.30 (I/O5R)
/Data6: A1.20 (A1), U1.31 (I/O6R)
/Data7: A1.19 (A0), U1.32 (I/O7R)
/DataBus0: J1.21, U1.16 (I/O0L)
/DataBus1: J1.22, U1.17 (I/O1L)
/DataBus2: J1.23, U1.18 (I/O2L)
/DataBus3: J1.24, U1.19 (I/O3L)
/DataBus4: J1.25, U1.20 (I/O4L)
/DataBus5: J1.26, U1.21 (I/O5L)
/DataBus6: J1.27, U1.22 (I/O6L)
/DataBus7: J1.28, U1.23 (I/O7L)
/~PI: J1.29, U1.2 (WL)
/~PO: J1.30, U1.5 (OEL)
GND: A1.4 (GND), A1.18 (AREF), A1.29 (GND), C1.2, J1.1, J1.31, J1.32, J1.33, J1.34, J1.35, J1.36, J1.37, J1.38, J1.39, J1.40, U1.1 (CEL), U1.3 (A11L), U1.4 (A10L), U1.24 (GND), U1.44 (A10R), U1.45 (A11R), U1.47 (CER)
unnamed: A1.5 (D2), U1.46 (WR)
unnamed: A1.6 (D3), U1.43 (OER)
VCC: A1.30 (VIN), C1.1, J1.2, U1.48 (VCC)

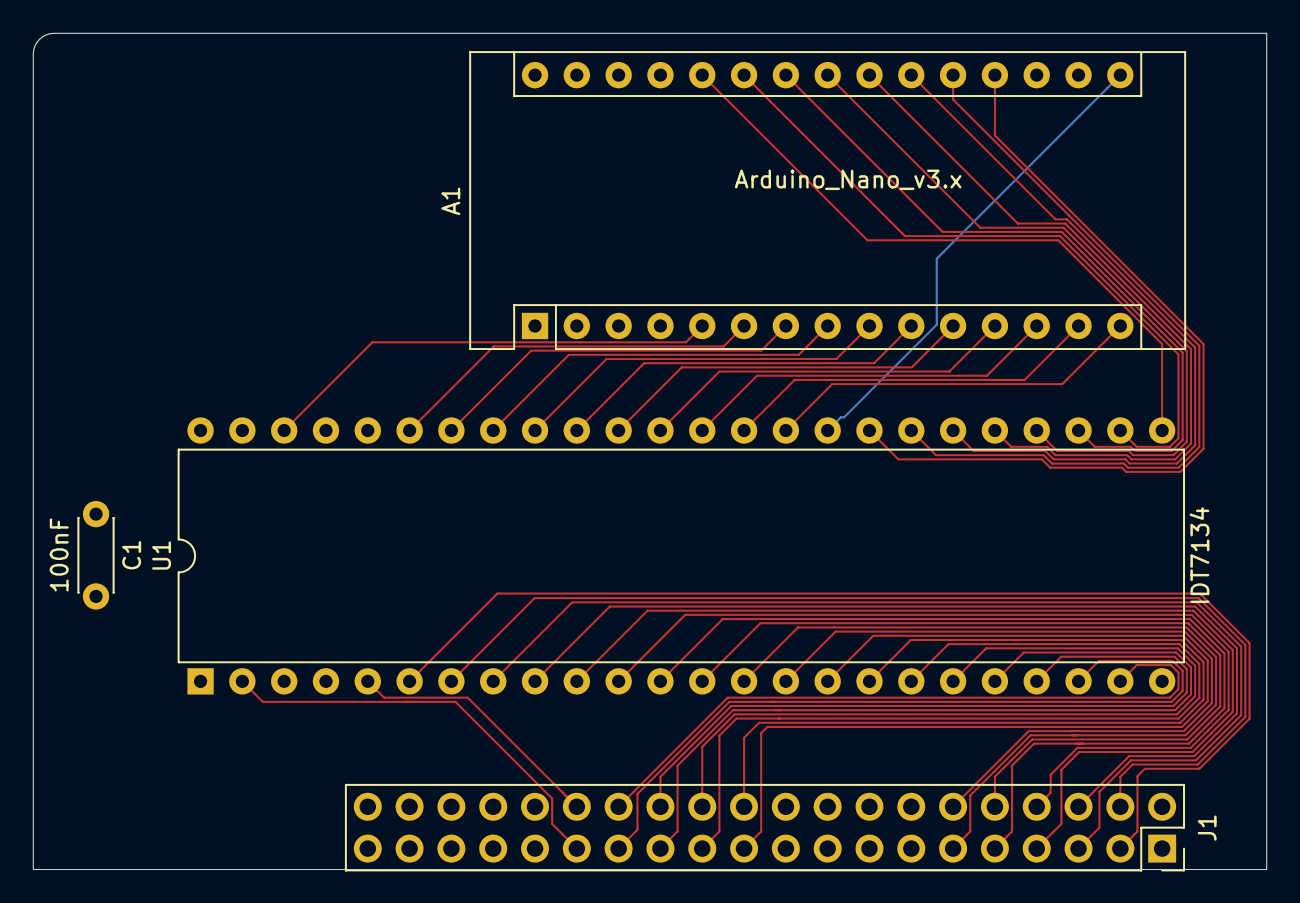
[picture p92: board ArduinoSerialCard.kicad_pcb from above]

Board: 4 copper layers, 74.9 x 50.8 mm, 4 parts (0 on the bottom side), 42 nets.
