foxostro/TurtleTTL/Schematics/Misc/LEDRiser16/LEDRiser16.kicad_pcb

## KiCad design Schematics/Misc/LEDRiser16/LEDRiser16.kicad_pcb (2019-10-09)

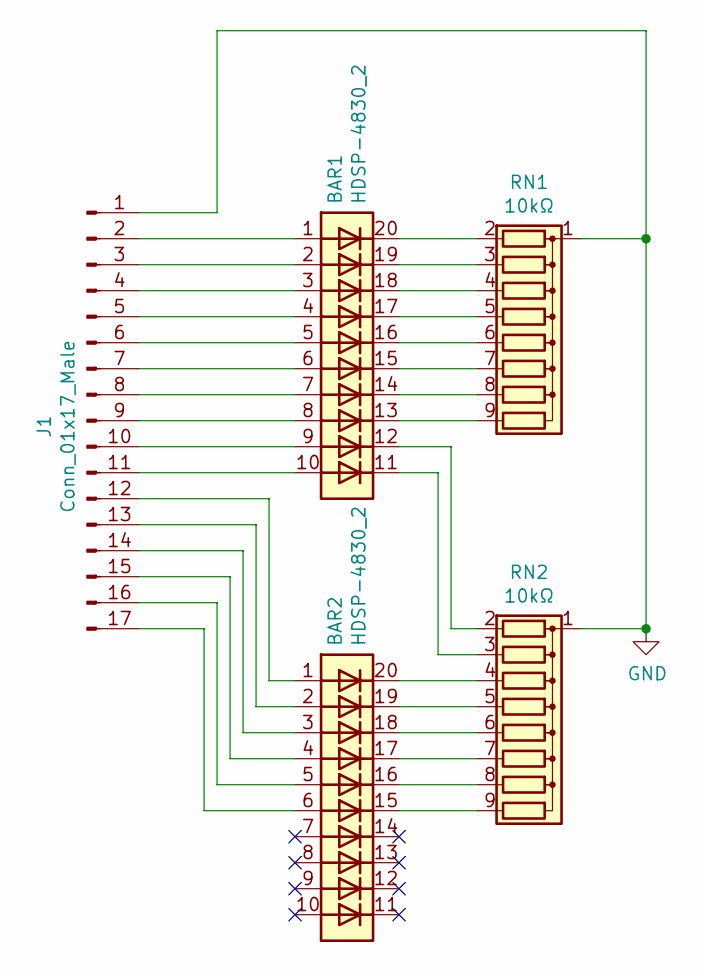
[picture p93: schematic LEDRiser16.sch]

Parts:
BAR1, BAR2: HDSP-4830_2; HDSP-4830
J1: Conn_01x17_Male; PinHeader_1x17_P2.54mm_Vertical
RN1, RN2: 10kΩ; R_Array_SIP9

Connections:
GND: J1.1, RN1.1 (common), RN2.1 (common)
unnamed: BAR1.1 (A), J1.2
unnamed: BAR1.2 (A), J1.3
unnamed: BAR1.3 (A), J1.4
unnamed: BAR1.4 (A), J1.5
unnamed: BAR1.5 (A), J1.6
unnamed: BAR1.6 (A), J1.7
unnamed: BAR1.7 (A), J1.8
unnamed: BAR1.8 (A), J1.9
unnamed: BAR1.9 (A), J1.10
unnamed: BAR1.10 (A), J1.11
unnamed: BAR1.11 (K), RN2.3 (R2)
unnamed: BAR1.12 (K), RN2.2 (R1)
unnamed: BAR1.13 (K), RN1.9 (R8)
unnamed: BAR1.14 (K), RN1.8 (R7)
unnamed: BAR1.15 (K), RN1.7 (R6)
unnamed: BAR1.16 (K), RN1.6 (R5)
unnamed: BAR1.17 (K), RN1.5 (R4)
unnamed: BAR1.18 (K), RN1.4 (R3)
unnamed: BAR1.19 (K), RN1.3 (R2)
unnamed: BAR1.20 (K), RN1.2 (R1)
unnamed: BAR2.1 (A), J1.12
unnamed: BAR2.2 (A), J1.13
unnamed: BAR2.3 (A), J1.14
unnamed: BAR2.4 (A), J1.15
unnamed: BAR2.5 (A), J1.16
unnamed: BAR2.6 (A), J1.17
unnamed: BAR2.15 (K), RN2.9 (R8)
unnamed: BAR2.16 (K), RN2.8 (R7)
unnamed: BAR2.17 (K), RN2.7 (R6)
unnamed: BAR2.18 (K), RN2.6 (R5)
unnamed: BAR2.19 (K), RN2.5 (R4)
unnamed: BAR2.20 (K), RN2.4 (R3)

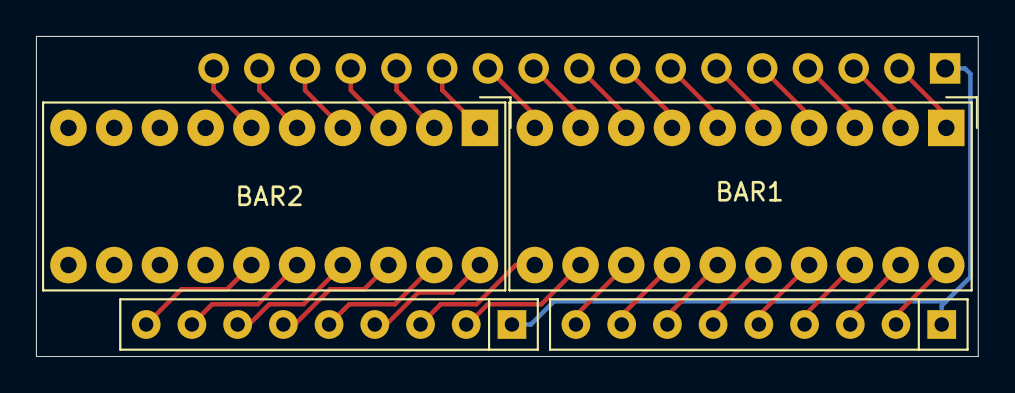
[picture p94: board LEDRiser16.kicad_pcb from above]

Board: 2 copper layers, 52.3 x 17.8 mm, 5 parts (1 on the bottom side), 33 nets.
