foxostro/TurtleTTL/Schematics/MainBoard/MainBoard.kicad_pcb

## KiCad design Schematics/MainBoard/MainBoard.kicad_pcb (2019-10-09)

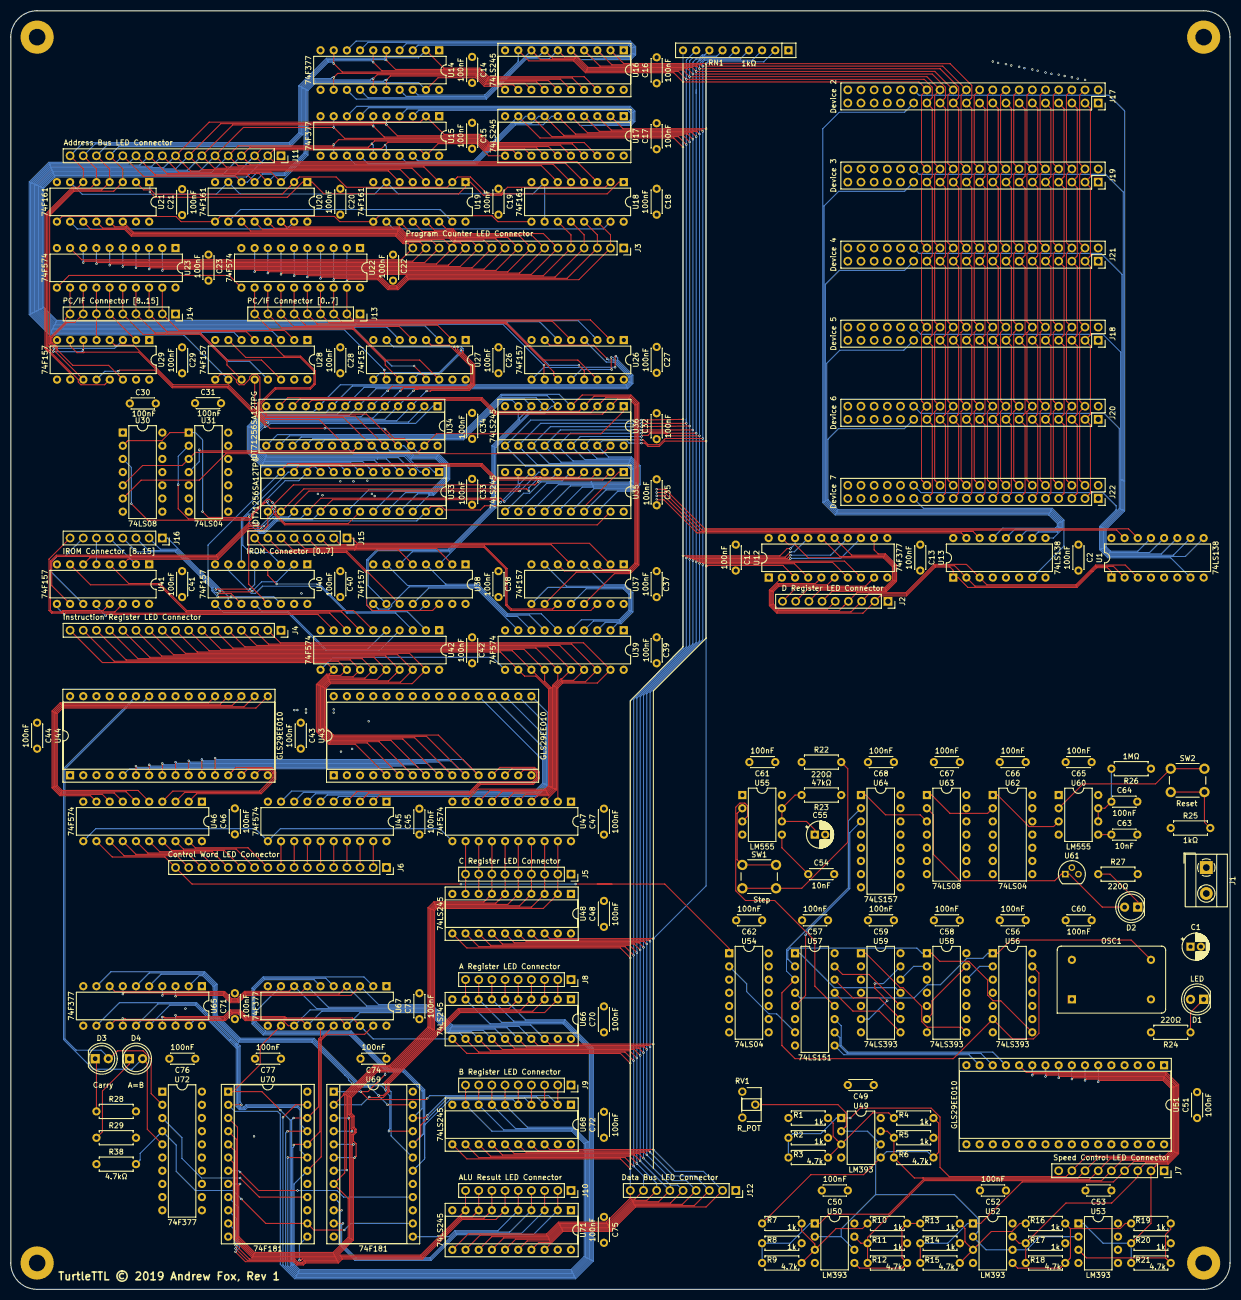
[picture p95: board MainBoard.kicad_pcb from above]

Board: 6 copper layers, 234.9 x 246.4 mm, 188 parts (0 on the bottom side), 286 nets.

Parts:
C1, C55: 10µF; CP_Radial_D5.0mm_P2.00mm
C2, C12, C13, C14, C15, C16, C17, C18, C19, C20, C21, C22, C23, C26, C27, C28, C29, C30, C31, C32, C33, C34, C35, C37, C38, C39, C40, C41, C42, C43, C44, C45, C46, C47, C48, C49, C50, C51, C52, C53, C56, C57, C58, C59, C60, C61, C62, C64, C65, C66, C67, C68, C70, C71, C72, C73, C74, C75, C76, C77: 100nF; C_Disc_D4.3mm_W1.9mm_P5.00mm
C54, C63: 10nF; C_Disc_D4.3mm_W1.9mm_P5.00mm
D1, D2, D3, D4: LED; LED_D5.0mm
H1, H2, H3, H4: MountingHole_Pad; MountingHole_3.2mm_M3_Pad
J1: DC Power +5V; TerminalBlock_MetzConnect_Type055_RT01502HDWU_1x02_P5.00mm_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
J2: D Register LED Connector; PinSocket_1x09_P2.54mm_Vertical
J3: Program Counter LED Connector; PinSocket_1x17_P2.54mm_Vertical
J4: Instruction Register LED Connector; PinSocket_1x17_P2.54mm_Vertical
J5: C Register LED Connector; PinSocket_1x09_P2.54mm_Vertical
J6: Control Word LED Connector; PinSocket_1x17_P2.54mm_Vertical
J7: Speed Control LED Connector; PinSocket_1x09_P2.54mm_Vertical
J8: A Register LED Connector; PinSocket_1x09_P2.54mm_Vertical
J9: B Register LED Connector; PinSocket_1x09_P2.54mm_Vertical
J10: ALU Result LED Connector; PinSocket_1x09_P2.54mm_Vertical
J11: Address Bus LED Connector; PinSocket_1x17_P2.54mm_Vertical
J12: Data Bus LED Connector; PinSocket_1x09_P2.54mm_Vertical
J13: PC/IF Connector [0..7]; PinSocket_1x09_P2.54mm_Vertical
J14: PC/IF Connector [8..15]; PinSocket_1x09_P2.54mm_Vertical
J15: IROM Connector [0..7]; PinSocket_1x08_P2.54mm_Vertical
J16: IROM Connector [8..15]; PinSocket_1x08_P2.54mm_Vertical
J17: Device 2; PinSocket_2x20_P2.54mm_Vertical
J18: Device 5; PinSocket_2x20_P2.54mm_Vertical
J19: Device 3; PinSocket_2x20_P2.54mm_Vertical
J20: Device 6; PinSocket_2x20_P2.54mm_Vertical
J21: Device 4; PinSocket_2x20_P2.54mm_Vertical
J22: Device 7; PinSocket_2x20_P2.54mm_Vertical
OSC1: 10MHz; Oscillator_DIP-14
R1, R2, R4, R5, R7, R8, R10, R11, R13, R14, R16, R17, R19, R20: 1k; R_Axial_DIN0207_L6.3mm_D2.5mm_P7.62mm_Horizontal
R3, R6, R9, R12, R15, R18, R21: 4.7k; R_Axial_DIN0207_L6.3mm_D2.5mm_P7.62mm_Horizontal
R22, R24, R27, R28, R29: 220Ω; R_Axial_DIN0207_L6.3mm_D2.5mm_P7.62mm_Horizontal
R23: 47kΩ; R_Axial_DIN0207_L6.3mm_D2.5mm_P7.62mm_Horizontal
R25: 1kΩ; R_Axial_DIN0207_L6.3mm_D2.5mm_P7.62mm_Horizontal
R26: 1MΩ; R_Axial_DIN0207_L6.3mm_D2.5mm_P7.62mm_Horizontal
R38: 4.7kΩ; R_Axial_DIN0207_L6.3mm_D2.5mm_P7.62mm_Horizontal
RN1: 1kΩ; R_Array_SIP9
RV1: R_POT; Potentiometer_ACP_CA6-H2,5_Horizontal
SW1: Step; SW_PUSH_6mm_H5mm
SW2: Reset; SW_PUSH_6mm_H5mm
U1, U13: 74LS138; DIP-16_W7.62mm
U12, U14, U15, U65, U67, U72: 74F377; DIP-20_W7.62mm
U16, U17, U35, U36, U48, U66, U68, U71: 74LS245; DIP-20_W7.62mm_Socket
U18, U19, U20, U21: 74F161; DIP-16_W7.62mm
U22, U23, U39, U42, U45, U46, U47: 74F574; DIP-20_W7.62mm
U26, U27, U28, U29, U37, U38, U40, U41: 74F157; DIP-16_W7.62mm
U30, U63: 74LS08; DIP-14_W7.62mm
U31, U54, U62: 74LS04; DIP-14_W7.62mm
U33, U34: IDT71256SA12TPG; DIP-28_W7.62mm_Socket
U43, U44, U51: GLS29EE010; DIP-32_W15.24mm_Socket
U49, U50, U52, U53: LM393; DIP-8_W7.62mm
U55, U60: LM555; DIP-8_W7.62mm
U56, U58, U59: 74LS393; DIP-14_W7.62mm
U57: 74LS151; DIP-16_W7.62mm
U61: MCP100-450D; TO-92
U64: 74LS157; DIP-16_W7.62mm
U69, U70: 74F181; DIP-24_W15.24mm_Socket

Connections:
/ALU/A=B: R38.2, U69.14, U70.14, U72.4
/ALU/AluResult0: J10.2, U69.9, U71.2
/ALU/AluResult1: J10.3, U69.10, U71.3
/ALU/AluResult2: J10.4, U69.11, U71.4
/ALU/AluResult3: J10.5, U69.13, U71.5
/ALU/AluResult4: J10.6, U70.9, U71.6
/ALU/AluResult5: J10.7, U70.10, U71.7
/ALU/AluResult6: J10.8, U70.11, U71.8
/ALU/AluResult7: J10.9, U70.13, U71.9
/ALU/Cn+4: U70.16, U72.3
A0: J8.2, U65.2, U66.2, U69.2
A1: J8.3, U65.5, U66.3, U69.23
A2: J8.4, U65.6, U66.4, U69.21
A3: J8.5, U65.9, U66.5, U69.19
A4: J8.6, U65.12, U66.6, U70.2
A5: J8.7, U65.15, U66.7, U70.23
A6: J8.8, U65.16, U66.8, U70.21
A7: J8.9, U65.19, U66.9, U70.19
AddressBus0: J11.2, J17.3, J18.3, J19.3, J20.3, J21.3, J22.3, U15.19, U17.11, U18.3, U26.3
AddressBus1: J11.3, J17.4, J18.4, J19.4, J20.4, J21.4, J22.4, U15.16, U17.12, U18.4, U26.6
AddressBus2: J11.4, J17.5, J18.5, J19.5, J20.5, J21.5, J22.5, U15.15, U17.13, U18.5, U26.13
AddressBus3: J11.5, J17.6, J18.6, J19.6, J20.6, J21.6, J22.6, U15.12, U17.14, U18.6, U26.10
AddressBus4: J11.6, J17.7, J18.7, J19.7, J20.7, J21.7, J22.7, U15.9, U17.15, U19.3, U27.3
AddressBus5: J11.7, J17.8, J18.8, J19.8, J20.8, J21.8, J22.8, U15.6, U17.16, U19.4, U27.6
AddressBus6: J11.8, J17.9, J18.9, J19.9, J20.9, J21.9, J22.9, U15.5, U17.17, U19.5, U27.13
AddressBus7: J11.9, J17.10, J18.10, J19.10, J20.10, J21.10, J22.10, U15.2, U17.18, U19.6, U27.10
AddressBus8: J11.10, J17.11, J18.11, J19.11, J20.11, J21.11, J22.11, U14.19, U16.11, U20.3, U28.3
AddressBus9: J11.11, J17.12, J18.12, J19.12, J20.12, J21.12, J22.12, U14.16, U16.12, U20.4, U28.6
AddressBus10: J11.12, J17.13, J18.13, J19.13, J20.13, J21.13, J22.13, U14.15, U16.13, U20.5, U28.13
AddressBus11: J11.13, J17.14, J18.14, J19.14, J20.14, J21.14, J22.14, U14.12, U16.14, U20.6, U28.10
AddressBus12: J11.14, J17.15, J18.15, J19.15, J20.15, J21.15, J22.15, U14.9, U16.15, U21.3, U29.3
AddressBus13: J11.15, J17.16, J18.16, J19.16, J20.16, J21.16, J22.16, U14.6, U16.16, U21.4, U29.6
AddressBus14: J11.16, J17.17, J18.17, J19.17, J20.17, J21.17, J22.17, U14.5, U16.17, U21.5, U29.13
AddressBus15: J11.17, J17.18, J18.18, J19.18, J20.18, J21.18, J22.18, U14.2, U16.18, U21.6, U29.10
B0: J9.2, U67.2, U68.2, U69.1
B1: J9.3, U67.5, U68.3, U69.22
B2: J9.4, U67.6, U68.4, U69.20
B3: J9.5, U67.9, U68.5, U69.18
B4: J9.6, U67.12, U68.6, U70.1
B5: J9.7, U67.15, U68.7, U70.22
B6: J9.8, U67.16, U68.8, U70.20
B7: J9.9, U67.19, U68.9, U70.18
C0: J5.2, U47.19, U48.2, U69.6, U70.6
C1: J5.3, U47.18, U48.3, U69.5, U70.5
C2: J5.4, U47.17, U48.4, U69.4, U70.4
C3: J5.5, U47.16, U48.5, U69.3, U70.3
C4: J5.6, U47.15, U48.6, U69.7
C5: J5.7, U47.14, U48.7, U69.8, U70.8
C6: J5.8, U47.13, U48.8
C7: J5.9, U47.12, U48.9
CLK: U57.5, U64.3
ClockRate0: U51.13, U57.11
ClockRate1: U51.14, U57.10
ClockRate2: U51.15, U57.9
ControlClock: U18.2, U19.2, U20.2, U21.2, U22.11, U23.11, U39.11, U42.11, U45.11, U46.11, U47.11, U64.4
D0: J2.2, U1.1, U12.2, U13.1
D1: J2.3, U1.2, U12.5, U13.2
D2: J2.4, U1.3, U12.6, U13.3
D3: J2.5, U12.9
D4: J2.6, U12.12
D5: J2.7, U12.15
D6: J2.8, U12.16
D7: J2.9, U12.19
DataBus0: J12.2, J17.21, J18.21, J19.21, J20.21, J21.21, J22.21, RN1.2, U12.3, U14.3, U15.3, U16.2, U17.2, U35.18, U36.18, U48.18, U65.3, U66.18, U67.3, U68.18, U71.18
DataBus1: J12.3, J17.22, J18.22, J19.22, J20.22, J21.22, J22.22, RN1.3, U12.4, U14.4, U15.4, U16.3, U17.3, U35.17, U36.17, U48.17, U65.4, U66.17, U67.4, U68.17, U71.17
DataBus2: J12.4, J17.23, J18.23, J19.23, J20.23, J21.23, J22.23, RN1.4, U12.7, U14.7, U15.7, U16.4, U17.4, U35.16, U36.16, U48.16, U65.7, U66.16, U67.7, U68.16, U71.16
DataBus3: J12.5, J17.24, J18.24, J19.24, J20.24, J21.24, J22.24, RN1.5, U12.8, U14.8, U15.8, U16.5, U17.5, U35.15, U36.15, U48.15, U65.8, U66.15, U67.8, U68.15, U71.15
DataBus4: J12.6, J17.25, J18.25, J19.25, J20.25, J21.25, J22.25, RN1.6, U12.13, U14.13, U15.13, U16.6, U17.6, U35.14, U36.14, U48.14, U65.13, U66.14, U67.13, U68.14, U71.14
DataBus5: J12.7, J17.26, J18.26, J19.26, J20.26, J21.26, J22.26, RN1.7, U12.14, U14.14, U15.14, U16.7, U17.7, U35.13, U36.13, U48.13, U65.14, U66.13, U67.14, U68.13, U71.13
DataBus6: J12.8, J17.27, J18.27, J19.27, J20.27, J21.27, J22.27, RN1.8, U12.17, U14.17, U15.17, U16.8, U17.8, U35.12, U36.12, U48.12, U65.17, U66.12, U67.17, U68.12, U71.12
DataBus7: J12.9, J17.28, J18.28, J19.28, J20.28, J21.28, J22.28, RN1.9, U12.18, U14.18, U15.18, U16.9, U17.9, U35.11, U36.11, U48.11, U65.18, U66.11, U67.18, U68.11, U71.11
FixedRateClock: J17.20, J18.20, J19.20, J20.20, J21.20, J22.20, U56.6, U56.13, U57.3, U64.2
GND: C1.2, C2.2, C12.2, C13.2, C14.2, C15.2, C16.2, C17.2, C18.2, C19.2, C20.2, C21.2, C22.2, C23.2, C26.2, C27.2, C28.2, C29.2, C30.2, C31.2, C32.2, C33.2, C34.2, C35.2, C37.2, C38.2, C39.2, C40.2, C41.2, C42.2, C43.2, C44.2, C45.2, C46.2, C47.2, C48.2, C49.2, C50.2, C51.2, C52.2, C53.2, C54.2, C55.2, C56.2, C57.2, C58.2, C59.2, C60.2, C61.2, C62.2, C63.2, C64.2, C65.2, C66.2, C67.2, C68.2, C70.2, C71.2, C72.2, C73.2, C74.2, C75.2, C76.2, C77.2, H1.1, H2.1, H3.1, H4.1, J1.1, J2.1, J3.1, J4.1, J5.1, J6.1, J7.1, J8.1, J9.1, J10.1, J11.1, J12.1, J14.1, J17.1, J17.31, J17.32, J17.33, J17.34, J17.35, J17.36, J17.37, J17.38, J17.39, J17.40, J18.1, J18.31, J18.32, J18.33, J18.34, J18.35, J18.36, J18.37, J18.38, J18.39, J18.40, J19.1, J19.31, J19.32, J19.33, J19.34, J19.35, J19.36, J19.37, J19.38, J19.39, J19.40, J20.1, J20.31, J20.32, J20.33, J20.34, J20.35, J20.36, J20.37, J20.38, J20.39, J20.40, J21.1, J21.31, J21.32, J21.33, J21.34, J21.35, J21.36, J21.37, J21.38, J21.39, J21.40, J22.1, J22.31, J22.32, J22.33, J22.34, J22.35, J22.36, J22.37, J22.38, J22.39, J22.40, OSC1.7, R1.1, R24.2, R27.2, R28.2, R29.2, RN1.1, RV1.3, U1.8, U12.10, U13.8, U14.10, U15.10, U16.1, U16.10, U17.1, U17.10, U18.8, U19.8, U20.8, U21.8, U22.1, U22.10, U23.1, U23.10, U26.8, U26.15, U27.8, U27.15, U28.8, U28.15, U29.8, U29.15, U33.14, U33.20, U34.14, U34.20, U35.10, U36.10, U37.8, U37.15, U38.8, U38.15, U39.1, U39.10, U40.8, U40.15, U41.8, U41.15, U42.1, U42.10, U43.2, U43.3, U43.4, U43.16, U43.22, U43.23, U43.24, U43.25, U43.28, U43.29, U44.2, U44.3, U44.4, U44.16, U44.22, U44.23, U44.24, U44.25, U44.28, U44.29, U45.1, U45.10, U46.1, U46.10, U47.1, U47.10, U48.10, U51.2, U51.3, U51.4, U51.5, U51.16, U51.17, U51.18, U51.19, U51.20, U51.21, U51.22, U51.23, U51.24, U51.25, U51.26, U51.27, U51.28, U51.29, U55.1, U56.2, U56.12, U57.8, U58.2, U58.12, U59.2, U59.12, U60.1, U61.3, U64.5, U64.6, U64.7, U64.8, U64.9, U64.10, U64.11, U64.12, U64.13, U64.14, U64.15, U65.10, U66.10, U67.10, U68.10, U69.12, U70.12, U71.10, U72.10
IR0: J4.2, U39.19, U47.2
IR1: J4.3, U39.18, U47.3
IR2: J4.4, U39.17, U47.4
IR3: J4.5, U39.16, U47.5
IR4: J4.6, U39.15, U47.6
IR5: J4.7, U39.14, U47.7
IR6: J4.8, U39.13, U47.8
IR7: J4.9, U39.12, U47.9
IR8: J4.10, U42.19, U43.12, U44.12
IR9: J4.11, U42.18, U43.11, U44.11
IR10: J4.12, U42.17, U43.10, U44.10
IR11: J4.13, U42.16, U43.9, U44.9
IR12: J4.14, U42.15, U43.8, U44.8
IR13: J4.15, U42.14, U43.7, U44.7
IR14: J4.16, U42.13, U43.6, U44.6
IR15: J4.17, U42.12, U43.5, U44.5
IRAM0: U34.11, U36.2, U37.3
IRAM1: U34.12, U36.3, U37.6
IRAM2: U34.13, U36.4, U37.10
IRAM3: U34.15, U36.5, U37.13
IRAM4: U34.16, U36.6, U38.3
IRAM5: U34.17, U36.7, U38.6
IRAM6: U34.18, U36.8, U38.10
IRAM7: U34.19, U36.9, U38.13
IRAM8: U33.11, U35.2, U40.3
IRAM9: U33.12, U35.3, U40.6
IRAM10: U33.13, U35.4, U40.10
IRAM11: U33.15, U35.5, U40.13
IRAM12: U33.16, U35.6, U41.3
IRAM13: U33.17, U35.7, U41.6
IRAM14: U33.18, U35.8, U41.10
IRAM15: U33.19, U35.9, U41.13
IRAMAddr0: U26.4, U33.10, U34.10
IRAMAddr1: U26.7, U33.9, U34.9
IRAMAddr2: U26.12, U33.8, U34.8
IRAMAddr3: U26.9, U33.7, U34.7
IRAMAddr4: U27.4, U33.6, U34.6
IRAMAddr5: U27.7, U33.5, U34.5
IRAMAddr6: U27.12, U33.4, U34.4
IRAMAddr7: U27.9, U33.3, U34.3
IRAMAddr8: U28.4, U33.25, U34.25
IRAMAddr9: U28.7, U33.24, U34.24
IRAMAddr10: U28.12, U33.21, U34.21
IRAMAddr11: U28.9, U33.23, U34.23
IRAMAddr12: U29.4, U33.2, U34.2
IRAMAddr13: U29.7, U33.26, U34.26
IRAMAddr14: U29.12, U33.1, U34.1
IROM0: J15.1, U37.2
IROM1: J15.2, U37.5
IROM2: J15.3, U37.11
IROM3: J15.4, U37.14
IROM4: J15.5, U38.2
IROM5: J15.6, U38.5
IROM6: J15.7, U38.11
IROM7: J15.8, U38.14
IROM8: J16.1, U40.2
IROM9: J16.2, U40.5
IROM10: J16.3, U40.11
IROM11: J16.4, U40.14
IROM12: J16.5, U41.2
IROM13: J16.6, U41.5
IROM14: J16.7, U41.11
IROM15: J16.8, U41.14
unnamed: C54.1, U55.5
unnamed: C55.1, R23.2, U55.6, U55.7
unnamed: C63.1, U60.5
unnamed: C64.1, R26.2, U60.6, U60.7
unnamed: D1.1, R24.1
unnamed: D2.1, R27.1
unnamed: D2.2, U61.1, U63.2
unnamed: D3.1, R28.1
unnamed: D4.1, R29.1
unnamed: J7.2, R20.1, R21.1, U51.12, U53.1
unnamed: J7.3, R17.1, R18.1, U51.11, U52.7
unnamed: J7.4, R14.1, R15.1, U51.10, U52.1
unnamed: J7.5, R11.1, R12.1, U50.7, U51.9
unnamed: J7.6, R8.1, R9.1, U50.1, U51.8
unnamed: J7.7, R5.1, R6.1, U49.7, U51.7
unnamed: J7.8, R2.1, R3.1, U49.1, U51.6
unnamed: OSC1.8, U56.1, U57.4
unnamed: R1.2, R3.2, R4.1, U49.3
unnamed: R4.2, R6.2, R7.1, U49.5
unnamed: R7.2, R9.2, R10.1, U50.3
unnamed: R10.2, R12.2, R13.1, U50.5
unnamed: R13.2, R15.2, R16.1, U52.3
unnamed: R16.2, R18.2, R19.1, U52.5
unnamed: R19.2, R21.2, U53.3
unnamed: R22.2, SW1.2
unnamed: R25.2, SW2.2
unnamed: RV1.2, U49.2, U49.6, U50.2, U50.6, U52.2, U52.6, U53.2
unnamed: SW1.1, U55.2
unnamed: SW2.1, U60.2
unnamed: U18.15, U19.10
unnamed: U19.15, U20.10
unnamed: U20.15, U21.10
unnamed: U30.3, U35.19
unnamed: U30.6, U36.19
unnamed: U31.2, U33.22
unnamed: U31.4, U34.22
unnamed: U37.4, U39.2
unnamed: U37.7, U39.3
unnamed: U37.9, U39.4
unnamed: U37.12, U39.5
unnamed: U38.4, U39.6
unnamed: U38.7, U39.7
unnamed: U38.9, U39.8
unnamed: U38.12, U39.9
unnamed: U40.4, U42.2
unnamed: U40.7, U42.3
unnamed: U40.9, U42.4
unnamed: U40.12, U42.5
unnamed: U41.4, U42.6
unnamed: U41.7, U42.7
unnamed: U41.9, U42.8
unnamed: U41.12, U42.9
unnamed: U43.13, U45.2
unnamed: U43.14, U45.3
unnamed: U43.15, U45.4
unnamed: U43.17, U45.5
unnamed: U43.18, U45.6
unnamed: U43.19, U45.7
unnamed: U43.20, U45.8
unnamed: U43.21, U45.9
unnamed: U44.13, U46.2
unnamed: U44.14, U46.3
unnamed: U44.15, U46.4
unnamed: U44.17, U46.5
unnamed: U44.18, U46.6
unnamed: U44.19, U46.7
unnamed: U44.20, U46.8
unnamed: U44.21, U46.9
unnamed: U54.2, U57.7
unnamed: U55.3, U57.12
unnamed: U56.8, U57.2, U58.1
unnamed: U57.1, U59.11
unnamed: U57.13, U59.8
unnamed: U57.14, U59.9
unnamed: U57.15, U59.10
unnamed: U58.8, U59.1
unnamed: U58.6, U58.13
unnamed: U59.6, U59.13
unnamed: U60.3, U62.1
unnamed: U62.2, U63.1
unnamed: U69.16, U70.7
PC0: J3.2, U18.14, U22.2
PC1: J3.3, U18.13, U22.3
PC2: J3.4, U18.12, U22.4
PC3: J3.5, U18.11, U22.5
PC4: J3.6, U19.14, U22.6
PC5: J3.7, U19.13, U22.7
PC6: J3.8, U19.12, U22.8
PC7: J3.9, U19.11, U22.9
PC8: J3.10, U20.14, U23.2
PC9: J3.11, U20.13, U23.3
PC10: J3.12, U20.12, U23.4
PC11: J3.13, U20.11, U23.5
PC12: J3.14, U21.14, U23.6
PC13: J3.15, U21.13, U23.7
PC14: J3.16, U21.12, U23.8
PC15: J3.17, U21.11, U23.9, U37.1, U38.1, U40.1, U41.1
PC_IF0: J13.2, U22.19, U26.2
PC_IF1: J13.3, U22.18, U26.5
PC_IF2: J13.4, U22.17, U26.14
PC_IF3: J13.5, U22.16, U26.11
PC_IF4: J13.6, U22.15, U27.2
PC_IF5: J13.7, U22.14, U27.5
PC_IF6: J13.8, U22.13, U27.14
PC_IF7: J13.9, U22.12, U27.11
PC_IF8: J14.2, U23.19, U28.2
PC_IF9: J14.3, U23.18, U28.5
PC_IF10: J14.4, U23.17, U28.14
PC_IF11: J14.5, U23.16, U28.11
PC_IF12: J14.6, U23.15, U29.2
PC_IF13: J14.7, U23.14, U29.5
PC_IF14: J14.8, U23.13, U29.14
PC_IF15: J14.9, U23.12, U26.1, U27.1, U28.1, U29.1, U29.11
RegisterClock: D1.2, J17.19, J18.19, J19.19, J20.19, J21.19, J22.19, U12.11, U14.11, U15.11, U57.6, U65.11, U67.11, U72.11
VCC: C1.1, C2.1, C12.1, C13.1, C14.1, C15.1, C16.1, C17.1, C18.1, C19.1, C20.1, C21.1, C22.1, C23.1, C26.1, C27.1, C28.1, C29.1, C30.1, C31.1, C32.1, C33.1, C34.1, C35.1, C37.1, C38.1, C39.1, C40.1, C41.1, C42.1, C43.1, C44.1, C45.1, C46.1, C47.1, C48.1, C49.1, C50.1, C51.1, C52.1, C53.1, C56.1, C57.1, C58.1, C59.1, C60.1, C61.1, C62.1, C65.1, C66.1, C67.1, C68.1, C70.1, C71.1, C72.1, C73.1, C74.1, C75.1, C76.1, C77.1, J1.2, J13.1, J17.2, J18.2, J19.2, J20.2, J21.2, J22.2, OSC1.14, R2.2, R5.2, R8.2, R11.2, R14.2, R17.2, R20.2, R22.1, R23.1, R25.1, R26.1, R38.1, RV1.1, U1.6, U1.16, U12.20, U13.6, U13.16, U14.20, U15.20, U16.20, U17.20, U18.7, U18.10, U18.16, U19.7, U19.16, U20.7, U20.16, U21.7, U21.15, U21.16, U22.20, U23.20, U26.16, U27.16, U28.16, U29.16, U33.28, U34.28, U35.20, U36.20, U37.16, U38.16, U39.20, U40.16, U41.16, U42.20, U43.31, U43.32, U44.31, U44.32, U45.20, U46.20, U47.20, U48.1, U48.20, U51.31, U51.32, U55.4, U55.8, U56.3, U56.4, U56.5, U56.9, U56.10, U56.11, U57.16, U58.3, U58.4, U58.5, U58.9, U58.10, U58.11, U59.3, U59.4, U59.5, U60.4, U60.8, U61.2, U64.16, U65.20, U66.1, U66.20, U67.20, U68.1, U68.20, U69.24, U70.24, U71.1, U71.20, U72.20
~A=B: D4.2, U43.27, U44.27, U72.5
~AI: J6.13, U46.16, U65.1
~AO: J6.12, U46.17, U66.19
~BI: J6.15, U46.14, U67.1
~BO: J6.14, U46.15, U68.19
~CO: J6.2, U45.19, U48.19
~CarryOut: D3.2, U43.26, U44.26, U72.2
~DI: J6.16, U12.1, U46.13
~EO: J6.10, U46.19, U71.19
~FI: J6.11, U46.18, U72.1
~HLT: J6.17, U46.12, U54.1
~J: J6.3, U18.9, U19.9, U20.9, U21.9, U45.18
~PI: J6.9, U13.4, U13.5, U45.12
~PI0: U13.15, U30.2, U31.1, U33.27, U35.1
~PI1: U13.14, U30.5, U31.3, U34.27, U36.1
~PI2: J17.29, U13.13
~PI3: J19.29, U13.12
~PI4: J21.29, U13.11
~PI5: J18.29, U13.10
~PI6: J20.29, U13.9
~PI7: J22.29, U13.7
~PO: J6.8, U1.4, U1.5, U45.13
~PO0: U1.15, U30.1
~PO1: U1.14, U30.4
~PO2: J17.30, U1.13
~PO3: J19.30, U1.12
~PO4: J21.30, U1.11
~PO5: J18.30, U1.10
~PO6: J20.30, U1.9
~PO7: J22.30, U1.7
~RST: U18.1, U19.1, U20.1, U21.1, U63.3, U64.1
~XI: J6.5, U14.1, U45.16
~XO: J6.7, U16.19, U45.14
~YI: J6.4, U15.1, U45.17
~YO: J6.6, U17.19, U45.15
