foxostro/TurtleTTL/(commit log)

2019-07-01 Intial commit
    [TheMachine.kicad_pcb, TheMachine.sch]
2019-07-01 Added "Rotary Switch Encoder" schematic.
    [TheMachine.sch]
2019-07-06 Add pull-up resistors to the rotary switch outputs.
2019-07-06 Moved the Rotary Switch Encoder to a hierarchical sheet.
    [Rotary Switch Encoder.sch, TheMachine.sch]
2019-07-06 Add blank hierarchical sheets for all modules in my paper schematics.
    [ALU.sch, Bus Display.sch, Clock.sch, Control Word DIsplay.sch, Data RAM.sch, Execute.sch, Instruction Decoder.sch, Instruction RAM.sch]
2019-07-06 Rename The Machine to Firenze.
    [Bus Display.sch, Clock.sch, Control Word DIsplay.sch, Data RAM.sch, Execute.sch, Firenze.sch, Instruction Decoder.sch, Instruction RAM.sch]
2019-07-06 Add the Power-on Circuit.
    [Power-on Reset.sch]
2019-07-06 Add the bus display module.
    [Bus Display.sch]
2019-07-06 Rename the sheet for the bus display module.
    [ALU.sch, Bus Display.sch, Clock.sch, Control Word DIsplay.sch, Data RAM.sch, Execute.sch, Firenze.sch, Instruction Decoder.sch]
2019-07-06 Add Register A
    [Power-on Reset.sch, Register A.sch]
2019-07-06 Add schematic for Register B.
    [Register A.sch, Register B.sch]
2019-07-06 Add Register D schematic.
    [ALU.sch, Bus Display.sch, Clock.sch, Control Word DIsplay.sch, Data RAM.sch, Execute.sch, Firenze.sch, Instruction Decoder.sch]
2019-07-06 Add comments to registers A and B.
    [Register A.sch, Register B.sch]
2019-07-06 Add output display.
    [ALU.sch, Bus Display.sch, Clock.sch, Control Word DIsplay.sch, Data RAM.sch, Execute.sch, Firenze.sch, Instruction Decoder.sch]
2019-07-06 Change the paper size fromm A4 to A.
    [ALU.sch, Bus Display.sch, Clock.sch, Control Word DIsplay.sch, Data RAM.sch, Execute.sch, Instruction Decoder.sch, Instruction RAM.sch]
2019-07-06 Add clock schematic
    [Clock.sch]
2019-07-06 Add titles to all sheets.
    [ALU.sch, Bus Display.sch, Control Word DIsplay.sch, Data RAM.sch, Execute.sch, Instruction Decoder.sch, Instruction RAM.sch, Instruction ROM.sch]
2019-07-07 Add Program Counter schematic.
    [Program Counter.sch]
2019-07-07 Rename "Output Register" to "Output Display".
    [Firenze.sch, Output Display.sch]
2019-07-07 Add LEDs to registers A and B.
    [Register A.sch, Register B.sch]
2019-07-07 Add PDF of the schematics too.
2019-07-07 Fix typo in "Control Word Display" sheet.
    [Firenze.sch]
2019-07-07 Some of these chips actually need to be 74F not 74LS.
    [Program Counter.sch, Register A.sch, Register B.sch, Register D.sch]
2019-07-08 Fixed incorect ground connection on crystal oscillator.
    [Clock.sch]
2019-07-08 Resize one of the hierarchical sheets.
    [Firenze.sch]
2019-07-08 Added schematic for Instruction ROM.
    [Instruction ROM.sch, Program Counter.sch]
2019-07-08 Added the Instruction Register schematic.
    [Instruction ROM.sch, Instruction Register.sch]
2019-07-08 Add description to top-level schematic.
    [Firenze.sch]
2019-07-08 Rotary Switch Encoder uses VCC power pin instead of +5V.
    [Rotary Switch Encoder.sch]
2019-07-08 Updated the schematic PDF.
2019-07-10 Change the power-on reset circuit.
    There's no need for a debounce circuit because the MCP100 has its own
    delay circuitry anyway.
    [Power-on Reset.sch]
2019-07-10 Add a TODO note for the rotary switch encoder.
    [ALU.sch, Bus Display.sch, Clock.sch, Control Word DIsplay.sch, Data RAM.sch, Execute.sch, Instruction Decoder.sch, Instruction RAM.sch]
2019-07-27 Move the schematics into a separate directory.
    [ALU.sch, Bus Display.sch, Clock.sch, Control Word DIsplay.sch, Data RAM.sch, Execute.sch, Instruction Decoder.sch, Instruction RAM.sch]
2019-07-28 Instruction ROM is backed by two ROM buffers.
    This mirrors the physical construction of the Instruction ROM circuit which
    uses two eight-bit EEPROM chips to form a sixteen-bit word.
2019-07-28 Instruction Decoder is backed by two ROM buffers.
    This mirrors the physical construction of the Instruction Decoder circuit
    which uses two eight-bit EEPROM chips to form a sixteen-bit word.
2019-07-28 Don't print verbosely while resetting the pipeline
2019-07-29 Add a bunch of labels to the UI and wire to model properties.
2019-07-29 Add a logger class so pipeline stages do not directly interact with NSLog.
2019-07-31 Add empty Assembler class
2019-07-31 Assembler can assemble a NOP.
2019-07-31 Assembler can generate a mov instruction.
    The ViewController uses the assembler to generate the example program.
2019-07-31 Added LI instruction to assembler.
2019-07-31 Assembler methods no longer require labels, making them more compact.
2019-07-31 Assembler can generate ADD instructions.
    The example program has been updated too.
2019-08-01 Add empty AssemblerBackEnd class
2019-08-01 The assembler back end can assemble a NOP now.
2019-08-01 Assembler back end can assemble a HLT
2019-08-01 Assembler back end can assemble a MOV now
2019-08-01 The assembler back end can assemble ADD
2019-08-01 CodeGenerator keeps track of the program counter during generation.
2019-08-01 The assembler back end can declare and resolve labels.
2019-08-01 The assembler back end can jump to a label defined above the jump.
2019-08-01 The ViewController uses the assembler back end to generate the example program.
2019-08-01 Display an error alert if the example program fails to assemble.
2019-08-01 Fix bug where Run/Stop button text does not change.
2019-08-02 Extract a framework out of the Simulator app.
2019-08-03 Added new class to handle the meat of the assembler command-line tool.
    The AssemblerCommandLineDriver class doesn't really do anything yet.
2019-08-17 Implement simulation of bank switching.
    TurtleTTL hardware uses the value in registerD to control bank switching.
    This causes loads and stores to be redirected to one of several available
    devices.
    Currently, the simulator supports the Output Display and Data RAM. Real
    hardware also has two banks of instruction RAM, but support for this is
    not yet implemented.
2019-08-17 Added Arduino sketch for computer interface module.
2019-08-17 Arduino module prints received value to serial interface.
    When the computer writes a byte to the Arduino module, the Arduino will
    print it out over the serial connection to the computer.
2019-08-18 Arduino should watch the clock pulse too.
2019-08-18 Rename to ArduinoSerialInterface.ino
2019-08-18 Example program prints "Hello, World!" to serial interface.
2019-08-18 Remove extraneous log output from Arduino sketch.
2019-08-18 Arduino waits for clock pulse differently.
2019-08-19 AssemblerCommandLineDriver uses TextOutputStream now.
    No longer uses the global stdout and stderr objects.
2019-08-19 Added assembler test that input file is present and is not a directory.
2019-08-19 Remove extraneous logging from assembler
2019-08-19 Added AssemblerFrontEnd class.
2019-08-19 AssemblerCommandLineDriver uses AssemblerFrontEnd
2019-08-19 Assembler compilation files when input file is not valid UTF-8 text.
2019-08-19 Compiling an invalid opcode causes an error.
    Otherwise, compiling a NOP causes a NOP to be inserted in the output.
2019-08-19 Opcodes are case insensitive.
2019-08-19 AssemblerFrontEnd actually invokes AssemblerBackEnd
2019-08-19 Added CMP instruction to assembler front-end
2019-08-19 Add assembler support for HLT.
2019-08-19 Refactor: Extract methods for creating assembler errors.
2019-08-20 Add AssemblerTokenizer
2019-08-20 AssemblerFrontEnd now uses AssemblerTokenizer
2019-08-21 Begin writing AssemblerScanner
2019-08-21 Rename Token to AssemblerToken since it is Assembler-specific
2019-08-21 Move methods from AssemblerScanner to TextInputStream
2019-08-21 Add AssemblerScanner.Rule to hold the rule.
2019-08-21 Remove AssemblerTokenizer, replace with AssemblerScanner.
    Also, add a new "eof" token to simlify some parsing logic.
2019-08-21 Extract AssemblerParser from AssemblerFrontEnd
2019-08-21 Assembler can declare labels now
2019-08-21 Assembler compiles JMP with label
2019-08-21 The assembler uses AssemblerError for most compilation related errors.
    This permits line numbers to be included in error messages coming out of
    the backend.
    Also, we pass down the token directly for things like label declarations.
    The tokens include information like the line number and could easily be
    extended to include additional information like the line offset.
2019-08-22 Add more unit tests for the assembler.
2019-08-22 Extract methods in AssemblerParser
2019-08-23 Break AssemblerBackEnd into AssemblerDeclarationPass and AssemblerCodeGenPass
2019-08-23 Move Token and TokenType out of AssemblerScanner, to module scope.
2019-08-24 Add STORE and LOAD to assembler too
2019-08-29 Add explanatory comment about AssemblerCodeGenPass.symbols.
2019-09-02 AssemblerCodeGenPass uses SymbolTable
2019-09-02 Split AssemblerParser into a piece specific to the assembler and a more generic piece.
2019-09-02 AssemblerScanner contains _only_ the assembler-specific logic.
2019-09-03 Replace the AssemblerDeclarationPass with a back patch process.
    Go back through the instruction stream and rewrite immediate values to
    insert final symbol values.
2019-09-04 Add ParserTests separately from AssemblerParserTests.
2019-09-05 AssemblerCodeGenPass can now return multiple errors.
2019-09-05 The assembler front end can report multiple errors.
2019-09-06 Assembly programs can include literal characters of the form 'X'.
    These are interpretted as another form of number.
2019-09-12 Add blank schematic for Speed Control.
    [Speed Control.sch, TurtleTTL.sch]
2019-09-12 Fill out the Speed Control circuit schematic.
    [Clock.sch, Instruction ROM.sch]
2019-09-12 Need decoupling capacitors on the Speed Control sheet.
    [Speed Control.sch]
2019-09-12 Fixed: The order of address lines in Speed Control did not match the breadboard circuit.
    [Speed Control.sch]
2019-09-12 Remove obsolete hierarchical sheets.
    [ALU.sch, Bus Display.sch, Clock.sch, Control Word DIsplay.sch, Data RAM.sch, Execute.sch, Instruction Decoder.sch, Instruction RAM.sch]
2019-09-12 Add a new, blank sheet for the XY register pair.
    [ALU.sch, Bus Display.sch, Clock.sch, Control Word DIsplay.sch, Data RAM.sch, Execute.sch, Instruction RAM.sch, Instruction ROM.sch]
2019-09-12 Add new, blank sheet for PC/IF register.
    [PC_IF.sch]
2019-09-12 Modify clock schematic to match breadboard circuit.
    The 74LS245 in the clock circuit has been removed because the we're now
    using the inverted clock to get the necessary phase shift.
    The RC values in the switch debounce circuit have been adjusted.
    The Halt signal is now active-low, HLT#.
    [Clock.sch]
2019-09-12 Add decoupling capacitors to the clock circuit.
    [Clock.sch]
2019-09-12 Record new Power-on Reset circuit.
    [Clock.sch, Power-on Reset.sch]
2019-09-13 Add a new global label "RegisterClock" and use that to drive registers A and B.
    [Clock.sch, Register A.sch, Register B.sch]
2019-09-13 The Program Counter uses ControlClock and ~RST signals
    [Program Counter.sch]
2019-09-14 The bus is only eight bits wide so the bus display module only needs eight LEDs.
    [Bus Display.sch, Control Word DIsplay.sch]
2019-09-14 Registers' data bus connection is to a single global label.
    [ALU.sch, Program Counter.sch, Register A.sch, Register B.sch]
2019-09-14 The program counter loads from the address bus, not the data bus.
    [Program Counter.sch]
2019-09-14 Contents of registers A and B are connected to A and B buses.
    [Register A.sch, Register B.sch]
2019-09-14 Instruction ROM connects to PC/IF instead of PC.
    [Instruction ROM.sch, Register B.sch]
2019-09-14 Add decoupling caps to Program Counter.
    [Program Counter.sch, Register A.sch]
2019-09-14 Add decoupling caps to Instruction ROM.
    [Instruction ROM.sch]
2019-09-14 Add decoupling caps to Register A.
    [Instruction Decoder.sch, Instruction ROM.sch, Instruction Register.sch, Register A.sch]
2019-09-14 Add decoupling caps to Register B.
    [Register B.sch]
2019-09-15 Add PC/IF schematic.
    [PC_IF.sch, Register A.sch, Register B.sch]
2019-09-15 Update schematic PDF too.
2019-09-15 The data bus display uses the DataBus global label.
    [Bus Display.sch]
2019-09-15 Added XY register pair.
    [Register XY.sch]
2019-09-15 Ensure all pages are 8.5x11
    [Bus Display.sch, Data RAM.sch, Execute.sch, Instruction RAM.sch, Instruction ROM.sch, Output Display.sch, PC_IF.sch, Program Counter.sch]
2019-09-15 Rebuild registers A and B with cleaner schematic inspired by what I did for the XY register pair.
    [Bus Display.sch, Register A.sch, Register B.sch, Register XY.sch]
2019-09-15 Added schematic for the ALU.
    [ALU.sch, Register A.sch]
2019-09-15 Rework Instruction Register schematic to use buses.
    [Instruction ROM.sch, Instruction Register.sch]
2019-09-15 Flesh out the Instruction Decoder.
    [Instruction Decoder.sch, Instruction ROM.sch]
2019-09-15 Flesh out Register D, the device select register.
    [ALU.sch, Instruction Decoder.sch, Power-on Reset.sch, Register A.sch, Register B.sch, Register D.sch, Register XY.sch]
2019-09-15 Added a blank sheet for the serial I/O module.
    [Serial.sch, TurtleTTL.sch]
2019-09-15 Flesh out the Arduino-based serial interface module.
    [ALU.sch, Bus Display.sch, Clock.sch, Control Word DIsplay.sch, Data RAM.sch, Execute.sch, Instruction Decoder.sch, Instruction RAM.sch]
2019-09-15 Review decoupling capacitors again.
    [ALU.sch, Execute.sch, Instruction Decoder.sch, Instruction Register.sch, Register D.sch, TurtleTTL.sch]
2019-09-15 Flesh out the control signals in the execute unit.
    [ALU.sch, Control Word DIsplay.sch, Execute.sch, Instruction Decoder.sch]
2019-09-15 Update schematics PDF.
2019-09-16 Consistently use the international resistor symbol.
    [ALU.sch, Clock.sch, Control Word DIsplay.sch, Execute.sch, Output Display.sch, Power-on Reset.sch, Program Counter.sch]
2019-09-16 Add LEDs for the ALU result and flags.
    [ALU.sch]
2019-09-16 Change net labels on buses to make them more consistent.
    [Instruction Decoder.sch, Program Counter.sch, Register A.sch, Register B.sch, Register XY.sch]
2019-09-16 Add decoupling caps and LED lights for register D.
    [ALU.sch, Bus Display.sch, Clock.sch, Control Word.sch, Data RAM.sch, Instruction Decoder.sch, Instruction RAM.sch, Instruction ROM.sch]
2019-09-16 Add LED lights for the instruction register.
    [Instruction Register.sch, Output Display.sch]
2019-09-16 Add LED indicators for register C as well as the necessary C bus.
    [Instruction Decoder.sch]
2019-09-16 The output display now accurately reflects the breadboard circuit.
    [Output Display.sch]
2019-09-16 Fleshed out Data RAM.
    [Data RAM.sch, Serial.sch]
2019-09-16 One too many decoupling caps on the Instruction Register.
    [Instruction Register.sch]
2019-09-16 Reorganize schematics to show the split between ID and EX more distinctly.
    [Control Word.sch, Execute.sch, Instruction Decoder.sch, TurtleTTL.sch]
2019-09-16 Flesh out Instruction RAM.
    [ALU.sch, Bus Display.sch, Clock.sch, Data RAM.sch, Execute.sch, Instruction Decode.sch, Instruction Fetch.sch, Instruction RAM Address.sch]
2019-09-16 Verify the order of bits used in the ALU control word.
    The schematic now matches the simulator. Need to check the breadboard
    circuit too.
    [ALU.sch]
2019-09-16 Added a barrel jack for power, and a switch.
    [Power-on Reset.sch]
2019-09-17 The reset button should be a momentary push button.
    [Power-on Reset.sch]
2019-09-17 Correction to Output Display: its connected to device slot one, not zero
    [Output Display.sch]
2019-09-17 Minor tidying up on Serial sheet.
    [Serial.sch]
2019-09-17 The manual clock pulse button should be a momentary push button.
    [Bus Display.sch, Clock.sch, Execute.sch, Register XY.sch, Speed Control.sch]
2019-09-17 Minor tidying on the ALU sheet.
    [ALU.sch, Register A.sch, Register B.sch]
2019-09-17 Re-order top-level sheets
    [TurtleTTL.sch]
2019-09-17 Re-order IF sheets
    [Instruction Fetch.sch]
2019-09-17 Add titles to sheets missing them.
    [ALU.sch, Bus Display.sch, Clock.sch, Data RAM.sch, Execute.sch, Instruction Decode.sch, Instruction Fetch.sch, Instruction RAM Address.sch]
2019-09-17 Connect the manual clock signal
    [Clock.sch]
2019-09-17 Add footprints to all decoupling caps
    [ALU.sch, Clock.sch, Data RAM.sch, Execute.sch, Instruction RAM Address.sch, Instruction RAM.sch, Instruction ROM.sch, Instruction Register.sch]
2019-09-17 Add footprint for radial capacitor in clock circuit.
    [Clock.sch]
2019-09-17 Add a power smoothing cap next to the barrel jack.
    [Power-on Reset.sch]
2019-09-17 Assign a bunch of part footprints.
    [ALU.sch, Bus Display.sch, Clock.sch, Execute.sch, Instruction Decode.sch, Instruction RAM Control.sch, Instruction Register.sch, Power-on Reset.sch]
2019-09-17 Assign a bunch more footprints. All are assigned now.
    [ALU.sch, Clock.sch, Data RAM.sch, Execute.sch, Instruction Decode.sch, Instruction RAM Address.sch, Instruction RAM Control.sch, Instruction RAM.sch]
2019-09-17 Replace the 28C16 in the Output Display with a GLS29EE010.
    [Output Display.sch, Program Counter.sch]
2019-09-17 Fix incorrect footprints.
    [Output Display.sch, Power-on Reset.sch]
2019-09-17 Update PDF again. Also, GLS29EE010 symbol has a bg color.
    [Output Display.sch]
2019-09-18 Added a PCB. No routing yet.
    [TurtleTTL.kicad_pcb]
2019-09-18 My buses were not named according the rules in the Eeschema manual.
    Buses which connect to global labels must be named specially.
    [ALU.sch, Bus Display.sch, Data RAM.sch, Execute.sch, Instruction Decode.sch, Instruction RAM Address.sch, Instruction RAM Control.sch, Instruction RAM.sch]
2019-09-18 Add unused IC units to Output Display to ensure no ICs are shared with other modules.
    [ALU.sch, Bus Display.sch, Clock.sch, Data RAM.sch, Execute.sch, Instruction Decode.sch, Instruction RAM Address.sch, Instruction RAM Control.sch]
2019-09-18 Add unused IC units to Data RAM to ensure no ICs are shared with other modules.
    [ALU.sch, Clock.sch, Data RAM.sch, Execute.sch, Instruction Decode.sch, Instruction RAM Address.sch, Instruction RAM Control.sch, Instruction RAM.sch]
2019-09-18 Add unused IC units to Speed Control to ensure no ICs are shared with other modules.
    [ALU.sch, Clock.sch, Power-on Reset.sch, Register A.sch, Register B.sch, Speed Control.sch]
2019-09-18 Add unused IC units to Clock to ensure no ICs are shared with other modules.
    [ALU.sch, Clock.sch, Power-on Reset.sch, Register A.sch, Register B.sch]
2019-09-18 Add unused IC units to Instruction RAM Control to ensure no ICs are shared with other modules.
    [Instruction RAM Control.sch, Instruction RAM.sch]
2019-09-18 Update PCB from previous schematic changes.
    [TurtleTTL.kicad_pcb]
2019-09-18 Loosely group PCB footprints according to corresponding sheet.
    [ALU.sch, Clock.sch, Execute.sch, Instruction Decode.sch, Instruction RAM Control.sch, Instruction Register.sch, Power-on Reset.sch, Register A.sch]
2019-09-18 Put register D LEDs in order.
    [TurtleTTL.kicad_pcb]
2019-09-18 Put register B LEDs in order.
    [TurtleTTL.kicad_pcb]
2019-09-18 Put register A LEDs in order.
    [TurtleTTL.kicad_pcb]
2019-09-18 Put ALU LEDs in order.
    [TurtleTTL.kicad_pcb]
2019-09-18 Rough organization for Power-on Reset module.
    [TurtleTTL.kicad_pcb]
2019-09-18 Rough organization to clock module.
    [TurtleTTL.kicad_pcb]
2019-09-18 Remove redundant decoupling caps from clock module.
    [Clock.sch, TurtleTTL.kicad_pcb]
2019-09-18 Rough organization to the speed control module.
    [TurtleTTL.kicad_pcb]
2019-09-18 Add PCB for eight-bit LED riser board.
    [LEDRiser8.kicad_pcb, LEDRiser8.sch]
2019-09-19 Add sixteen-bit LED riser board.
    [LEDRiser16.kicad_pcb, LEDRiser16.sch]
2019-09-19 Update eight bit LED riser board to better match the sixteen bit version.
    [LEDRiser8.kicad_pcb, LEDRiser8.sch]
2019-09-19 Added my name to the PCB silkscreen
    [LEDRiser8.kicad_pcb, LEDRiser8.sch]
2019-09-19 Added my name to the 16-bit LED riser board PCB silkscreen too.
    [LEDRiser16.kicad_pcb, LEDRiser8.kicad_pcb]
2019-09-19 Use THT LED arrays for the 16-bit LED riser board.
    [LEDRiser16.kicad_pcb, LEDRiser16.sch]
2019-09-19 Use THT LED arrays for the 8-bit riser boards too.
    [LEDRiser8.kicad_pcb, LEDRiser8.sch]
2019-09-19 Fix a wiring bug in the 16-bit LED riser schematic
    [LEDRiser16.kicad_pcb, LEDRiser16.sch]
2019-09-19 Route a 16-bit THT PCB for LED riser boards.
    [LEDRiser16.kicad_pcb, LEDRiser16.sch]
2019-09-19 Route a 8-bit THT PCB for LED riser boards.
    [LEDRiser8.kicad_pcb, LEDRiser8.sch]
2019-09-19 Add gerber files for the LED riser boards.
2019-09-19 Remove LEDs and replace with pin sockets for LED riser boards.
    [ALU.sch, Bus Display.sch, Clock.sch, Execute.sch, Instruction Register.sch, Program Counter.sch, Register A.sch, Register B.sch]
2019-09-19 Move the DC barrel jack to the top-level sheet.
    [Power-on Reset.sch, TurtleTTL.kicad_pcb, TurtleTTL.sch]
2019-09-19 Rough organization on PCB for LED connector sockets.
    [Instruction RAM Control.sch, Instruction Register.sch, Program Counter.sch, Register A.sch, Register B.sch, TurtleTTL.kicad_pcb]
2019-09-19 Change assignment of logic units to reduce the number of discrete ICs.
    This reduces part count in the Instruction RAM module.
    [ALU.sch, Bus Display.sch, Clock.sch, Data RAM.sch, Execute.sch, Instruction Decode.sch, Instruction Fetch.sch, Instruction RAM Address.sch]
2019-09-19 More rough organization and add a first draft for edge cuts.
    Board size is 300x290mm at this point.
    [TurtleTTL.kicad_pcb]
2019-09-19 Add M3 mounting holes to PCB corners.
    [TurtleTTL.kicad_pcb]
2019-09-19 Change the six layer stackup to follow recommendations online.
    Signal
    Ground
    Signal
    Power
    Ground
    Signal
    [TurtleTTL.kicad_pcb]
2019-09-19 Add copper fills for ground and power planes.
2019-09-19 Take another stab at reducing part count in Instruction RAM via better unit assignment.
    [Instruction RAM.sch, Power-on Reset.sch]
2019-09-19 Pack parts neatly into a smaller board size.
    [ALU.sch, Bus Display.sch, Clock.sch, Data RAM.sch, Execute.sch, Instruction Decode.sch, Instruction RAM Address.sch, Instruction RAM.sch]
2019-09-19 Get this onto a four layer stack-up.
    A four layer PCB is significantly cheaper than a six layer.
    Try to make the four layer board work.
2019-09-19 Mounting holes all used identical references, fix that.
    [TurtleTTL.kicad_pcb]
2019-09-19 For routing register A and B, the pin order of pin assignments must change to make rojuting easier. Also, lets use a chip placement similar to that found on the breadboard.
    [Register A.sch, Register B.sch, TurtleTTL.kicad_pcb]
2019-09-19 Route intermodule traces on the A and B registers.
    [TurtleTTL.kicad_pcb]
2019-09-20 checkpoint while routing ALU
    [ALU.sch, TurtleTTL.kicad_pcb]
2019-09-20 checkpoint routing the ALU
    The A and B buses are connected to the ALU.
    The flags register is connected to the ALU.
    Had to add a pull-up resistor to the open-collector, wired-OR A=B signal.
    [ALU.sch, TurtleTTL.kicad_pcb]
2019-09-20 Routed the ALU result bus and shortened some of the ALU traces.
    [TurtleTTL.kicad_pcb]
2019-09-20 Added silkscreen outlines around registers A and B and ALU.
    [TurtleTTL.kicad_pcb]
2019-09-20 Adjust silkscreen component labels for A and B and ALU.
    [TurtleTTL.kicad_pcb]
2019-09-20 Wire the data bus for registers A and B and ALU.
    [TurtleTTL.kicad_pcb]
2019-09-20 Route the Power-on Reset and Clock modules.
    [ALU.sch, Power-on Reset.sch, TurtleTTL.kicad_pcb]
2019-09-20 Pack clock module into a slightly smaller space.
    [TurtleTTL.kicad_pcb]
2019-09-21 Moved some ALU traces to free up some space in the corner.
    [TurtleTTL.kicad_pcb]
2019-09-21 Routed the speed control module.
    [TurtleTTL.kicad_pcb]
2019-09-21 Began routing the XY register pair and PC
    [ALU.sch, Bus Display.sch, TurtleTTL.kicad_pcb]
2019-09-22 Replace 1k pull-up resistor on the ALU with 4.7k.
    This is to match the breadboard computer.
    [ALU.sch]
2019-09-22 Remove all the ALU traces and reposition components.
    [TurtleTTL.kicad_pcb]
2019-09-22 ALU ICs are carefully aligned into an even grid now.
    [TurtleTTL.kicad_pcb]
2019-09-22 routing the alu again. checkpoint.
    [TurtleTTL.kicad_pcb]
2019-09-23 reposition the XY registers and PC in an even grid.
    [TurtleTTL.kicad_pcb]
2019-09-23 Switch back to a six-layer stack up because of problems with four layer routing.
    [TurtleTTL.kicad_pcb]
2019-09-23 Finish the ALU routing using an additional signal layer.
    [TurtleTTL.kicad_pcb]
2019-09-23 Finish routing the XY register pair.
    [TurtleTTL.kicad_pcb]
2019-09-23 Finished routing the Program Counter.
    [TurtleTTL.kicad_pcb]
2019-09-23 Route the PC/IF module and Instruction ROM.
    PC/IF no longer uses the 74F377 and now uses the 74F574.
    [Bus Display.sch, PC_IF.sch, TurtleTTL.kicad_pcb]
2019-09-23 checkpoint: routing the control unit
    [TurtleTTL.kicad_pcb]
2019-09-23 Compact control unit, removing 500 mils unused vertical space.
    [TurtleTTL.kicad_pcb]
2019-09-23 checkpoint: reorganize components in the PCB
    [TurtleTTL.kicad_pcb]
2019-09-23 Fix broken trace in ID.
    [TurtleTTL.kicad_pcb]
2019-09-23 Arrange data bus
    [TurtleTTL.kicad_pcb]
2019-09-23 Add footprint outlines for LED riser boards.
    [TurtleTTL.kicad_pcb]
2019-09-23 Start fitting Instruction RAM onto the board.
    [TurtleTTL.kicad_pcb]
2019-09-23 Routed PC/IF input to Instruction RAM address module.
    [TurtleTTL.kicad_pcb]
2019-09-24 Routed the Address Bus to Instruction RAM address module.
    [TurtleTTL.kicad_pcb]
2019-09-24 Route Instruction RAM address module using extra laters; cleanrer.
    [TurtleTTL.kicad_pcb]
2019-09-24 Route the Instruction RAM address lines.
    [TurtleTTL.kicad_pcb]
2019-09-24 checkpoint: routing instruction RAM
    [Instruction RAM.sch, TurtleTTL.kicad_pcb]
2019-09-24 Mark out a 300mm square for the board and add mounting holes.
    This is the largest size that JLCPCB can do and I expect to run up against
    this limit.
    [TurtleTTL.kicad_pcb]
2019-09-24 Reorient a few chips to fit into the new board outline.
    [TurtleTTL.kicad_pcb]
2019-09-25 checkpoint: begin routing output display
    [TurtleTTL.kicad_pcb]
2019-09-25 Consolidate schematics into one directory
    [ALU.sch, Bus Display.sch, Clock.sch, Data RAM.sch, Execute.sch, Instruction Decode.sch, Instruction Fetch.sch, Instruction RAM Address.sch]
2019-09-25 Renamed TurtleTTL KiCad project to MainBoard since we will have multiple projects now.
    [ALU.sch, Bus Display.sch, Clock.sch, Data RAM.sch, Execute.sch, Instruction Decode.sch, Instruction Fetch.sch, Instruction RAM Address.sch]
2019-09-25 Add a schematic for an Instruction ROM daughter board.
    [InstructionROMDaughterBoard.kicad_pcb, InstructionROMDaughterBoard.sch]
2019-09-25 Remove Instruction ROM from the main board and replace with connectors for the daughter board.
    [Instruction ROM.sch, InstructionROMDaughterBoard.sch]
2019-09-25 Blow away the existing PCB. Layout the edges of the empty board.
    [MainBoard.kicad_pcb]
2019-09-25 begin routing connections between Instruction RAM and PC/IF
    [MainBoard.kicad_pcb]
2019-09-25 Route the PC_IF bus between PC/IF and Instruction RAM Address.
    Swapping pins on the 74F157 ICs allows for a cleaner route.
    [Instruction RAM Address.sch, Instruction ROM.sch, MainBoard.kicad_pcb]
2019-09-25 checkpoint: routing IRAMAddr to the SRAM chips.
    [MainBoard.kicad_pcb]
2019-09-25 Finish routing PC_IF bus to the Instruction RAM SRAM chips.
    [MainBoard.kicad_pcb]
2019-09-26 Route traces between the bus transceivers and the SRAM.
    [MainBoard.kicad_pcb]
2019-09-26 Route IRAM and IROM inputs to the muxes
    [MainBoard.kicad_pcb]
2019-09-26 checkpoint: continuing to work down to the Instruction Register
    [MainBoard.kicad_pcb]
2019-09-26 checkpoint: route up through the Instruction Register
    [MainBoard.kicad_pcb]
2019-09-26 stake out a place for the Program Counter ICs.
    [MainBoard.kicad_pcb]
2019-09-26 Route connection between PC and PC/IF.
    [MainBoard.kicad_pcb]
2019-09-26 Stake out positions for the X and Y registers.
    [MainBoard.kicad_pcb]
2019-09-26 Stake out positions for register D and Device Select.
    [MainBoard.kicad_pcb]
2019-09-26 Add M3 mounting holes (grounded) at all four corners of the board.
    [MainBoard.kicad_pcb]
2019-09-26 Route lines for the address bus out of XY and into Instruction RAM.
    [MainBoard.kicad_pcb]
2019-09-26 Route data connections within XY register
    [MainBoard.kicad_pcb]
2019-09-26 Connect the data buses of X and Y bus transceivers.
    [MainBoard.kicad_pcb]
2019-09-26 Route data bus connections to the 74F377s inside of XY register.
    [MainBoard.kicad_pcb]
2019-09-26 Stake out positions for Instruction Decode ICs.
    [MainBoard.kicad_pcb]
2019-09-26 Stake out positions for the Execute unit.
    [MainBoard.kicad_pcb]
2019-09-26 Begin routing traces in the Instruction Decode stage.
    [MainBoard.kicad_pcb]
2019-09-27 Stake out positions for parts on the Instruction ROM daughter board. Also, define board outline.
    [InstructionROMDaughterBoard.sch]
2019-09-27 Instruction ROM daughter board uses same basic PCB design settings as the main board.
    [InstructionROMDaughterBoard.kicad_pcb]
2019-09-30 checkpoint: laying out instruction rom daughter board and added power planes.
    [InstructionROMDaughterBoard.kicad_pcb]
2019-09-30 Finish routing Instruction ROM daughter board PCB.
    [InstructionROMDaughterBoard.kicad_pcb]
2019-10-01 stake out tentative positions for the ALU components
    [MainBoard.kicad_pcb]
2019-10-01 The bus transceivers for the X and Y registers should face the other direction.
    [Register XY.sch]
2019-10-01 The bus transceivers for the A and B registers should face the other direction.
    [Register A.sch, Register B.sch]
2019-10-01 Update PCB for previous schematic changes.
    [MainBoard.kicad_pcb]
2019-10-01 Stake out new positions for ALU components, in column with control unit.
    [MainBoard.kicad_pcb]
2019-10-02 Pin swap register A and B bus transceivers to reverse order of pins and be consistent with rest of board.
    [MainBoard.kicad_pcb, Register A.sch, Register B.sch]
2019-10-02 Pin swap ALU bus transceiver to reverse order of pins and be consistent with rest of board.
    [ALU.sch, MainBoard.kicad_pcb]
2019-10-02 Replace the Device Select LED connector with a Register D LED connector.
    [MainBoard.kicad_pcb, Register A.sch, Register B.sch, Register D.sch, Register XY.sch]
2019-10-02 Connect together the data bus along the middle of the board.
    [MainBoard.kicad_pcb, Register A.sch, Register B.sch, Register XY.sch]
2019-10-02 checkpoint: I guess I forgot to save last session?
    [MainBoard.kicad_pcb]
2019-10-03 Finish wiring the ALU.
    [MainBoard.kicad_pcb]
2019-10-03 Hook up a bunch of control signals.
    [MainBoard.kicad_pcb]
2019-10-03 Updated schematics PDF.
2019-10-03 Create new KiCad project for the Output Display, which will be on an expansion card.
    [OutputDisplay.kicad_pcb, OutputDisplay.sch]
2019-10-03 Removed Output Display from the Main Board since it will be on an expansion card.
    [ALU.sch, Bus Display.sch, Clock.sch, Data RAM.sch, Execute.sch, Instruction Decode.sch, Instruction Fetch.sch, Instruction RAM Address.sch]
2019-10-03 Add Arduino Serial Interface expansion card.
    [ArduinoSerialCard.kicad_pcb, ArduinoSerialCard.sch]
2019-10-03 Remove Serial I/O from the Main Board since its on an expansion card now.
    [ALU.sch, Bus Display.sch, Clock.sch, Data RAM.sch, Execute.sch, Instruction Decode.sch, Instruction Fetch.sch, Instruction RAM Address.sch]
2019-10-03 Add a KiCad project for a RAM expansion card.
    [RAMCard.kicad_pcb, RAMCard.sch]
2019-10-03 Remove Data RAM from the Main Board since it sits on an expansion card now.
    [MainBoard.kicad_pcb, MainBoard.sch]
2019-10-03 It looks like I actually can route this using a four layer PCB.
    [MainBoard.kicad_pcb]
2019-10-03 Place and route the reset module.
    [MainBoard.kicad_pcb]
2019-10-03 Stake out positions for the clock components.
    [MainBoard.kicad_pcb]
2019-10-03 Placing components for Clock, Reset, and Speed Dial on the right side of the board.
    [ALU.sch, Bus Display.sch, Clock.sch, Execute.sch, Instruction Decode.sch, Instruction Fetch.sch, Instruction RAM Address.sch, Instruction RAM.sch]
2019-10-03 Place Clock, Speed Dial, and Reset components in what might be final position. Update board outline.
    [MainBoard.kicad_pcb]
2019-10-03 Add M3 mounting holes back in
    [MainBoard.kicad_pcb]
2019-10-03 Moved all the outlines of LED riser boards to Dwgs.User.
    [MainBoard.kicad_pcb]
2019-10-03 Move the lower part of the board to the left and shrink the board outline.
    The data bus now has a bend in it.
    [MainBoard.kicad_pcb]
2019-10-03 Shrink the main board outline again.
    [MainBoard.kicad_pcb]
2019-10-03 Add a copyright notice and revision number to the silkscreen.
    [MainBoard.kicad_pcb]
2019-10-04 Route the Reset, Clock, and Speed Dial modules.
    Control and clock signals have not yet been routed.
    [MainBoard.kicad_pcb]
2019-10-04 Switch to six layer again and delete routed control signals.
    I've been waffling on the issue of choosing four vs six layer PCB. I'm
    finding now that routing all the control signals is going to be a real
    pain. So, switch back to a six layer board and reserve In.Cu for clock and
    control signals.
    This layer is sandwiched between two gorund planes which should help
    isolate it from electrical noise.
2019-10-04 Route the control signals around the PCB on the inner layers.
2019-10-04 Route the Register Clock.
    [MainBoard.kicad_pcb]
2019-10-04 Route device select lines for Instruction RAM.
    [MainBoard.kicad_pcb]
2019-10-04 A few changes to satisfy the Design Rules Checker. Passes now
    [MainBoard.kicad_pcb]
2019-10-04 Instruction RAM uses Device Select lines 0 and 1 now.
    This is a deviation from the breadboard prototype, but should be more
    elegant. Other devices with higher assigned numbers will be off board.
    [Instruction Fetch.sch, Instruction RAM Address.sch, Instruction RAM.sch, MainBoard.kicad_pcb]
2019-10-04 Add expansion connectors to the main board.
    [ALU.sch, Bus Display.sch, Clock.sch, Execute.sch, Expansion.sch, Instruction Decode.sch, Instruction Fetch.sch, Instruction RAM Address.sch]
2019-10-04 WIP: continue routing the expansion connectors
    [Expansion.sch, MainBoard.kicad_pcb]
2019-10-04 Add PDFs for schematics of expansion cards.
2019-10-07 Changed the order of expansion connectors to put them in order.
    [MainBoard.kicad_pcb]
2019-10-07 Update schematic so that each device gets a dedicated ~PI and ~PO signal line.
    [Execute.sch, Expansion.sch, Instruction RAM.sch, MainBoard.kicad_pcb, Register D.sch]
2019-10-07 Prepare PCB for new parts
    [Instruction RAM.sch, MainBoard.kicad_pcb]
2019-10-07 Route the instruction RAM changes.
    [Instruction RAM.sch, MainBoard.kicad_pcb, Register D.sch]
2019-10-07 WIP: Move register D to the right hand side of the board.
    * This puts the PI/PO lines near the expansion cards, which is good.
    * The board outline needed to expand to accomodate the new ICs.
    * Several control signals were re-routed due to the change.
    * There's a large empty spot where register D used to be. I cannot get rid
    of this without re-routing a large portion of the lower left hand corner.
    [MainBoard.kicad_pcb]
2019-10-08 Finish routing the expansion connector on the PCB.
    [MainBoard.kicad_pcb]
2019-10-08 The CE signal in PC wasnt actually driven by anything.
    [MainBoard.kicad_pcb, Program Counter.sch, Register XY.sch]
2019-10-08 Label the Upper and Lower microcode ROMs.
    [Instruction Decode.sch]
2019-10-08 Remove stray NC symbol from the ALU schematic.
    [ALU.sch]
2019-10-08 One of the pins in the expansion connectors was unconnected. Now connected to Ground.
    [Expansion.sch]
2019-10-08 Update the schematics for the main board.
2019-10-08 Update RAMCard to include PI and PO signals.
    [RAMCard.kicad_pcb, RAMCard.sch]
2019-10-08 Update schematics for OutputDisplayCard to include the new PI and PO signals.
    [OutputDisplayCard.kicad_pcb, OutputDisplayCard.sch]
2019-10-08 Update schematics for Arduino Serial Card to include new PI and PO signals.
    [ArduinoSerialCard.sch]
2019-10-08 Replace the DC barrel jack with a terminal screw block.
    [MainBoard.kicad_pcb, MainBoard.sch, Program Counter.sch]
2019-10-09 Layout a PCB for the Arduino Serial Interface board.
    [ArduinoSerialCard.kicad_pcb, ArduinoSerialCard.sch]
2019-10-09 Layout a PCB for the RAM card
    [RAMCard.kicad_pcb, RAMCard.sch]
2019-10-09 Fix RAM card DRC errors
    [RAMCard.kicad_pcb, RAMCard.sch]
2019-10-09 Add Gerber plots for PCBs.
    [ArduinoSerialCard-B_Cu.gbr, ArduinoSerialCard-B_Mask.gbr, ArduinoSerialCard-B_Paste.gbr, ArduinoSerialCard-B_SilkS.gbr, ArduinoSerialCard-Edge_Cuts.gbr, ArduinoSerialCard-F_Cu.gbr, ArduinoSerialCard-F_Mask.gbr, ArduinoSerialCard-F_Paste.gbr]
2019-10-09 Updated schematics PDFs and added PDFs for PCB layout.
    [ArduinoSerialCard.kicad_pcb, InstructionROMDaughterBoard.kicad_pcb, LEDRiser16.kicad_pcb, LEDRiser16.sch, LEDRiser8.kicad_pcb, LEDRiser8.sch, MainBoard.kicad_pcb, RAMCard.kicad_pcb]
2019-10-09 The mounting holes must be present in the schematic to prevent them from disappearing when I update.
    [MainBoard-B_Cu.gbr, MainBoard-B_Mask.gbr, MainBoard-B_Paste.gbr, MainBoard-B_SilkS.gbr, MainBoard-Edge_Cuts.gbr, MainBoard-F_Cu.gbr, MainBoard-F_Mask.gbr, MainBoard-F_Paste.gbr]
2019-10-10 MainBoard: Unused inputs are tied to VCC, unused outputs are left unconnected.
    [ALU.sch, Clock.sch, Expansion.sch, Instruction RAM.sch, Instruction ROM.sch, Instruction Register.sch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]
2019-10-10 RAMCard: unused inputs are tied to VCC, unused outputs are left disconnected.
    [RAMCard-B_Cu.gbr, RAMCard-B_Mask.gbr, RAMCard-B_Paste.gbr, RAMCard-B_SilkS.gbr, RAMCard-Edge_Cuts.gbr, RAMCard-F_Cu.gbr, RAMCard-F_Mask.gbr, RAMCard-F_Paste.gbr]
2019-10-10 Move the expansion card connectors to the right.
    [MainBoard-B_Cu.gbr, MainBoard-B_Mask.gbr, MainBoard-B_Paste.gbr, MainBoard-B_SilkS.gbr, MainBoard-Edge_Cuts.gbr, MainBoard-F_Cu.gbr, MainBoard-F_Mask.gbr, MainBoard-F_Paste.gbr]
2019-10-10 stake out positions for the ICs of the newly expanded ID stage
    [ALU.sch, Clock.sch, Execute.sch, Instruction Decode.sch, Instruction RAM.sch, Power-on Reset.sch, Speed Control.sch]
2019-10-10 Tighten up the board outline again.
2019-10-10 Route traces for the newly expanded ID stage.
    * Had to reposition the ICs to do this.
    * The control signals in the EX stage have not been routed yet.
    [Execute.sch]
2019-10-10 Move the D register LED connector to empty space above the 377
2019-10-10 Only the EEPROMs and the 181s should be socketed.
    [ALU.sch, Execute.sch, Instruction RAM.sch, Register A.sch, Register B.sch, Register XY.sch]
2019-10-10 Route the clock and control signal traces again.
    The new 16 control signals aren't being used yet. The existing 16 are
    all routed again.
2019-10-10 Update PDFs and plots for the main board.
    [MainBoard-B_Cu.gbr, MainBoard-B_Mask.gbr, MainBoard-B_Paste.gbr, MainBoard-B_SilkS.gbr, MainBoard-Edge_Cuts.gbr, MainBoard-F_Cu.gbr, MainBoard-F_Mask.gbr, MainBoard-F_Paste.gbr]
2019-10-12 Move the C register bus transceiver down to begin consolidating vacant board space.
2019-10-12 Move C register down to continue consolidating vacant board space.
2019-10-12 Move the rest of the Instruction Register down to consolidate vacant board space.
    Replace the sixteen bit IR LED display with two eight bit displays which
    fit into the new space better.
    [Instruction Register.sch]
2019-10-12 Move the IF stage down into vacant space left by IR register
2019-10-12 WIP: Move the Address Bus LED display to the right side of the board.
2019-10-12 Open up that space between the bus and the expansion connectors.
2019-10-12 XY register uses 74161 counters now.
    * We can use one of the new control signals to increment the sixteen-bit
    XY register, carrying across the two halves.
    * There's now space open at the left of the expansion connectors.
    * There's now space open below PC for the Link register.
    [Instruction Register.sch, Register XY.sch]
2019-10-12 Added a UV register for use in supplying Data RAM address.
    Staked out positions for components of UV, but did not route yet.
    [ALU.sch, Bus Display.sch, Clock.sch, Execute.sch, Expansion.sch, Instruction Decode.sch, Instruction Fetch.sch, Instruction RAM Address.sch]
2019-10-12 Relabel the Address Bus LED connector to XY LED Connector
    [Bus Display.sch, Register XY.sch]
2019-10-12 The ALU Carry Input comes from a control signal instead of the C register.
    So now:
    * C[0..3] --> S[0..3]
    * C4 --> M
    * ~CarryIn --> Cn
    [ALU.sch, Execute.sch]
2019-10-12 Added Data RAM submodule to main board again.
    Staked out component positions on the PCB but did not route traces yet.
    [ALU.sch, Bus Display.sch, Clock.sch, Data RAM.sch, Execute.sch, Expansion.sch, Instruction Decode.sch, Instruction Fetch.sch]
2019-10-12 WIP: fix schematic ERC violations.
    [ALU.sch, Clock.sch, Execute.sch, Instruction Decode.sch, Instruction RAM Address.sch, Instruction RAM.sch, Instruction ROM.sch, MainBoard.sch]
2019-10-13 Route the UV registers and Data RAM on the PCB.
    [ALU.sch, Bus Display.sch, Clock.sch, Data RAM.sch, Execute.sch, Expansion.sch, Instruction Decode.sch, Instruction Fetch.sch]
2019-10-13 Add the Link Register so we can implement microcode for JALR.
    [ALU.sch, Bus Display.sch, Clock.sch, Data RAM.sch, Execute.sch, Expansion.sch, Instruction Decode.sch, Instruction Fetch.sch]
2019-10-13 Update plots and add some renders of the boards.
    [ArduinoSerialCard-B_Cu.gbr, ArduinoSerialCard-B_Mask.gbr, ArduinoSerialCard-B_Paste.gbr, ArduinoSerialCard-B_SilkS.gbr, ArduinoSerialCard-Edge_Cuts.gbr, ArduinoSerialCard-F_Cu.gbr, ArduinoSerialCard-F_Mask.gbr, ArduinoSerialCard-F_Paste.gbr]
2019-10-13 Move generated files to a separate directory.
    [ArduinoSerialCard-B_Cu.gbr, ArduinoSerialCard-B_Mask.gbr, ArduinoSerialCard-B_Paste.gbr, ArduinoSerialCard-B_SilkS.gbr, ArduinoSerialCard-Edge_Cuts.gbr, ArduinoSerialCard-F_Cu.gbr, ArduinoSerialCard-F_Mask.gbr, ArduinoSerialCard-F_Paste.gbr]
2019-10-13 Added BOMs
    [ArduinoSerialCard.csv, InstructionROMDaughterBoard.csv, MainBoard.csv]
2019-10-20 Instruction RAM occupies device slots zero and one, to match hardware.
    On PCB Rev 1, peripheral device slots zero and one are reserved for the
    two planes of instruction RAM.
2019-10-20 Call them Peripheral Devices instead of Banks.
2019-10-20 Changes to the assembler so it can recognize the P, U, and V registers.
2019-10-21 Added a link register and associated microcode.
    TODO: Assembler support for a new JALR instruction.
2019-10-22 Assembler now supports registers G and H.
2019-10-23 Jump instructions generate the jump opcode and no NOPs.
    This exposes the delay slots but also means that instructions more closely
    correspond to machine language opcodes.
2019-10-23 Update the example program to manually insert NOPs.
2019-10-23 Add test to showcase computer's ability to accelerate a bit blit.
    The computer is capable of, in one clock, copying a byte from data RAM to a
    peripheral and then increment the UV and XY registers.
    TODO: The microcode generator does not generate an opcode for this yet, nor
    does the assembler have a corresponding instruction. Just proof of concept.
2019-10-23 Fix assembler issues with ADD and CMP due to hardware changes involving the carry-in signal. Add a count-up routine to the example program.
2019-10-26 Instructions are now identifiers with no special place in the grammar.
    Also, eliminate the LOAD and STORE instructions from the assembler. These
    are actually kinda high-level for the architecture. Remove these
    instructions entirely. Instead, perform these operations by setting an
    address in XY or UV and then doing MOV to/from registers M or P.
2019-10-26 The clock step button leaves pin 2 of U55 floating until the button is pressed. The pin must be pulled up to VCC with a 1K resistor. Pressing the switch grounds the pin.
    [Clock.sch]
2019-10-26 The speed control ADC is missing a pull-up resistor at the end of its voltage divider ladder. This is a 1k resistor to pull pin 3 of U53 up to VCC.
    [MainBoard-B_Cu.gbr, MainBoard-B_Mask.gbr, MainBoard-B_Paste.gbr, MainBoard-B_SilkS.gbr, MainBoard-Edge_Cuts.gbr, MainBoard-F_Cu.gbr, MainBoard-F_Mask.gbr, MainBoard-F_Paste.gbr]
2019-10-26 Power pins of multi-unit ICs must be connected.
    In order for components of multi-unit ICs to be connected to VCC and GND,
    it is necessary to add a special components to the schematic for the power
    connections.
    [Clock.sch, Instruction RAM.sch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]
2019-10-26 Fix a few minor, misc. problems in the main board PCB.
    * Screw terminal needs marking for polarity.
    * C55 is missing a silkscreen label for value.
    * Corner mounting hole is positioned incorrectly.
    * Missing label for "Device 2" expansion slot.
    * C49 is missing a silkscreen label for value.
    [MainBoard-B_Cu.gbr, MainBoard-B_Mask.gbr, MainBoard-B_Paste.gbr, MainBoard-B_SilkS.gbr, MainBoard-Edge_Cuts.gbr, MainBoard-F_Cu.gbr, MainBoard-F_Mask.gbr, MainBoard-F_Paste.gbr]
2019-10-26 Update the revision on the main board PCB from 1 to 2.
    [MainBoard-B_Cu.gbr, MainBoard-B_Mask.gbr, MainBoard-B_Paste.gbr, MainBoard-B_SilkS.gbr, MainBoard-Edge_Cuts.gbr, MainBoard-F_Cu.gbr, MainBoard-F_Mask.gbr, MainBoard-F_Paste.gbr]
2019-11-02 Turn off the hardened runtime for the command-line assembler tool.
    Otherwise, it won't run. This is a simple solution for now, at least.
2019-11-05 Fix bug where assembler would not print the expected error message.
2019-11-05 Take a stab at updating the Arduino software.
2019-11-05 The Arduino must listen to the clock to determine when the cycle ends.
2019-11-07 Arduino echoes all characters including 255.
2019-11-07 Add some example assembly programs
2019-11-08 optimize Arduino sketch to improve responsiveness
2019-11-09 Arduino uses a bit of shared memory to communicate with the CPU.
    This represents a hardware change to the serial card which has not been
    entered into the schematic yet.
    BUG: If the CPU is running slowly enough then the Arduino may mistake a
    single slow write for multiple commands.
    [ArduinoSerialInterface.ino]
2019-11-10 Get the Arduino to respond to the WRITE command.
2019-11-10 Reset the serial connection when the computer resets
    [ArduinoSerialInterface.ino]
2019-11-11 Program Counter runs off RegisterClock, not ControlClock.
    [Program Counter.sch]
2019-11-11 Update Power-on Reset circuit to avoid leaving the switch floating.
    [Power-on Reset.sch]
2019-11-11 Rename UVInc and XYInc to mark them as active-high, not active-low.
    [Execute.sch, Register UV.sch, Register XY.sch]
2019-11-11 Fix the silkscreen labels near the condition code LEDs.
2019-11-11 Move the LED connector for the Link register.
    The connector was too close to the Instruction ROM daughter board.
2019-11-11 Move the LED connector for PC to align with Link register LED connector.
2019-11-12 Update schematic and PCB for the shared memory arduino card.
    [ArduinoSerialCard.kicad_pcb, ArduinoSerialCard.sch]
2019-11-12 Update the Arduino sketch for the new pinout of the updated serial card.
2019-11-12 update PDFs
    [ArduinoSerialCard.kicad_pcb, ArduinoSerialCard.sch]
2019-11-12 Fix couple of small PCB issues and update PDFs and renders
    * The positive side of the capacitor should be closest to VCC.
    * The bottom edge cut should be as close to the connector as possible.
    [ArduinoSerialCard.kicad_pcb]
2019-11-12 Update plots for the revised Arduino Serial Card.
    [ArduinoSerialCard-B_Cu.gbr, ArduinoSerialCard-B_Mask.gbr, ArduinoSerialCard-B_Paste.gbr, ArduinoSerialCard-B_SilkS.gbr, ArduinoSerialCard-Edge_Cuts.gbr, ArduinoSerialCard-F_Cu.gbr, ArduinoSerialCard-F_Mask.gbr, ArduinoSerialCard-F_Paste.gbr]
2019-11-13 Bring back the old ArduinoSerialCard design.
    The flaws in the PCB can be fixed in software. Keep the shared memory
    Arduino serial card in the new "experimental" directory.
    [ArduinoSerialCard-B_Cu.gbr, ArduinoSerialCard-B_Mask.gbr, ArduinoSerialCard-B_Paste.gbr, ArduinoSerialCard-B_SilkS.gbr, ArduinoSerialCard-Edge_Cuts.gbr, ArduinoSerialCard-F_Cu.gbr, ArduinoSerialCard-F_Mask.gbr, ArduinoSerialCard-F_Paste.gbr]
2019-11-13 The Arduino serial card should be programmed to trigger off PI/PI, not CLK.
2019-11-13 Fix pin out on the Arduino Serial Card
    [ArduinoSerialCard.kicad_pcb, ArduinoSerialCard.sch]
2019-11-13 Clean up the routing on the revised Serial Card PCB, and update generated files.
    [ArduinoSerialCard-B_Cu.gbr, ArduinoSerialCard-B_Mask.gbr, ArduinoSerialCard-B_Paste.gbr, ArduinoSerialCard-B_SilkS.gbr, ArduinoSerialCard-Edge_Cuts.gbr, ArduinoSerialCard-F_Cu.gbr, ArduinoSerialCard-F_Mask.gbr, ArduinoSerialCard-F_Paste.gbr]
2019-11-14 Add a reset function to the Arduino Serial Card.
    The shared memory version of the Arduino Serial Card has this feature,
    and it's really nice. Bring it over to this version.
    [ArduinoSerialInterface.ino]
2019-11-14 Update generated plots for the main board.
    [MainBoard-B_Cu.gbr, MainBoard-B_Mask.gbr, MainBoard-B_Paste.gbr, MainBoard-B_SilkS.gbr, MainBoard-Edge_Cuts.gbr, MainBoard-F_Cu.gbr, MainBoard-F_Mask.gbr, MainBoard-F_Paste.gbr]
2019-11-16 Begin work on the Rev 2 hardware.
    * Four layer PCB for the main board
    * Breaking the main board up into several smaller daughter boaeds.
    * ZIF sockets for Instruction ROM
    * Dual Port SRAM for Instruction RAM
    * Daughter board connectors interleave signals and GND.
    * DC Barrel jack connector for power
    * WIP shifter circuit
    * Rename SharedMemoryArduinoSerialCard to SerialCard.
    * TurtleTTL Rev 2 will use the shared memory serial card.
    [ALU.sch, ALUBoard.sch, ArduinoSerialCard.kicad_pcb, ArduinoSerialCard.sch, Bus Display.sch, Clock.sch, ClockBoard.kicad_pcb, ClockBoard.sch]
2019-11-16 Changed my mind: Power-on Reset will not go on separate board.
    [ALU.sch, Bus Display.sch, Clock.sch, Data RAM.sch, Execute.sch, Expansion.sch, Instruction Decode.sch, Instruction Fetch.sch]
2019-11-16 Route the PI and PO buses to the expansion connectors.
2019-11-16 Route internal traces of register D and some address bus traces.
2019-11-16 Instruction RAM uses "AddressBus" instead of directly using "XY"
    [ALU.sch, Bus Display.sch, Clock.sch, Data RAM.sch, Execute.sch, Expansion.sch, Instruction Decode.sch, Instruction Fetch.sch]
2019-11-16 More traces through the register portions of A, B, and C
2019-11-16 route traces between IR and microcode ROM
2019-11-16 Route traces in the Power-on Reset module.
    [Bus Display.sch, Execute.sch, Instruction Decode.sch, Power-on Reset.sch, Register A.sch, Register B.sch]
2019-11-16 Add /RST and ControlClock to the expansion connector.
    The Reset signal will definitely be useful. The ControlClock signal might
    be, but I don't know what for yet. Fortunately, there are plenty of unused
    pins here.
    [Expansion.sch]
2019-11-17 route traces internal to Instruction RAM
    [Instruction RAM.sch]
2019-11-17 Replace the ZIF sockets with DIP-32 ZIF sockets, layout traces for Link.
    [Instruction ROM.sch]
2019-11-17 route more traces in the Link register.
2019-11-17 continiuing to route traces on main board for Link register
2019-11-17 route address bus to Instruction RAM
    [Instruction RAM.sch]
2019-11-17 move the clock connector and reset circuit to give space between clock and RAM board
2019-11-21 Add WIP serial interface module driver and test code.
2019-11-21 Ensure 0.5" space between the ALU and Shifter connectors.
2019-11-21 Route control signals to ALU section of main board.
2019-11-22 Updated Arduino sketch and example program for another change to Serial.
    The Arduino serial interface module now operates like an SPI slave, except
    that it is eight bits wide. Implemented a protocol where the Arduino can
    respond to commands and return a status code.
    Updated the example app so that I can use it debug this new functionality.
2019-11-26 Update the echo program to reflect changes to the serial interface hw.
    The new circuit uses two memory mapped registers at Y=0 and Y=1 to allow
    the program to specify data and control bits. The serial interface
    hardware no longer examines the value of the Y register directly.
    BUG: There's a hardware bug with the JALR instruction and this doesn't
    actually work correctly or reliably.
2019-11-26 Add a test program which flashes the D register LEDs periodically.
    The idea is to set the D register to zero, delay, set the D register to
    255, and repeat. This flashes the LEDs periodically.
    BUG: This doesn't actually work. There's a hardware problem with the
    JALR instruction which makes it unreliable.
2019-11-26 Keep the first version of the hardware around in a "Version1" directory.
    Keep the new, second version of the hardware in a "Version2" directory.
    Rev 1 circuit boards I had produced have a number of issues with them, and
    I've found even more. So, keep these files around in a dedicated directory.
    Future versions of the hardware will have their own directory if the
    changes are more than simple tweaks and corrections.
    [ALU.sch, ALUBoard.sch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]
2019-11-26 Document the intended KiCAD design rules for PCBs somewhere.
2019-11-26 Add LINK instruction to workaround hardware bug in Link register.
    The Link register is wired incorrectly in hardware so that during JALR, it
    sometimes captures the value of PC after the jump executes. (It's racey.)
    Add the LINK instruction so that we can break JALR into two opcodes: LINK
    and JMP. This allows us to capture the value of PC before performing the
    jump.
    Note that it's now necessary to increment the return address before the
    JMP to return from a function.
2019-11-26 The Link register needs to load from PC/IF instead of PC.
    Loading the Link register from PC/IF instead of PC allows the computer to
    reliably latch the value of PC before executing a Jump instruction.
    Update the Version 1 schematics and PCB layout.
    Update the Version 2 schematics in the same way, but not the PCB layout.
    [Link Register.sch]
2019-11-27 Fix hardware bug where IR uses PC[15] instead of PC_IF[15].
    The Instruction Register must select between the ROM and RAM inputs based
    on the MSB of the PC/IF register, not the PC register.
    Note that Version 2 was not suscpetible to this issue.
    [Instruction Decode.sch, Instruction Register.sch]
2019-11-29 Add AC termination to the RegisterClock signal to fix issues when running at 10MHz CPU clock speed.
    [ALU.sch]
2019-11-30 Move the RegisterClock termination from the ALU sheet to the clock sheet.
    [ALU.sch, Clock.sch]
2019-12-01 Update the Arduino serial card to use revised schematic.
    This is the design for which I've written the latest Arduino sketch, and
    the prototype works wonderfully. Basically, it includes three memory mapped
    registers which acts as intermediaries between the Arduino and the CPU.
    [ArduinoSerialCard-B_Cu.gbr, ArduinoSerialCard-B_Mask.gbr, ArduinoSerialCard-B_Paste.gbr, ArduinoSerialCard-B_SilkS.gbr, ArduinoSerialCard-Edge_Cuts.gbr, ArduinoSerialCard-F_Cu.gbr, ArduinoSerialCard-F_Mask.gbr, ArduinoSerialCard-F_Paste.gbr]
2019-12-03 Merge branch "version2a"
    This replaces the Version2 schematics with a new second version. This one
    completes a four layer routing of the main board.
    [ALU.sch, Bus Display.sch, Clock.sch, Data RAM.sch, Execute.sch, Expansion.sch, Instruction Decode.sch, Instruction Fetch.sch]
2019-12-16 Record logic family swaps on Version 1 main board too.
    [ALU.sch, Clock.sch, Data RAM.sch, Execute.sch, Instruction Decode.sch, Instruction RAM Address.sch, Instruction RAM.sch, Instruction Register.sch]
2019-12-16 Fix the Arduino Serial Card PCB.
    The Arduino serial card PCB had the enable pins wired incorrectly.
    Fix this for revision 3.
    [ArduinoSerialCard-B_Cu.gbr, ArduinoSerialCard-B_Mask.gbr, ArduinoSerialCard-B_Paste.gbr, ArduinoSerialCard-B_SilkS.gbr, ArduinoSerialCard-Edge_Cuts.gbr, ArduinoSerialCard-F_Cu.gbr, ArduinoSerialCard-F_Mask.gbr, ArduinoSerialCard-F_Paste.gbr]
2019-12-22 Merge branch "version2b".
    This is a new version of the computer which incorporates a number of
    improvements:
    * Uses a four layer PCB instead of six.
    * Replaced the clock with a new circuit. This is simpler, but allows for
    an external clock to be attached.
    * Changes to the ALU to have it operate over two clock cycles instead of
    one. This fixes a timing issue which makes the ALU unreliable at 10MHz.
    * Replaced instruction RAM with dual port SRAM.
    * Replaced the physical connector for expansion cards to interleave
    signals with ground.
    * Added places where components can be attached to provide AC termination
    of the data bus, should this be necessary.
    [ALU.sch, ALUBoard.sch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]
2019-12-24 Added an external clock board with speed dial.
    This is useful during debugging, but not so useful otherwise. This has
    been extracted from the main board and moved to an external board.
    [Clock.sch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]
2019-12-24 Update the MainBoard Gerber plots
    [MainBoard-B_Cu.gbr, MainBoard-B_Mask.gbr, MainBoard-B_Paste.gbr, MainBoard-B_SilkS.gbr, MainBoard-Edge_Cuts.gbr, MainBoard-F_Cu.gbr, MainBoard-F_Mask.gbr, MainBoard-F_Paste.gbr]
2019-12-24 Update the serial card Gerber plots
    [SerialCard-B_Cu.gbr, SerialCard-B_Mask.gbr, SerialCard-B_Paste.gbr, SerialCard-B_SilkS.gbr, SerialCard-Edge_Cuts.gbr, SerialCard-F_Cu.gbr, SerialCard-F_Mask.gbr, SerialCard-F_Paste.gbr]
2019-12-24 The DC barrel jack was facing the wrong direction. Fixed.
    [MainBoard-B_Cu.gbr, MainBoard-B_Mask.gbr, MainBoard-B_Paste.gbr, MainBoard-B_SilkS.gbr, MainBoard-Edge_Cuts.gbr, MainBoard-F_Cu.gbr, MainBoard-F_Mask.gbr, MainBoard-F_Paste.gbr]
2019-12-25 Update main board render
2019-12-31 Update generated files for External Clock.
    [ExternalClock-B_Cu.gbr, ExternalClock-B_Mask.gbr, ExternalClock-B_Paste.gbr, ExternalClock-B_SilkS.gbr, ExternalClock-Edge_Cuts.gbr, ExternalClock-F_Cu.gbr, ExternalClock-F_Mask.gbr, ExternalClock-F_Paste.gbr]
2019-12-31 Update generated files for the serial card.
    [SerialCard-B_Cu.gbr, SerialCard-B_Mask.gbr, SerialCard-B_Paste.gbr, SerialCard-B_SilkS.gbr, SerialCard-Edge_Cuts.gbr, SerialCard-F_Cu.gbr, SerialCard-F_Mask.gbr, SerialCard-F_Paste.gbr]
2019-12-31 Update generated files for Main Board.
    [MainBoard-B_Cu.gbr, MainBoard-B_Mask.gbr, MainBoard-B_Paste.gbr, MainBoard-B_SilkS.gbr, MainBoard-Edge_Cuts.gbr, MainBoard-F_Cu.gbr, MainBoard-F_Mask.gbr, MainBoard-F_Paste.gbr]
2019-12-31 Remove the JLC order number placeholder from serial card
    [SerialCard-B_Cu.gbr, SerialCard-B_Mask.gbr, SerialCard-B_Paste.gbr, SerialCard-B_SilkS.gbr, SerialCard-Edge_Cuts.gbr, SerialCard-F_Cu.gbr, SerialCard-F_Mask.gbr, SerialCard-F_Paste.gbr]
2019-12-31 Remove the JLC order number placeholder from main board
    [MainBoard-B_Cu.gbr, MainBoard-B_Mask.gbr, MainBoard-B_Paste.gbr, MainBoard-B_SilkS.gbr, MainBoard-Edge_Cuts.gbr, MainBoard-F_Cu.gbr, MainBoard-F_Mask.gbr, MainBoard-F_Paste.gbr]
2020-02-12 The virtual machine runs as quickly as possible on a background thread.
    BUG: The log consumes all time in the main thread and locks up the app.
2020-02-13 Throttle CPU state updates submitted to the UI.
2020-02-13 Throttle serial output so the view does not get swamped in Release mode.
2020-02-15 Throttle event log updates to occur no more frequently than 30x per sec.
    We must avoid appending text to the text view too, or scrolling it too
    frequently.
2020-02-17 Fix the remaining ComputerExecutor unit tests.
    Remove the background thread and replace with a dispatch queue. Control
    concurrent access to the computer class using the queue instead of
    Objective-C monitors.
2020-02-18 ComputerStopwatch's instructionsRetired uses atomic instructions to allow safe operation across multiple threads
2020-02-19 Do not use ThrottledQueue for IPS updates.
    Measure the time interval on the current thread using CFAbsoluteTime
    instead. This greatly reduces the number of blocks that need to be
    allocated and released and passed around. This reduces the overhead of
    reporting instructions-per-second and greatly increases performance.
2020-02-19 Do not use ThrottledQueue for the serial output display queue.
    This is simply unecessary. Dispatch directly to the main DispatchQueue.
2020-02-20 Add a runUntilHalted() method to Computer.
    This is useful for benchmarking since it allows us to run the VM on a
    single thread until the benchmark program has halted.
2020-02-20 Add a command line benchmark program, TurtleVMBenchmark.
    This program runs the VM, computing fibonacci numbers, for a while and then
    prints out the number of seconds it took to complete the computation.
2020-02-21 Add a TraceProfiler object to the interpreter.
2020-02-21 Begin stubbing out the Trace and TraceRecorder classes.
2020-02-21 Trace objects' description is listing of instructions and guards.
2020-02-21 Trace records the PC associated with each instruction and guard.
2020-02-21 Add unit tests to record a trace involving LI instructions.
2020-02-21 The TraceRecorder can abandon a trace when the machine halts during recording.
2020-02-21 AssemblerFrontEnd inserts disassembly into the instruction stream.
2020-02-21 TraceRecorder relies on the disassembly in each instruction.
2020-02-21 TraceRecorder can record a simple unconditional jump now.
    Every unconditional jump needs a guard for the jump destination since this
    is dependent on the computed value of XY. If the jump would lead to a
    different destination than that recorded in the trace then the guard needs
    to direct us to return to the interpreter at the address of the jump
    instruction to simulate its actual effects.
2020-02-22 Interpreter can store and load to peripheral devices.
    The delegate implements the request.
2020-02-23 TraceRecorderTests now uses Interpreter.
    Also, remove `state' from TraceRecorder. This kind of policy decision will
    be made at a higher level.
2020-02-23 TraceRecorder can record a conditional jump.
2020-02-24 ComputerRev1 records and caches traces for hot loops.
    These traces are not executed. Instead, we currently just log that we
    _should_ execute a trace. So, this is a work in progress.
    Instructions now carry with them the PC from which they were fetched. This
    helps in constructing a trace since we do have a pipeline and fetch the
    instructions on a different clock than when we execute them.
2020-02-25 Move logCPUStateChanges to new TraceUtils class.
2020-02-25 TraceRecorder has methods now to record a prologue and epilogue.
    These are used to ensure that the (emulated) CPU pipeline is flushed
    before and after executing the trace.
2020-02-25 Forgot to add TraceUtils to the Xcode project
2020-02-25 Trace now uses the guard statements on the Instruction object
    It no longer uses the Trace.Element enum to track this information.
2020-02-25 Add a unit test for the Trace.pc property.
2020-02-25 Add TraceInterpreter which can execute a pre-recorded execution trace.
    TODO: unit test coverage of this class is poor
2020-02-25 ComputerRev1 records and executes traces for hot loops.
    Changed ComputerRev1Tests to include examples. However, the unit test
    coverage of the class, overall, is poor.
2020-02-25 Add null logger to TraceInterpreterTests to increase test code coverage.
2020-02-25 Remove traceExitingPC from Instruction because it's not actually useful.
2020-02-25 Trace objects may be equality tested now
2020-02-25 Trace.copy() will copy a trace object
2020-02-25 Trace.finalPC will show the PC of the final instruction in the trace.
2020-02-25 Added a TraceExecutor class which runs a Trace in an interpreter.
    Also includes extensive unit tests.
2020-02-25 ComputerRev1Tests uses TraceUtils.assemble()
2020-02-25 TraceExecutor now accepts peripherals and microcode in the ctor.
2020-02-26 Remove TraceInterpreter. The replacement is TraceExecutor.
    BUG: Unit tests fail now. Sad.
2020-02-26 Added WIP TracingJitVM
    This WIP class will reimplement the logic (previously present in the
    ComputerRev1 class) to record and playback traces of hot loops.
2020-02-26 Continue to work on TracingJitVM, work in progress to add recording of traces.
2020-02-28 TracingInterpretingVM will use an interpereter to execute traces.
2020-02-29 TracingInterpretingVM will stop trace recording when it encounters an existing trace.
    This can occur for nested loops, for example.
    FIXME: Code is currently disabled because I'm not sure whether or not it
    confers any benefits at all.
2020-02-29 Add an "uptime" property to CPUStateSnapshot.
    This counts the number of clock cycles since the last reset or power-on.
2020-02-29 TraceRecorder doesn't change the instructions, it only adds guards.
2020-03-01 Fix ComputerRev1Tests.testSerialInputDemo
    The test was failing because TraceExecutor was not fetching instructions
    in the expected order.
2020-03-01 Remove appendGuard() from the Trace API.
    Can do this through the Instruction API instead.
2020-03-01 TraceRecorder puts a breakpoint on the first instruction of the trace.
2020-03-02 TraceExecutor has a flag to request that execution stop on the next breakpoint.
2020-03-02 The UI passes serial input down through the SerialInput object.
    The SerialInput object allows serial input bytes to be passed to the
    VM without interrupting execution of a trace.
2020-03-03 TraceRecorder relies on MicrocodeGenerator to determine which instructions are conditional and unconditional jumps.
2020-03-03 Update the IPS label during execution of traces.
    The value is updated every one seconds on a timer. The VM and TraceExecutor
    will report the number of instructions retired to the stopwatch. The
    stopwatch will measure the elapsed time between calls to measure().
2020-03-03 The "step" button will always step a single instruction and no more.
2020-03-05 Remove provideMicrocode() and UI button for the same.
    Microcode is exclusively generated by MicrocodeGenerator now because so
    many pieces of the VM now rely on the generator to help make sense of the
    program.
2020-03-12 Cancel trace recording when the trace modifies instruction memory
2020-03-14 Assembler can link a program at a specified base address such as 0x8000.
    This functionality is not exposed in the command-line interface.
2020-03-14 Add a better test of trace recording abort due to modified memory.
    The new test shows how the recorded trace would literally be incorrect.
    Correct execution is only achieved by aborting recording and discarding
    the trace entirely.
2020-03-14 Support Rev1 and Rev2 hardware, switchable through user default.
    For example:
    % defaults write com.foxostro.Simulator ComputerType -string Rev2
    The Rev2 computer hardware simulates the changes to the link register but
    does not yet simulate the changes to the ALU.
    The Simulator app example program changes depending on the desired computer
    type too since there are slight differences.
2020-03-19 Memory class uses UnsafeMutableBufferPointer.
    The idea is to make it easier to pass the underlying buffer to a piece of
    C code or assembly code.
2020-04-19 InterpreterRev1Tests uses TraceUtils.assemble() now.
2020-04-20 Added support for hardware changes to the ALU in Rev 2.
    The ALU result and flags are delayed one clock in this model, and ALU ops
    take two clocks to complete. To facilitate this change, the assembly
    language syntax was updated to include "ADD _" which performs the addition
    but does not output the result to the bus.
2020-05-04 Added audio card schematic and PCB.
    The schematic is complete, but the PCB layout is incomplete.
    Though, it occurs to me that I have no way to control audio gain.
    [AudioCard.kicad_pcb, AudioCard.sch, Connector.sch]
2020-05-09 Add a test program for the audio device.
2020-05-10 Add a button to load a program from a source file.
2020-05-10 The serial interface is now device seven.
2020-05-10 Begin writing a class for an audio device.
2020-05-11 Tie the audio device peripheral to a tone generator class, currently a stub.
2020-05-11 Fix unit tests broken when I reassigned the serial card slot.
2020-05-13 Begin updating KiCAD schematic for sound card for the design involving AS3440.
    TODO: The audio jack footprint is probably incorrect.
    [AudioCard.kicad_pcb, AudioCard.sch, Connector.sch, DAC.sch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]
2020-05-14 Update the footprint for the 3.5mm jack.
    [SoundCard-B_Cu.gbr, SoundCard-B_Mask.gbr, SoundCard-B_Paste.gbr, SoundCard-B_SilkS.gbr, SoundCard-Edge_Cuts.gbr, SoundCard-F_Cu.gbr, SoundCard-F_Mask.gbr, SoundCard-F_Paste.gbr]
2020-05-14 Rework the Sound Card PCB to use four layers instead of six.
    One of the two inner copper layers is used for partially for the ground
    plane and partially for the analog ground plane. The other inner layer is
    used for VCC, +15V, and -15V, constructed of large copper fills over the
    relevant areas.
    [SoundCard-B_Cu.gbr, SoundCard-B_Mask.gbr, SoundCard-B_Paste.gbr, SoundCard-B_SilkS.gbr, SoundCard-Edge_Cuts.gbr, SoundCard-F_Cu.gbr, SoundCard-F_Mask.gbr, SoundCard-F_Paste.gbr]
2020-05-14 The sound card can now directly drive the speaker cone.
    To match real hardware, the sound card now has a register which allows the
    CPU to directly drive the speaker cone. Well-written programs can use this
    to synthesize abritrary waveforms.
    Note that the Simulator is too slow, and has too much jitter, to generate
    much more than noisy square waves.
2020-05-16 Fix thread sanitizer issue
    Fix thread sanitizer issue by having ConreteToneGenerator's frequency
    property act as a proxy for Oscillator.frequency without backing storage
    of its own.
2020-05-16 AssemblerError has a new init method which takes a line number and message without format
2020-05-16 Add assembler support for binary integer literals.
2020-05-17 The Simulator needs to emulate a hardware bug in Rev 2's Instruction RAM.
    The bits of the port of Instruction RAM which are wired to the data bus
    are connected in reverse order.
2020-05-17 Create a new TurtleCore framework.
    The TurtleCore framework will contain things on which the Simulator and
    the Assembler both depend. This is the beginning of an initiative to break
    up the TurtleTTL framework.
2020-05-17 Split compiler/assembler stuff into new framework TurtleAssemblerCore.
2020-05-17 Add TurtleSimulatorCore and remove TurtleTTL framework entirely.
2020-05-17 Fix retain cycle in AssemblerLexer.
2020-05-17 Fix bug where TurtleAssembler would fail on launch in release mode due to not being able to locate frameworks.
2020-05-17 Create new framework TurtleCompilerToolbox to hold compiler classes which can be shared.
    Eliminate the use of visitor pattern in the compiler. As we want to have
    the ability to visit nodes in two compilers, it becomes advantageous to
    take another approach to this problem.
2020-05-17 Create new framework SnapCore.
    As Xcode cannot unit test command line tool target, the Snap command line
    tool will drop into this framework as quickly as possible.
2020-05-18 The Snap compiler is a carbon copy of the Assembler for now.
    I'll start out with it being an exact copy of the assembly language and
    evolve it from there. This will happen without affecting the assembler
    or assembly language.
2020-05-18 Return statements accept an expression, not just a literal number.
    Though, currently, an expression is only a literal number.
2020-05-18 Put in some of the framework for compiling expressions.
    Compiling an expression will involve the same sort of visiting mechanism
    that is used for the AST nodes that make up a statement.
2020-05-19 The Snap compiler inserts code to initialize the stack.
2020-05-19 The code generator doesn't insert a NOP at the beginning of the program.
    This is something done in a program prologue inserted by the assembler
    and the Snap compiler.
2020-05-19 Fix typo which broke tests and add assembler tests to Snap scheme.
2020-05-19 Add GenericCompilerFrontEnd class
    This reduces the amount of tests needed in AssemblerFrontEnd and in
    SnapCompilerFrontEnd because the base class can handle almost all the work.
    This is especially good because the front end tests were very similar to
    the tests in the corresponding code generator classes.
2020-05-20 Strip a bunch of stuff from Snap which originated in the Assembler.
    My original goal of extending the assembler through the Snap compiler isn't
    really working. Just strip all of that out and the new compiler will start
    from scratch.
    As part of this, move token declarations and AST node declarations that are
    now once-again assembler-specific back into TurtleAssemblerCore.
2020-05-23 Restrict the source and destination registers allowable for BLT.
    The BLT instruction is intended to accelerate the performance of block memory copies between data RAM and device memory or instruction RAM. It asserts both the INUV and INXY control signals and also performs a bus transfer between a specified source and destination register. Restricting to only the P and M pseudo-registers would greatly reduce the number of required opcodes without much decreasing the utility of the instruction.
2020-05-26 Add ADC and SBC instructions to the assembler.
    Also, added a new micro-instruction to ALUxC which performs an ALU op
    where the 74181's carry input is set to follow the CPU carry flag.
2020-05-29 Rework the symbol table to allow multiple types.
    Currently, the only two types are constant addresses and constant words of
    values known at compile time.
2020-05-31 Undo consolidation of Snap and Assembler front end under common base class.
    I need to introduce an intermediate language to the Snap compiler and the
    GenericCompilerFrontEnd base class is too constraining. Undo the
    consolidation so AssemblerFrontEnd and SnapCompilerFrontEnd can vary
    independently.
2020-05-31 Move Symbol and IR stuff out of TurtleCompilerToolbox.
    None of this is relevant to the assembler and is constantly being disabled
    there. Attempting to reuse the code between the two compilers is not
    working out.
2020-06-04 The assembler output is prettier now.
2020-06-10 IR uses both a control stack and an expression stack.
    The expression stack is used to compute expressions in a statement and is
    transient. It can be cleared after every statement. The stack size is
    limited to 257 bytes, and this limit can be enforced at compile time.
    The control stack grows down from the top of memory, just below the
    expression stack. This will be used for stack frames, local variables,
    return values, return addresses, &c.
2020-06-11 Local variables are allocated on the stack.
    The symbol address is specified as an offset from the frame pointer so
    accesses to these symbols requires a bit of math.
2020-06-13 Local variables must start with an offset of 3 to avoid colliding with the saved frame pointer.
2020-06-13 Bump the stack pointer at the site of a local variable declaration.
    This ensures space is reserved in the stack frame for that local var.
    TODO: Currently, the pointer arithmetic is 8-bit only and will not work
    when the stack pointer crosses the 256 byte boundary.
2020-06-14 Entering any block introduces a new stack frame.
    In order to resolve variables in parent and ancestor stack frames,
    references to such symbols generates code to chase the frame pointer up
    the call stack. This is inefficient, but will be necessary for nested
    functions. I'll revisit this later.
2020-06-23 Entering a scope is not the same thing as entering a stack frame.
    Resolving the address of a stack local variable requires following the
    frame pointer a number of times related to the number of stack frames, not
    the number of enclosing scopes. So, the compiler needs to track both.
2020-06-25 Handle case where function names are not unique.
    Since functions may be declared in an inner scope, it is possible to
    define two different functions with the same name. Mangle the name of the
    underlying label to make it unique across the entire program.
2020-06-25 Fix bug where variables were stored to the stack unexpectedly.
    The expected behavior is that all variables declared in stack frame zero
    are to be allocated statically. However, there was code which assumed,
    incorrectly, that each block was associated with a new stack frame.
2020-06-25 Fix bug where block storage pointer was being reset incorrectly.
    The storage pointer should only be reset when entering a new stack frame.
    Otherwise, continue to allocate within the current enclosing stack frame.
2020-07-09 Add tests for a couple of recursive functions with u8 and u16 parameters
    These were failing before the recent bug fixes to 16-bit instructions.
    Commit these tests to the test suite to prevent future regressions.
2020-07-09 Fix bug in symbol offsets for function parameters.
    Function parameters need to be defined a being in the stack frame of the
    function, but with a negative offset from the frame pointer.
    There's no need for two nested scopes in a function.
2020-07-11 Refactor: use pattern matching switch in ExpressionSubCompiler
2020-07-11 Refactor: use pattern matching switch in ExpressionTypeChecker
2020-07-11 Refactor: use pattern matching switch in SnapToYertleCompiler
2020-07-11 Refactor: use pattern matching switch in StatementTracer.
2020-07-12 Sound card: revise circuit schematic to include second oscillator, VCA
    The AS3360 VCA is a more effective and compact amplifier than the JFET
    based design in the previous revision.
    [Connector.sch, DAC.sch, SoundCard.sch, VCA.sch, VCA2.sch, VCO-Pulse.sch, VCO-Triangle.sch, VCO.sch]
2020-07-12 Sound card: Start assigning SMD footprints to schematic components.
    [DAC.sch, SoundCard.sch, VCA.sch, VCA2.sch, VCO-Pulse.sch, VCO-Triangle.sch]
2020-07-14 Sound card: add the Electric Druid Noise 1B digital sound generator.
    The gain on the noise voice is controlled by one of the AS3360 units.
    The master gain control is removed in order to make this possible.
    [Connector.sch, DAC.sch, SoundCard.sch, VCA.sch, VCA2.sch, VCO-Pulse.sch, VCO-Triangle.sch]
2020-07-17 Sound Card: Finish routing SMD PCB for rev 2
    [DAC.sch, SoundCard.kicad_pcb, SoundCard.sch, VCA.sch, VCA2.sch, VCO-Pulse.sch, VCO-Triangle.sch]
2020-07-19 Sound Card: Add Gerber file plots
    [SoundCard-B_Cu.gbr, SoundCard-B_Mask.gbr, SoundCard-B_Paste.gbr, SoundCard-B_SilkS.gbr, SoundCard-Edge_Cuts.gbr, SoundCard-F_Cu.gbr, SoundCard-F_Mask.gbr, SoundCard-F_Paste.gbr]
2020-07-19 Sound Card: Add PDF with PCB layout
2020-07-19 Sound Card: Add PDF of schematics
2020-07-26 Fix bug where for-loop was mistakenly using scope-depth instead of the relative stack-frame-depth in local variable lookup.
2020-07-26 Add a unit test for Snap which prints "Hello, World!" to the serial interface.
2020-07-30 Added a panic() function to the standard library.
    Though this currently isn't able to get the string length and print the
    message properly.
2020-08-01 The compiler prints out the offending line and highlights the error.
2020-08-02 Fixed and dynamic arrays now have a "count" property for the length.
    Added "Get" properties which can get a property on a value. Currently, the
    only implemented property is the "count" property for fixed arrays and
    dynamic arrays.
    The compiler instrinsic function "length" has been removed.
    The standard library (such as it is) now uses the string "count" instead of
    calling the "length" function.
2020-08-03 Array OOB messages print the line and offending expression.
2020-08-08 The VM verbose logger displays the current line of code in the console.
    The VM can map from a program counter value back to the corresponding piece
    of Snap source code. This is currently used by the verbose logger to
    display the currently executing source line for each CPU step.
2020-08-25 Change the message that prints when the Snap hello world program prints out the total running time (in cycles) of the program.
2020-08-25 Verbose logging of CPU state will always print certain registers now, even if they haven't changed.
2020-08-26 Fix some rvalue expression tests involving array types.
    Fix the following tests:
    * testCompileIdentifierExpression_ArrayOfU16_Static
    * testCompileIdentifierExpression_ArrayOfU16_Stack
    * testCompileIdentifierExpression_DynamicArrayOfU16_Static
    Compiler temporaries are allocated from the scratch memory region using an
    allocator a little more advanced than the simple preallocation of sixteen-
    bit slots. This allocator permits temporaries to be allocated for slices
    and fixed-size arrays which are larger than two bytes.
2020-08-26 Fix unit tests for getting array count.
    * testGetLengthOfLiteralArray
    * testGetLengthOfArrayThroughIdentifier
    * testGetLengthOfDynamicArray
    When getting the count of an array, first evaluate the array expression
    and allow the result to be written to a temporary. (This is necesary in
    case evaluation has side effects.) Then, for fixed-size arrays, emit code
    to copy the array count to a new temporary. For dynamic arrats, emit code
    to extract the array count and copy that to a new temporary.
    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
2020-08-31 Fix unit test test_EndToEndIntegration_AccessVariableInFunction_U16
    The function which emits code to compute a local variable address needed
    to be able to handle the case where offset<0. Also, the code emitted to
    save/restore temporaries around a function call was incorrect.
2020-09-02 (Re-)Implement support for stack local variables with a non-zero stack frame depth.
2020-09-02 Add new test testUnexpectedNonVoidReturnValueInVoidFunction to SnapToCrackleCompilerTests
    This tests the case where a function returns a value when it should not.
2020-09-02 Add a test for when a void function's body ends in a return statement.
    This is basically only there for code coverage of the function tracer.
2020-09-02 For debugging, always print IF/ID in CPU state snapshots.
2020-09-04 Sound Card: revision 3 fixes the footprint on the two MAX505s
    [DAC.sch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]
2020-09-04 Sound Card: move the label with the revision number.
    [SoundCard-B_Cu.gbr, SoundCard-B_Mask.gbr, SoundCard-B_Paste.gbr, SoundCard-B_SilkS.gbr, SoundCard-Edge_Cuts.gbr, SoundCard-F_Cu.gbr, SoundCard-F_Mask.gbr, SoundCard-F_Paste.gbr]
2020-09-04 Main Board: Fix the reset LED by buffering with an inverter.
    [Clock.sch]
2020-09-05 Main Board: Fix the reset sequence
    The register clock does not go inactive during the reset sequence.
    The ‘157 should select either GND or the raw register clock based on the
    state of the /RST signal. So, unconnect pin 5 of U52 and connect to GND.
    [Clock.sch]
2020-09-14 Added a pointer type
    * Define a pointer type like so: *u8 or *Foo
    * Dereference a pointer like so: foo.pointee
    BUG: Pointers introduce a hole in the mutability rules for variables.
2020-09-15 Plug the hole in the type system relating to pointers and mutability.
    Do not introduce a `const' keyword as this introduces a lot of complexity
    into the language and type system. Instead, mutable pointers are able to
    mutate the pointee, and immutable pointers are not able. While this lacks
    some of the expressiveness afforded by adding `const' versions of types,
    it is much simpler.
2020-09-21 Fix bug where chained Get expressions did not work when combined with struct member function call syntax.
2020-09-21 Fix bug introduced by recent changes to parsing of if-else.
    If the else clause was immediately followed by a newline and EOF then it
    parsed to an empty block. I’d rather it throw an error in this case.
2020-09-24 Stop using exceptions for flow control in type checker.
    Add new method convertBetweenTypes() which returns either the type which is
    the result of the conversion, or an error describing why the conversion is
    unacceptable. Some callers of this function may choose to throw the error.
2020-09-25 Rewrite AST pretty printing code so the AST is more readable.
2020-09-26 Add the beginning of a module system. Use it to import stdlib.
    Currently, the first time a module is imported, the compiler will load the
    module source code from file, parse it, and cache resulting AST. This AST
    is injected into the program at the site of the import statement.
    This is super crude, and only a little bit better than textual inclusion.
    However, it allows me to start iterating on the module system and syntax.
2020-09-26 Declarations may be marked public/private and this affects how they are exported from the module.
    Currently, there is no syntax for this. It can only be done on the AST.
2020-10-11 Serial input can be line-oriented or character-oriented.
    A checkbox can switch between line-oriented and character-oriented mode.
    The character-oriented mode passes each keypress to the VM individually
    while the line-oriented mode passes an entire line of input at once.
2020-10-15 The function type is printed differently with a "func" in the string.
2020-10-16 The parser can now parse an expression which applies a subscript to the result of a chain of gets.
2020-10-16 Fix bug which broke code that tried to get a dynamic array from a struct and subscript it.
    The compiler no longer assumes the subscriptable expression is a simple
    Identifier. In the case of a Get expression, this isn't true anyway.
2020-10-18 Add syntax for a trait declaration. Currently does nothing.
2020-10-22 Fix bug where range in subcript causes unsupported expression error.
    This involves rolling back changes in 5b03f71d26d9928d5dfe6f127eb8fc11bfb29513.
    As a consequence, it is impossible again to return a struct that is too
    large to fit into a compiler temporary.
    The bug was that the byte copy that was being used to avoid the creation
    of that compiler temporary needed to get the lvalue of the expression on
    the right-hand side. However, that right-hand expression has no lvalue
    when it is a StructInitializer as is the case for a Range.
2020-10-23 Add an easy switch for toggling bounds checking for debugging the compiler.
2020-10-23 The compiler prints source context alongside IR instruction listings.
2020-10-24 Assembly instruction listing now includes source context.
2020-10-24 Assembly listings now include the source file name and line number for each line of source code.
2020-10-26 The compiler command line tool will compile and run each test separately
    This helps keep each test case small enough to fit into memory. Also,
    test cases are now always independent of one another.
2020-10-28 Fix bug where escaping strings was done incorrectly while printing instruction.
2020-10-30 Assembly listings include the source file and line.
2020-10-31 Optimize compiled programs by propagating constants in assembly code.
    Immediate values which are loaded into registers and memory can be tracked
    across a basic block. We can skip instructions which would have no effect
    such as LI X, Something when we already know that X contains Something.
    Similar tracking can be done for the contents of RAM.
    Instructions can be rewritten from MOV to LI when we can statically
    determine the value that will be assigned. The benefits of this change will
    be apparent once dead store elimination has been implemented.
2020-10-31 Eliminate dead stores in assembly code.
    Stores of values (to registers) which are then never used can be removed
    with no change in visible program behavior, except to make it smaller and
    faster.
2020-11-01 Adjust compiler threshold for COPY-IS and COPY-ID optimization.
    Adjust the threshold at which the compiler switches the implementation of
    COPY-IS and COPY-ID instructions. The looping implementation is shorter
    than the inline implementation at n=4.
2020-11-02 Add comments to mark a couple of nasty hacks.
2020-11-02 Make sure to attach debug info to the generated procedures.
2020-11-09 Add PLD files for the GALs which will handle the VGA device counter logic.
    The VGA output device has a counter for the pixels in a scanline and a
    counter for each line. Different values of the counter trigger the begin
    and end of the visible area, sync pulses, and the porches. The GALs have
    logic for turning the counter value into control signals.
