foxostro/TurtleTTL/(notices)

Notices in the files:
Schematics/Version2/SerialCard/SerialCard.kicad_pcb:
Serial Card © 2019 Andrew Fox, Rev 4
Schematics/Version2/SoundCard/SoundCard.kicad_pcb:
© 2020 Andrew Fox
Schematics/MainBoard/MainBoard.kicad_pcb:
TurtleTTL © 2019 Andrew Fox, Rev 1
Schematics/Version1/experimental/SharedMemoryArduinoSerialCard/ArduinoSerialCard.kicad_pcb:
© 2019 Andrew Fox, Rev 2
Schematics/Version1/ArduinoSerialCard/ArduinoSerialCard.kicad_pcb:
© 2019 Andrew Fox, Rev 3
Schematics/Misc/ExternalClock/ExternalClock.kicad_pcb:
TurtleTTL: External Clock © 2019 Andrew Fox, Rev 1
